WHdragon770/mulbot-corexy/corexy100/entrega/01 Montagem 3D/heroi2.png

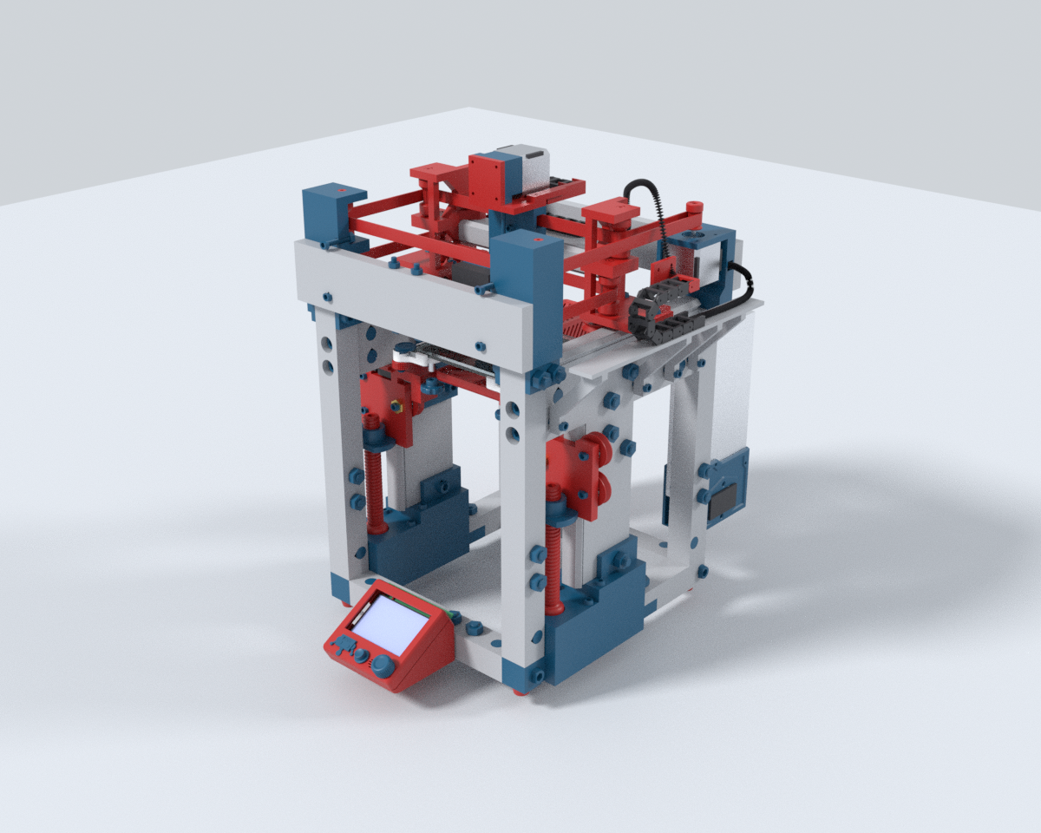
corexy100/entrega/01 Montagem 3D/heroi2.png
