WHdragon770/mulbot-corexy/corexy100/entrega/01 Montagem 3D/carro_rodas.png

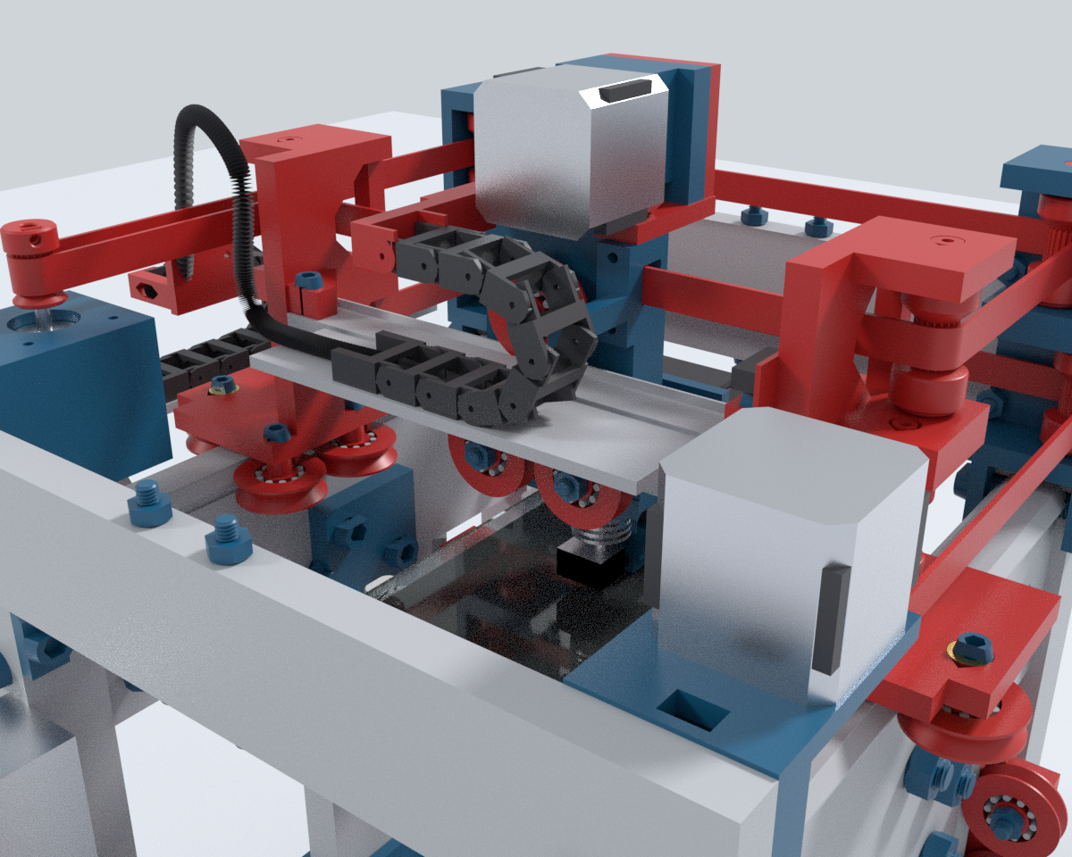
corexy100/entrega/01 Montagem 3D/carro_rodas.png
