WHdragon770/mulbot-corexy/corexy100/entrega/04 Detalhes (imagens)/100 x 200 lado a lado/1 perspectiva.png

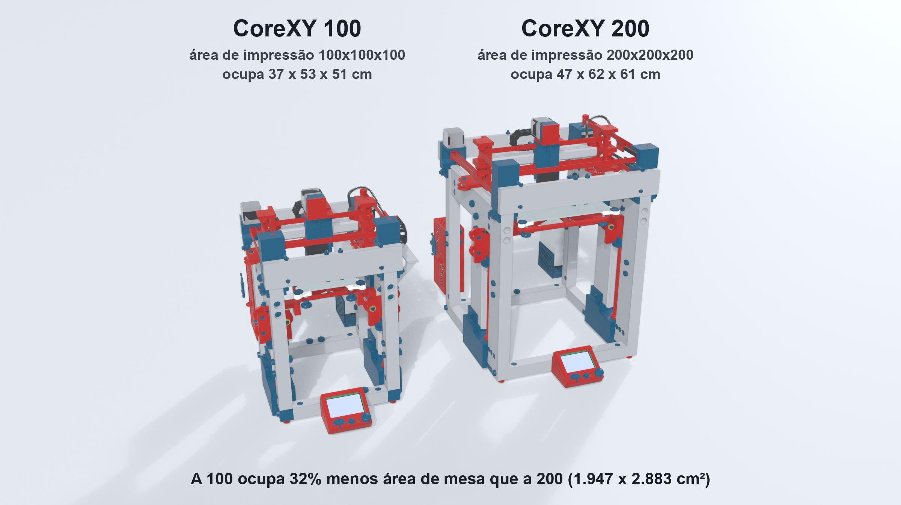
corexy100/entrega/04 Detalhes (imagens)/100 x 200 lado a lado/1 perspectiva.png
