WHdragon770/mulbot-corexy/corexy100/entrega/04 Detalhes (imagens)/Esteira porta-cabos/elo_por_cima.png

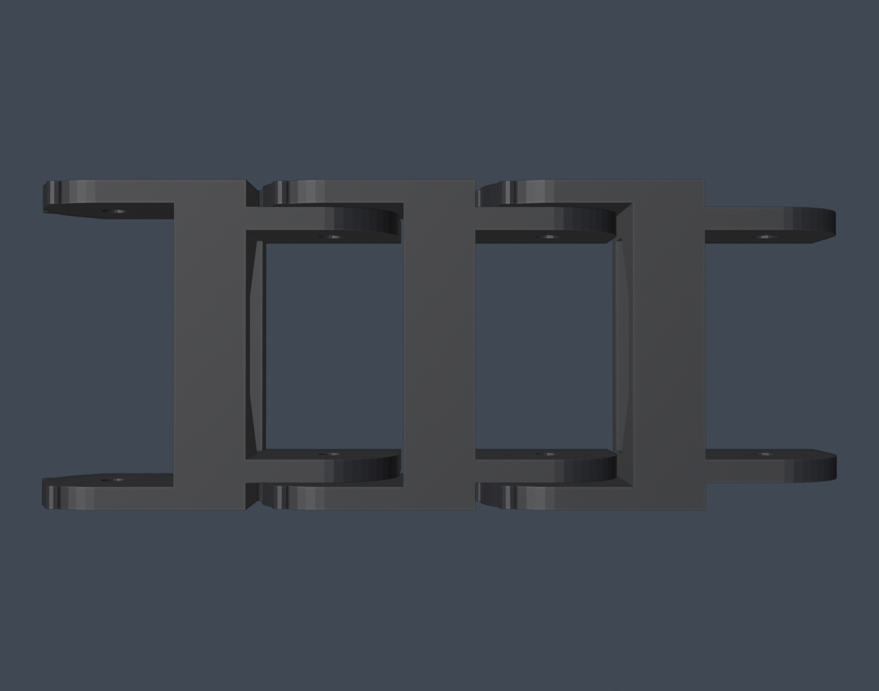
corexy100/entrega/04 Detalhes (imagens)/Esteira porta-cabos/elo_por_cima.png
