WHdragon770/mulbot-corexy/corexy100/entrega/04 Detalhes (imagens)/Esteira porta-cabos/esteira_X_de_cima.png

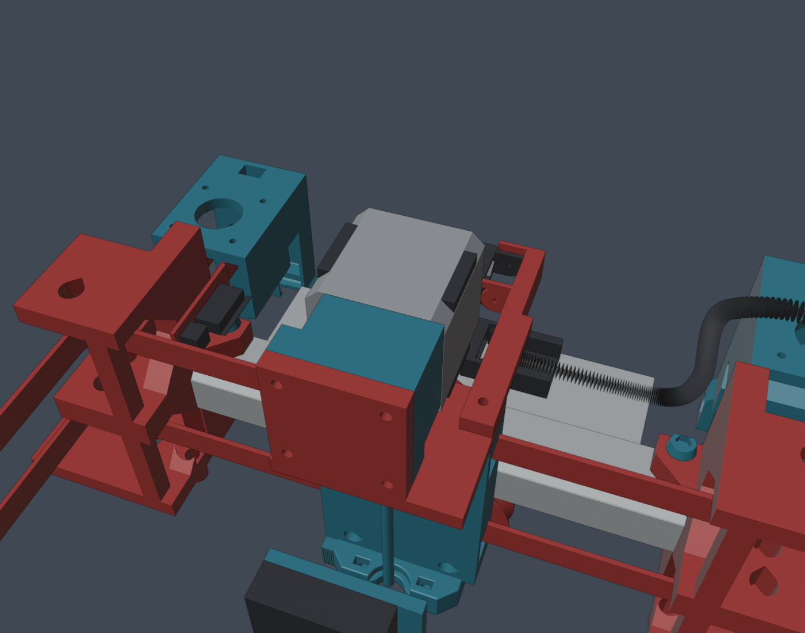
corexy100/entrega/04 Detalhes (imagens)/Esteira porta-cabos/esteira_X_de_cima.png
