WHdragon770/mulbot-corexy/corexy100/entrega/04 Detalhes (imagens)/Esteira porta-cabos/esteira_X_por_tras.png

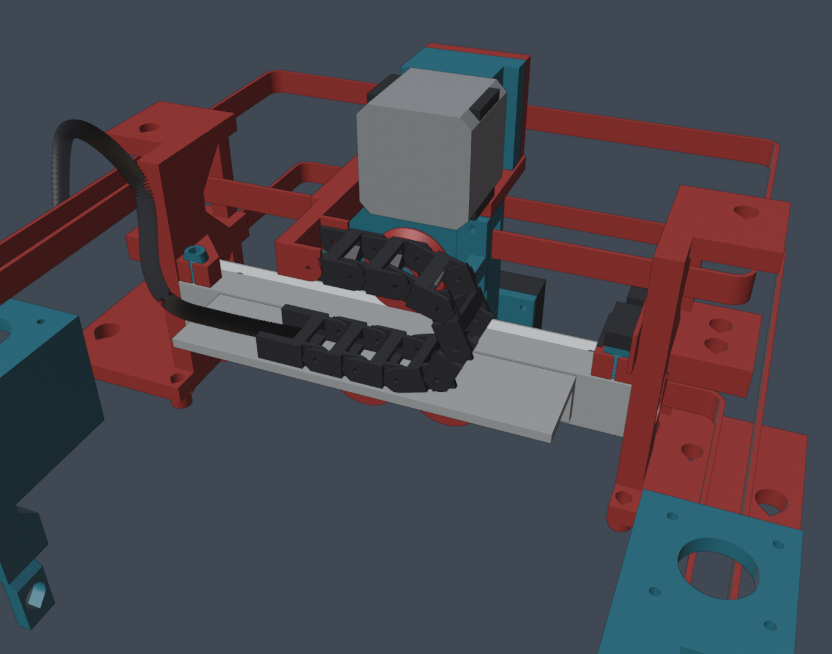
corexy100/entrega/04 Detalhes (imagens)/Esteira porta-cabos/esteira_X_por_tras.png
