WHdragon770/mulbot-corexy/corexy100/entrega/04 Detalhes (imagens)/Esteira porta-cabos/esteira_Y_por_fora.png

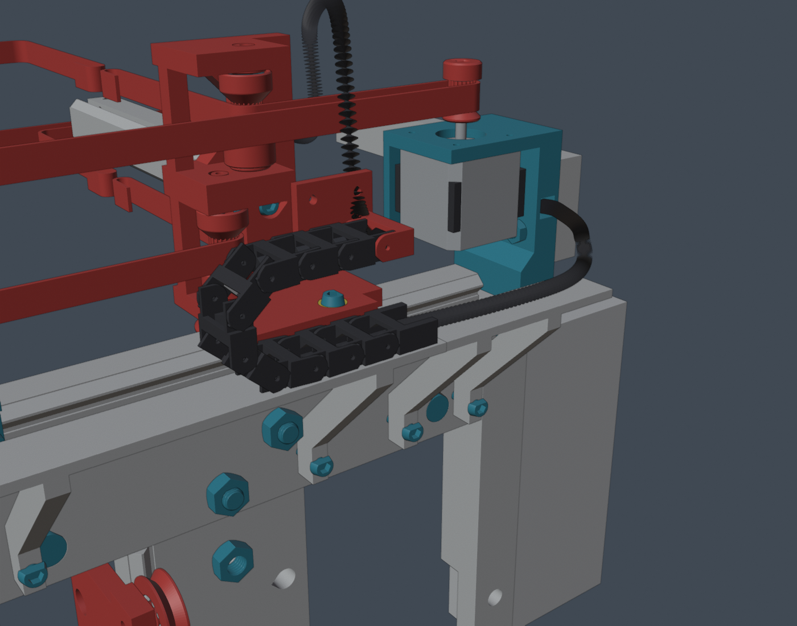
corexy100/entrega/04 Detalhes (imagens)/Esteira porta-cabos/esteira_Y_por_fora.png
