WHdragon770/mulbot-corexy/corexy100/entrega/04 Detalhes (imagens)/Esteira porta-cabos/visao_geral.png

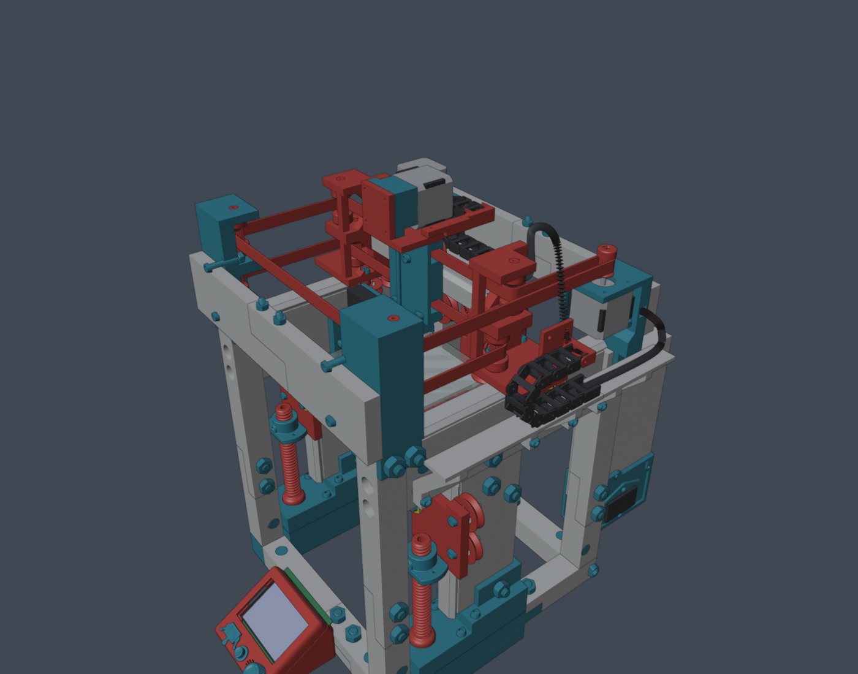
corexy100/entrega/04 Detalhes (imagens)/Esteira porta-cabos/visao_geral.png
