WHdragon770/mulbot-corexy/corexy100/entrega/04 Detalhes (imagens)/Extrusora direta/extrusora_direta_frente.png

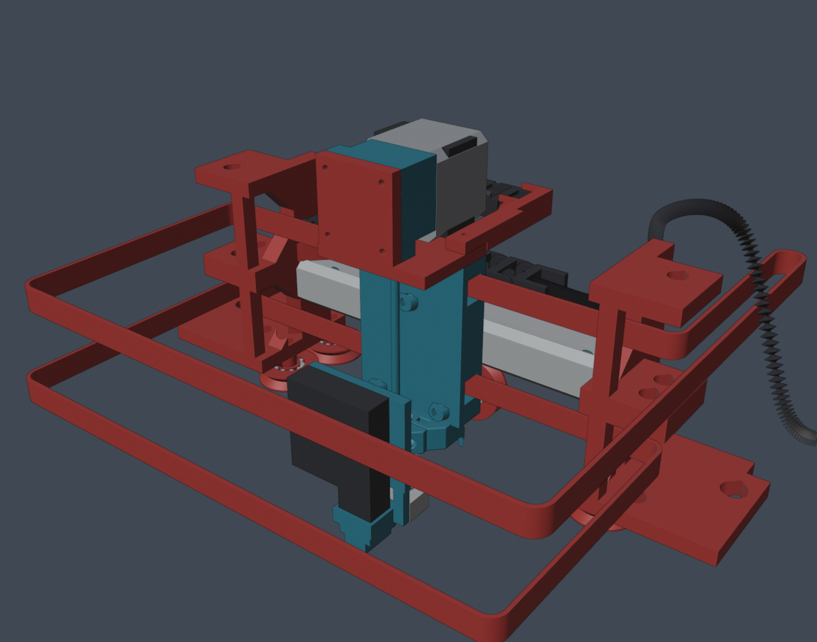
corexy100/entrega/04 Detalhes (imagens)/Extrusora direta/extrusora_direta_frente.png
