WHdragon770/mulbot-corexy/corexy100/entrega/04 Detalhes (imagens)/Extrusora direta/extrusora_direta_tras.png

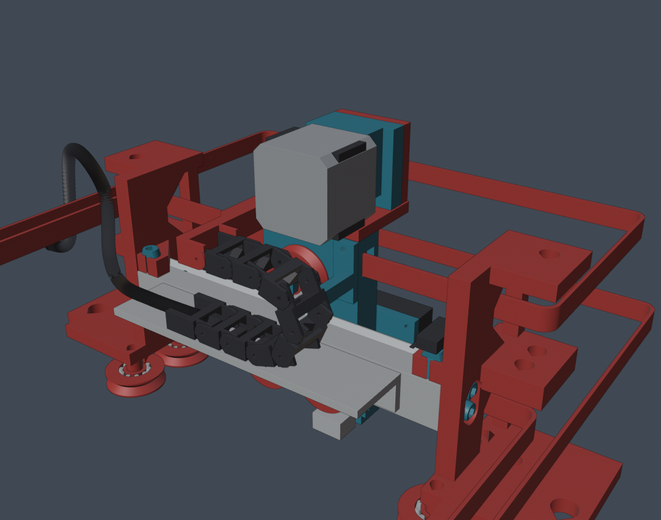
corexy100/entrega/04 Detalhes (imagens)/Extrusora direta/extrusora_direta_tras.png
