WHdragon770/mulbot-corexy/corexy100/entrega/04 Detalhes (imagens)/Passagem de cabos/canto.png

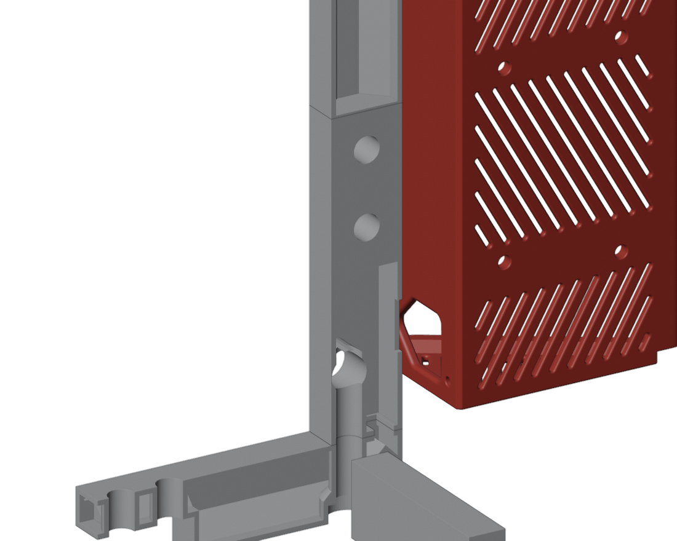
corexy100/entrega/04 Detalhes (imagens)/Passagem de cabos/canto.png
