WHdragon770/mulbot-corexy/corexy100/entrega/04 Detalhes (imagens)/Passagem de cabos/isoE.png

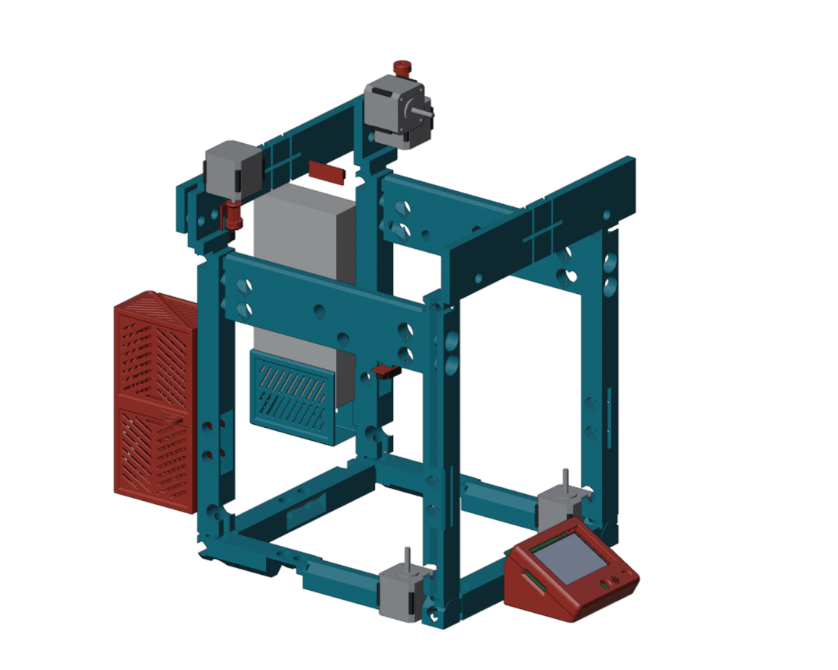
corexy100/entrega/04 Detalhes (imagens)/Passagem de cabos/isoE.png
