WHdragon770/mulbot-corexy/corexy100/entrega/04 Detalhes (imagens)/Presilha do vidro (botao excentrico)/iso.png

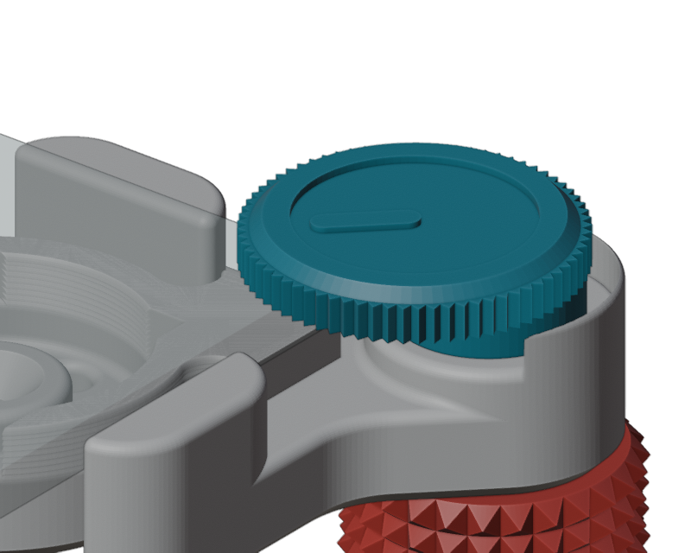
corexy100/entrega/04 Detalhes (imagens)/Presilha do vidro (botao excentrico)/iso.png
