WHdragon770/mulbot-corexy/corexy100/entrega/04 Detalhes (imagens)/Presilha do vidro (botao excentrico)/lado.png

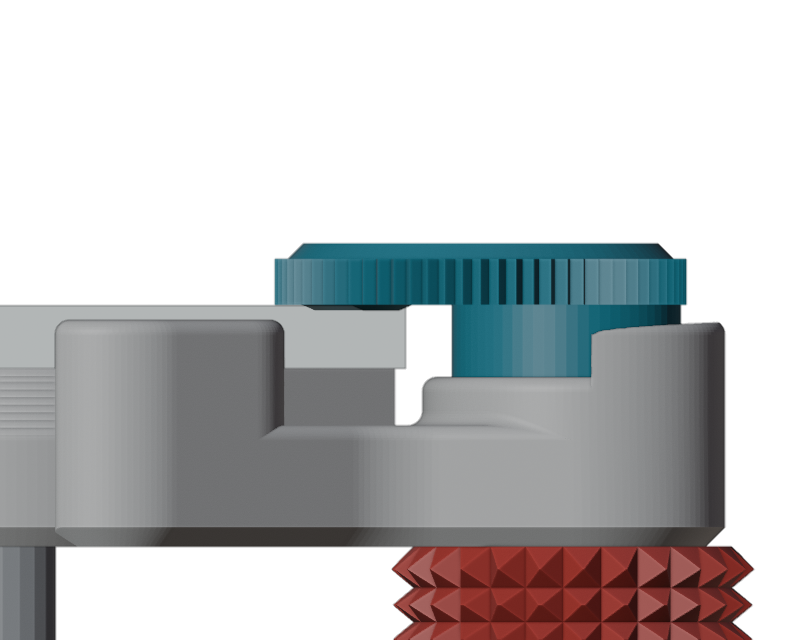
corexy100/entrega/04 Detalhes (imagens)/Presilha do vidro (botao excentrico)/lado.png
