WHdragon770/mulbot-corexy/corexy100/entrega/06 Placas de impressao/Previa das placas/01 Quadro - DL1-01-08 - TPU.png

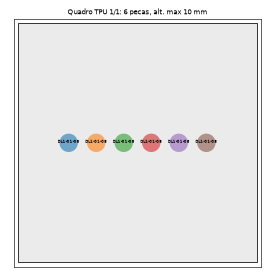
corexy100/entrega/06 Placas de impressao/Previa das placas/01 Quadro - DL1-01-08 - TPU.png
