WHdragon770/mulbot-corexy/corexy100/entrega/06 Placas de impressao/Previa das placas/01 Quadro - PLA.png

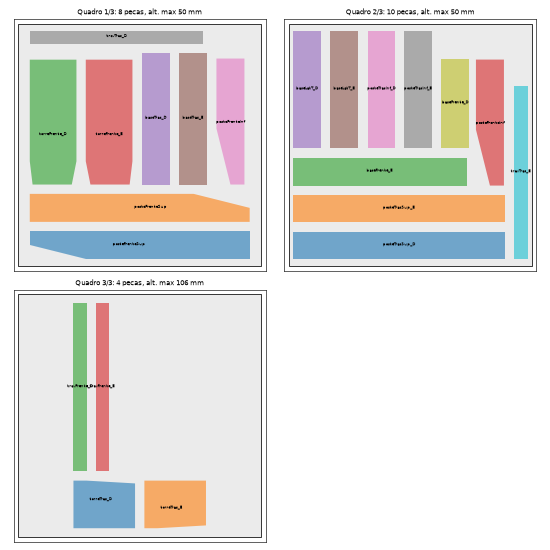
corexy100/entrega/06 Placas de impressao/Previa das placas/01 Quadro - PLA.png
