WHdragon770/mulbot-corexy/corexy100/entrega/06 Placas de impressao/Previa das placas/02 Eixo Y e portico - PLA.png

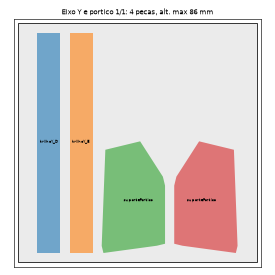
corexy100/entrega/06 Placas de impressao/Previa das placas/02 Eixo Y e portico - PLA.png
