WHdragon770/mulbot-corexy/corexy100/entrega/06 Placas de impressao/Previa das placas/03 Eixo X e cabeca - PLA.png

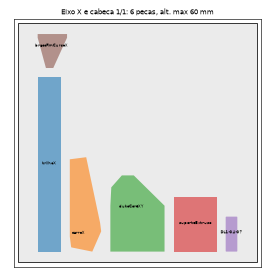
corexy100/entrega/06 Placas de impressao/Previa das placas/03 Eixo X e cabeca - PLA.png
