WHdragon770/mulbot-corexy/corexy100/entrega/06 Placas de impressao/Previa das placas/04 Eixo Z e mesa - PLA.png

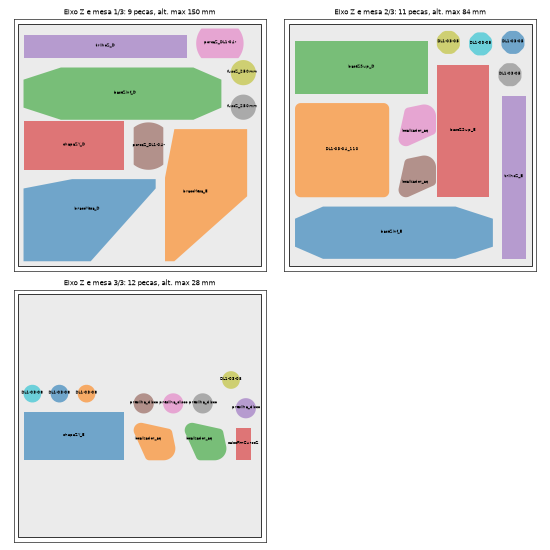
corexy100/entrega/06 Placas de impressao/Previa das placas/04 Eixo Z e mesa - PLA.png
