WHdragon770/mulbot-corexy/corexy100/entrega/06 Placas de impressao/Previa das placas/05 Motores e polias - DL1-04-08 - PETG.png

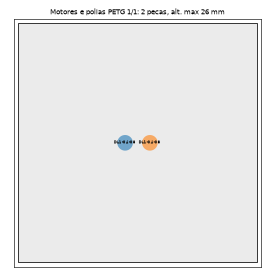
corexy100/entrega/06 Placas de impressao/Previa das placas/05 Motores e polias - DL1-04-08 - PETG.png
