WHdragon770/mulbot-corexy/corexy100/entrega/06 Placas de impressao/Previa das placas/06 Eletronica e display - PLA.png

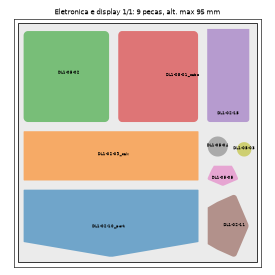
corexy100/entrega/06 Placas de impressao/Previa das placas/06 Eletronica e display - PLA.png
