WHdragon770/mulbot-corexy/corexy100/entrega/06 Placas de impressao/Previa das placas/08 Parafusos e porcas impressos - PLA.png

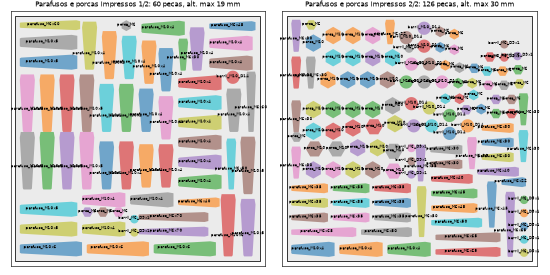
corexy100/entrega/06 Placas de impressao/Previa das placas/08 Parafusos e porcas impressos - PLA.png
