WHdragon770/mulbot-corexy/corexy100/entrega/06 Placas de impressao/Previa das placas/09 Esteira porta-cabos - elo_esteira - PETG.png

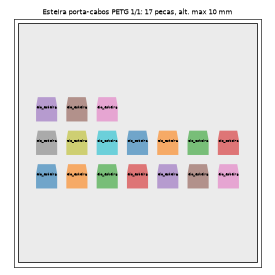
corexy100/entrega/06 Placas de impressao/Previa das placas/09 Esteira porta-cabos - elo_esteira - PETG.png
