WHdragon770/mulbot-corexy/corexy100/guia_v/render/1_montado.png

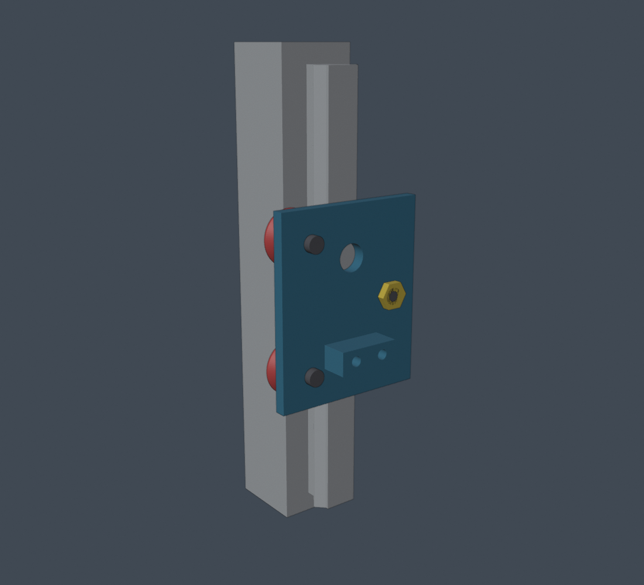
corexy100/guia_v/render/1_montado.png
