WHdragon770/mulbot-corexy/corexy100/guia_v/render/2_atras.png

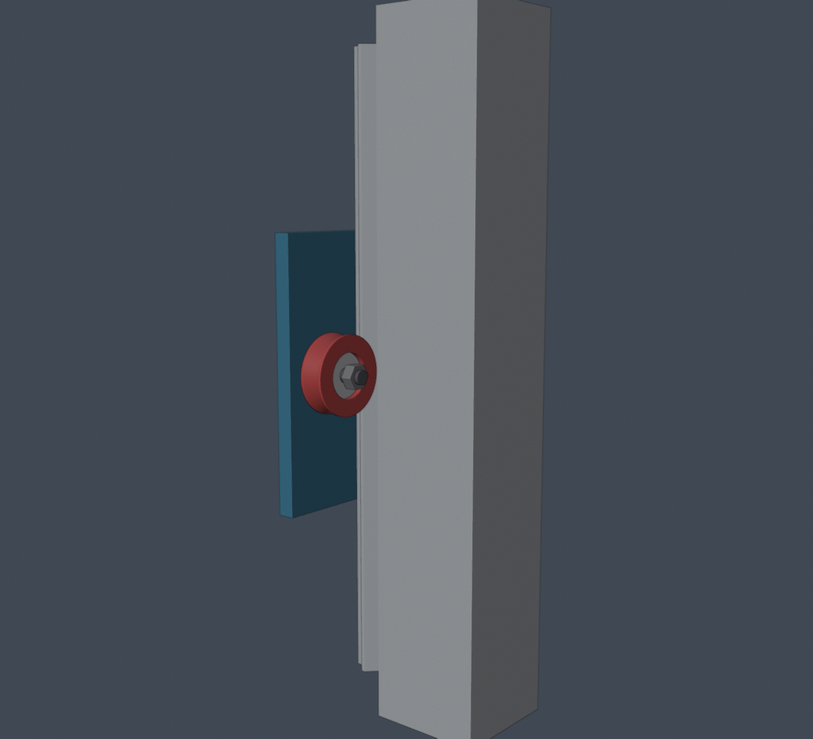
corexy100/guia_v/render/2_atras.png
