WHdragon770/mulbot-corexy/corexy100/guia_v/render/3_explodido.png

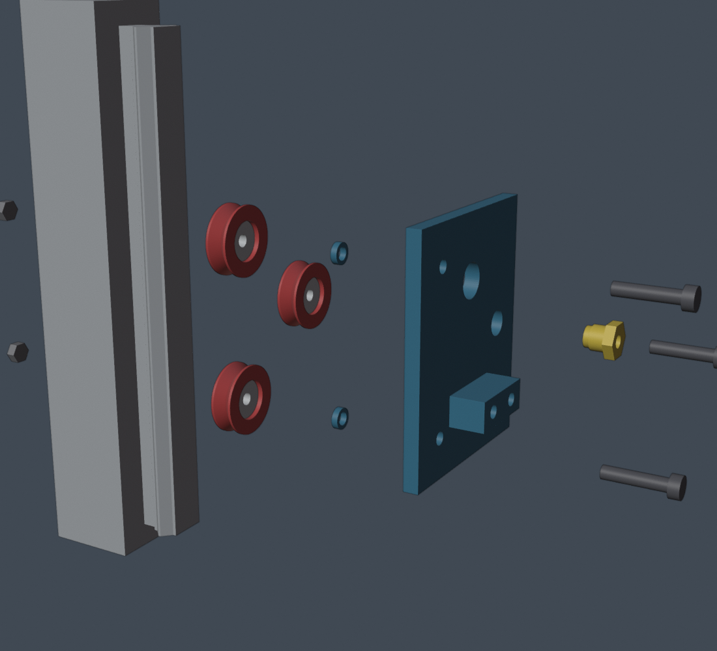
corexy100/guia_v/render/3_explodido.png
