WHdragon770/mulbot-corexy/corexy100/guia_v/render/4_corte_topo.png

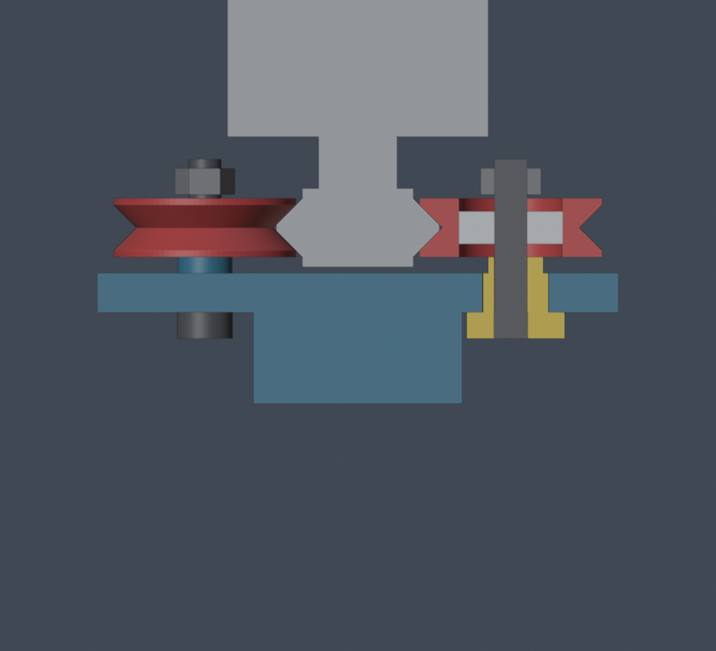
corexy100/guia_v/render/4_corte_topo.png
