WHdragon770/mulbot-corexy/corexy100/guia_v/render/5_sem_placa.png

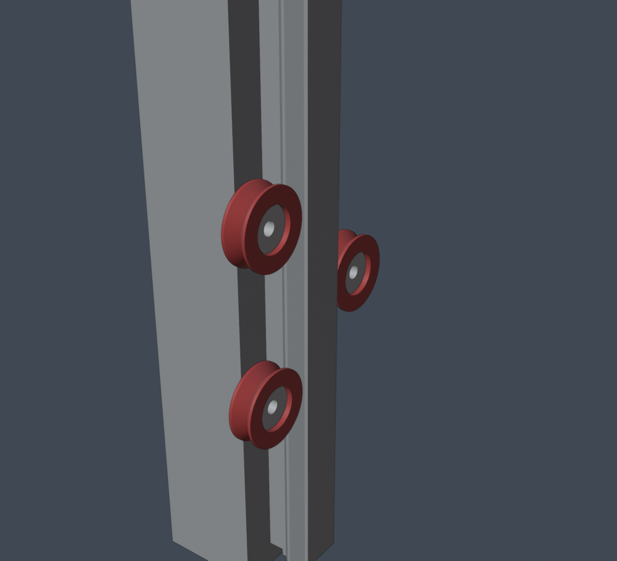
corexy100/guia_v/render/5_sem_placa.png
