WHdragon770/mulbot-corexy/corexy100/guia_v/render/guia_v_painel_pequeno.png

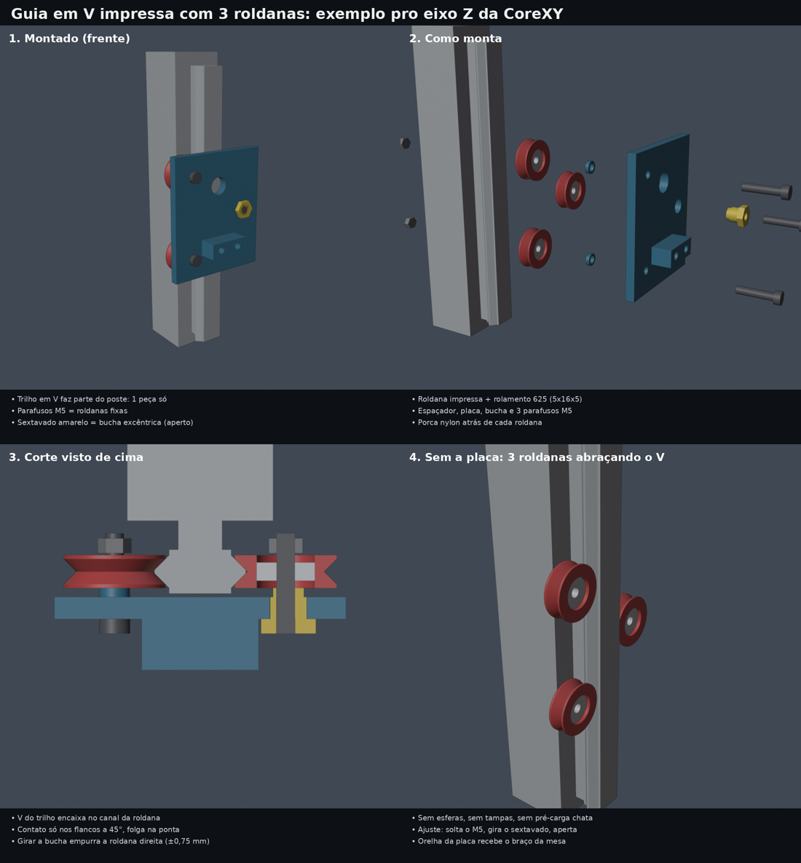
corexy100/guia_v/render/guia_v_painel_pequeno.png
