WHdragon770/mulbot-corexy/corexy100/ref/carro_frente.png

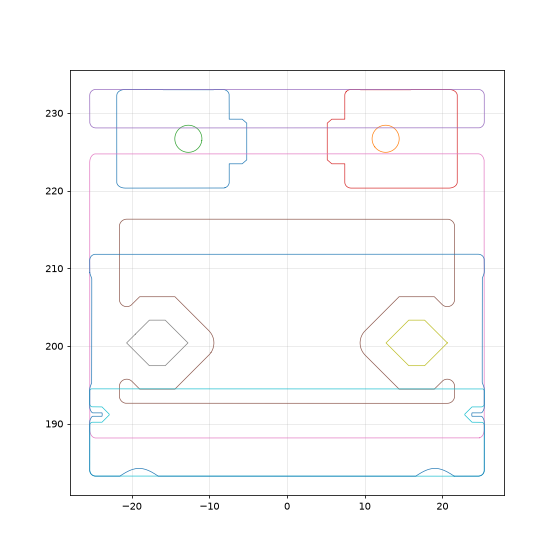
corexy100/ref/carro_frente.png
