WHdragon770/mulbot-corexy/corexy100/ref/carro_topo.png

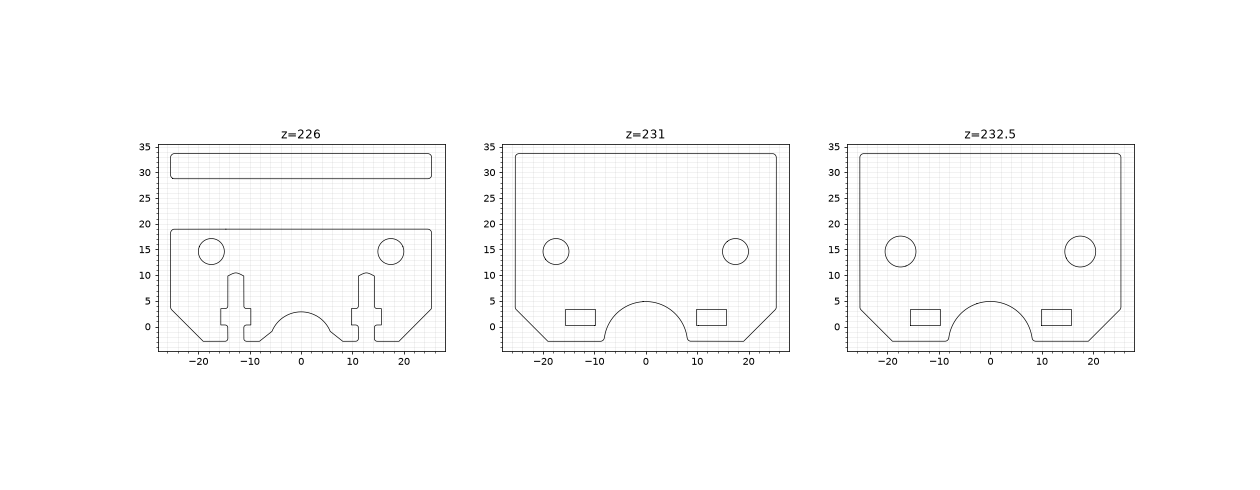
corexy100/ref/carro_topo.png
