WHdragon770/mulbot-corexy/corexy100/ref/chave.png

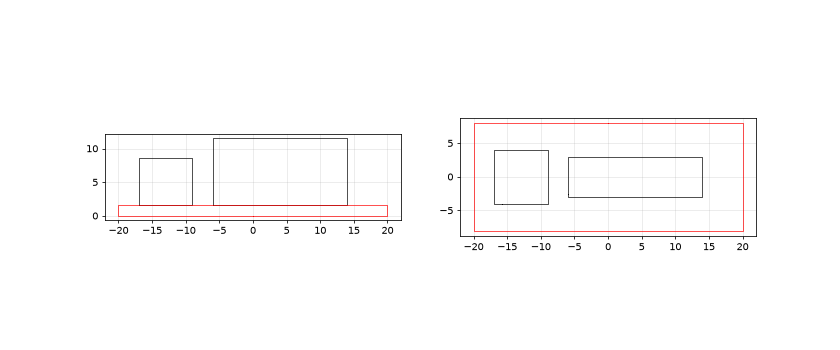
corexy100/ref/chave.png
