WHdragon770/mulbot-corexy/corexy100/ref/fan.png

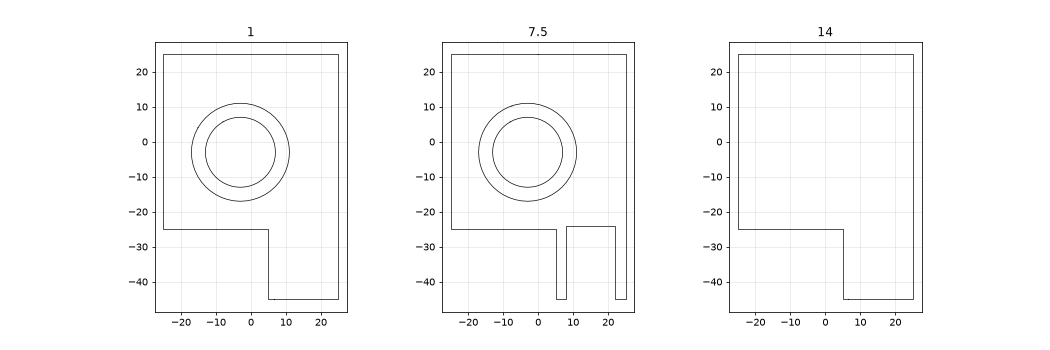
corexy100/ref/fan.png
