WHdragon770/mulbot-corexy/corexy100/ref/perfis.png

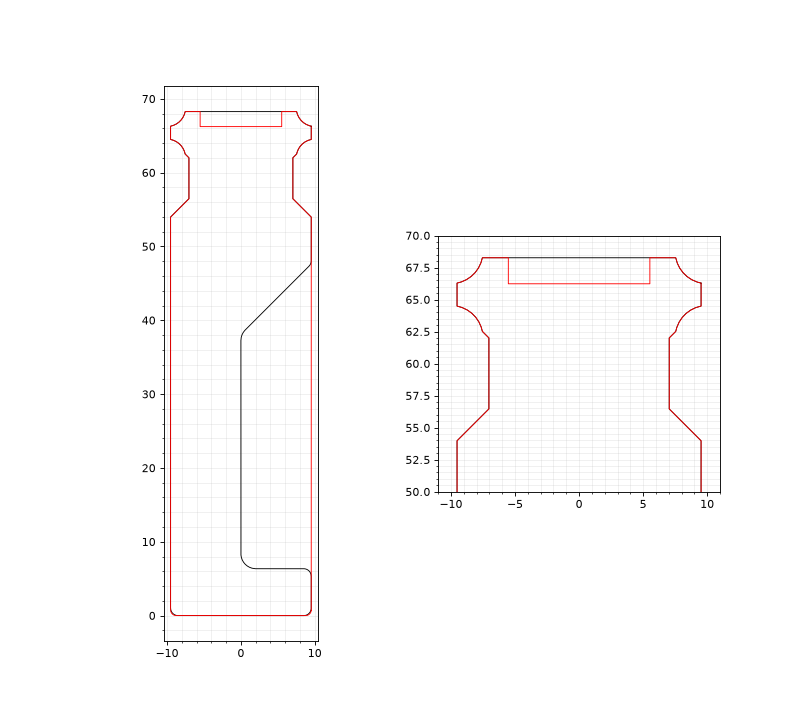
corexy100/ref/perfis.png
