WHdragon770/mulbot-corexy/corexy100/ref/polias.png

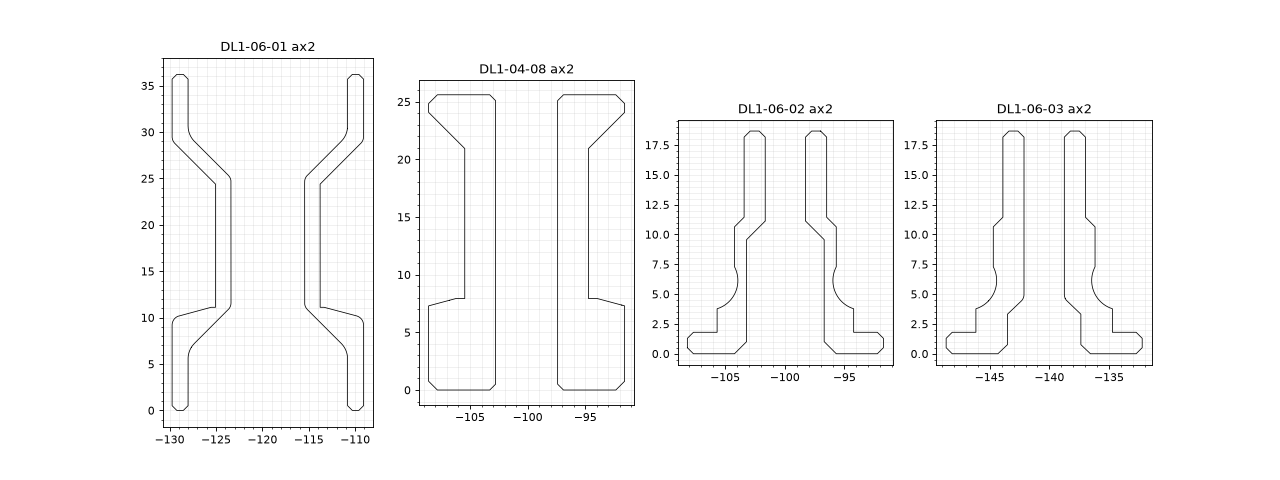
corexy100/ref/polias.png
