WHdragon770/mulbot-corexy/corexy100/ref/rail_sec.png

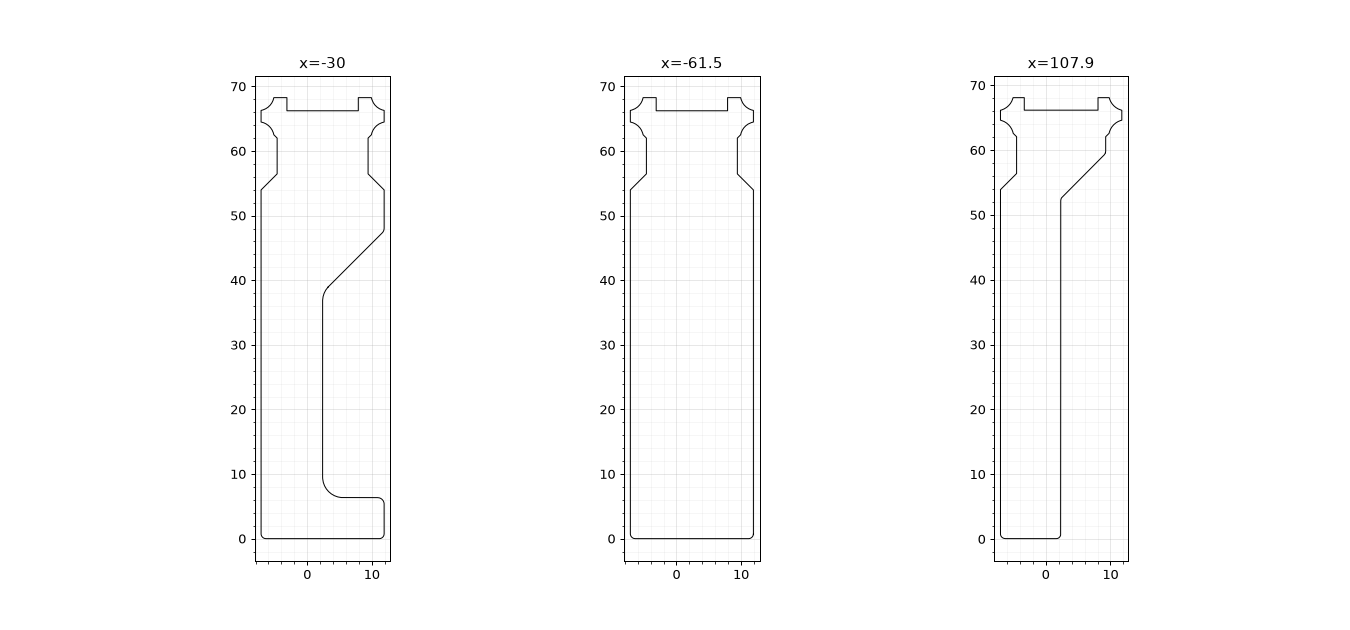
corexy100/ref/rail_sec.png
