WHdragon770/mulbot-corexy/corexy100/ref/yrail_car.png

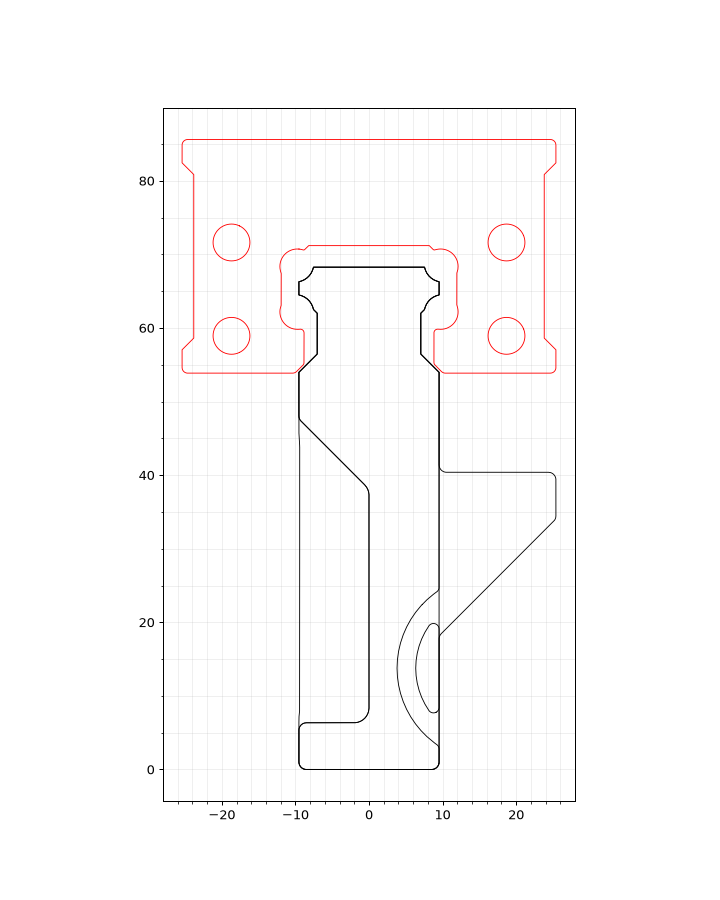
corexy100/ref/yrail_car.png
