WHdragon770/mulbot-corexy/corexy100/trab/detalhes/guia_v/carroX_frente.png

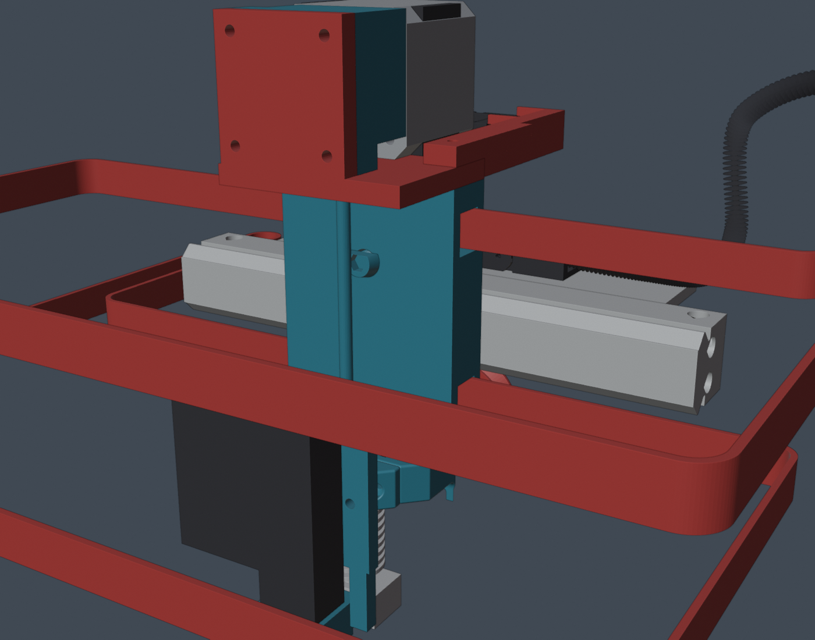
corexy100/trab/detalhes/guia_v/carroX_frente.png
