WHdragon770/mulbot-corexy/corexy100/trab/detalhes/guia_v/carroX_tras.png

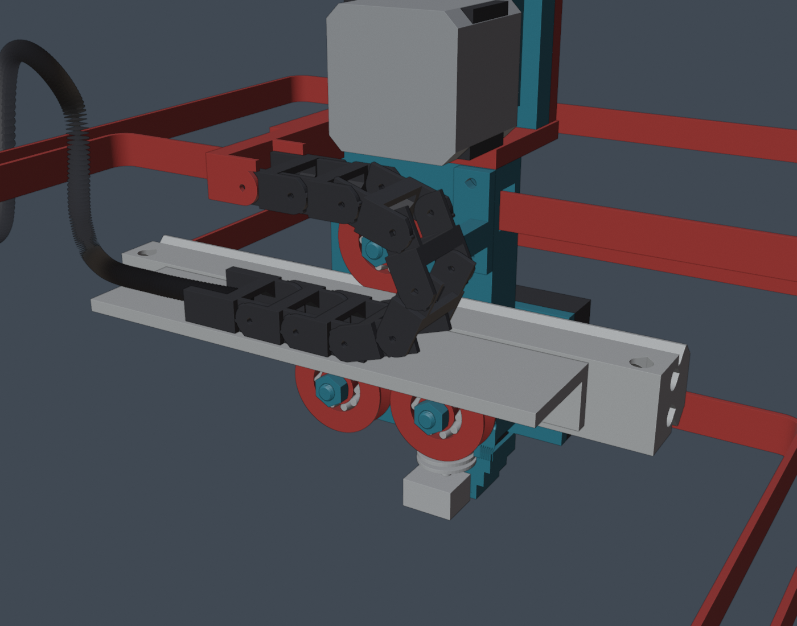
corexy100/trab/detalhes/guia_v/carroX_tras.png
