WHdragon770/mulbot-corexy/corexy100/trab/detalhes/guia_v/carroY_dentro.png

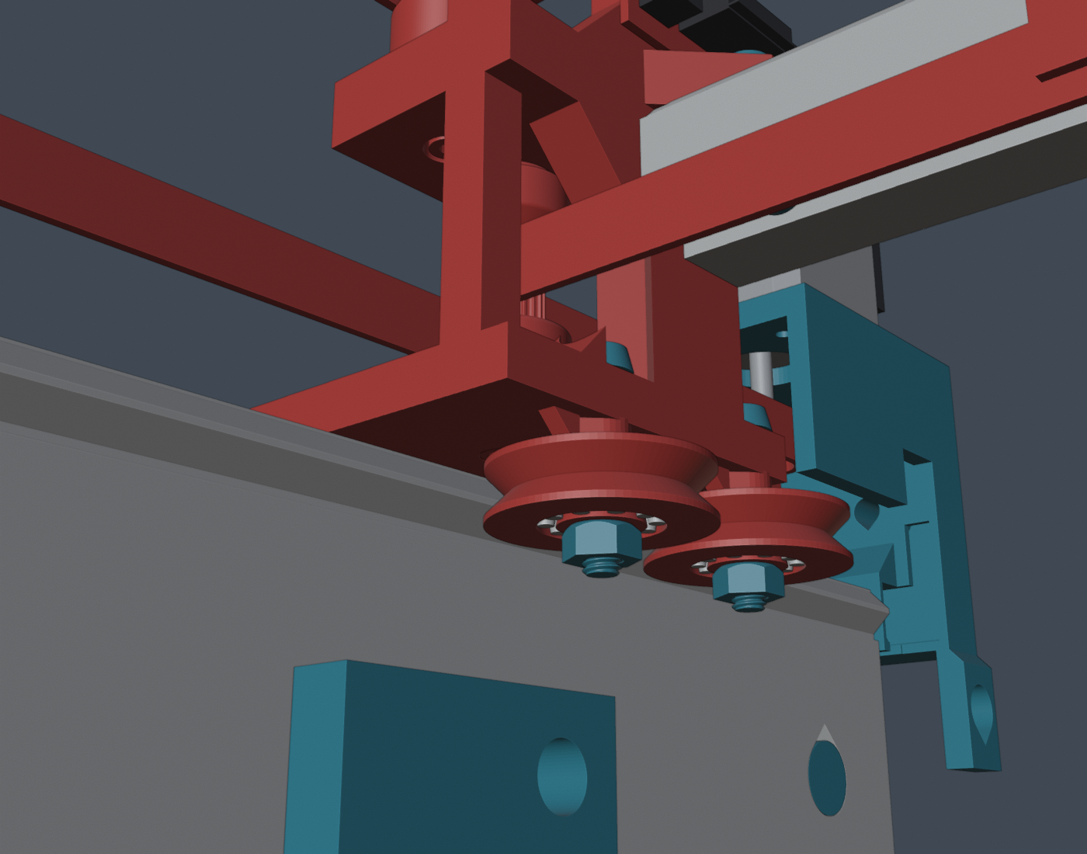
corexy100/trab/detalhes/guia_v/carroY_dentro.png
