WHdragon770/mulbot-corexy/corexy100/trab/detalhes/guia_v/carroY_fora.png

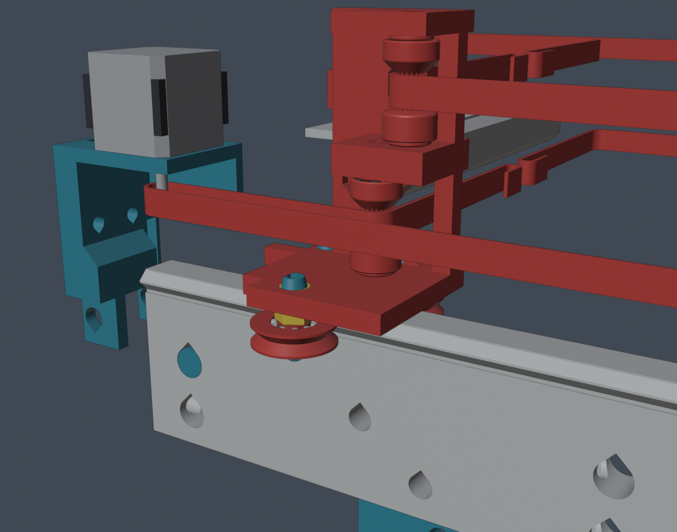
corexy100/trab/detalhes/guia_v/carroY_fora.png
