WHdragon770/mulbot-corexy/corexy100/trab/detalhes/guia_v/eixoZ_dentro.png

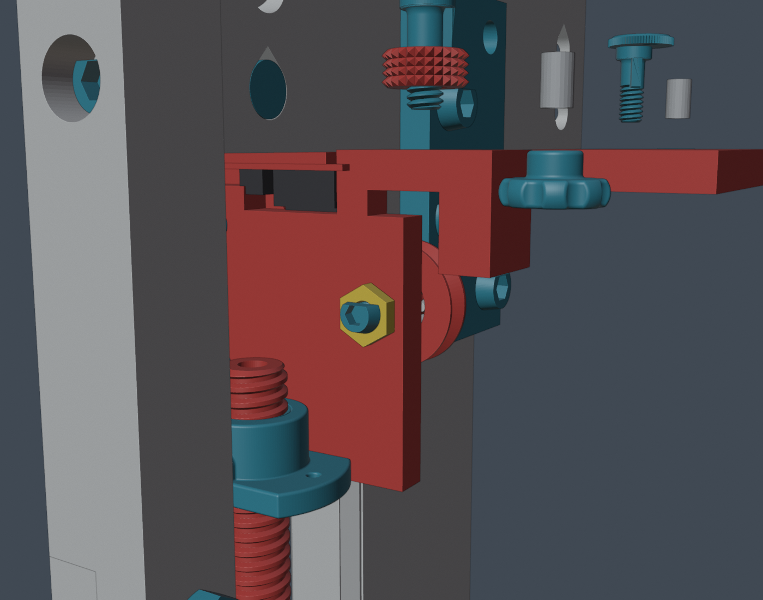
corexy100/trab/detalhes/guia_v/eixoZ_dentro.png
