WHdragon770/mulbot-corexy/corexy100/trab/detalhes/guia_v/eixoZ_frente.png

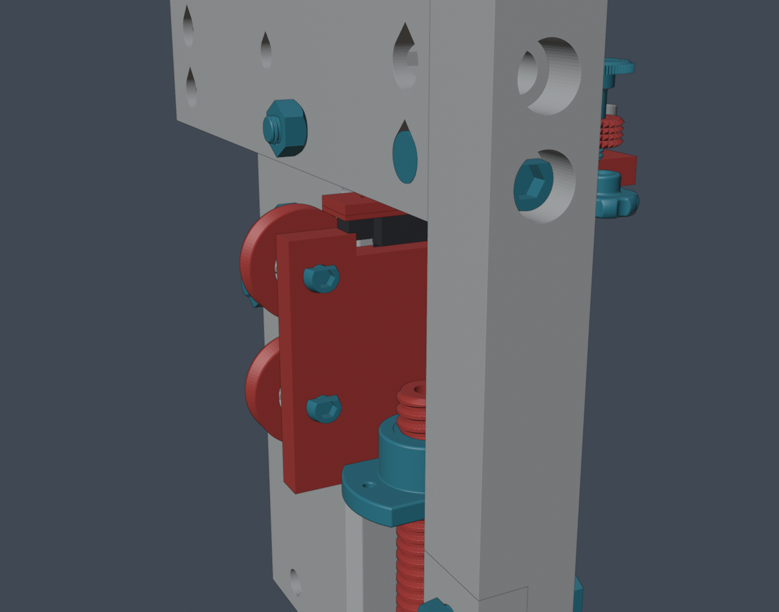
corexy100/trab/detalhes/guia_v/eixoZ_frente.png
