WHdragon770/mulbot-corexy/entrega/03b Desenhos de emenda (impressa na 100)/EM-00 - Capa e indice.png

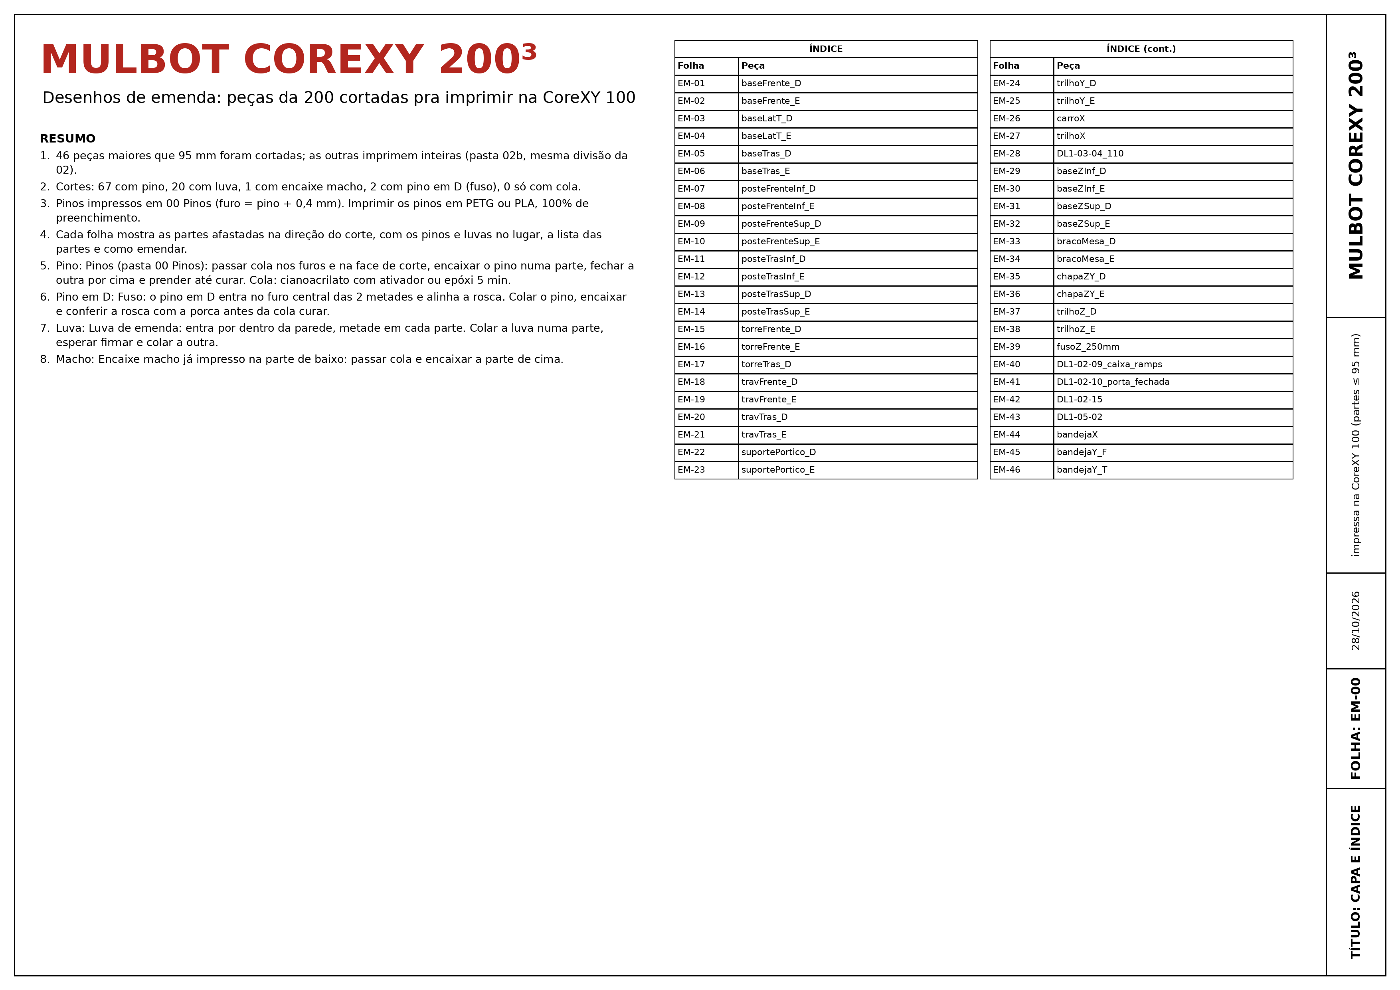
entrega/03b Desenhos de emenda (impressa na 100)/EM-00 - Capa e indice.png
