WHdragon770/mulbot-corexy/entrega/03b Desenhos de emenda (impressa na 100)/EM-18 - travFrente_D.png

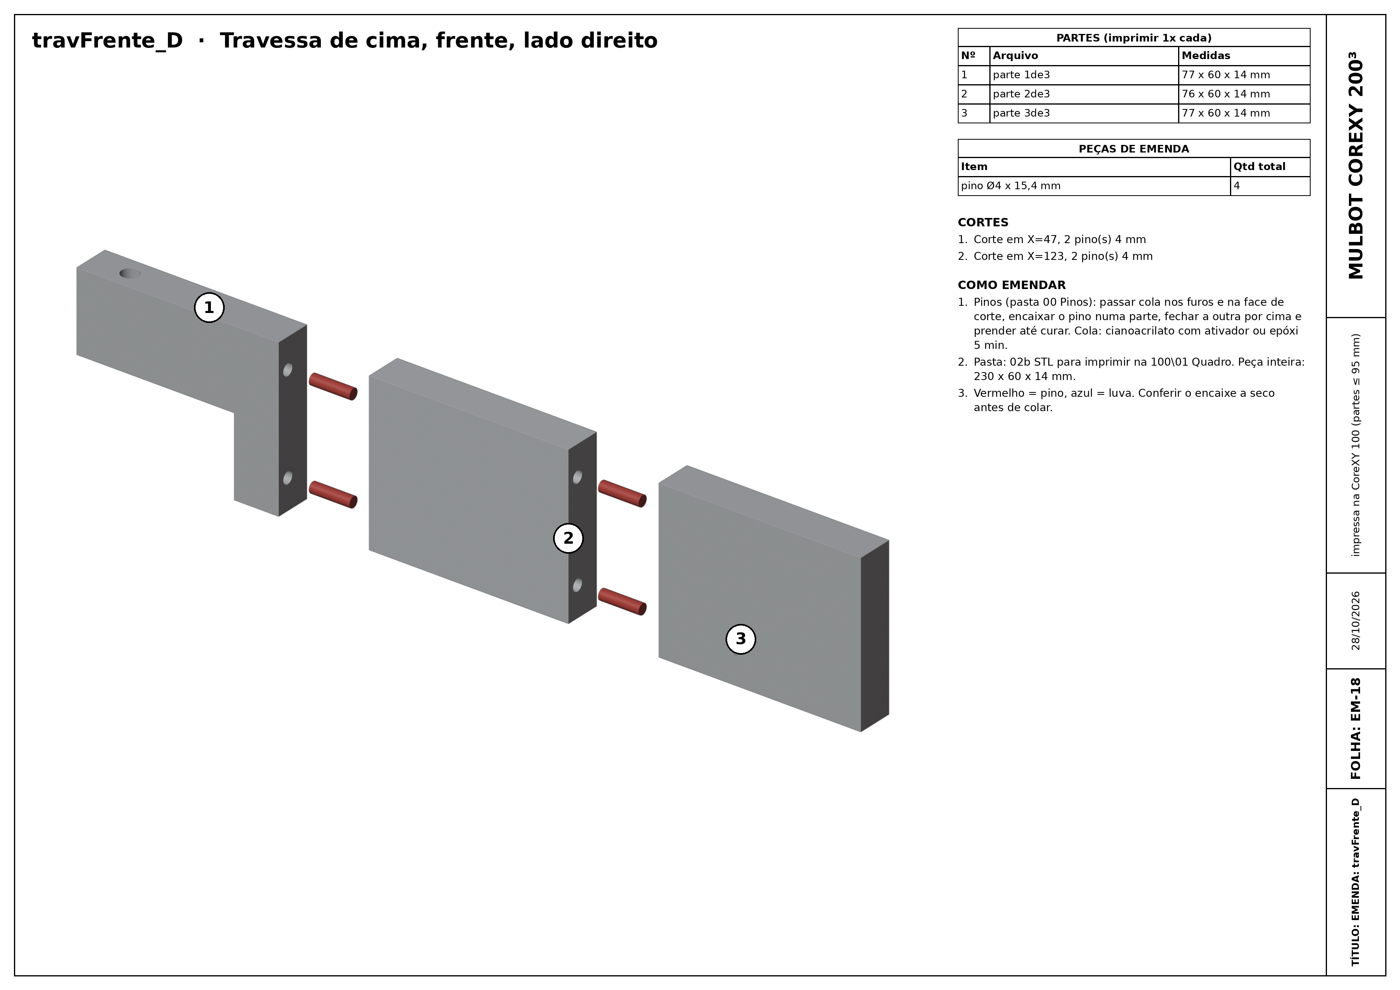
entrega/03b Desenhos de emenda (impressa na 100)/EM-18 - travFrente_D.png
