WHdragon770/mulbot-corexy/entrega/03b Desenhos de emenda (impressa na 100)/EM-22 - suportePortico_D.png

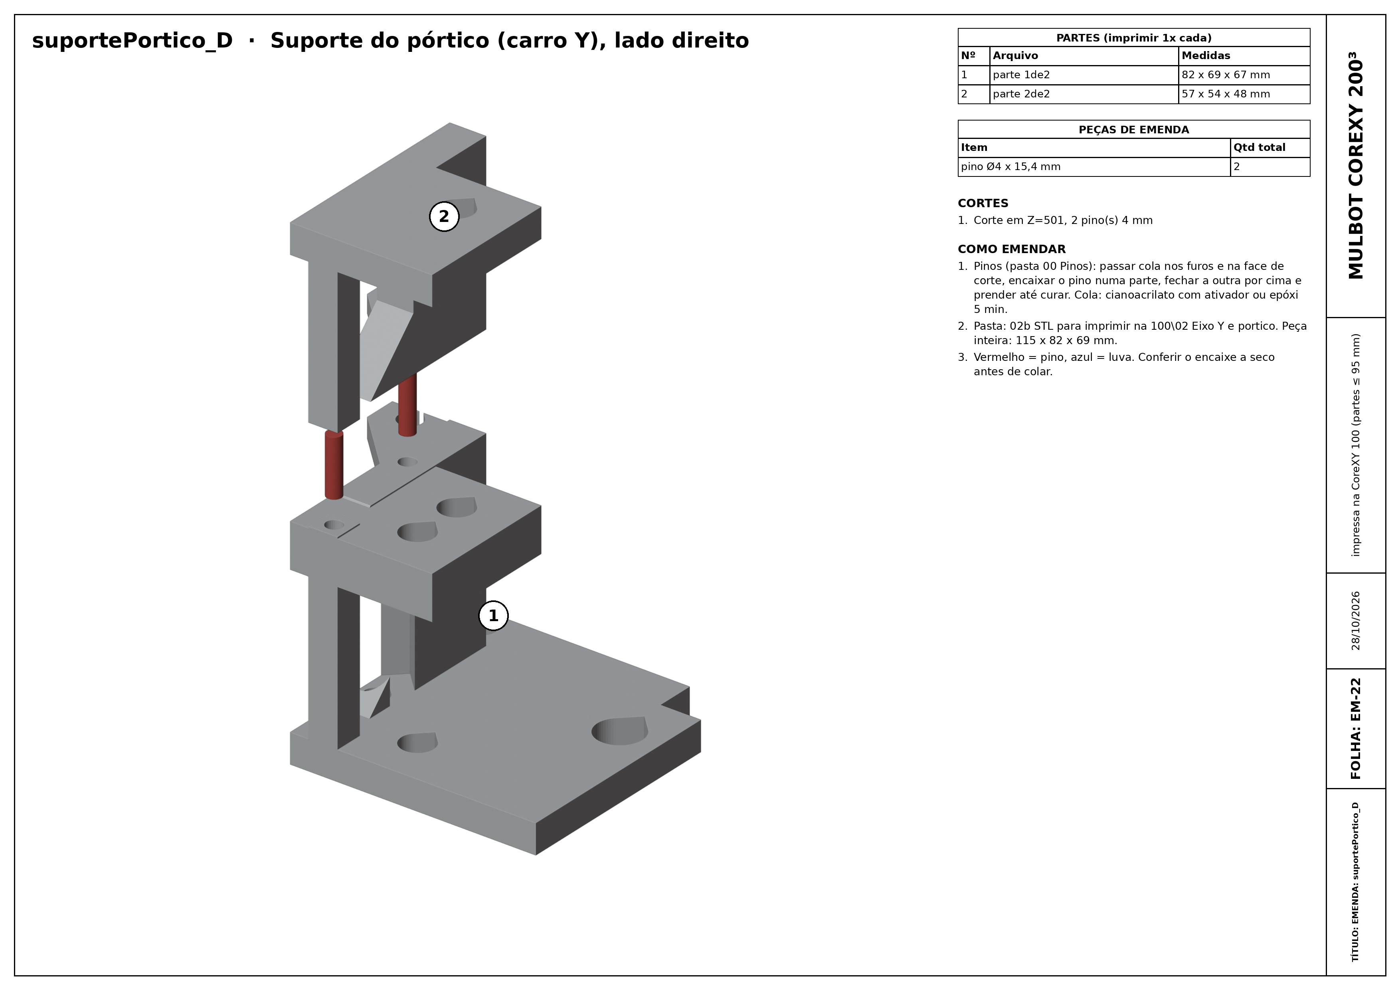
entrega/03b Desenhos de emenda (impressa na 100)/EM-22 - suportePortico_D.png
