WHdragon770/mulbot-corexy/entrega/03b Desenhos de emenda (impressa na 100)/EM-23 - suportePortico_E.png

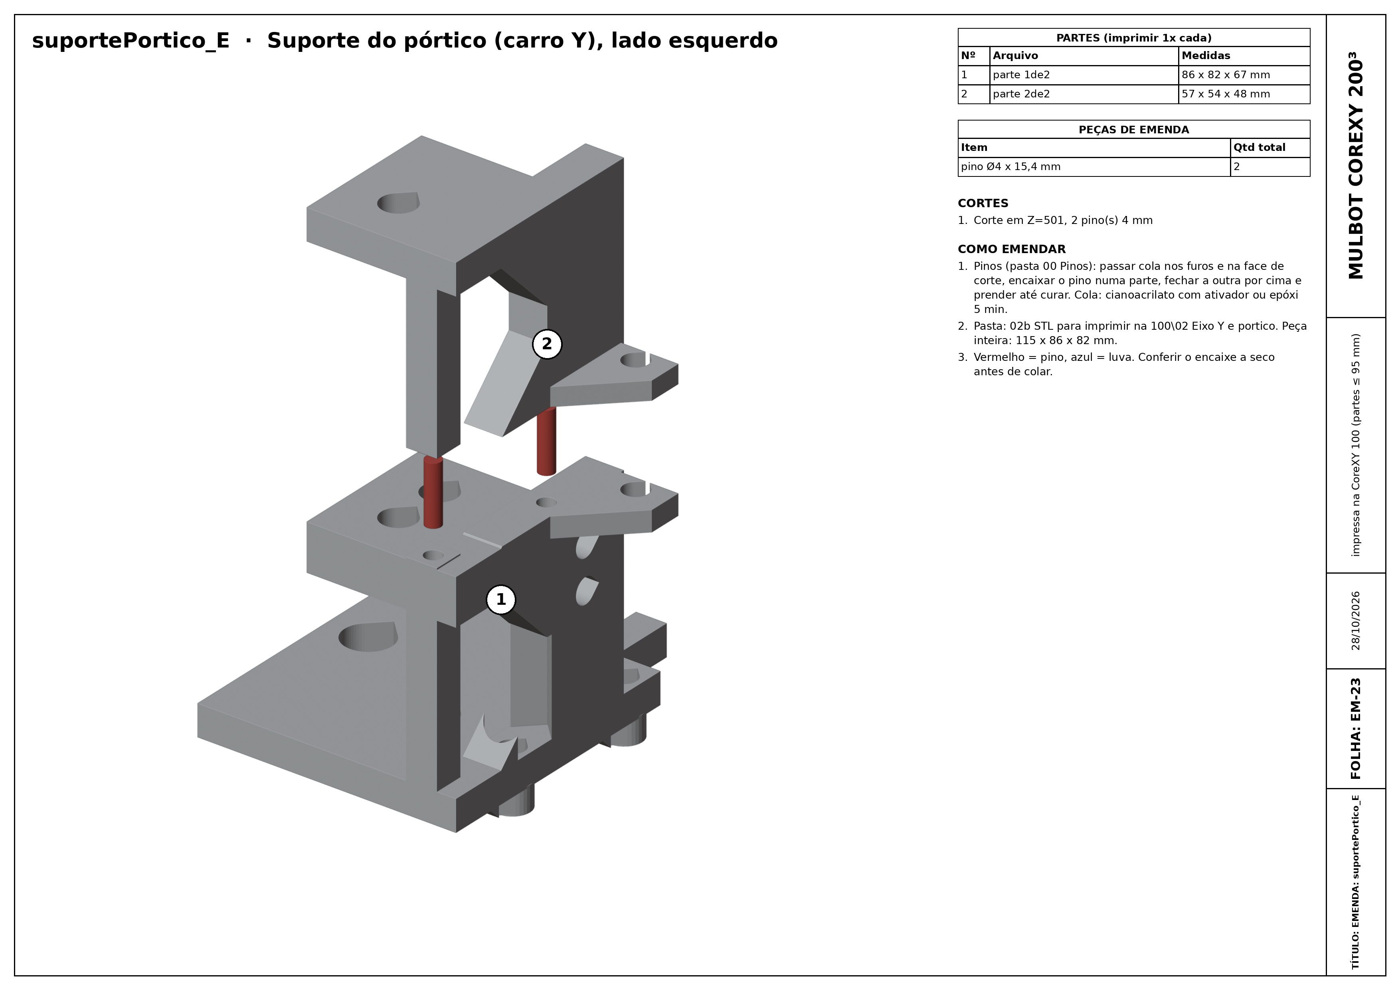
entrega/03b Desenhos de emenda (impressa na 100)/EM-23 - suportePortico_E.png
