WHdragon770/mulbot-corexy/entrega/03b Desenhos de emenda (impressa na 100)/EM-26 - carroX.png

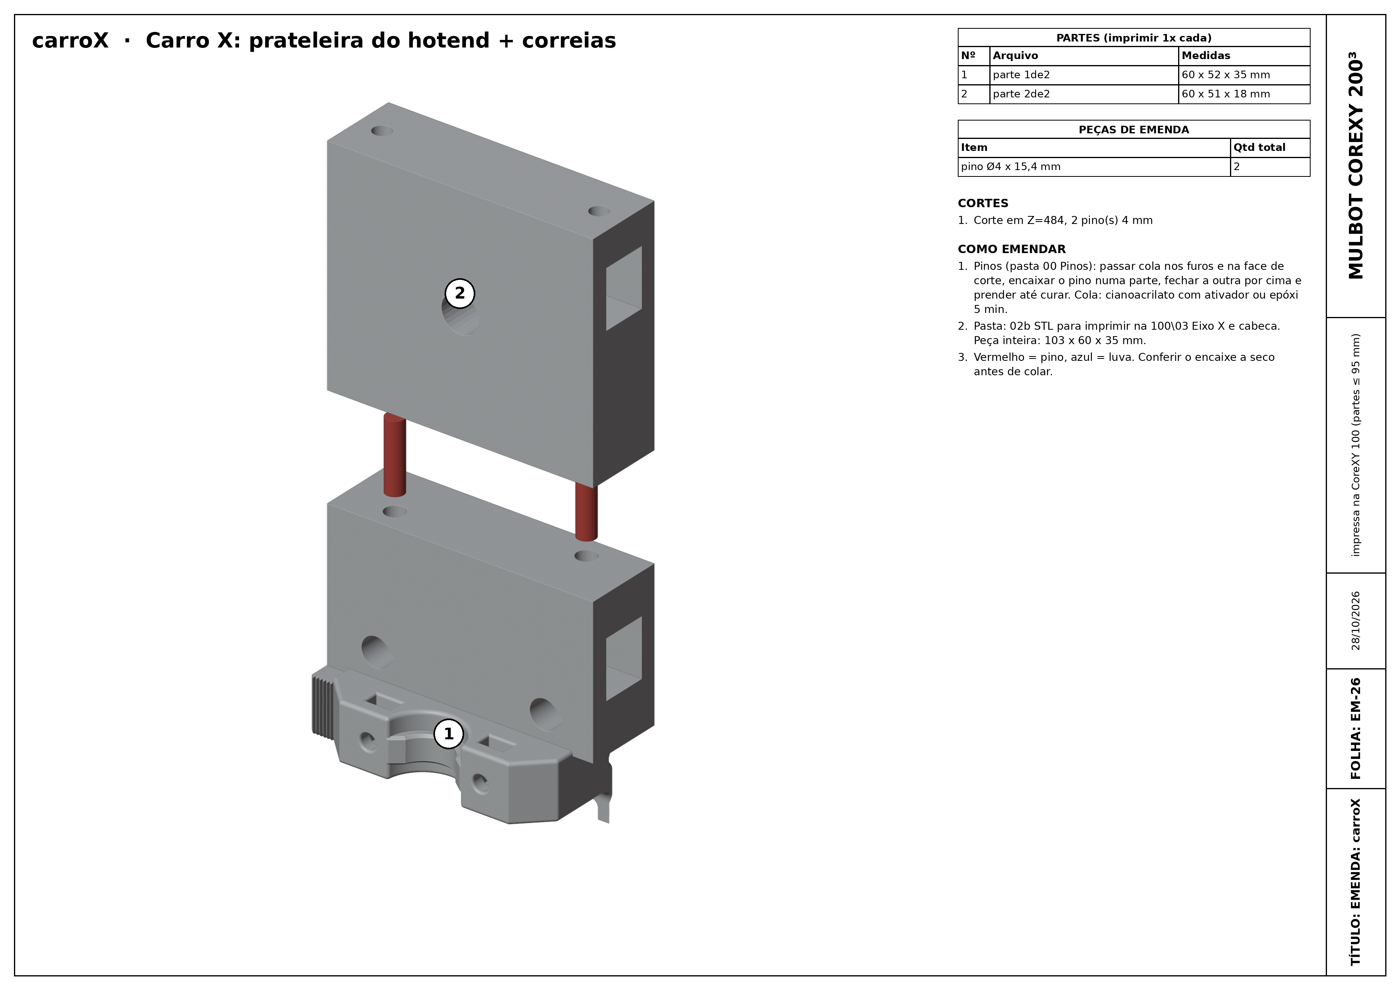
entrega/03b Desenhos de emenda (impressa na 100)/EM-26 - carroX.png
