WHdragon770/mulbot-corexy/entrega/03b Desenhos de emenda (impressa na 100)/EM-28 - DL1-03-04_110.png

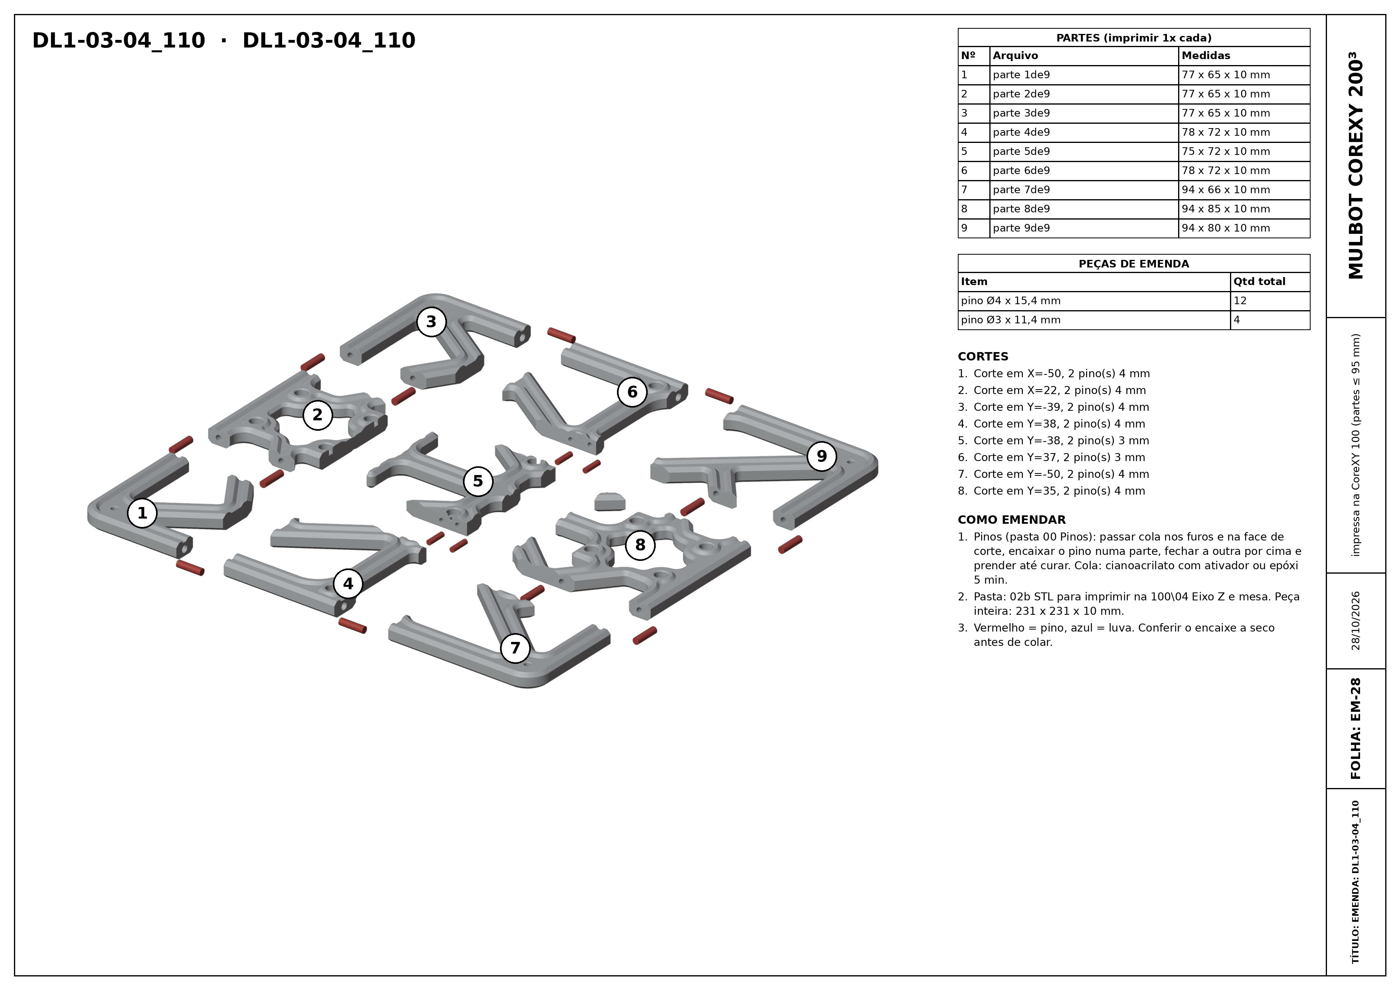
entrega/03b Desenhos de emenda (impressa na 100)/EM-28 - DL1-03-04_110.png
