WHdragon770/mulbot-corexy/entrega/03b Desenhos de emenda (impressa na 100)/EM-33 - bracoMesa_D.png

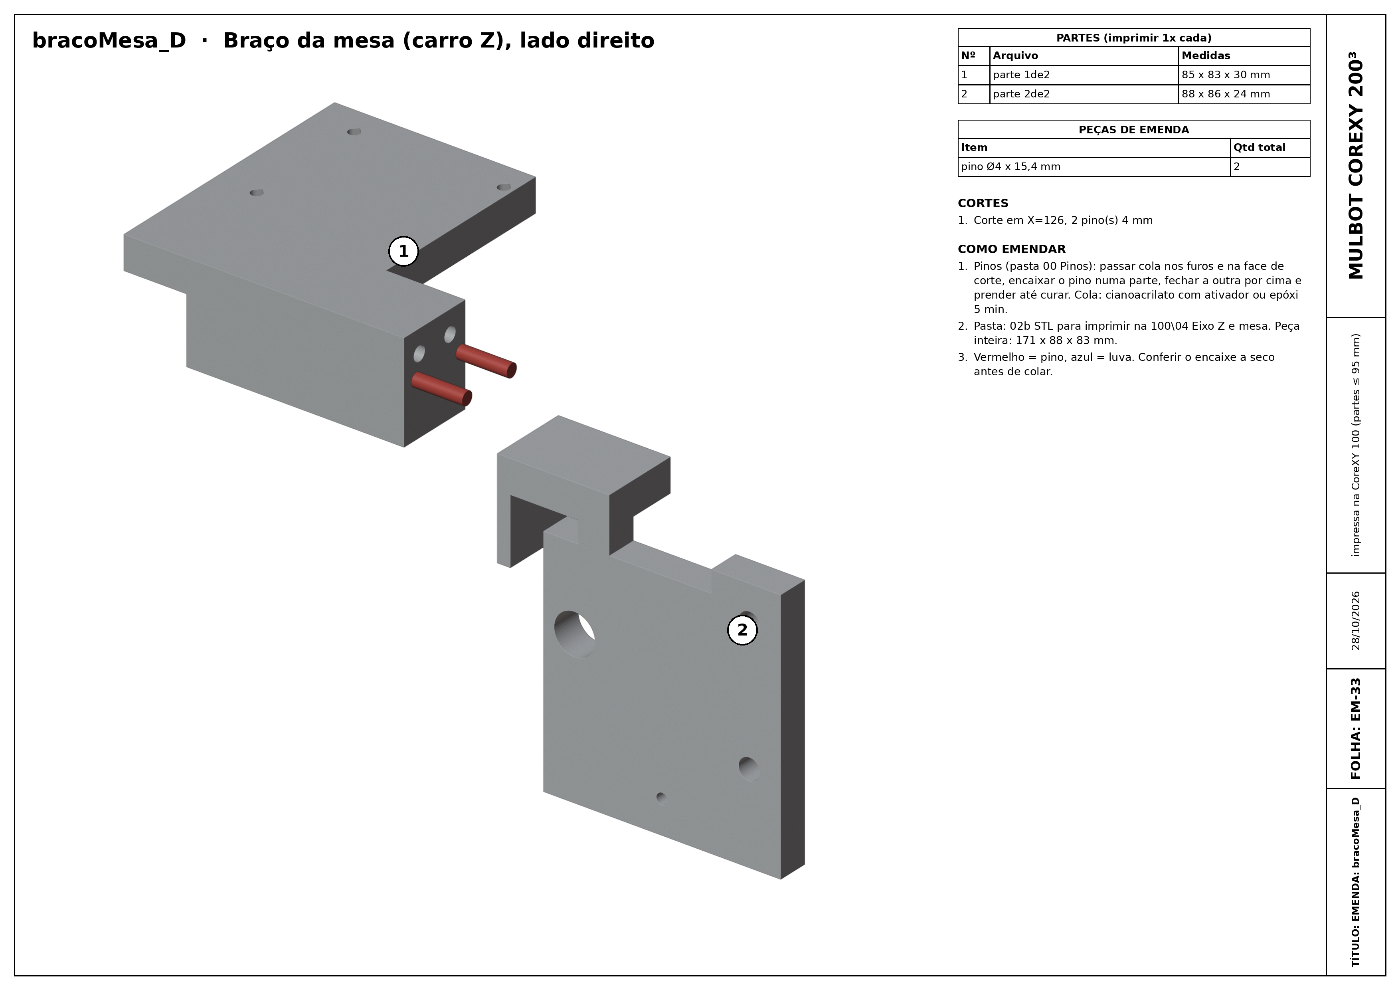
entrega/03b Desenhos de emenda (impressa na 100)/EM-33 - bracoMesa_D.png
