WHdragon770/mulbot-corexy/entrega/03b Desenhos de emenda (impressa na 100)/EM-34 - bracoMesa_E.png

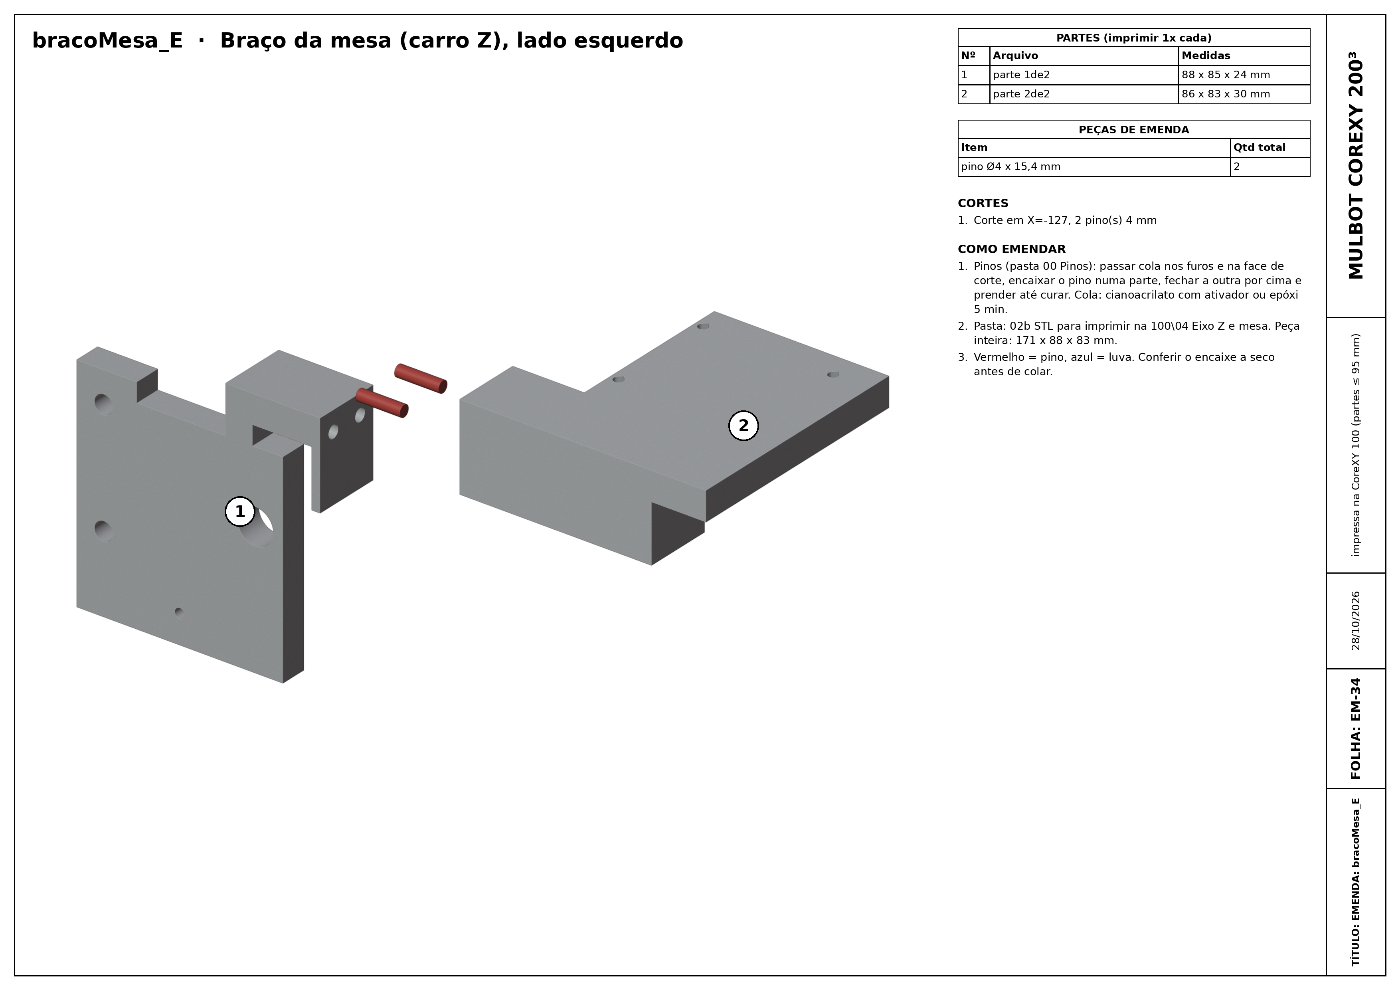
entrega/03b Desenhos de emenda (impressa na 100)/EM-34 - bracoMesa_E.png
