WHdragon770/mulbot-corexy/entrega/03b Desenhos de emenda (impressa na 100)/EM-39 - fusoZ_250mm.png

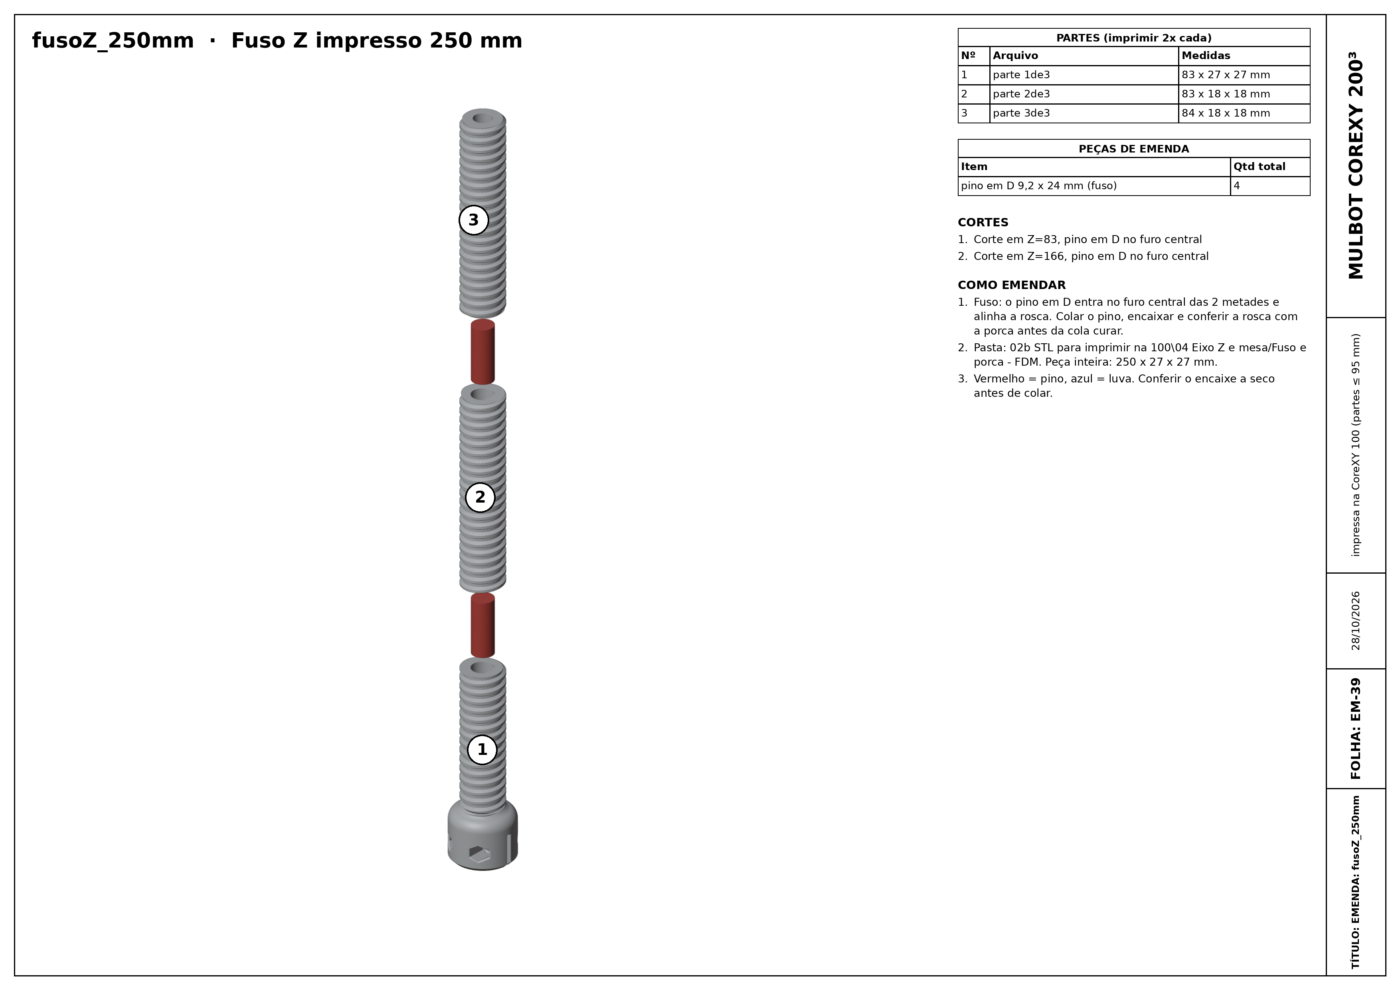
entrega/03b Desenhos de emenda (impressa na 100)/EM-39 - fusoZ_250mm.png
