WHdragon770/mulbot-corexy/entrega/03b Desenhos de emenda (impressa na 100)/EM-40 - DL1-02-09_caixa_ramps.png

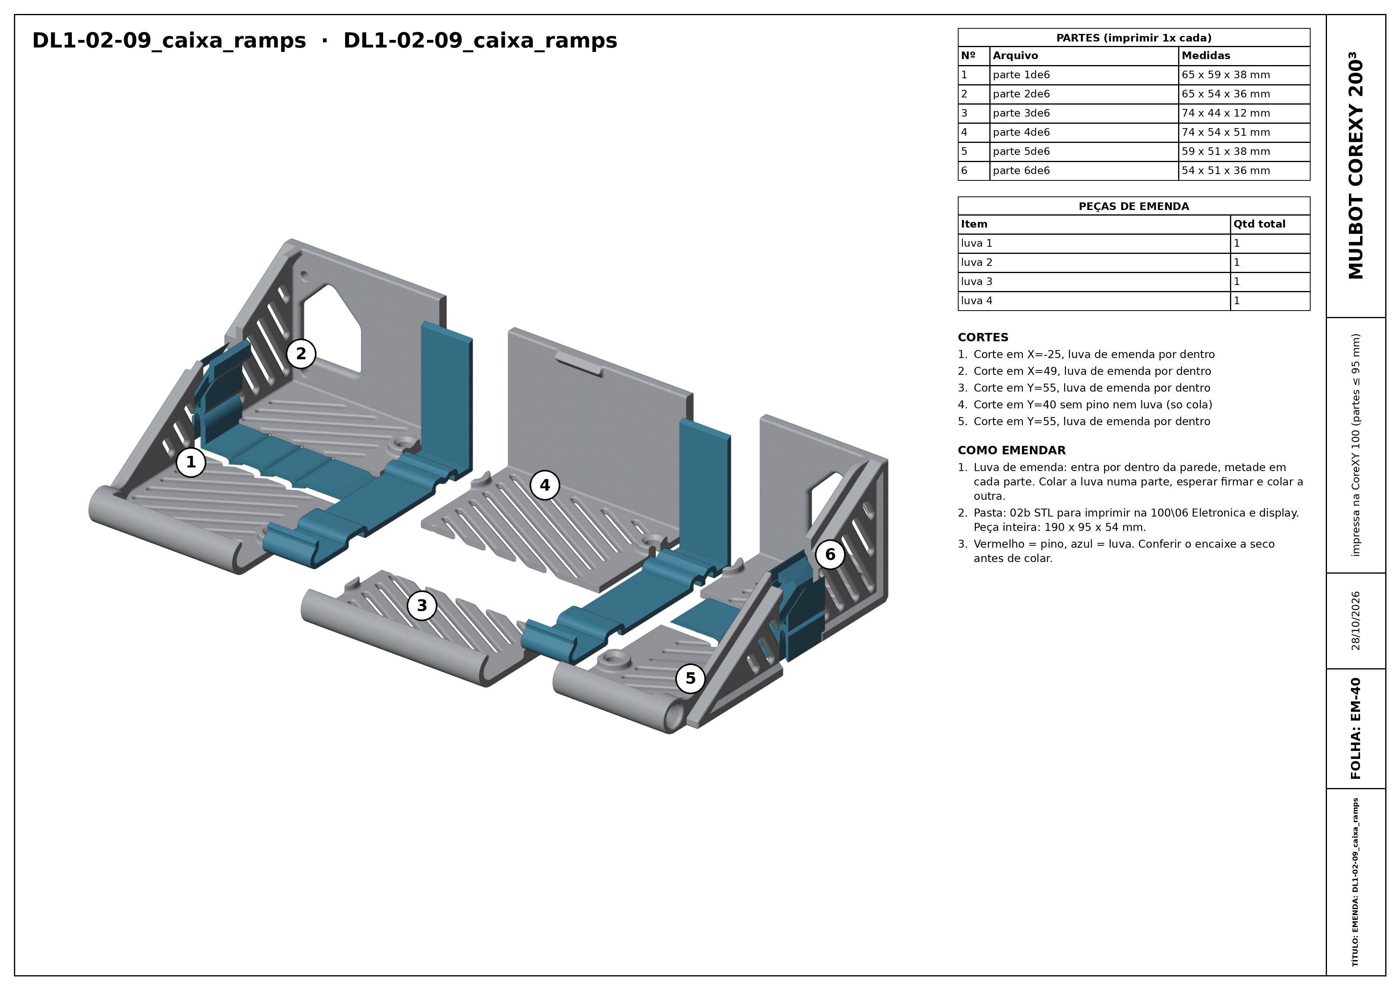
entrega/03b Desenhos de emenda (impressa na 100)/EM-40 - DL1-02-09_caixa_ramps.png
