WHdragon770/mulbot-corexy/entrega/03b Desenhos de emenda (impressa na 100)/EM-41 - DL1-02-10_porta_fechada.png

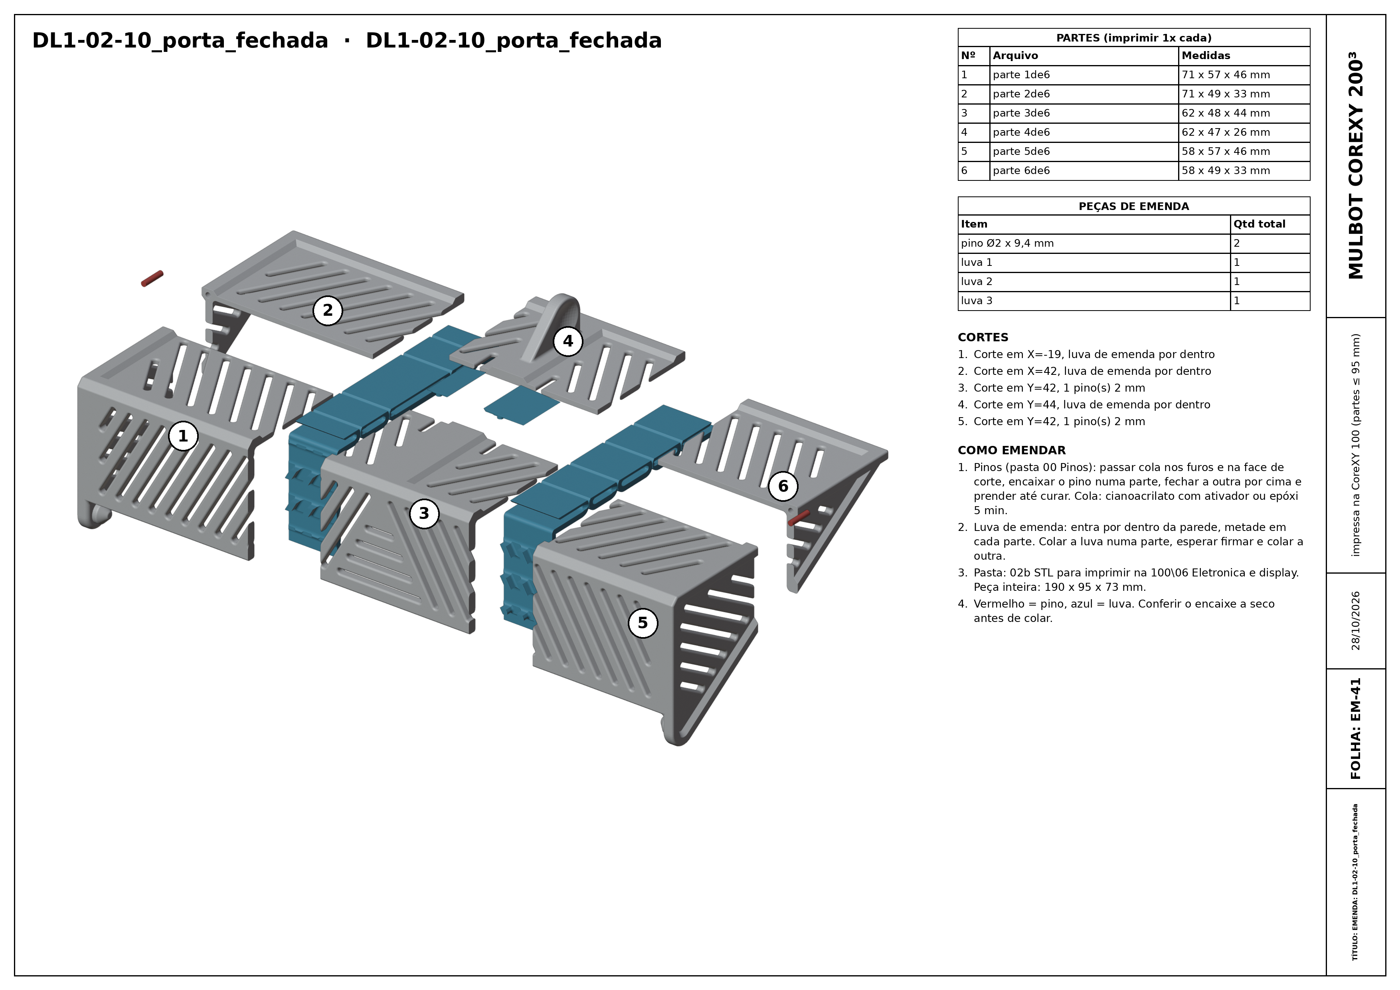
entrega/03b Desenhos de emenda (impressa na 100)/EM-41 - DL1-02-10_porta_fechada.png
