WHdragon770/mulbot-corexy/entrega/03b Desenhos de emenda (impressa na 100)/EM-42 - DL1-02-15.png

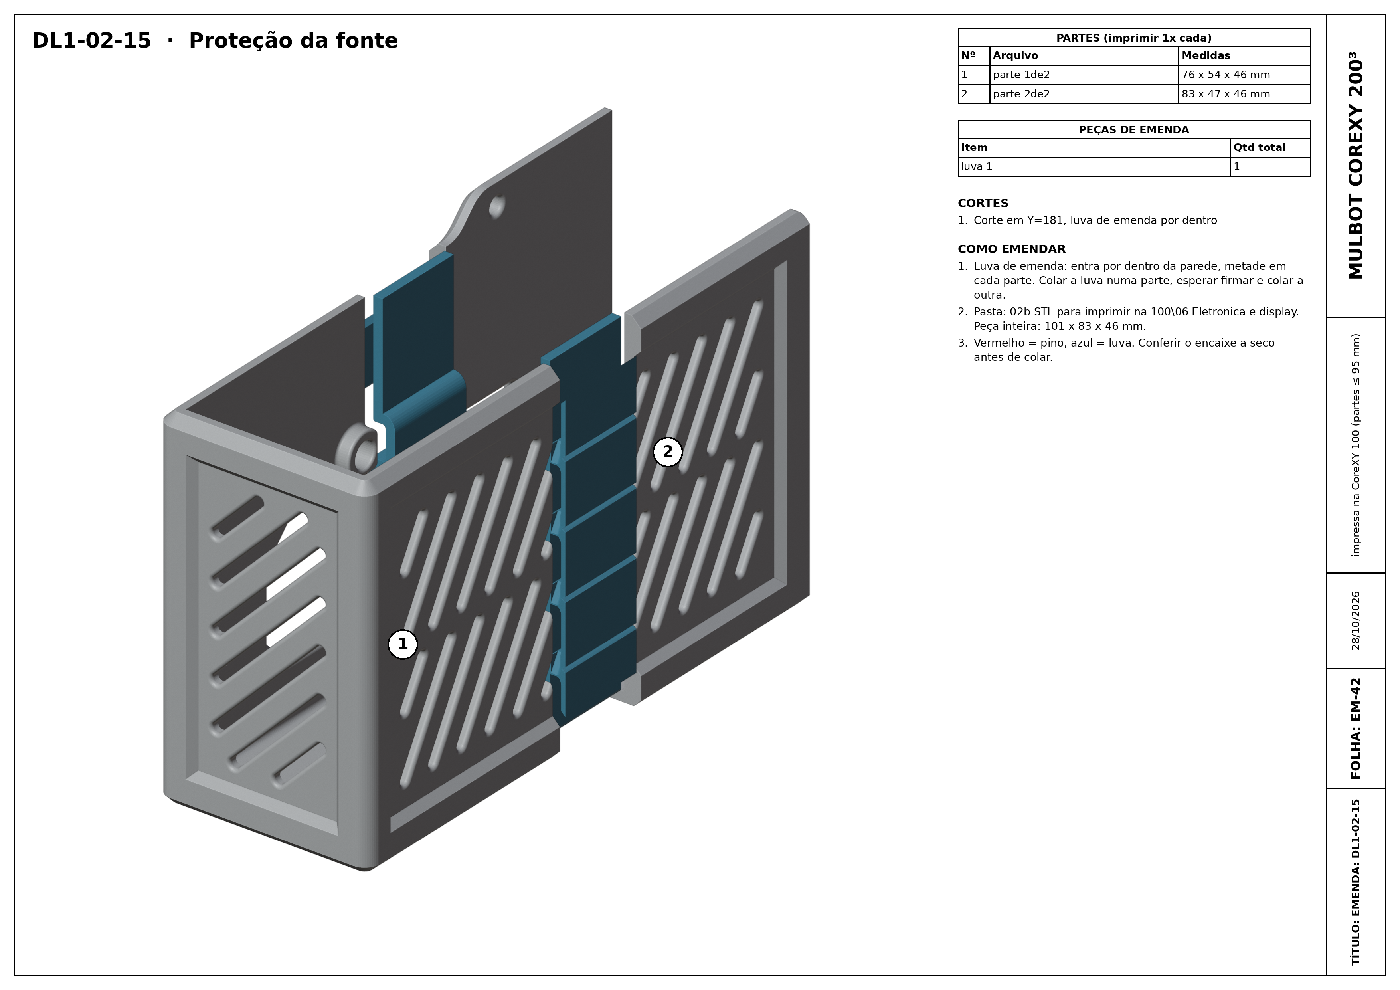
entrega/03b Desenhos de emenda (impressa na 100)/EM-42 - DL1-02-15.png
