WHdragon770/mulbot-corexy/entrega/03b Desenhos de emenda (impressa na 100)/EM-43 - DL1-05-02.png

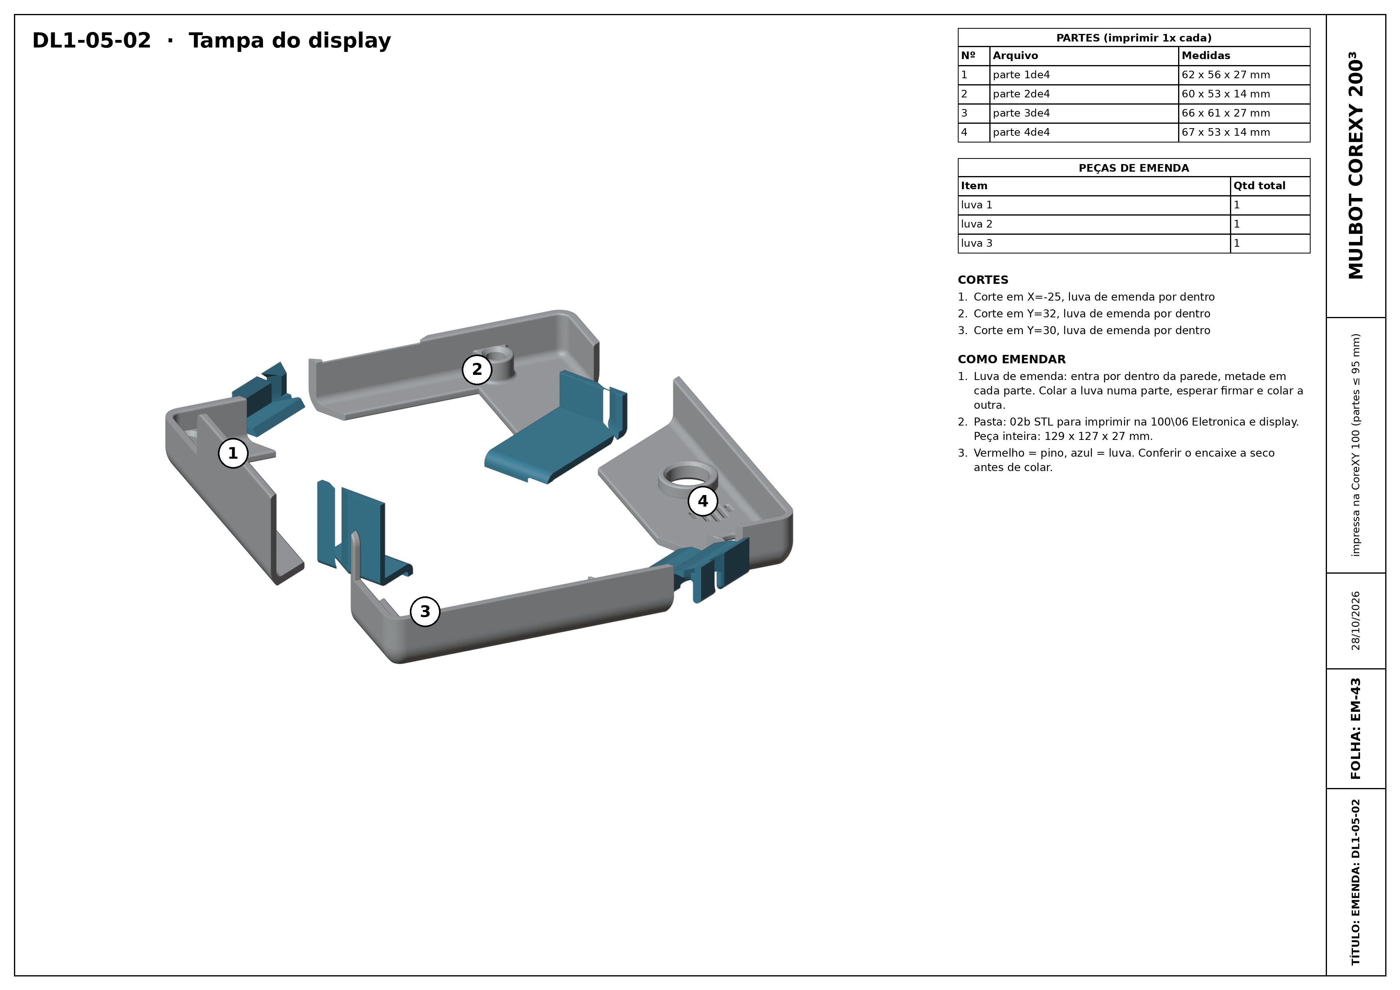
entrega/03b Desenhos de emenda (impressa na 100)/EM-43 - DL1-05-02.png
