WHdragon770/mulbot-corexy/entrega/03b Desenhos de emenda (impressa na 100)/EM-44 - bandejaX.png

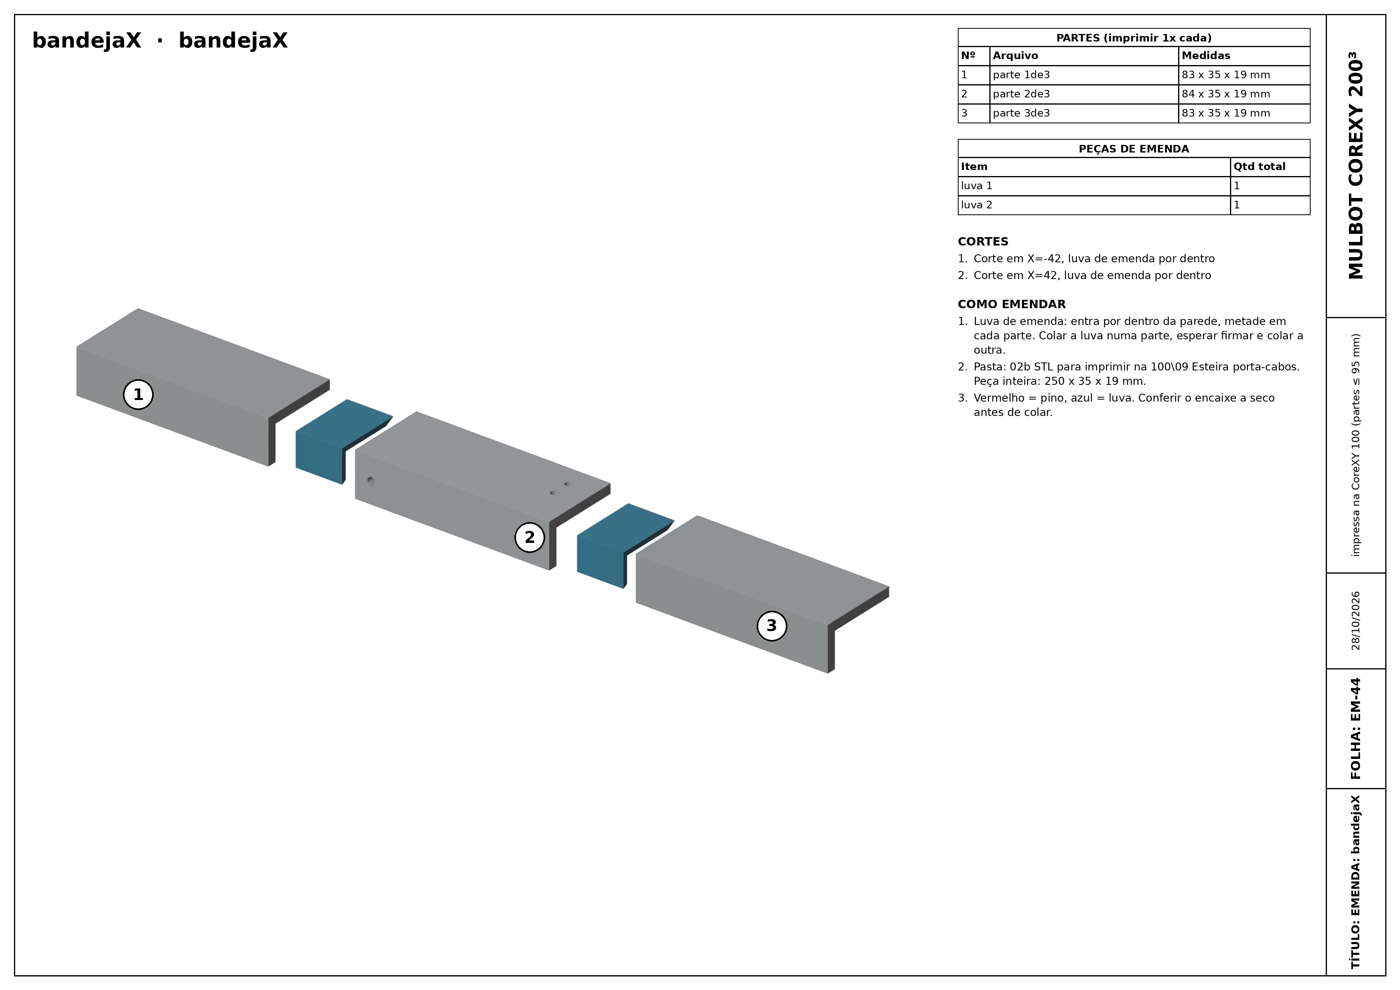
entrega/03b Desenhos de emenda (impressa na 100)/EM-44 - bandejaX.png
