WHdragon770/mulbot-corexy/entrega/03b Desenhos de emenda (impressa na 100)/EM-45 - bandejaY_F.png

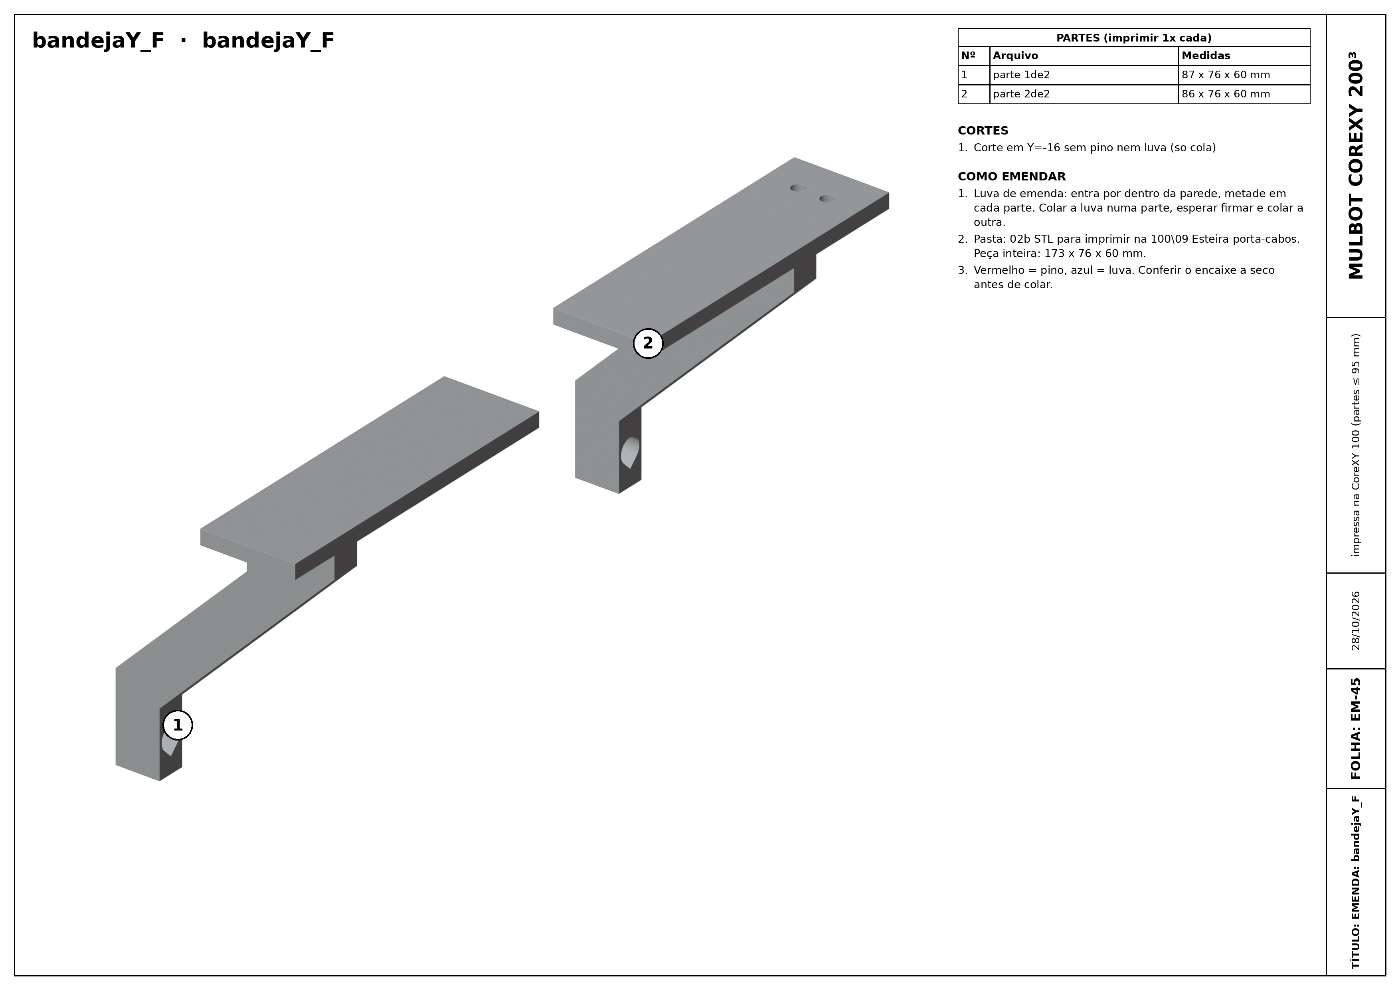
entrega/03b Desenhos de emenda (impressa na 100)/EM-45 - bandejaY_F.png
