WHdragon770/mulbot-corexy/entrega/03b Desenhos de emenda (impressa na 100)/EM-46 - bandejaY_T.png

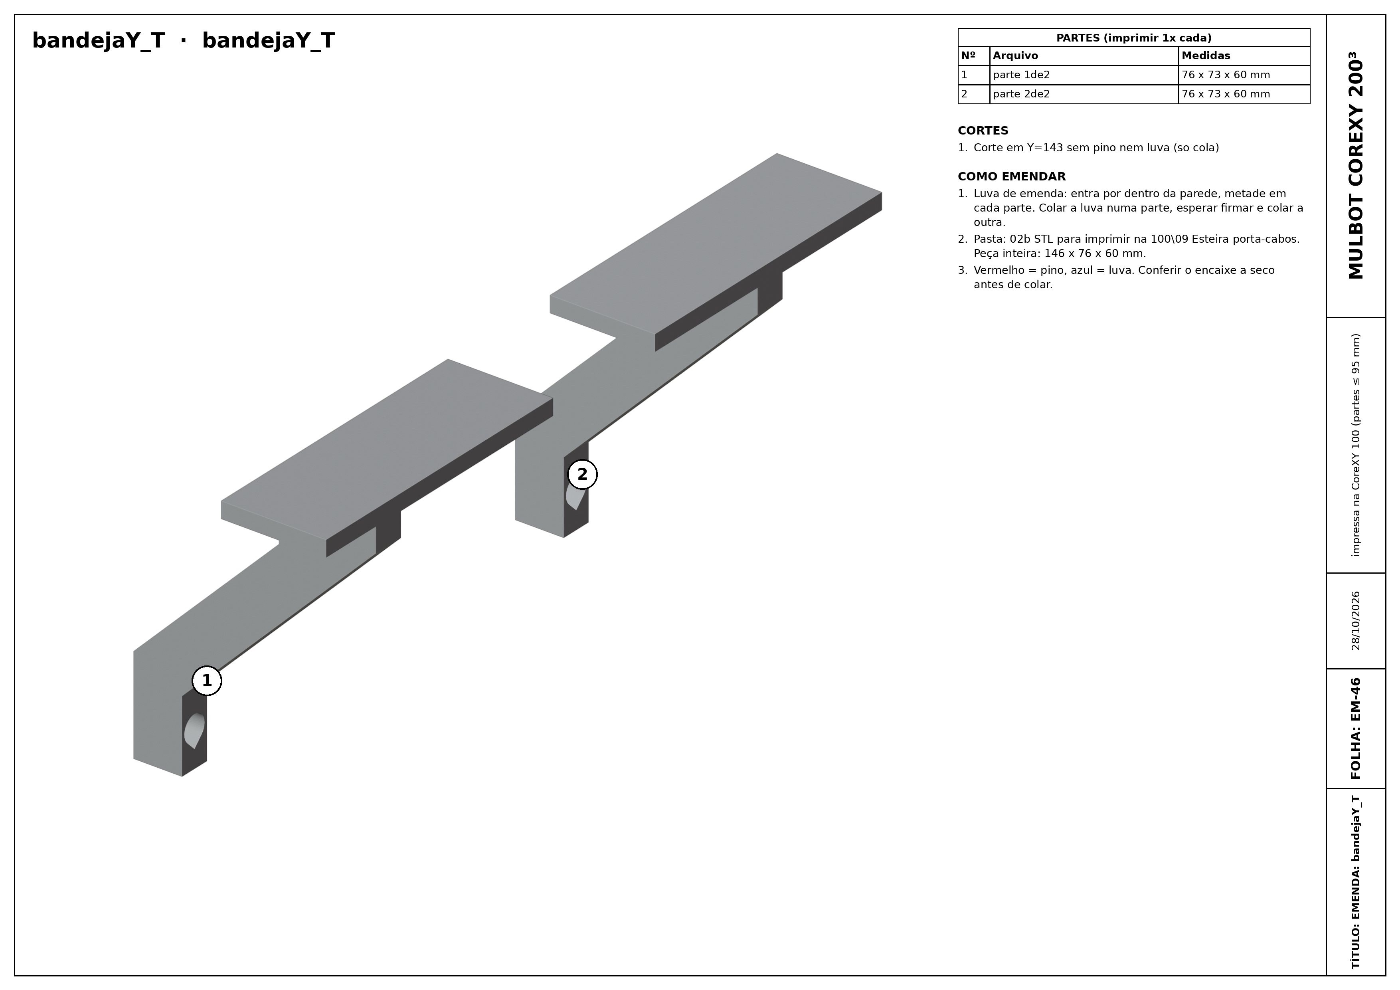
entrega/03b Desenhos de emenda (impressa na 100)/EM-46 - bandejaY_T.png
