WHdragon770/mulbot-corexy/entrega/04 Video/Imagens de conferencia/01 - Quadro.png

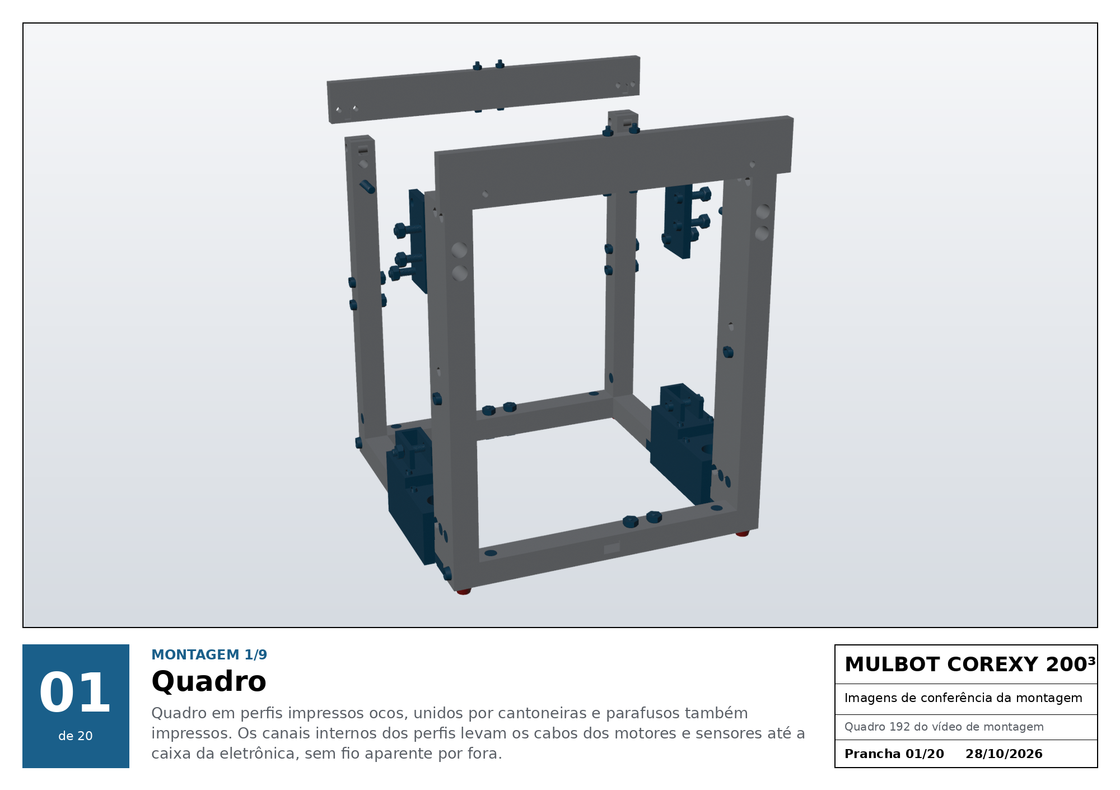
entrega/04 Video/Imagens de conferencia/01 - Quadro.png
