WHdragon770/mulbot-corexy/entrega/04 Video/Imagens de conferencia/02 - Eixo Z e mesa.png

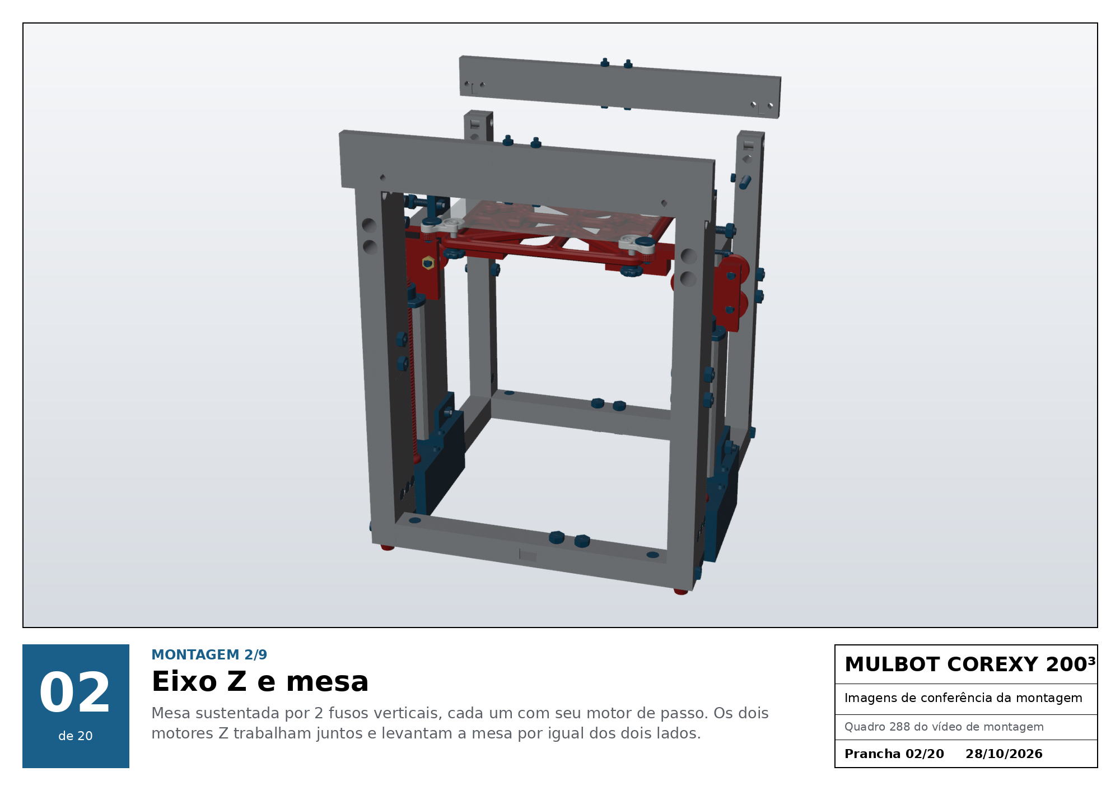
entrega/04 Video/Imagens de conferencia/02 - Eixo Z e mesa.png
