WHdragon770/mulbot-corexy/entrega/04 Video/Imagens de conferencia/03 - Torres e motores A-B.png

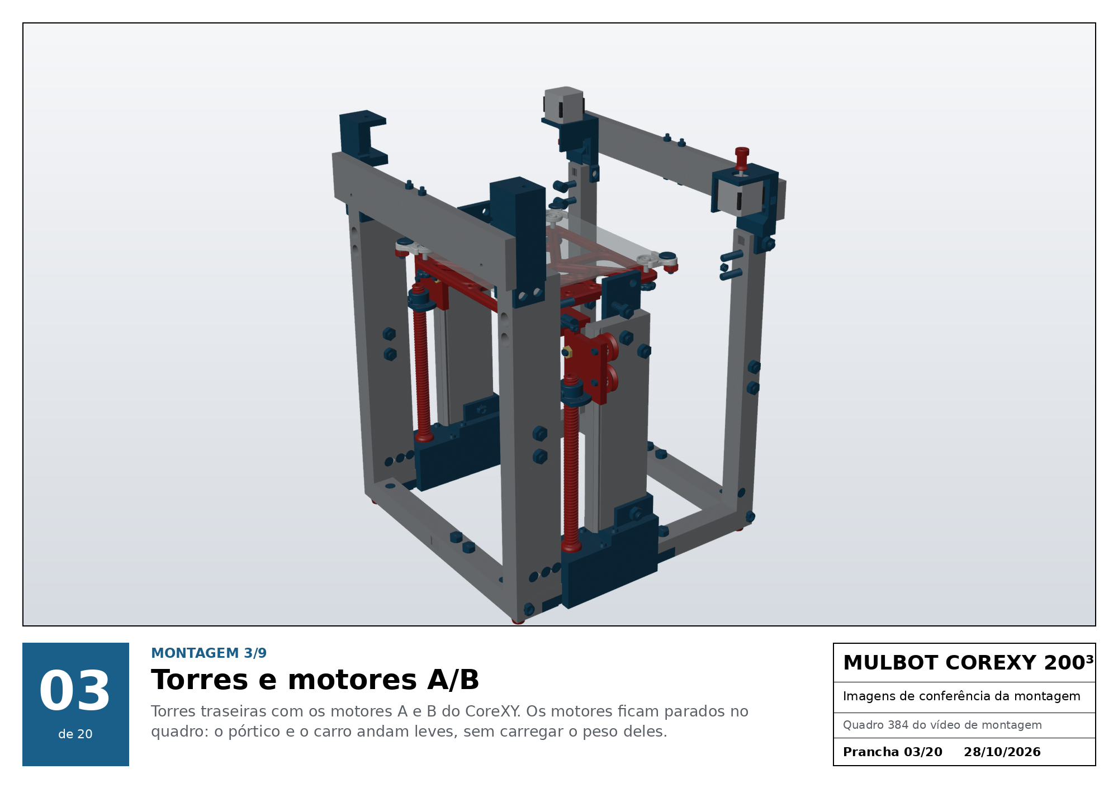
entrega/04 Video/Imagens de conferencia/03 - Torres e motores A-B.png
