WHdragon770/mulbot-corexy/entrega/04 Video/Imagens de conferencia/04 - Vigas Y com guia em V.png

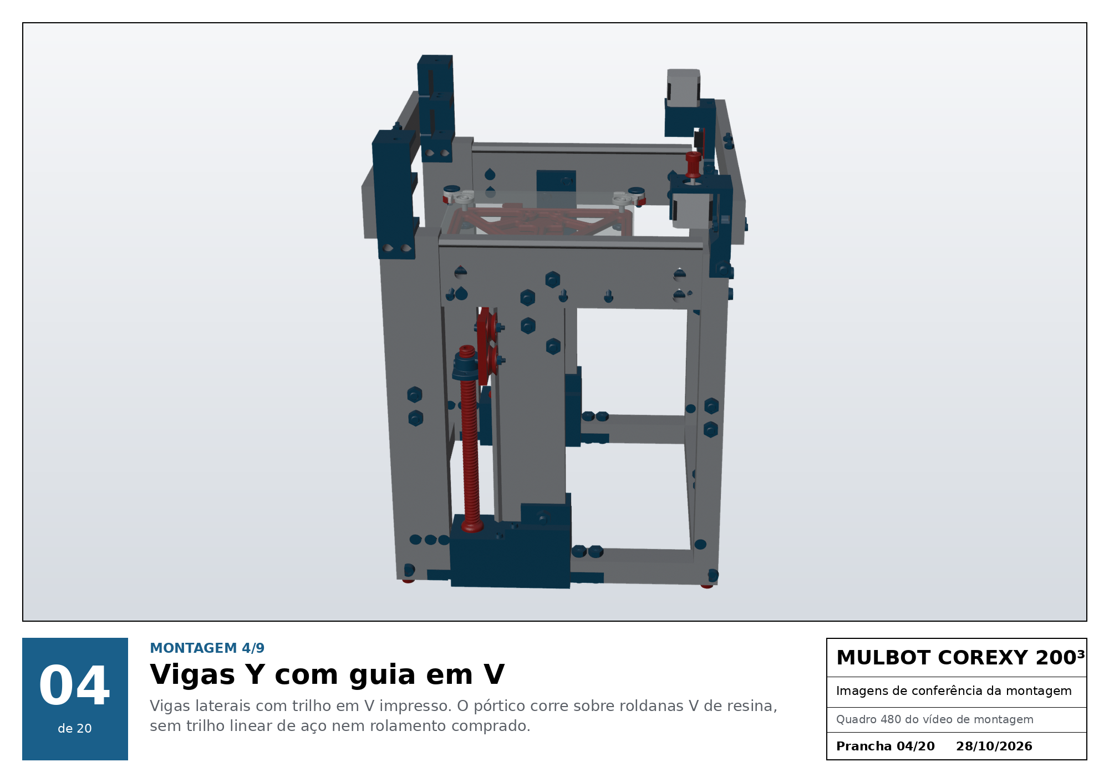
entrega/04 Video/Imagens de conferencia/04 - Vigas Y com guia em V.png
