WHdragon770/mulbot-corexy/entrega/04 Video/Imagens de conferencia/05 - Pórtico.png

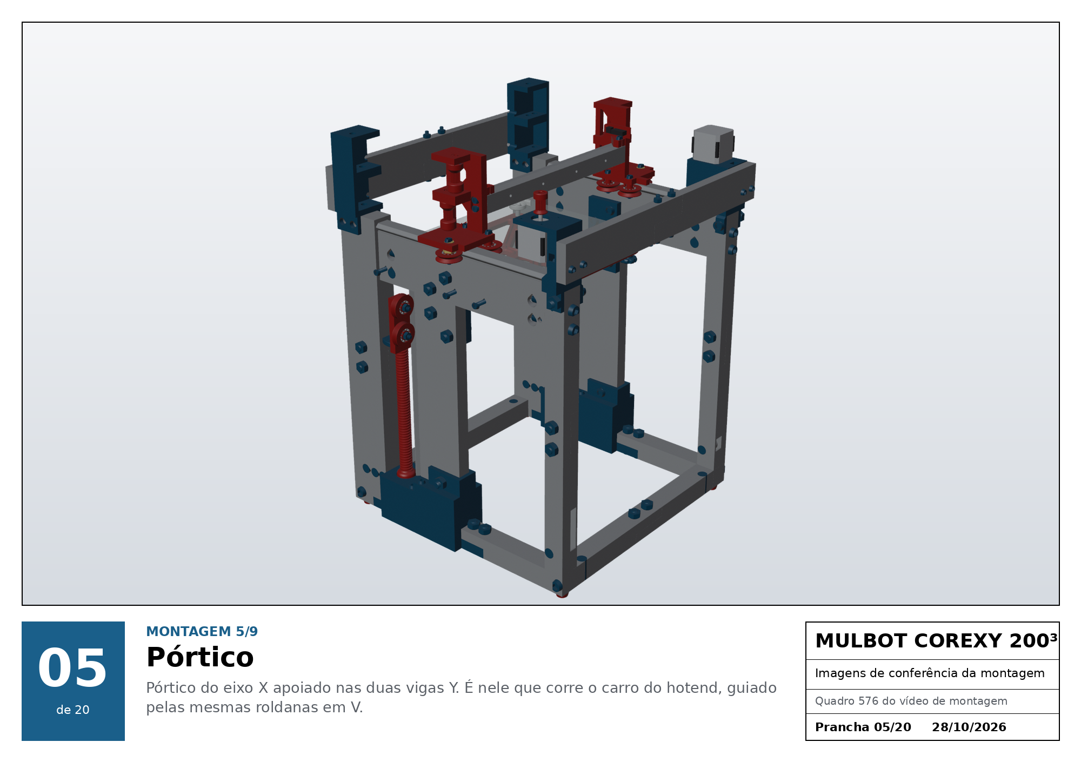
entrega/04 Video/Imagens de conferencia/05 - Pórtico.png
