WHdragon770/mulbot-corexy/entrega/04 Video/Imagens de conferencia/06 - Carro X e hotend.png

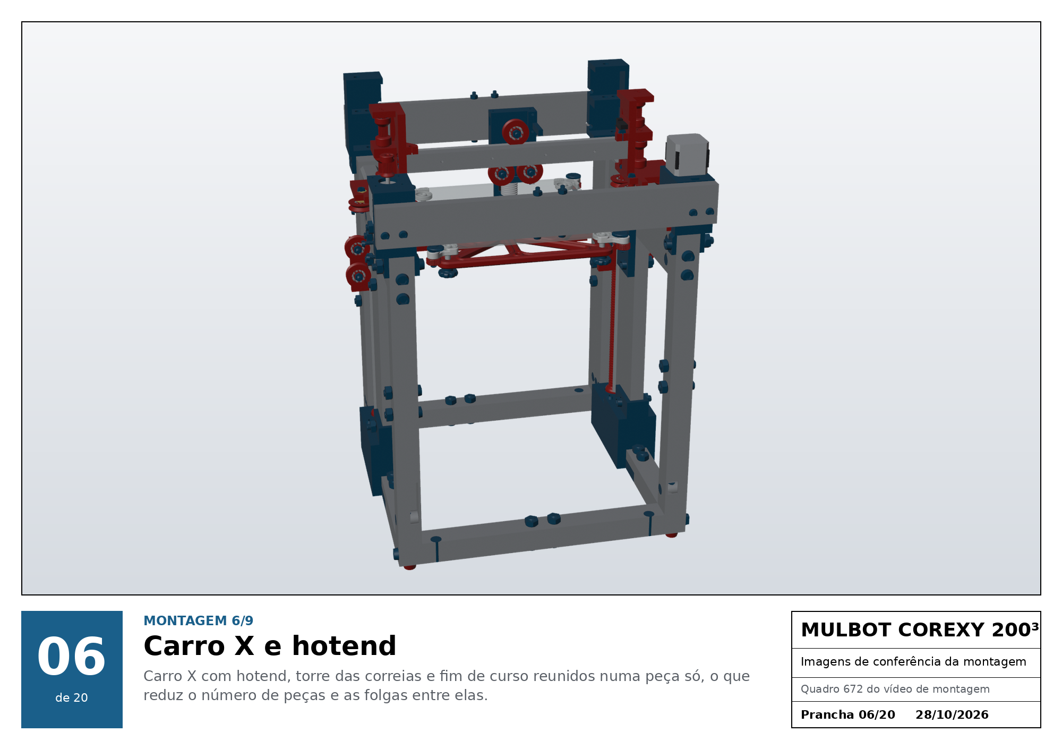
entrega/04 Video/Imagens de conferencia/06 - Carro X e hotend.png
