WHdragon770/mulbot-corexy/entrega/04 Video/Imagens de conferencia/07 - Polias e correias CoreXY.png

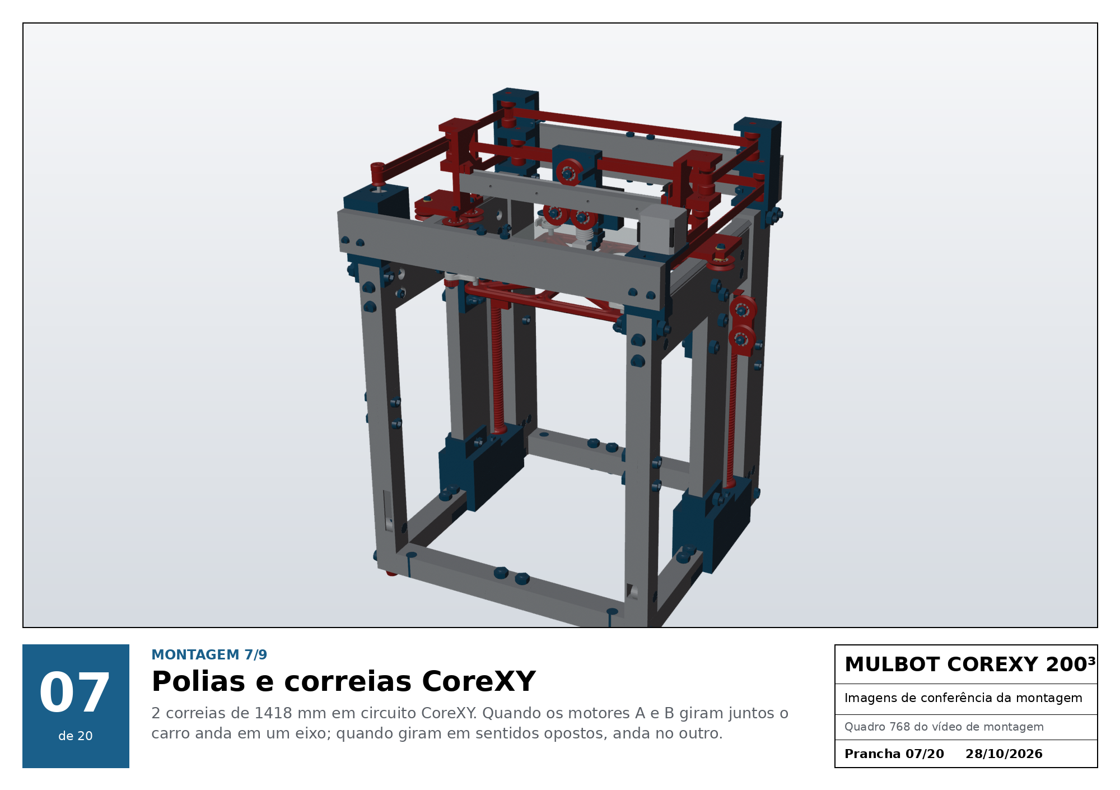
entrega/04 Video/Imagens de conferencia/07 - Polias e correias CoreXY.png
