WHdragon770/mulbot-corexy/entrega/04 Video/Imagens de conferencia/08 - Extrusora direta.png

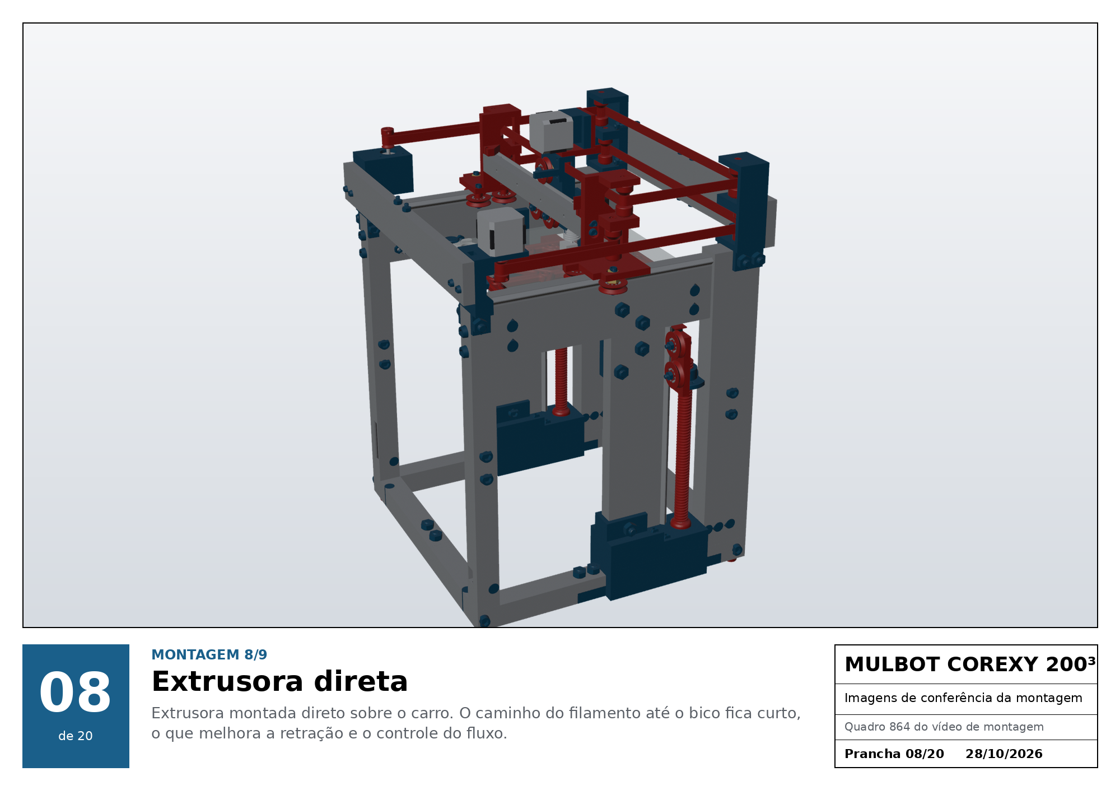
entrega/04 Video/Imagens de conferencia/08 - Extrusora direta.png
