WHdragon770/mulbot-corexy/entrega/04 Video/Imagens de conferencia/09 - Eletrônica, esteira e display.png

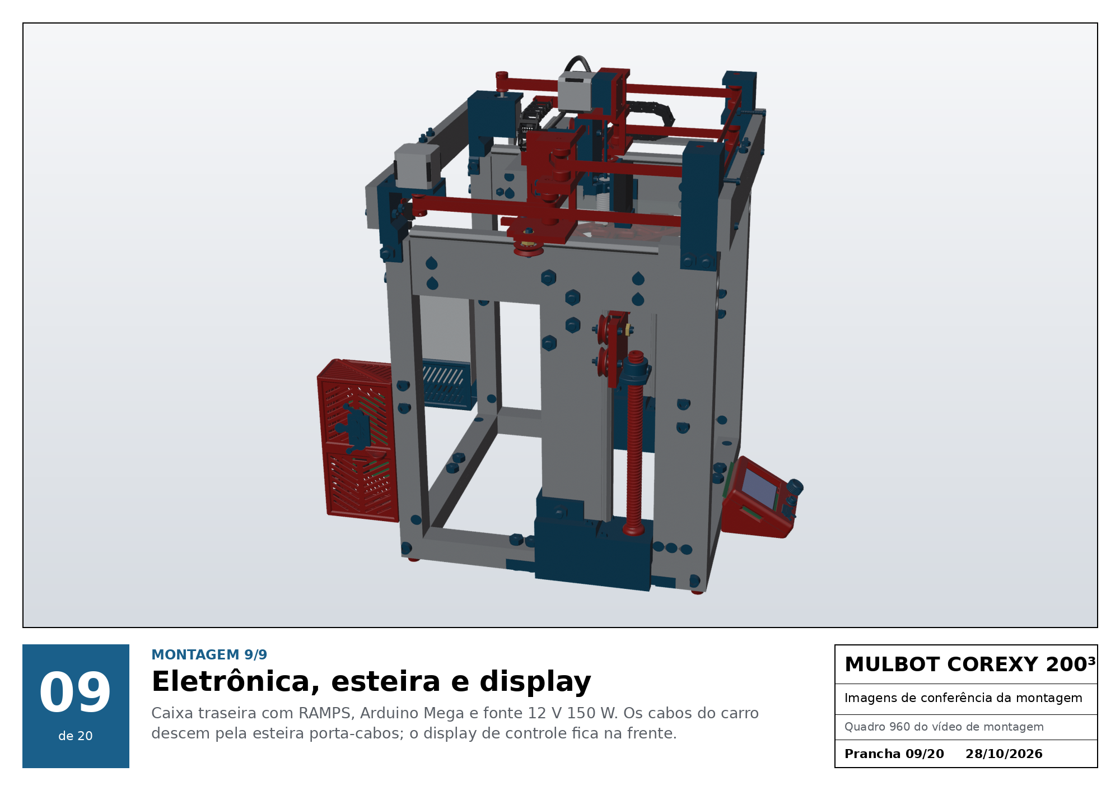
entrega/04 Video/Imagens de conferencia/09 - Eletrônica, esteira e display.png
