WHdragon770/mulbot-corexy/entrega/04 Video/Imagens de conferencia/10 - Impressora montada.png

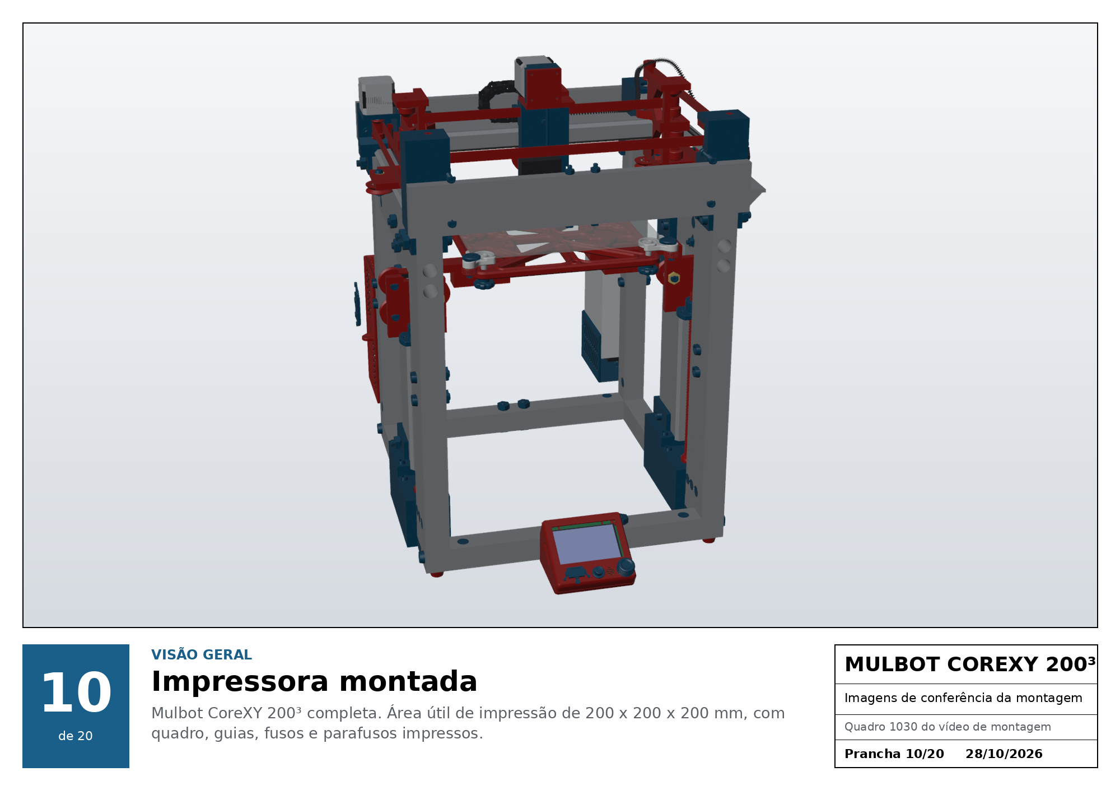
entrega/04 Video/Imagens de conferencia/10 - Impressora montada.png
