WHdragon770/mulbot-corexy/entrega/04 Video/Imagens de conferencia/11 - Guia em V impressa.png

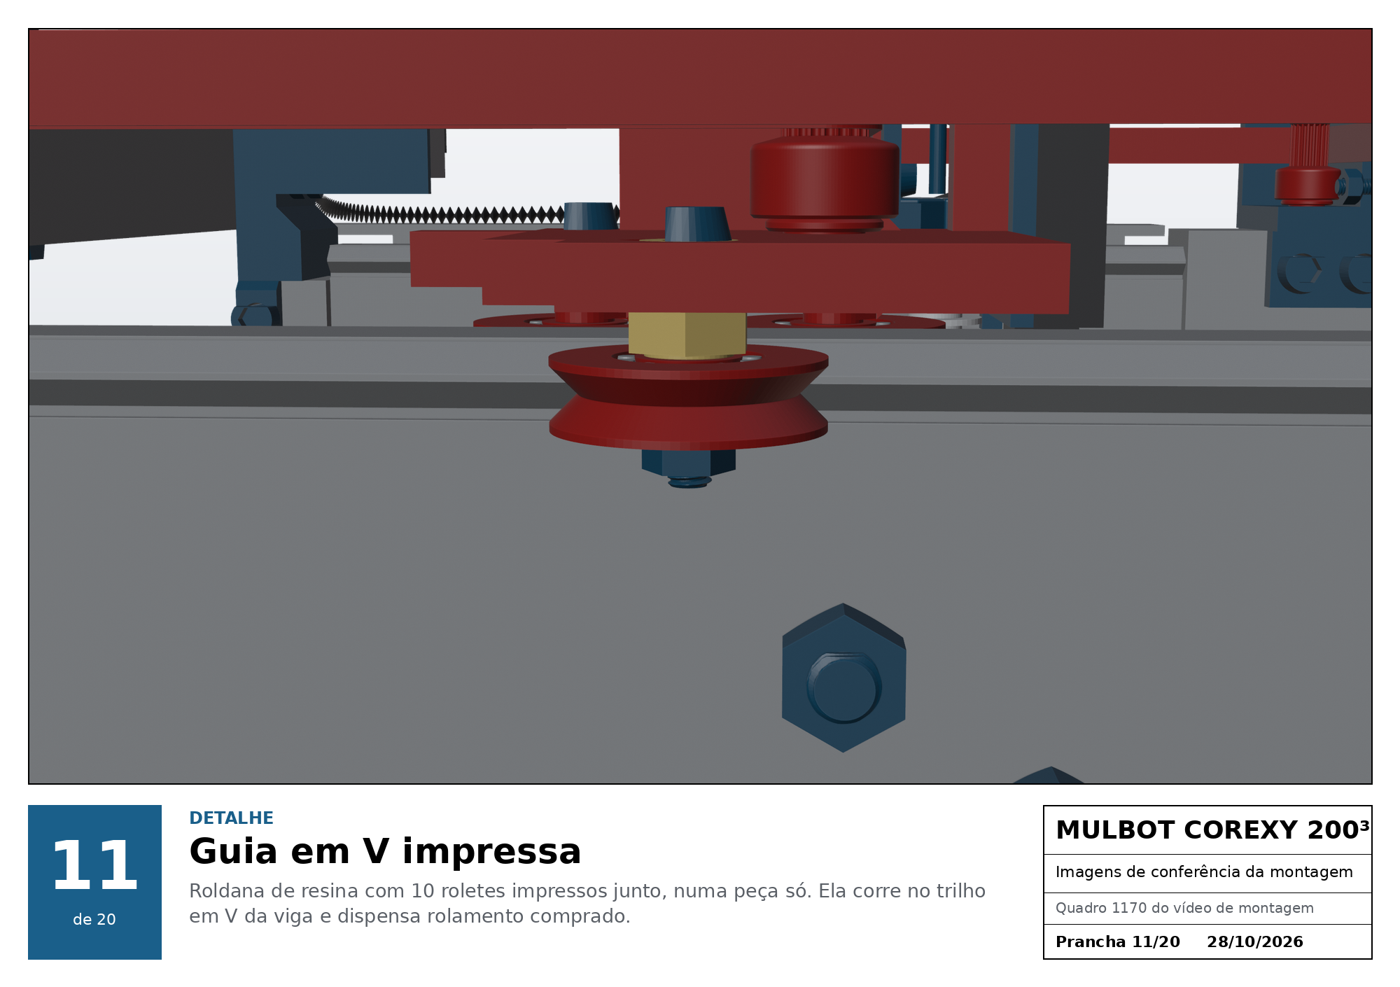
entrega/04 Video/Imagens de conferencia/11 - Guia em V impressa.png
