WHdragon770/mulbot-corexy/entrega/04 Video/Imagens de conferencia/12 - Carro X.png

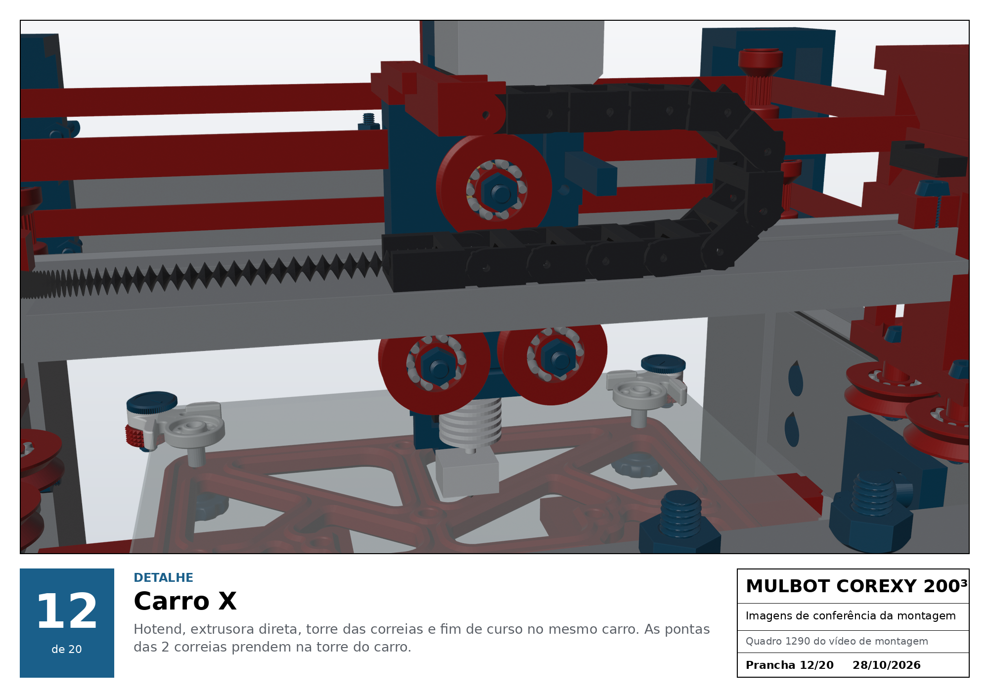
entrega/04 Video/Imagens de conferencia/12 - Carro X.png
