WHdragon770/mulbot-corexy/entrega/04 Video/Imagens de conferencia/13 - Presilha do vidro.png

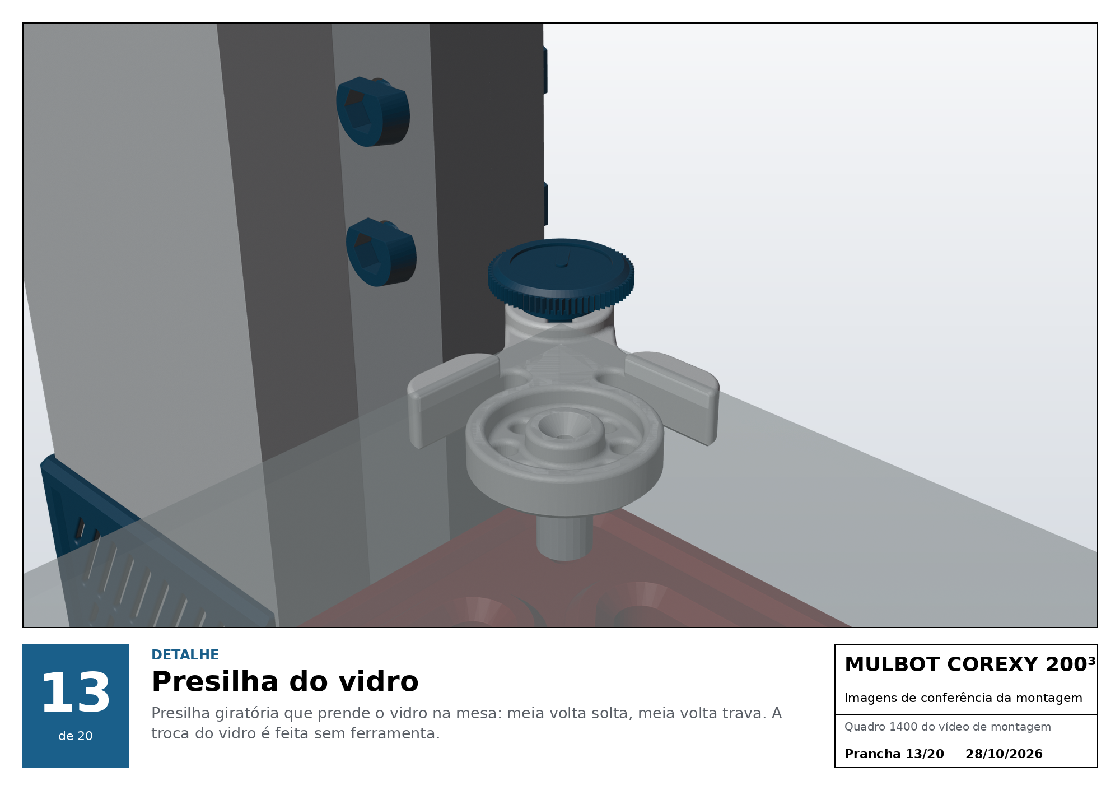
entrega/04 Video/Imagens de conferencia/13 - Presilha do vidro.png
