WHdragon770/mulbot-corexy/entrega/04 Video/Imagens de conferencia/14 - Sistema CoreXY.png

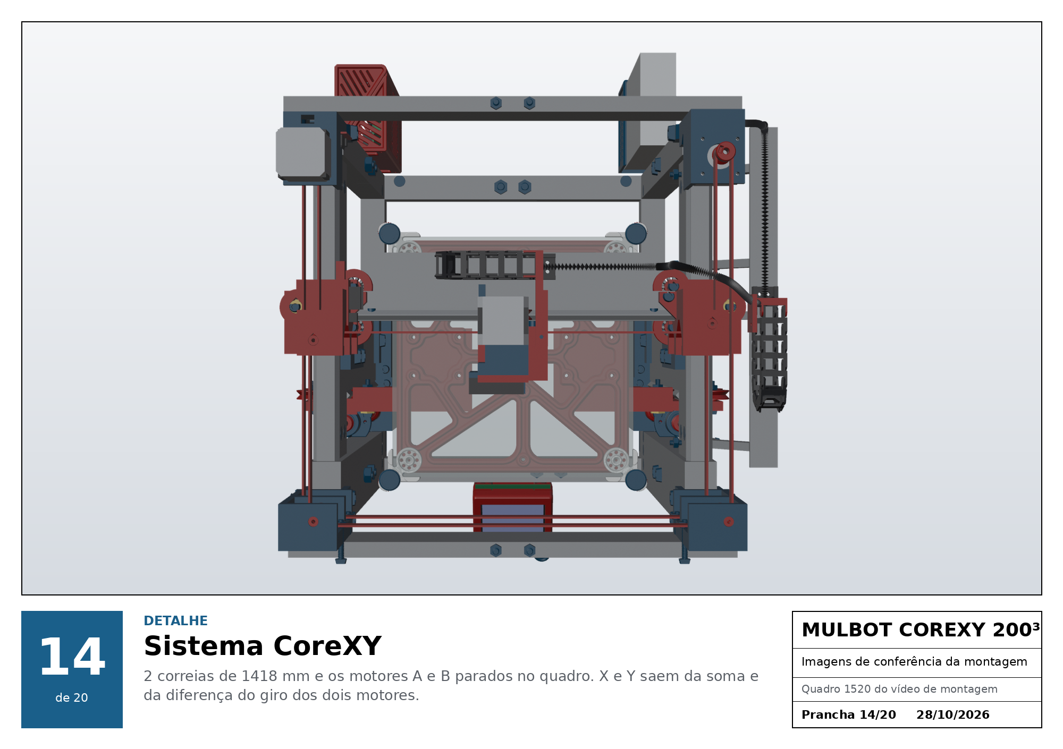
entrega/04 Video/Imagens de conferencia/14 - Sistema CoreXY.png
