WHdragon770/mulbot-corexy/entrega/04 Video/Imagens de conferencia/15 - Eletrônica.png

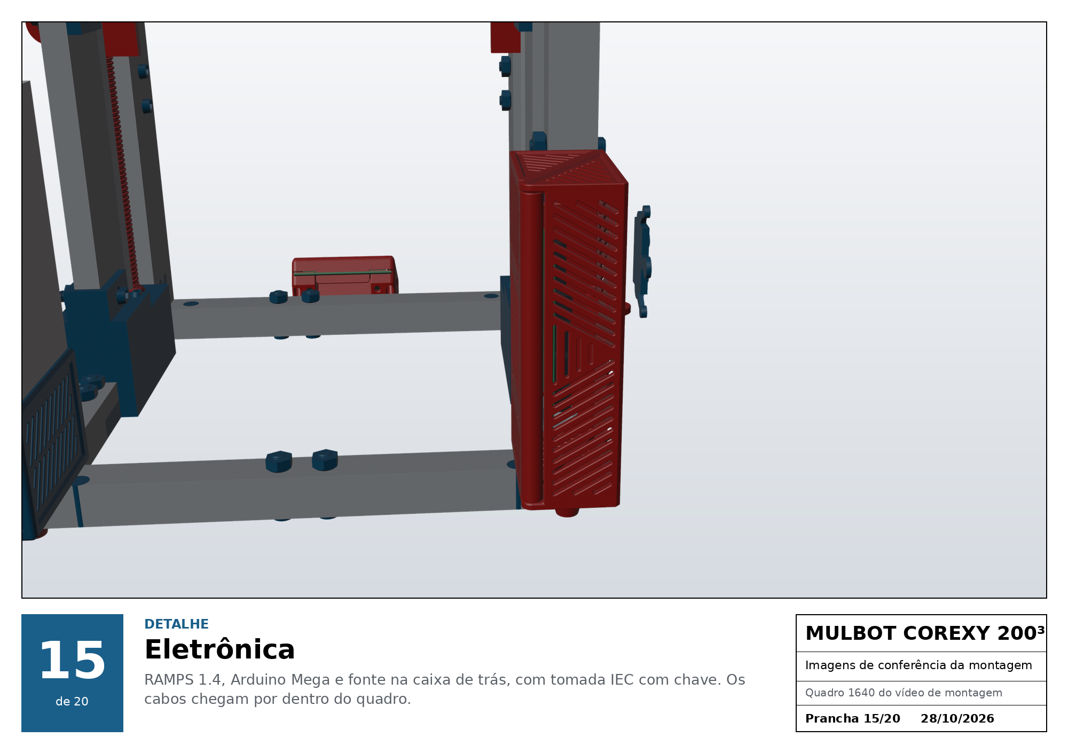
entrega/04 Video/Imagens de conferencia/15 - Eletrônica.png
