WHdragon770/mulbot-corexy/entrega/04 Video/Imagens de conferencia/16 - Passagem de cabos.png

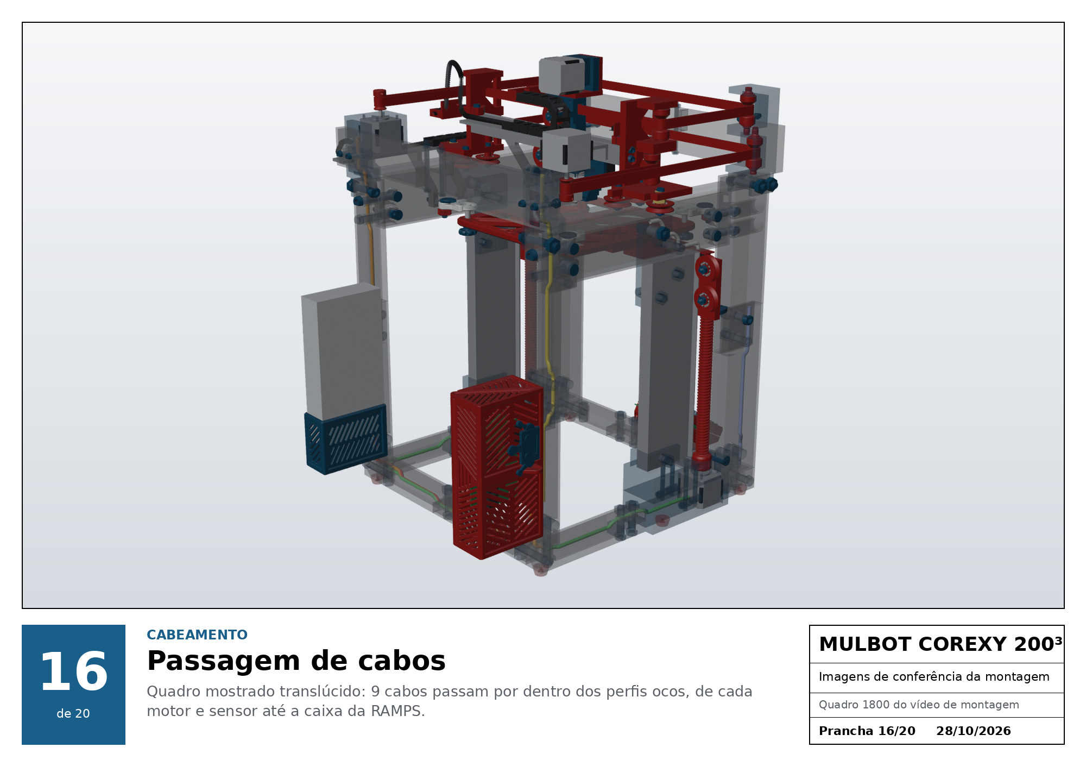
entrega/04 Video/Imagens de conferencia/16 - Passagem de cabos.png
