WHdragon770/mulbot-corexy/entrega/04 Video/Imagens de conferencia/17 - Impressora funcionando.png

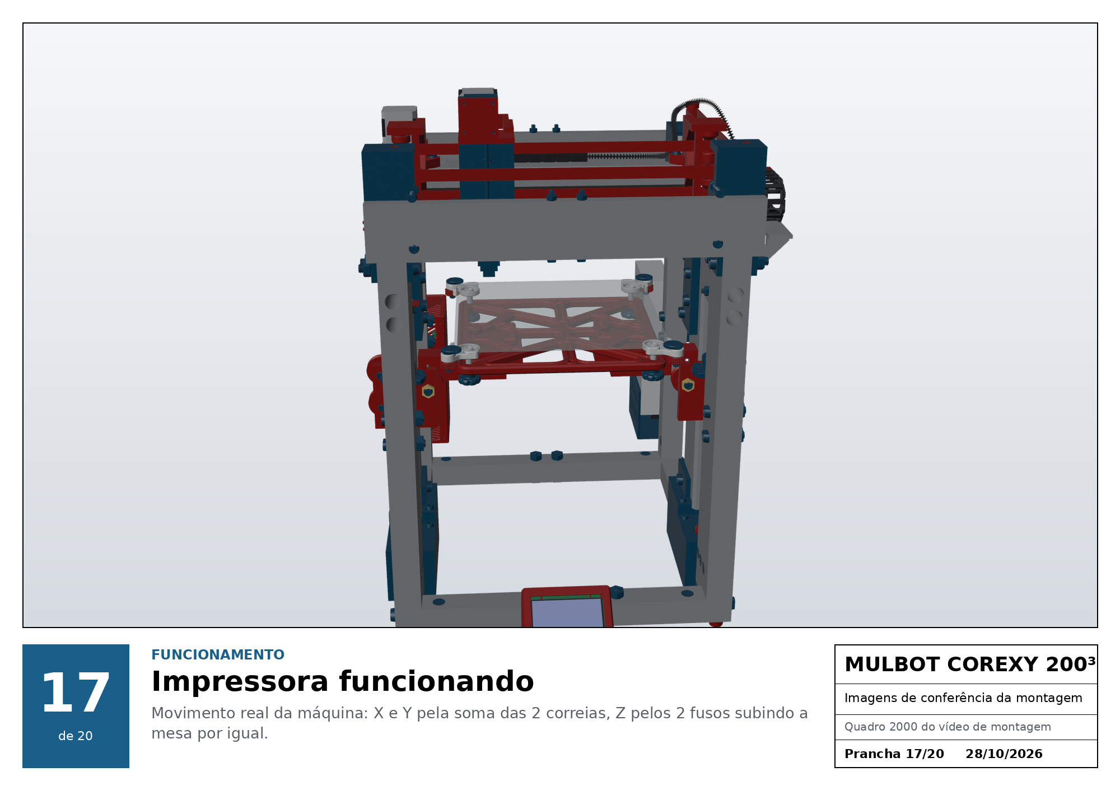
entrega/04 Video/Imagens de conferencia/17 - Impressora funcionando.png
