WHdragon770/mulbot-corexy/entrega/04 Video/Imagens de conferencia/18 - Vista explodida.png

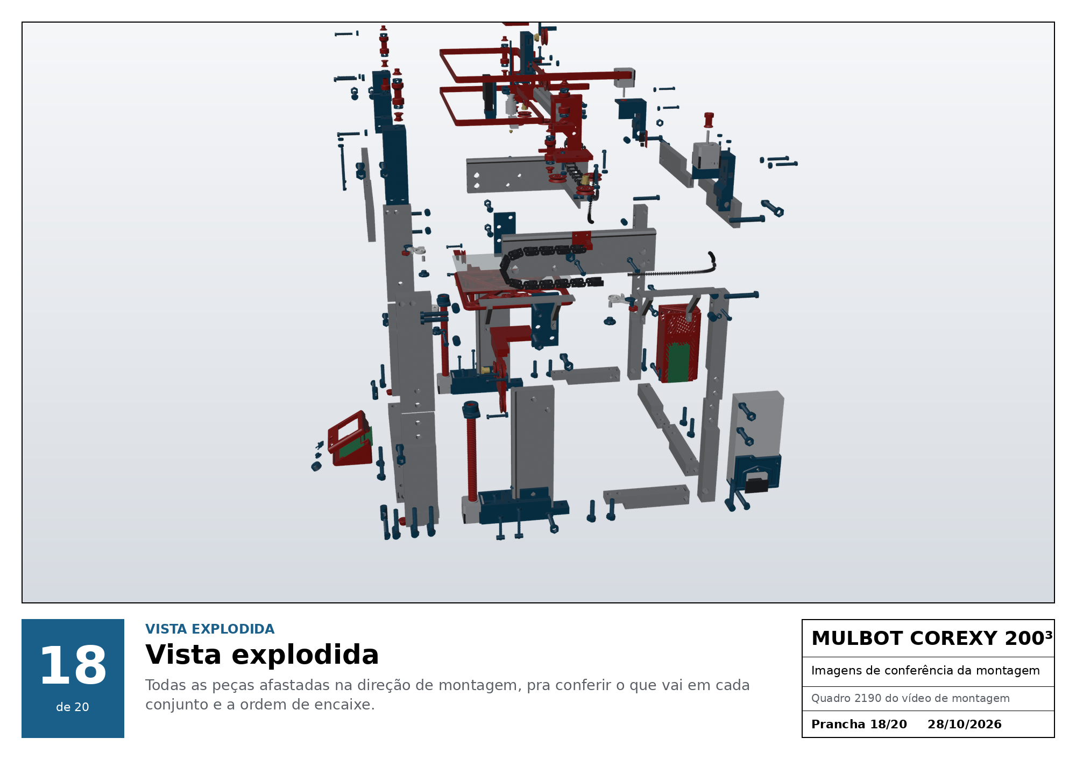
entrega/04 Video/Imagens de conferencia/18 - Vista explodida.png
