WHdragon770/mulbot-corexy/entrega/04 Video/Imagens de conferencia/19 - Pórtico explodido.png

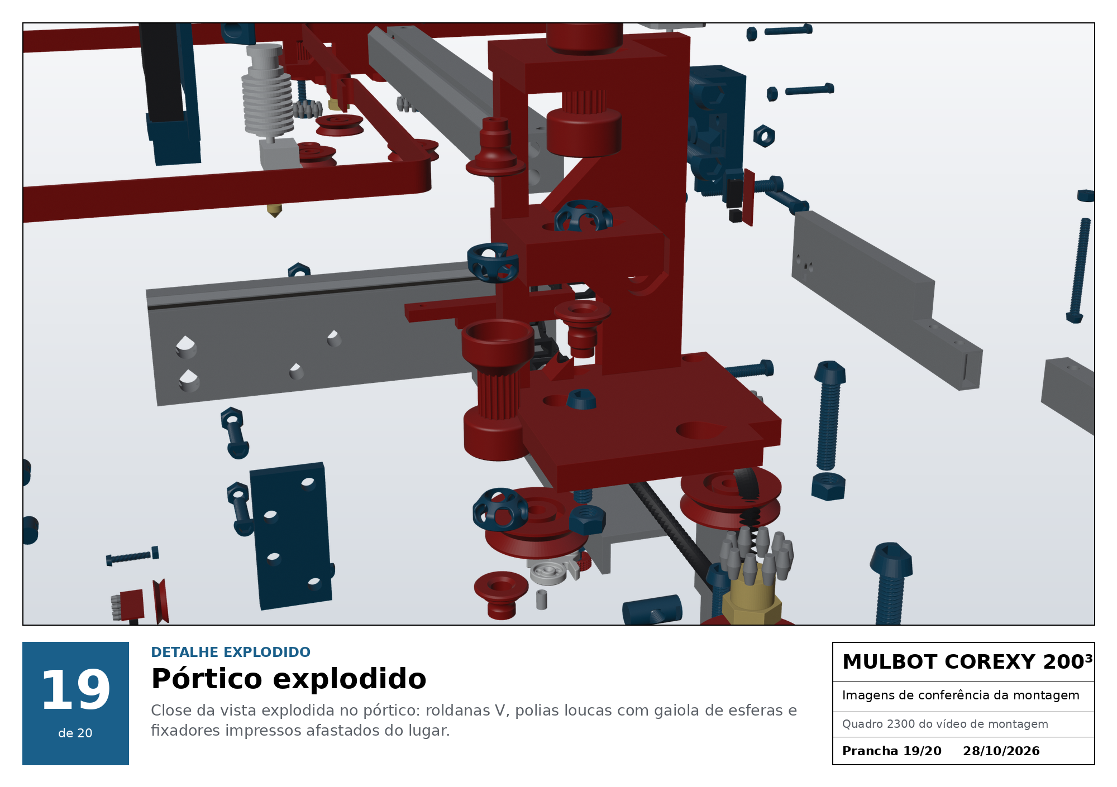
entrega/04 Video/Imagens de conferencia/19 - Pórtico explodido.png
