WHdragon770/mulbot-corexy/entrega/04 Video/Imagens de conferencia/20 - Mulbot CoreXY 200.png

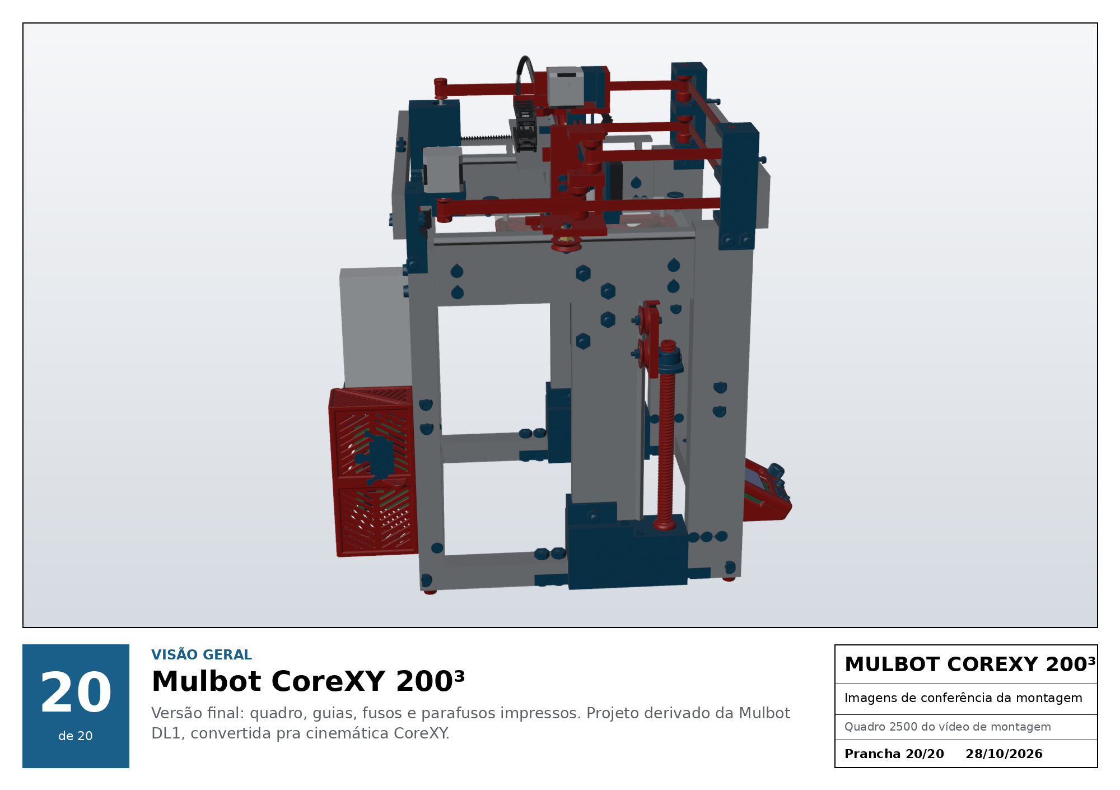
entrega/04 Video/Imagens de conferencia/20 - Mulbot CoreXY 200.png
