WHdragon770/mulbot-corexy/entrega/07 Mesa aquecida (opcional)/220 - 12V/Imagens/canto_mesa_topo.png

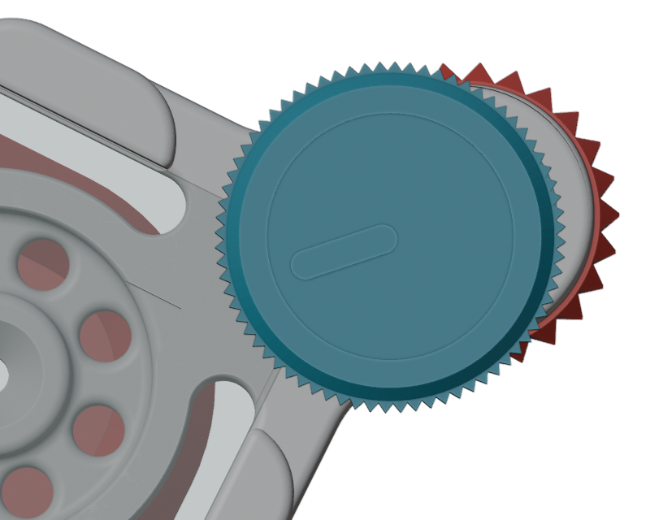
entrega/07 Mesa aquecida (opcional)/220 - 12V/Imagens/canto_mesa_topo.png
