WHdragon770/mulbot-corexy/entrega/07 Mesa aquecida (opcional)/220 - 12V/Imagens/fim_curso_Z_calco.png

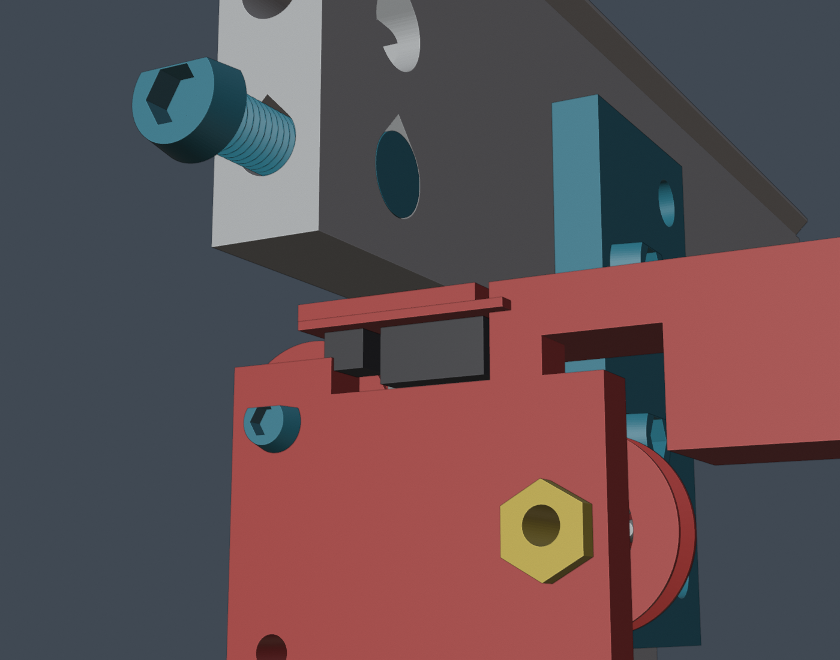
entrega/07 Mesa aquecida (opcional)/220 - 12V/Imagens/fim_curso_Z_calco.png
