WHdragon770/mulbot-corexy/entrega/07 Mesa aquecida (opcional)/220 - 12V/Imagens/fonte_lado_mosfet.png

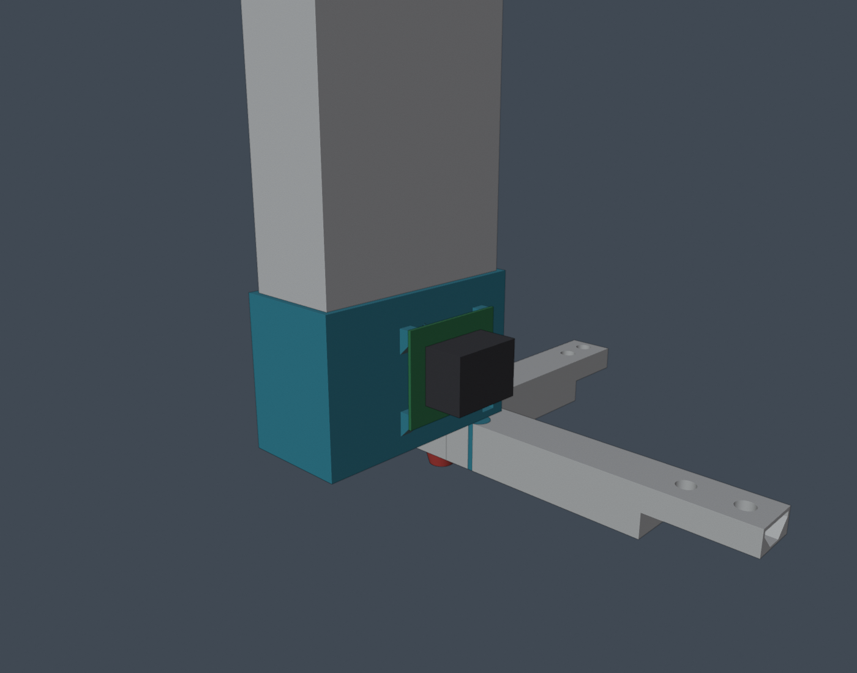
entrega/07 Mesa aquecida (opcional)/220 - 12V/Imagens/fonte_lado_mosfet.png
