WHdragon770/mulbot-corexy/entrega/07 Mesa aquecida (opcional)/220 - 12V/Imagens/maquina_iso.png

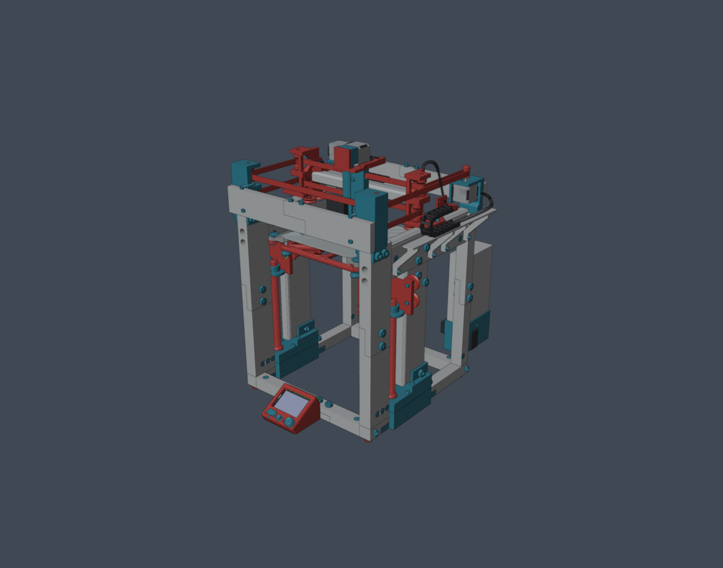
entrega/07 Mesa aquecida (opcional)/220 - 12V/Imagens/maquina_iso.png
