WHdragon770/mulbot-corexy/trab/imagens/guia_v/carroX_frente.png

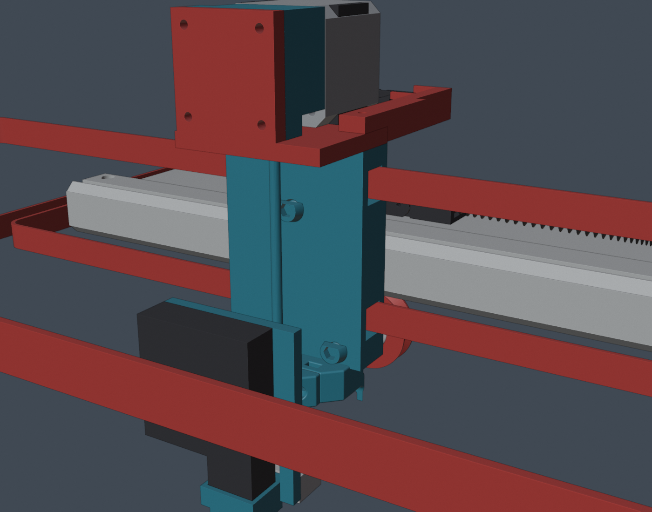
trab/imagens/guia_v/carroX_frente.png
