WHdragon770/mulbot-corexy/trab/imagens/guia_v/carroX_tras.png

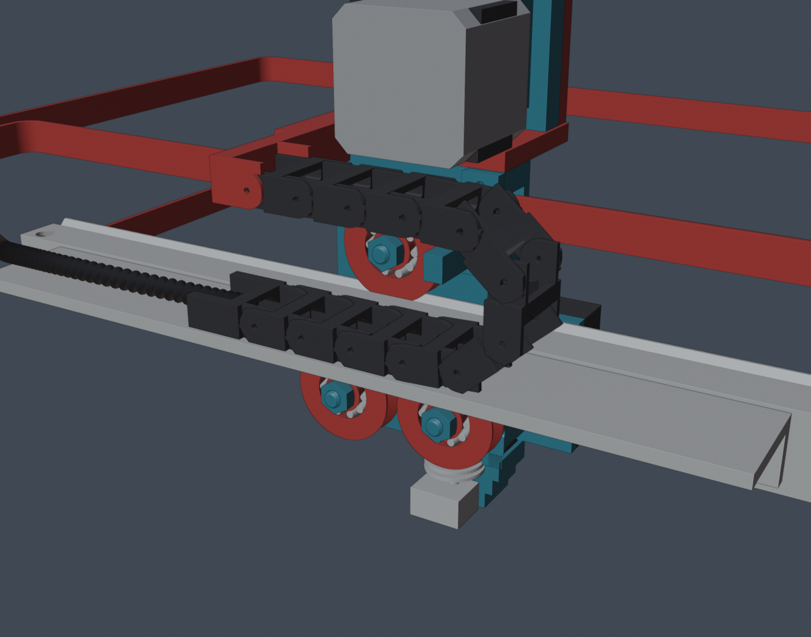
trab/imagens/guia_v/carroX_tras.png
