WHdragon770/mulbot-corexy/trab/imagens/guia_v/carroY_dentro.png

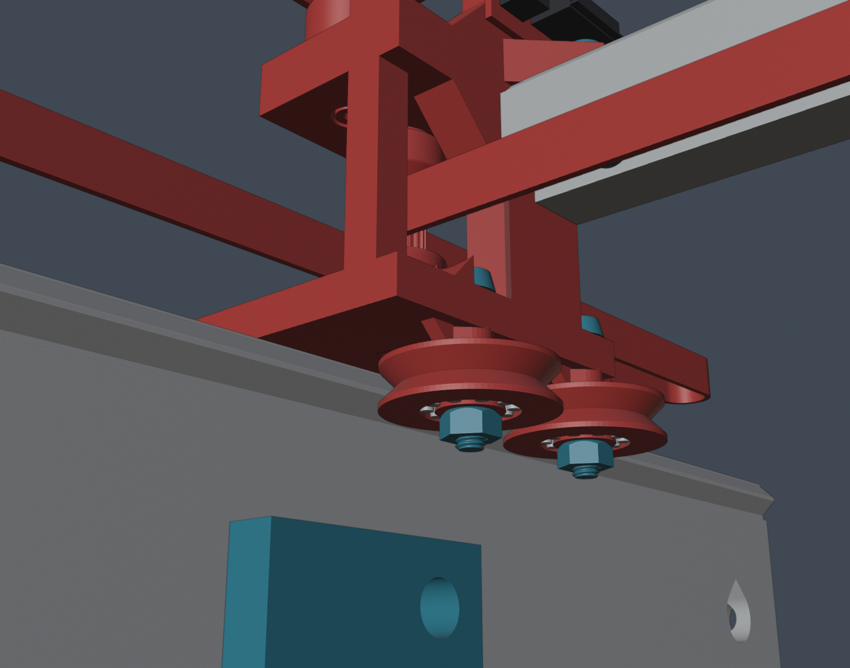
trab/imagens/guia_v/carroY_dentro.png
