WHdragon770/mulbot-corexy/trab/imagens/guia_v/carroY_fora.png

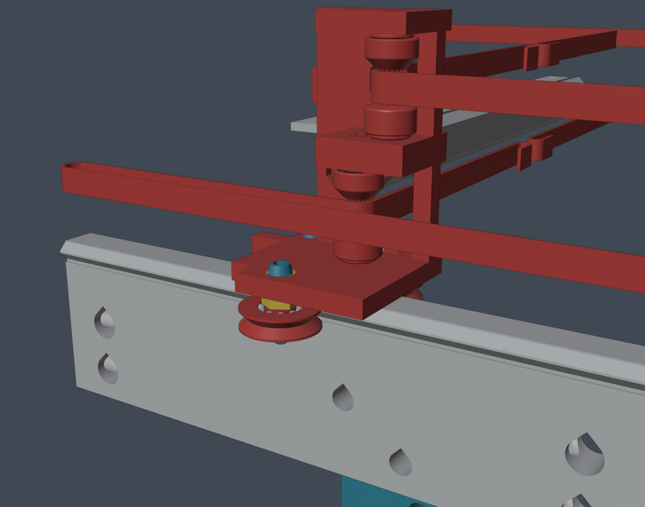
trab/imagens/guia_v/carroY_fora.png
