WHdragon770/mulbot-corexy/trab/imagens/guia_v/eixoZ_dentro.png

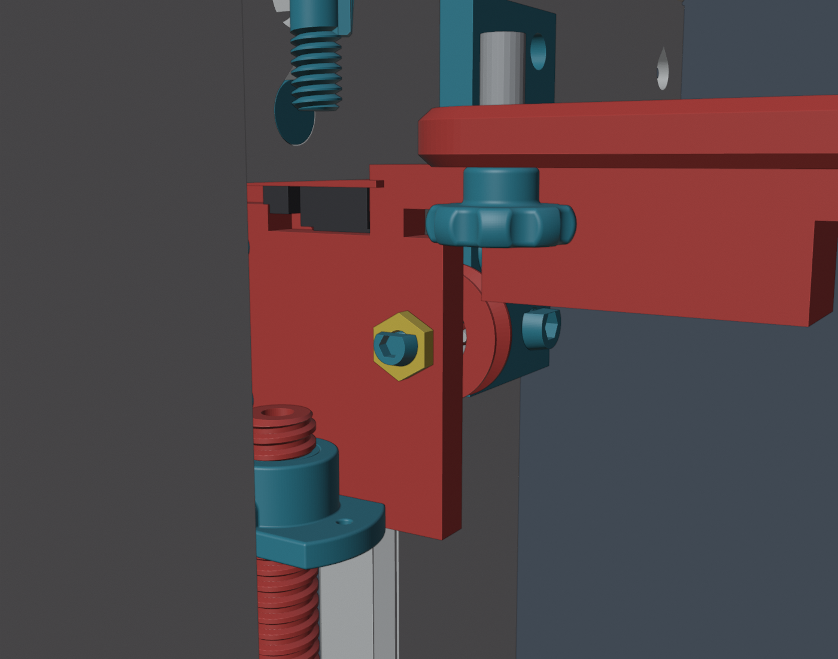
trab/imagens/guia_v/eixoZ_dentro.png
