WHdragon770/mulbot-corexy/trab/imagens/guia_v/eixoZ_frente.png

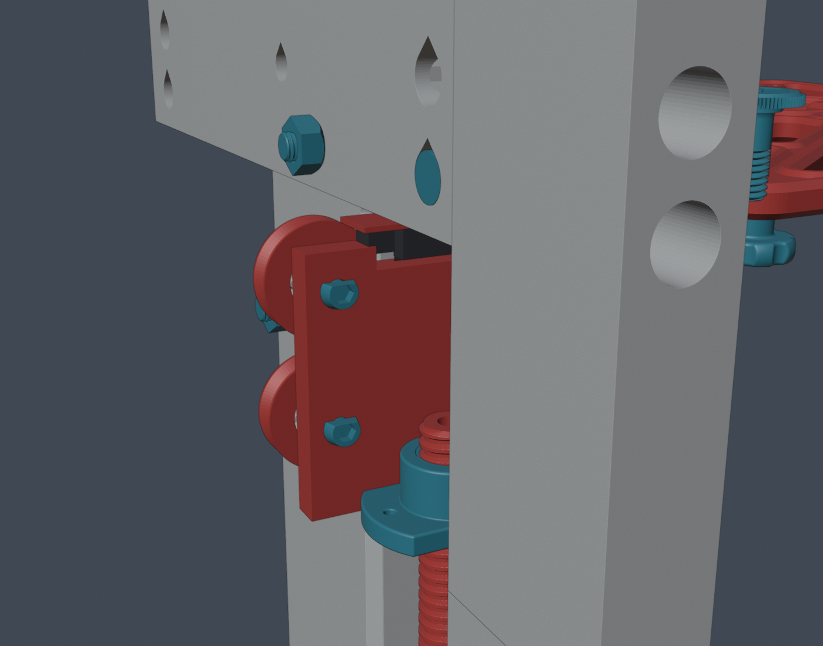
trab/imagens/guia_v/eixoZ_frente.png
