WHdragon770/mulbot-corexy/corexy100/entrega/02 STL para imprimir/lista_de_impressao.csv

pasta | peca | qtd | material | origem | impresso
01 Quadro | DL1-01-08 | 6 | FDM | Mulbot original
01 Quadro | baseFrente_D | 1 | FDM | nova
01 Quadro | baseFrente_E | 1 | FDM | nova
01 Quadro | baseLatT_D | 1 | FDM | nova
01 Quadro | baseLatT_E | 1 | FDM | nova
01 Quadro | baseTras_D | 1 | FDM | nova
01 Quadro | baseTras_E | 1 | FDM | nova
01 Quadro | posteFrenteInf_D | 1 | FDM | nova
01 Quadro | posteFrenteInf_E | 1 | FDM | nova
01 Quadro | posteFrenteSup_D | 1 | FDM | nova
01 Quadro | posteFrenteSup_E | 1 | FDM | nova
01 Quadro | posteTrasInf_D | 1 | FDM | nova
01 Quadro | posteTrasInf_E | 1 | FDM | nova
01 Quadro | posteTrasSup_D | 1 | FDM | nova
01 Quadro | posteTrasSup_E | 1 | FDM | nova
01 Quadro | torreFrente_D | 1 | FDM | nova
01 Quadro | torreFrente_E | 1 | FDM | nova
01 Quadro | torreTras_D | 1 | FDM | nova
01 Quadro | torreTras_E | 1 | FDM | nova
01 Quadro | travFrente_D | 1 | FDM | nova
01 Quadro | travFrente_E | 1 | FDM | nova
01 Quadro | travTras_D | 1 | FDM | nova
01 Quadro | travTras_E | 1 | FDM | nova
02 Eixo Y e portico | suportePortico_D | 1 | FDM | nova
02 Eixo Y e portico | suportePortico_E | 1 | FDM | nova
02 Eixo Y e portico | trilhoY_D | 1 | FDM | nova
02 Eixo Y e portico | trilhoY_E | 1 | FDM | nova
03 Eixo X e cabeca | DL1-04-07 | 1 | FDM | Mulbot original
03 Eixo X e cabeca | bracoFimCursoX | 1 | FDM | nova
03 Eixo X e cabeca | carroX | 1 | FDM | nova
03 Eixo X e cabeca | dutoCoreXY | 1 | FDM | nova
03 Eixo X e cabeca | suporteExtrusoraDireta | 1 | FDM | nova
03 Eixo X e cabeca | trilhoX | 1 | FDM | nova
04 Eixo Z e mesa | DL1-03-04_110 | 1 | FDM | Mulbot modificada
04 Eixo Z e mesa | DL1-03-05 | 4 | FDM | Mulbot original
04 Eixo Z e mesa | DL1-03-08 | 4 | FDM | Mulbot original
04 Eixo Z e mesa | baseZInf_D | 1 | FDM | nova
04 Eixo Z e mesa | baseZInf_E | 1 | FDM | nova
04 Eixo Z e mesa | baseZSup_D | 1 | FDM | nova
04 Eixo Z e mesa | baseZSup_E | 1 | FDM | nova
04 Eixo Z e mesa | bracoMesa_D | 1 | FDM | nova
04 Eixo Z e mesa | bracoMesa_E | 1 | FDM | nova
04 Eixo Z e mesa | calcoFimCursoZ | 1 | FDM | nova
04 Eixo Z e mesa | chapaZY_D | 1 | FDM | nova
04 Eixo Z e mesa | chapaZY_E | 1 | FDM | nova
04 Eixo Z e mesa | localizador_aq120 | 4 | FDM | nova
04 Eixo Z e mesa | presilha_disco_aq | 4 | FDM | nova
04 Eixo Z e mesa | trilhoZ_D | 1 | FDM | nova
04 Eixo Z e mesa | trilhoZ_E | 1 | FDM | nova
04 Eixo Z e mesa/Fuso e porca - FDM | fusoZ_250mm | 2 | FDM | nova
04 Eixo Z e mesa/Fuso e porca - FDM | porcaZ_DL1-04-06_rosca_nova | 2 | FDM | nova
04 Eixo Z e mesa/Fuso e porca - Resina (alternativa) | fusoZ_metade_baixo_125mm | 2 | Resina | nova
04 Eixo Z e mesa/Fuso e porca - Resina (alternativa) | fusoZ_metade_cima_125mm | 2 | Resina | nova
04 Eixo Z e mesa/Fuso e porca - Resina (alternativa) | fusoZ_pino_D | 2 | Resina | nova
04 Eixo Z e mesa/Fuso e porca - Resina (alternativa) | porcaZ_DL1-04-06_rosca_nova | 2 | Resina | nova
05 Motores e polias | DL1-04-08 | 2 | FDM | Mulbot original
05 Motores e polias | DL1-06-01 | 8 | FDM | Mulbot original
05 Motores e polias | DL1-06-02_L10.0 | 4 | FDM | Mulbot modificada
05 Motores e polias | DL1-06-02_L14.0 | 4 | FDM | Mulbot modificada
05 Motores e polias | DL1-06-03_L10.0 | 4 | FDM | Mulbot modificada
05 Motores e polias | DL1-06-03_L14.0 | 4 | FDM | Mulbot modificada
05 Motores e polias | DL1-06-04 | 16 | FDM | Mulbot original
06 Eletronica e display | DL1-02-09_caixa_ramps | 1 | FDM | Mulbot original
06 Eletronica e display | DL1-02-10_porta_fechada | 1 | FDM | Mulbot original
06 Eletronica e display | DL1-02-11 | 1 | FDM | Mulbot original
06 Eletronica e display | DL1-02-15 | 1 | FDM | Mulbot original
06 Eletronica e display | DL1-05-01_cabo | 1 | FDM | Mulbot modificada
06 Eletronica e display | DL1-05-02 | 1 | FDM | Mulbot original
06 Eletronica e display | DL1-05-03 | 1 | FDM | Mulbot original
06 Eletronica e display | DL1-05-04 | 1 | FDM | Mulbot original
06 Eletronica e display | DL1-05-05 | 1 | FDM | Mulbot original
07 Roldanas V (X, Y e Z) - Resina | buchaX_excentrica_espacador | 1 | Resina | nova
07 Roldanas V (X, Y e Z) - Resina | buchaY_excentrica_espacador | 2 | Resina | nova
07 Roldanas V (X, Y e Z) - Resina | buchaZ_excentrica | 2 | Resina | nova
07 Roldanas V (X, Y e Z) - Resina | roldanaV_rolamento_1peca_resina | 15 | Resina | nova
08 Parafusos e porcas impressos | barril_M10_D14x19 | 8 | FDM | nova
08 Parafusos e porcas impressos | barril_M10_D14x30 | 8 | FDM | nova
08 Parafusos e porcas impressos | barril_M6_D9x10 | 2 | FDM | nova
08 Parafusos e porcas impressos | barril_M6_D9x16 | 8 | FDM | nova
08 Parafusos e porcas impressos | barril_M6_D9x19 | 4 | FDM | nova
08 Parafusos e porcas impressos | parafuso_M10x40 | 24 | FDM | nova
08 Parafusos e porcas impressos | parafuso_M10x45 | 6 | FDM | nova
08 Parafusos e porcas impressos | parafuso_M10x55 | 14 | FDM | nova
08 Parafusos e porcas impressos | parafuso_M10x60 | 4 | FDM | nova
08 Parafusos e porcas impressos | parafuso_M6x22 | 2 | FDM | nova
08 Parafusos e porcas impressos | parafuso_M6x30 | 14 | FDM | nova
08 Parafusos e porcas impressos | parafuso_M6x35 | 10 | FDM | nova
08 Parafusos e porcas impressos | parafuso_M6x40 | 3 | FDM | nova
08 Parafusos e porcas impressos | parafuso_M6x45 | 4 | FDM | nova
08 Parafusos e porcas impressos | parafuso_M6x50 | 4 | FDM | nova
08 Parafusos e porcas impressos | parafuso_M6x60 | 2 | FDM | nova
08 Parafusos e porcas impressos | parafuso_M6x65 | 4 | FDM | nova
08 Parafusos e porcas impressos | parafuso_M6x70 | 2 | FDM | nova
08 Parafusos e porcas impressos | porca_M10 | 32 | FDM | nova
08 Parafusos e porcas impressos | porca_M6 | 31 | FDM | nova
09 Esteira porta-cabos | bandejaX | 1 | FDM | nova
09 Esteira porta-cabos | bandejaY_F | 1 | FDM | nova
09 Esteira porta-cabos | bandejaY_T | 1 | FDM | nova
09 Esteira porta-cabos | bracoEsteiraX | 1 | FDM | nova
09 Esteira porta-cabos | elo_esteira | 17 | FDM | nova
09 Esteira porta-cabos | pontaFixa_esteira | 2 | FDM | nova
09 Esteira porta-cabos | suporteEsteiraY | 1 | FDM | nova
