WHdragon770/mulbot-corexy/corexy100/benchy/3DBenchy.stl

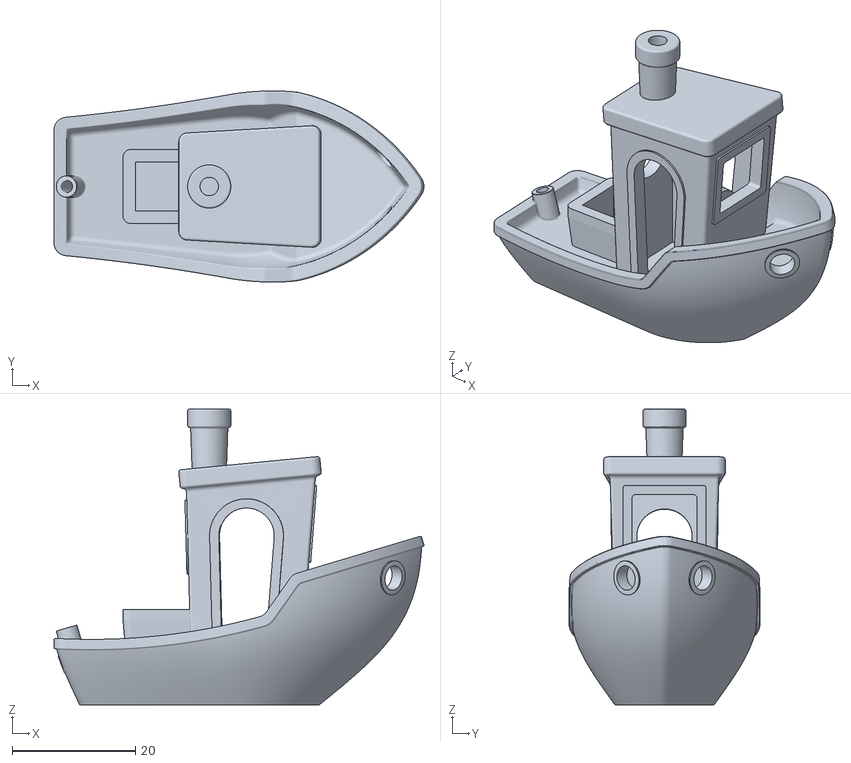
[picture p112: CAD file, 2026-10-27]
corexy100/benchy/3DBenchy.stl
60.0 x 31.0 x 48.0
