WHdragon770/mulbot-corexy/corexy100/entrega/02 STL para imprimir/01 Quadro/posteTrasInf_D [1x].stl

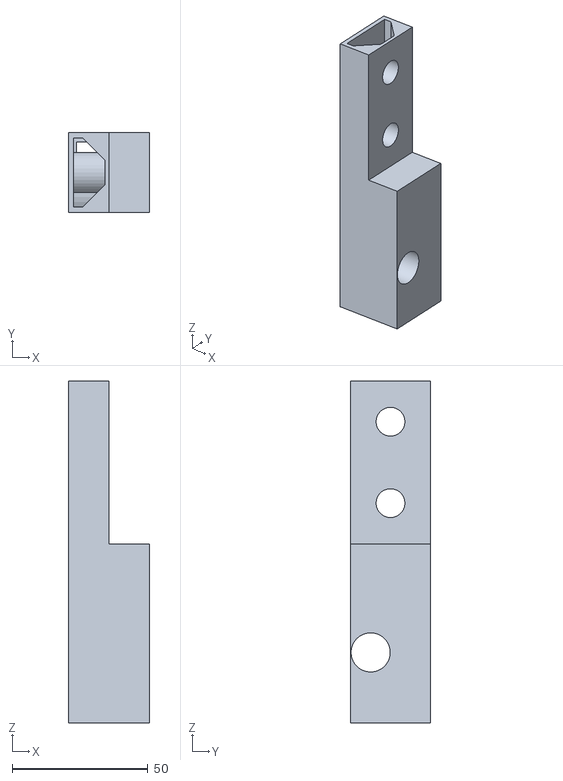
[picture p113: CAD file, 2026-10-28]
corexy100/entrega/02 STL para imprimir/01 Quadro/posteTrasInf_D [1x].stl
30.0 x 29.4 x 126.0
