WHdragon770/mulbot-corexy/corexy100/entrega/02 STL para imprimir/02 Eixo Y e portico/trilhoY_E [1x].stl

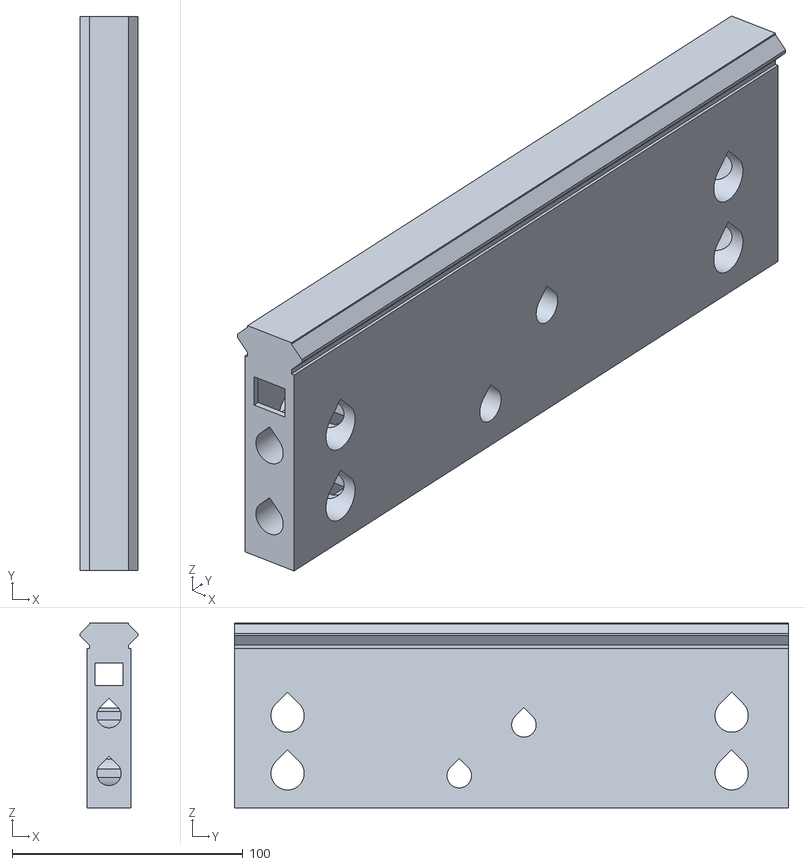
[picture p114: CAD file, 2026-10-27]
corexy100/entrega/02 STL para imprimir/02 Eixo Y e portico/trilhoY_E [1x].stl
25.0 x 240.0 x 80.1
