WHdragon770/mulbot-corexy/corexy100/entrega/02 STL para imprimir/03 Eixo X e cabeca/dutoCoreXY [1x].stl

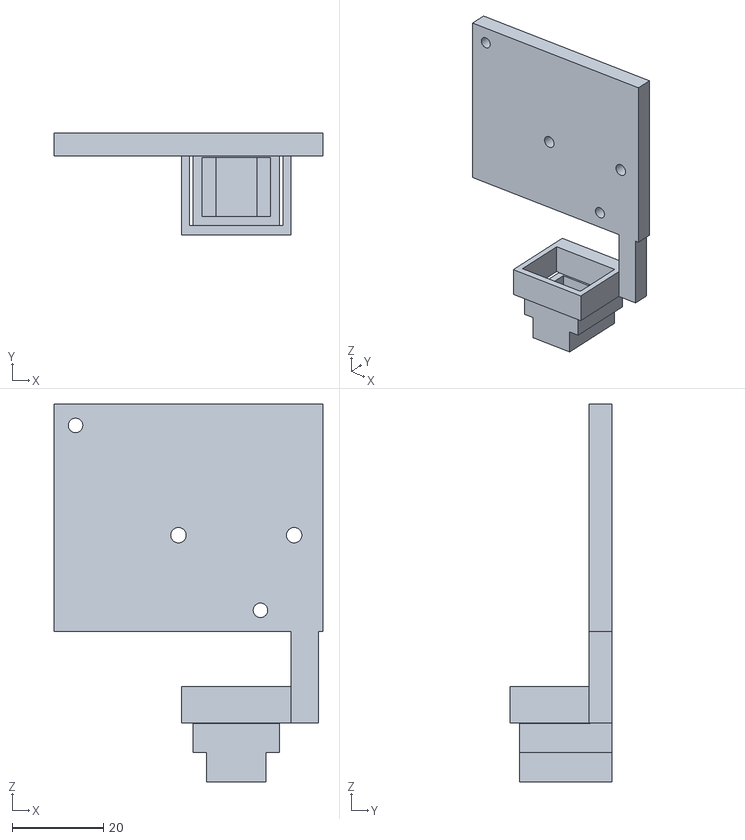
[picture p115: CAD file, 2026-10-27]
corexy100/entrega/02 STL para imprimir/03 Eixo X e cabeca/dutoCoreXY [1x].stl
59.0 x 22.3 x 83.0
