WHdragon770/mulbot-corexy/corexy100/entrega/02 STL para imprimir/04 Eixo Z e mesa/bracoMesa_D [1x].stl

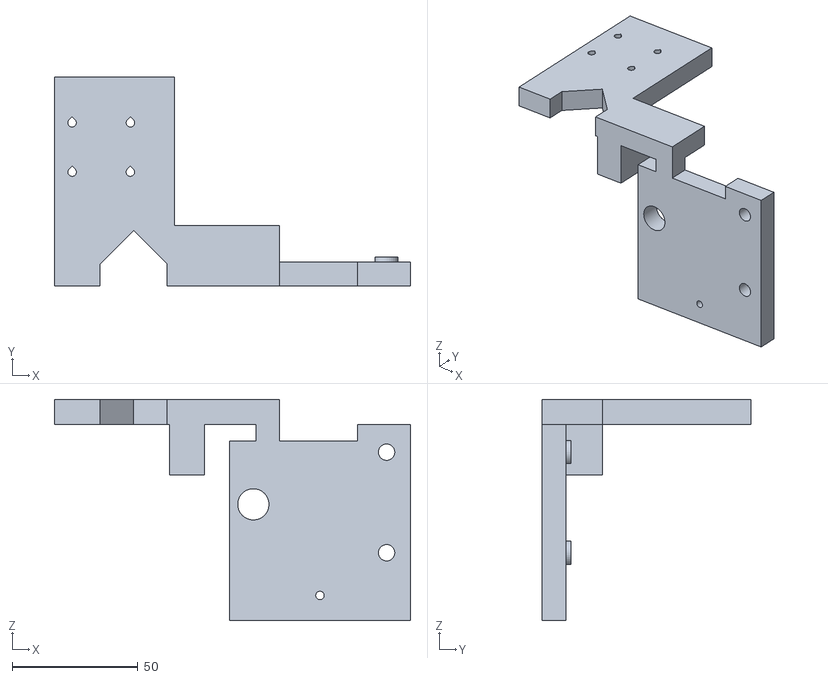
[picture p116: CAD file, 2026-10-28]
corexy100/entrega/02 STL para imprimir/04 Eixo Z e mesa/bracoMesa_D [1x].stl
141.6 x 83.1 x 88.0
