WHdragon770/mulbot-corexy/corexy100/entrega/02 STL para imprimir/04 Eixo Z e mesa/Fuso e porca - FDM/fusoZ_250mm [2x].stl

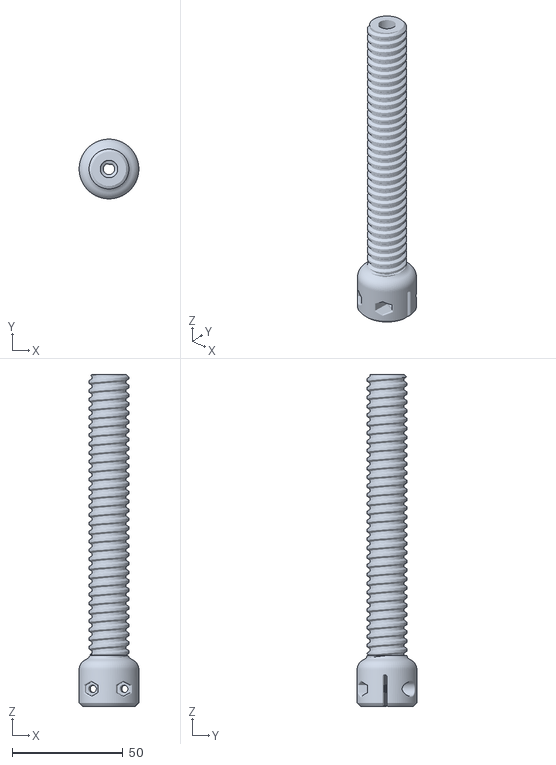
[picture p117: CAD file, 2026-10-27]
corexy100/entrega/02 STL para imprimir/04 Eixo Z e mesa/Fuso e porca - FDM/fusoZ_250mm [2x].stl
27.0 x 27.0 x 150.0
