WHdragon770/mulbot-corexy/corexy100/entrega/02 STL para imprimir/05 Motores e polias/DL1-06-02_L14.0 [4x].stl

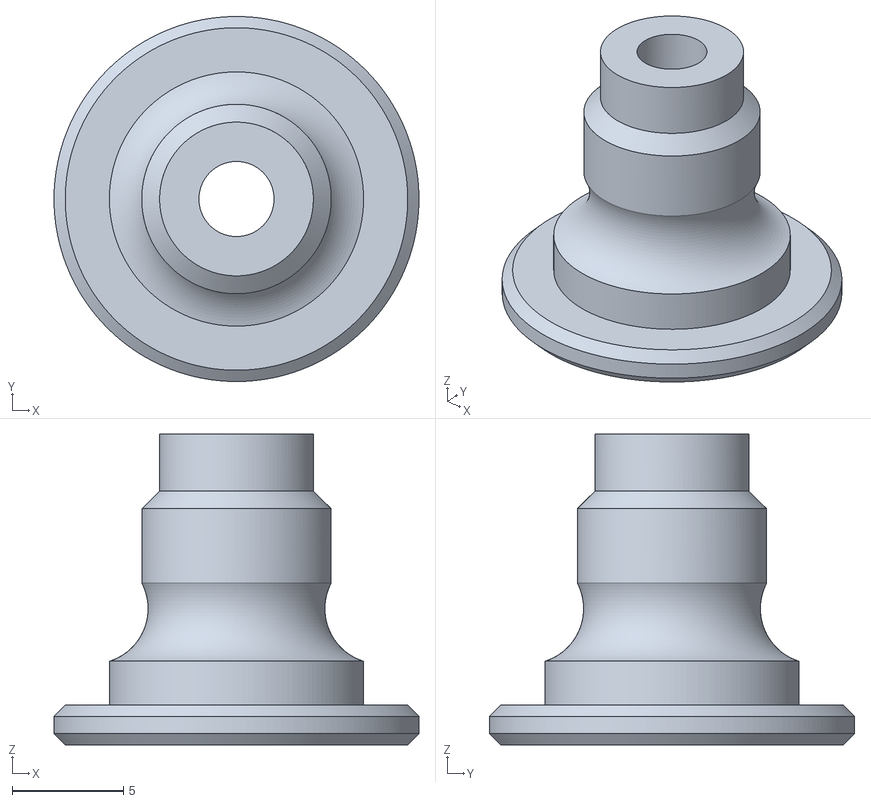
[picture p118: CAD file, 2026-10-20]
corexy100/entrega/02 STL para imprimir/05 Motores e polias/DL1-06-02_L14.0 [4x].stl
16.4 x 16.4 x 14.0
