WHdragon770/mulbot-corexy/corexy100/entrega/02 STL para imprimir/06 Eletronica e display/DL1-05-01_cabo [1x].stl

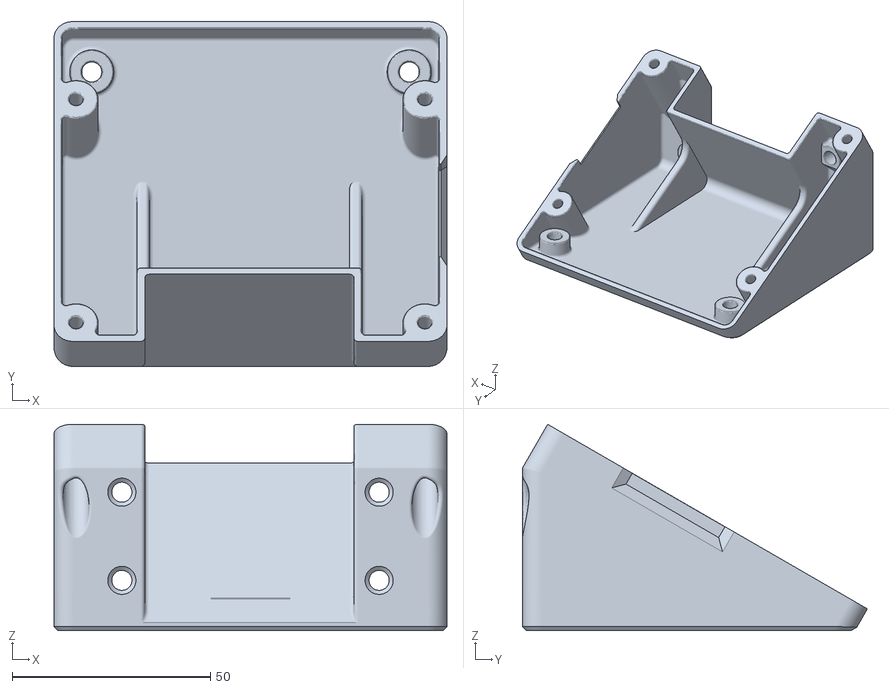
[picture p119: CAD file, 2026-10-27]
corexy100/entrega/02 STL para imprimir/06 Eletronica e display/DL1-05-01_cabo [1x].stl
99.1 x 86.9 x 52.0
