WHdragon770/mulbot-corexy/corexy100/entrega/02 STL para imprimir/09 Esteira porta-cabos/bracoEsteiraX [1x].stl

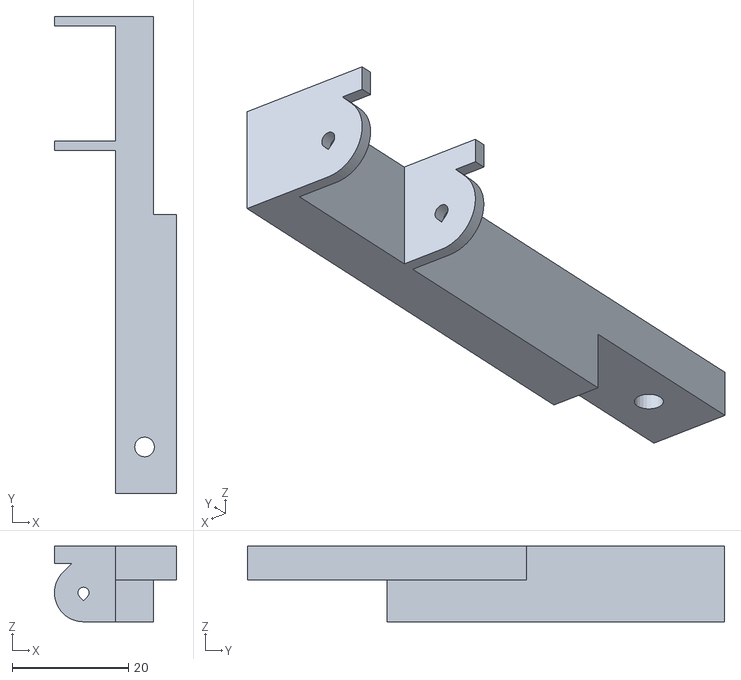
[picture p121: CAD file, 2026-10-27]
corexy100/entrega/02 STL para imprimir/09 Esteira porta-cabos/bracoEsteiraX [1x].stl
21.0 x 82.0 x 13.0
