WHdragon770/mulbot-corexy/corexy100/entrega/06 Placas de impressao/Kobra X (3MF)/03 Eixo X e cabeca - PLA.3mf

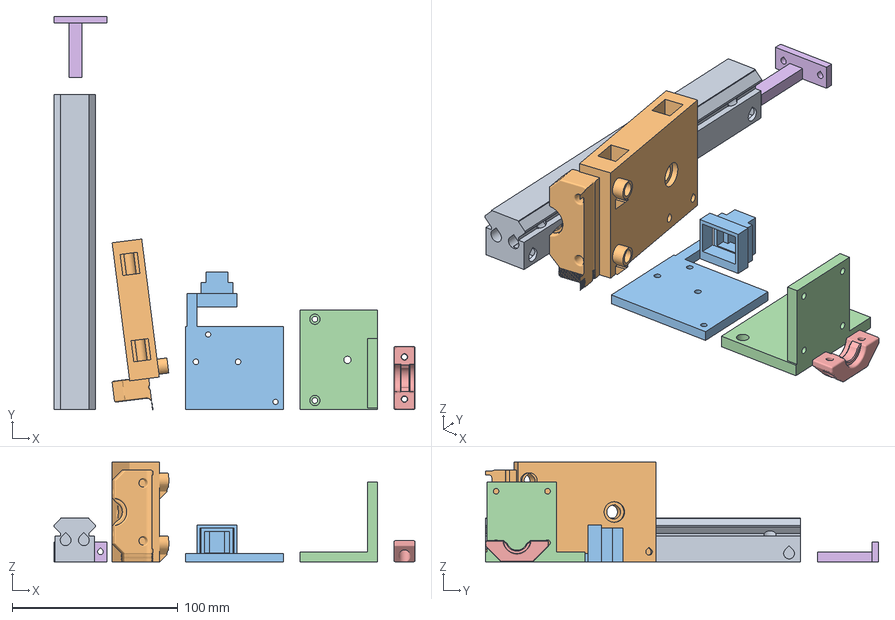
[picture p122: CAD file, 2026-10-28]
corexy100/entrega/06 Placas de impressao/Kobra X (3MF)/03 Eixo X e cabeca - PLA.3mf
217.5 x 237.0 x 60.0 mm
trilhoX
carroX
dutoCoreXY
suporteExtrusoraDireta
DL1-04-07
bracoFimCursoX
