WHdragon770/mulbot-corexy/corexy100/entrega/06 Placas de impressao/Resina (Photon)/Alternativa - fuso Z em resina/fusoZ_metade_baixo_125mm [2x].stl

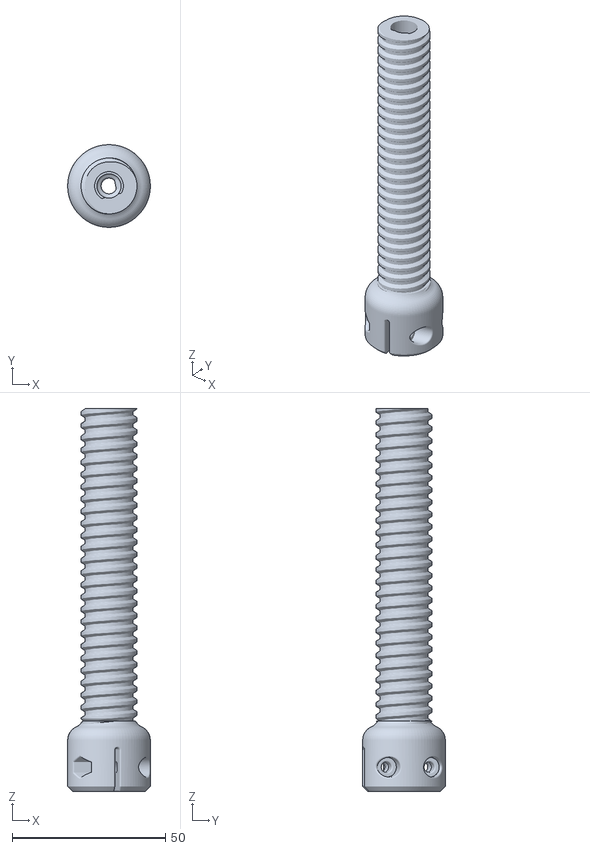
[picture p123: CAD file, 2026-10-28]
corexy100/entrega/06 Placas de impressao/Resina (Photon)/Alternativa - fuso Z em resina/fusoZ_metade_baixo_125mm [2x].stl
27.0 x 27.0 x 125.0
