WHdragon770/mulbot-corexy/corexy100/entrega/06 Placas de impressao/Resina (Photon)/PLACA PRONTA - 15 roldanas + 5 buchas (M7 Pro).stl

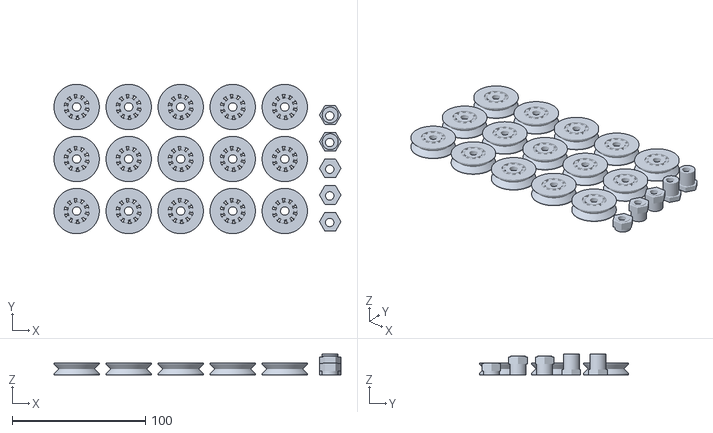
[picture p124: CAD file, 2026-10-28]
corexy100/entrega/06 Placas de impressao/Resina (Photon)/PLACA PRONTA - 15 roldanas + 5 buchas (M7 Pro).stl
215.2 x 112.0 x 15.5
