WHdragon770/mulbot-corexy/corexy100/guia_v/stl/exp_roldana.stl

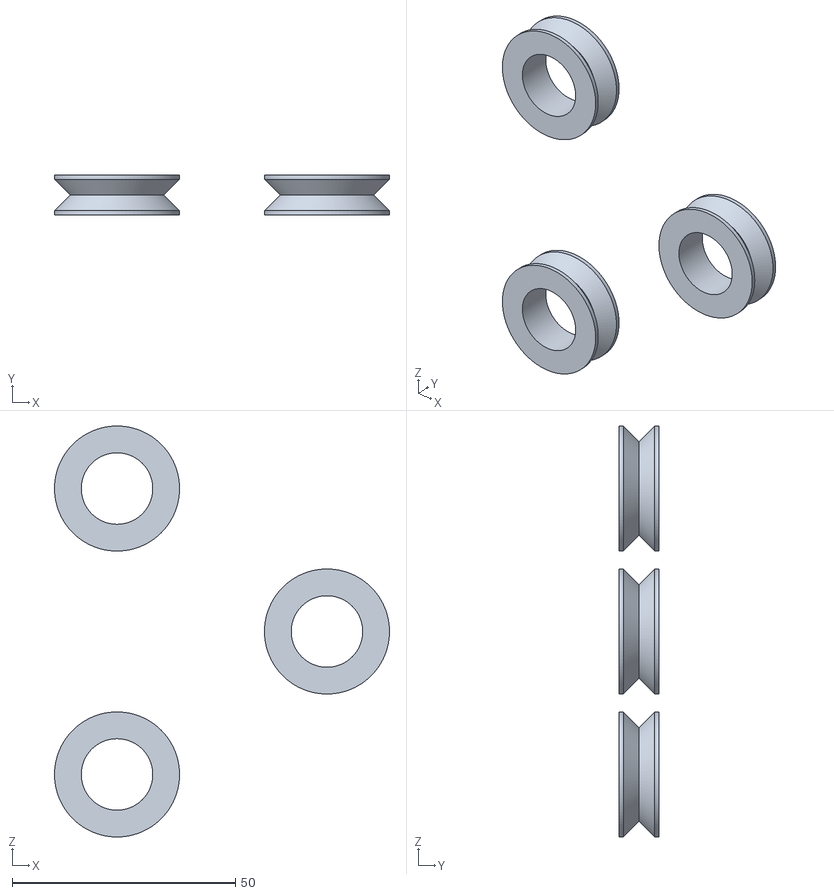
[picture p126: CAD file, 2026-10-30]
corexy100/guia_v/stl/exp_roldana.stl
75.0 x 9.00 x 92.0
