WHdragon770/mulbot-corexy/corexy100/out/anim/cabos/fimCursoY.stl

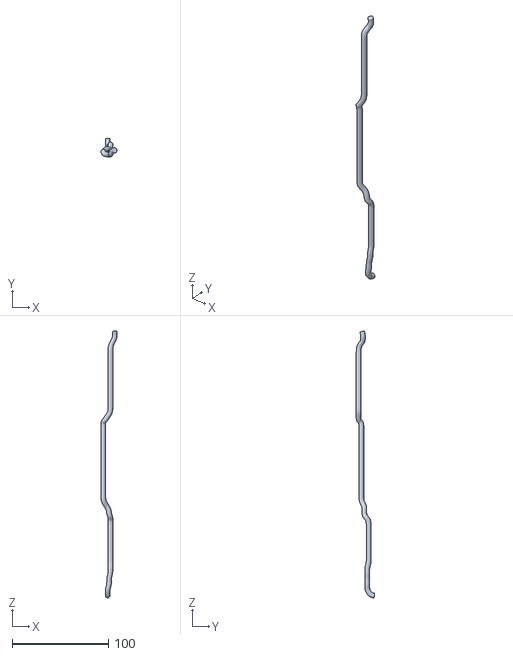
[picture p127: CAD file, 2026-10-27]
corexy100/out/anim/cabos/fimCursoY.stl
16.8 x 19.3 x 277.9
