WHdragon770/mulbot-corexy/corexy100/out/anim/poses/caboEsteira_Y_002.stl

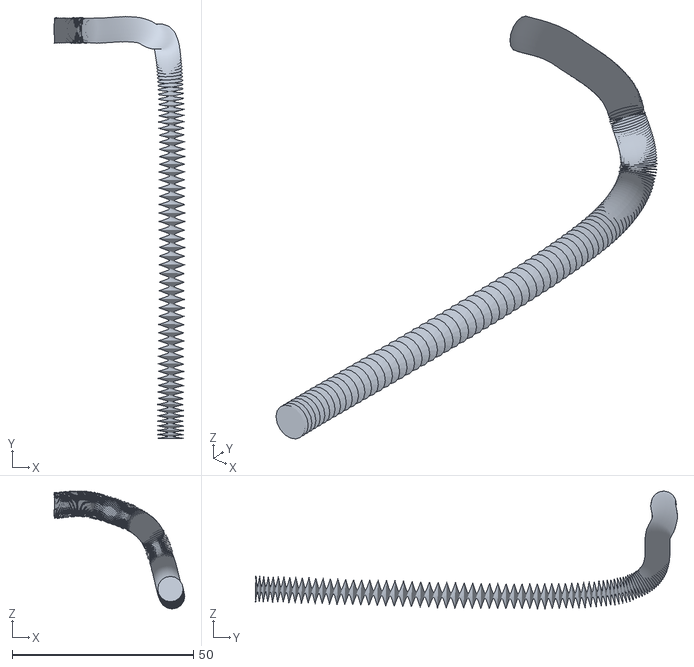
[picture p128: CAD file, 2026-10-27]
corexy100/out/anim/poses/caboEsteira_Y_002.stl
36.0 x 116.3 x 32.5
