WHdragon770/mulbot-corexy/entrega/02 STL para imprimir/04 Eixo Z e mesa/Fuso e porca - FDM/fusoZ_250mm [2x].stl

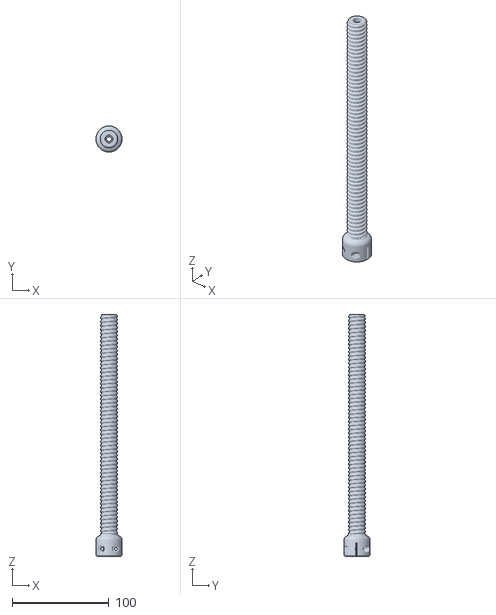
[picture p129: CAD file, 2026-10-20]
entrega/02 STL para imprimir/04 Eixo Z e mesa/Fuso e porca - FDM/fusoZ_250mm [2x].stl
27.0 x 27.0 x 250.0
