WHdragon770/mulbot-corexy/entrega/02b STL para imprimir na 100/00 Pinos/pino 2x9.4 mm [4x].stl

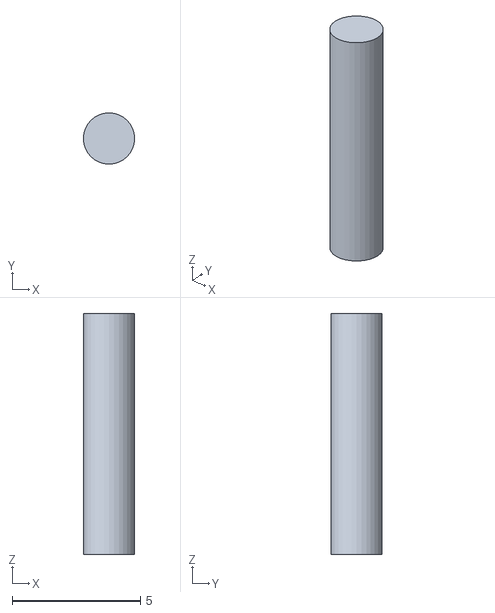
[picture p130: CAD file, 2026-10-27]
entrega/02b STL para imprimir na 100/00 Pinos/pino 2x9.4 mm [4x].stl
2.00 x 2.00 x 9.40
