WHdragon770/mulbot-corexy/entrega/02b STL para imprimir na 100/01 Quadro/baseFrente_E parte 3de3 [1x].stl

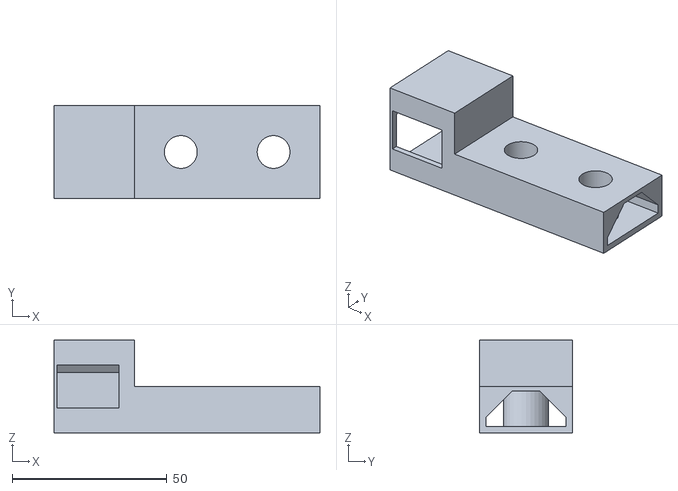
[picture p131: CAD file, 2026-10-27]
entrega/02b STL para imprimir na 100/01 Quadro/baseFrente_E parte 3de3 [1x].stl
86.0 x 30.0 x 30.0
