WHdragon770/mulbot-corexy/entrega/02b STL para imprimir na 100/04 Eixo Z e mesa/DL1-03-04_110 parte 3de9 [1x].stl

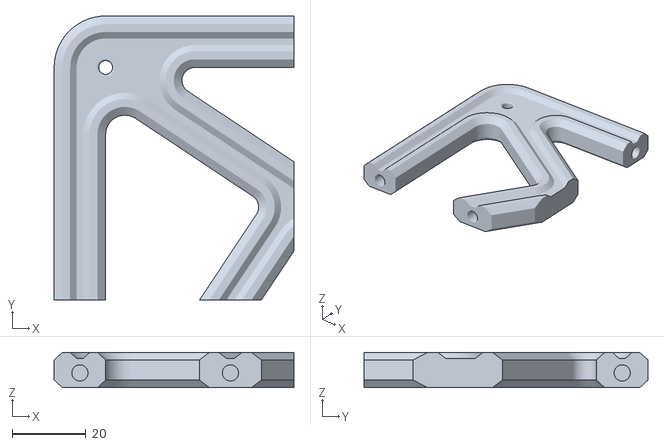
[picture p134: CAD file, 2026-10-27]
entrega/02b STL para imprimir na 100/04 Eixo Z e mesa/DL1-03-04_110 parte 3de9 [1x].stl
65.0 x 77.0 x 9.53
