WHdragon770/mulbot-corexy/entrega/02b STL para imprimir na 100/06 Eletronica e display/DL1-02-09_caixa_ramps parte 5de6 [1x].stl

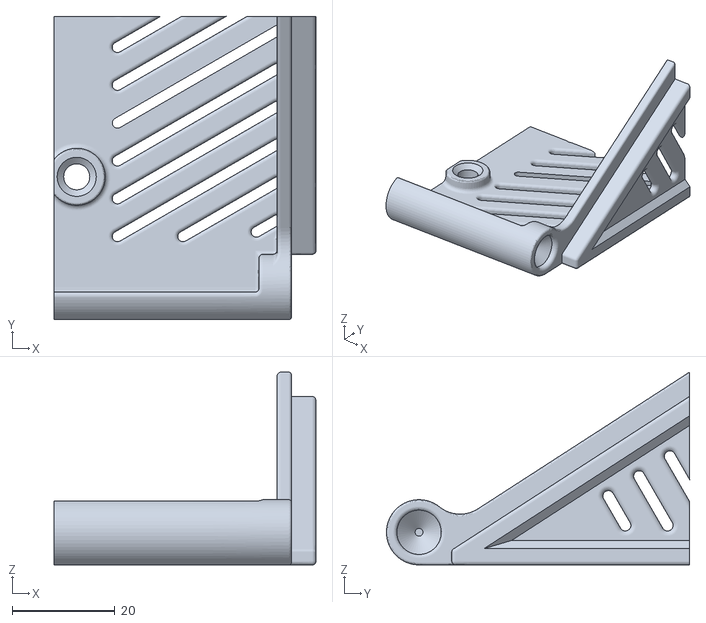
[picture p136: CAD file, 2026-10-27]
entrega/02b STL para imprimir na 100/06 Eletronica e display/DL1-02-09_caixa_ramps parte 5de6 [1x].stl
51.0 x 59.0 x 37.5
