WHdragon770/mulbot-corexy/entrega/02b STL para imprimir na 100/09 Esteira porta-cabos/bandejaX parte 3de3 [1x].stl

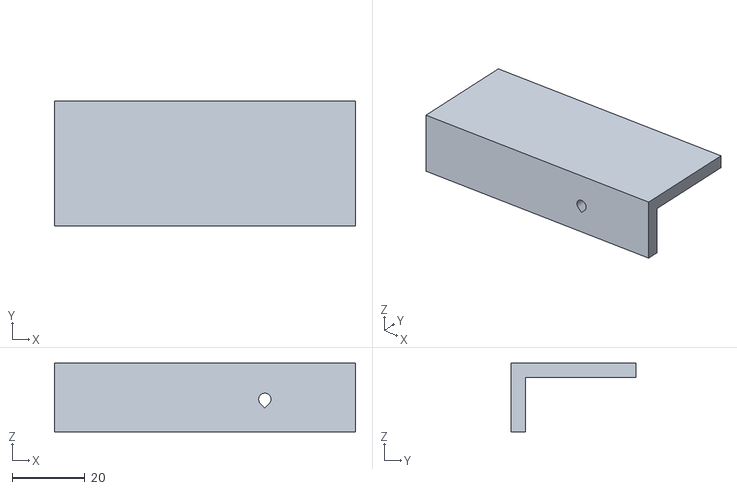
[picture p137: CAD file, 2026-10-27]
entrega/02b STL para imprimir na 100/09 Esteira porta-cabos/bandejaX parte 3de3 [1x].stl
83.0 x 34.5 x 19.0
