WHdragon770/mulbot-corexy/entrega/07 Mesa aquecida (opcional)/220 - 12V/STL para imprimir/presilha_disco_aq [4x].stl

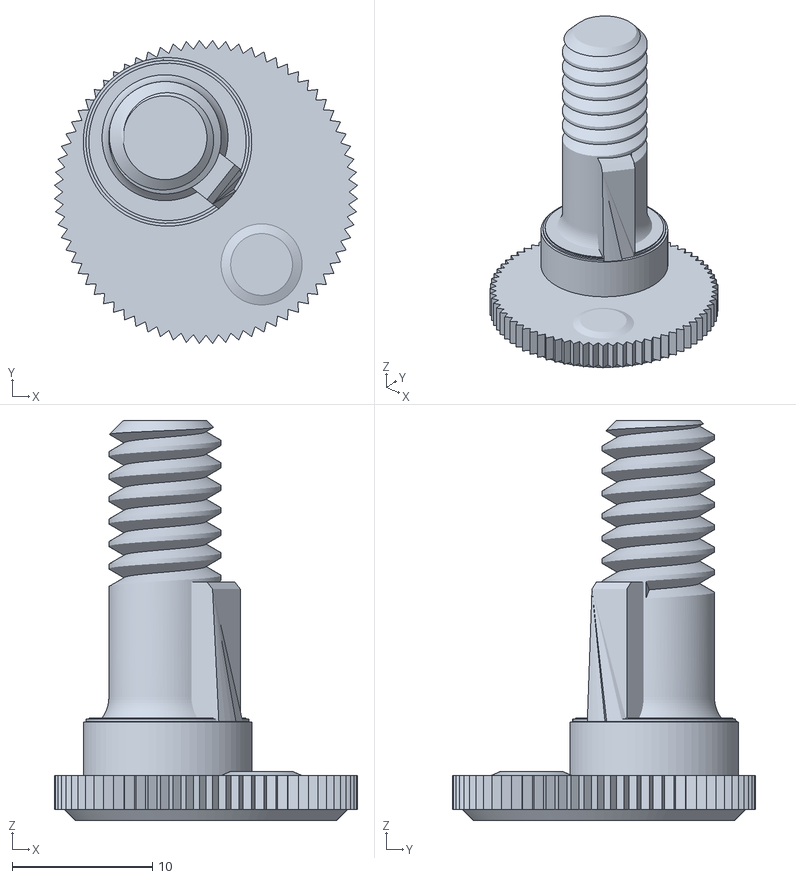
[picture p138: CAD file, 2026-10-21]
entrega/07 Mesa aquecida (opcional)/220 - 12V/STL para imprimir/presilha_disco_aq [4x].stl
21.6 x 21.6 x 28.5
