WHdragon770/mulbot-corexy/guia_v/stl/mont_bucha.stl

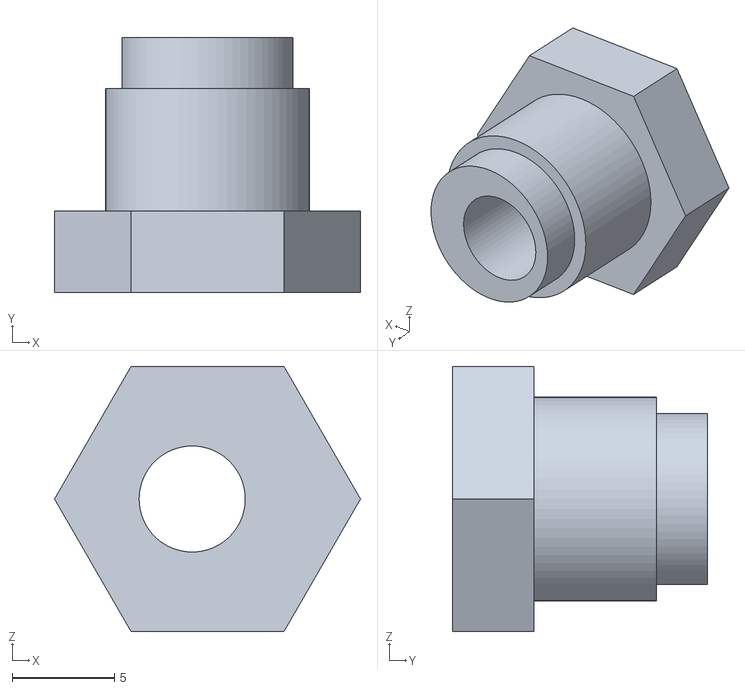
[picture p139: CAD file, 2026-10-30]
guia_v/stl/mont_bucha.stl
15.0 x 12.5 x 13.0
