WHdragon770/mulbot-corexy/out/anim/cabos/motorZ_E.stl

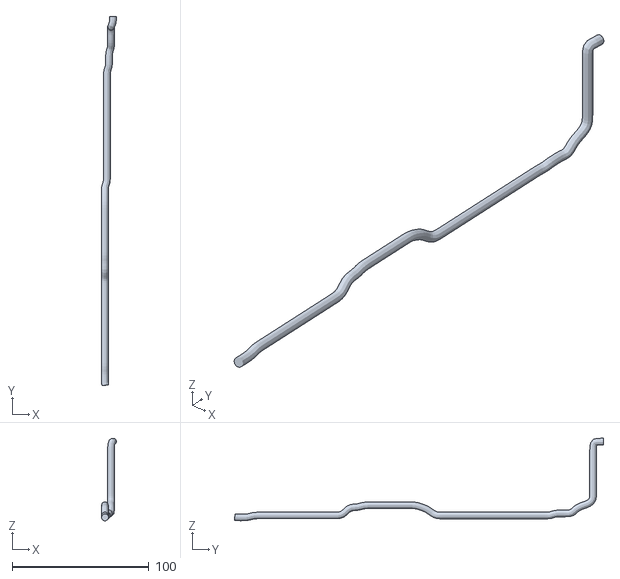
[picture p140: CAD file, 2026-10-28]
out/anim/cabos/motorZ_E.stl
11.0 x 269.7 x 60.3
