WHdragon770/mulbot-corexy/out/anim/poses/caboEsteira_XY_028.stl

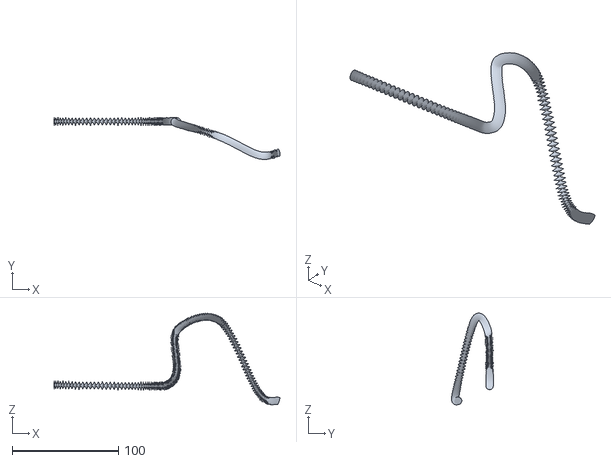
[picture p141: CAD file, 2026-10-28]
out/anim/poses/caboEsteira_XY_028.stl
212.2 x 39.4 x 86.2
