WHdragon770/mulbot-corexy/corexy100/benchy/peca200_baseFrente_D_parte1.stl

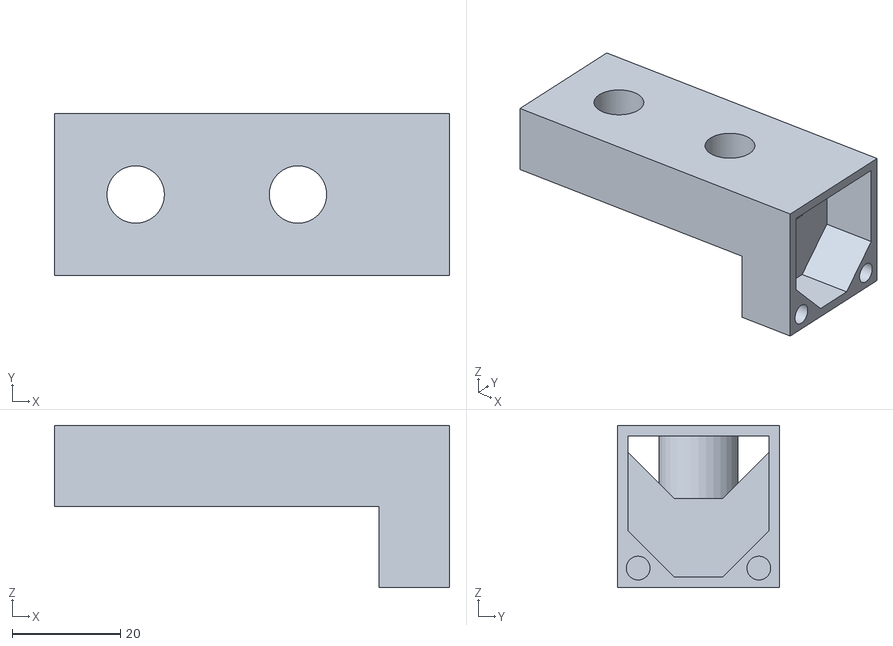
[picture p142: CAD file, 2026-10-27]
corexy100/benchy/peca200_baseFrente_D_parte1.stl
73.0 x 30.0 x 30.0
