WHdragon770/mulbot-corexy/corexy100/entrega/02 STL para imprimir/01 Quadro/baseFrente_D [1x].stl

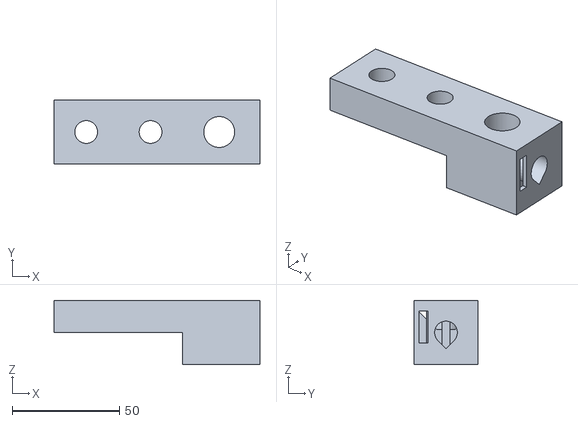
[picture p143: CAD file, 2026-10-28]
corexy100/entrega/02 STL para imprimir/01 Quadro/baseFrente_D [1x].stl
96.0 x 30.0 x 30.0
