WHdragon770/mulbot-corexy/corexy100/entrega/02 STL para imprimir/03 Eixo X e cabeca/suporteExtrusoraDireta [1x].stl

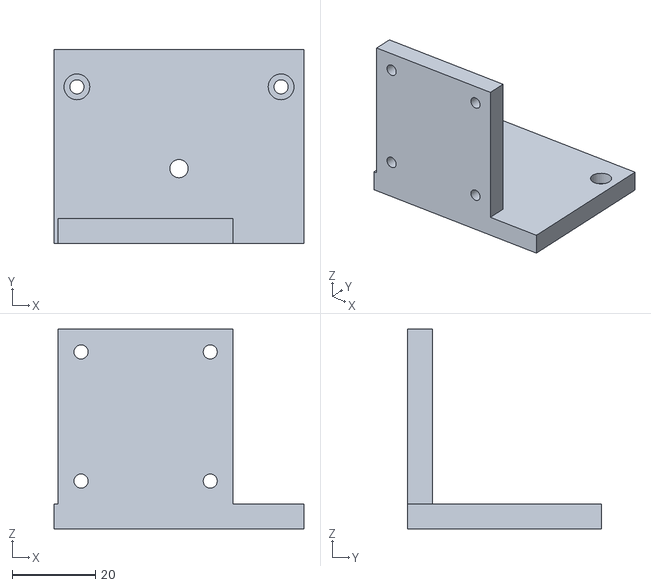
[picture p145: CAD file, 2026-10-27]
corexy100/entrega/02 STL para imprimir/03 Eixo X e cabeca/suporteExtrusoraDireta [1x].stl
60.0 x 46.6 x 48.0
