WHdragon770/mulbot-corexy/corexy100/entrega/02 STL para imprimir/04 Eixo Z e mesa/baseZInf_D [1x].stl

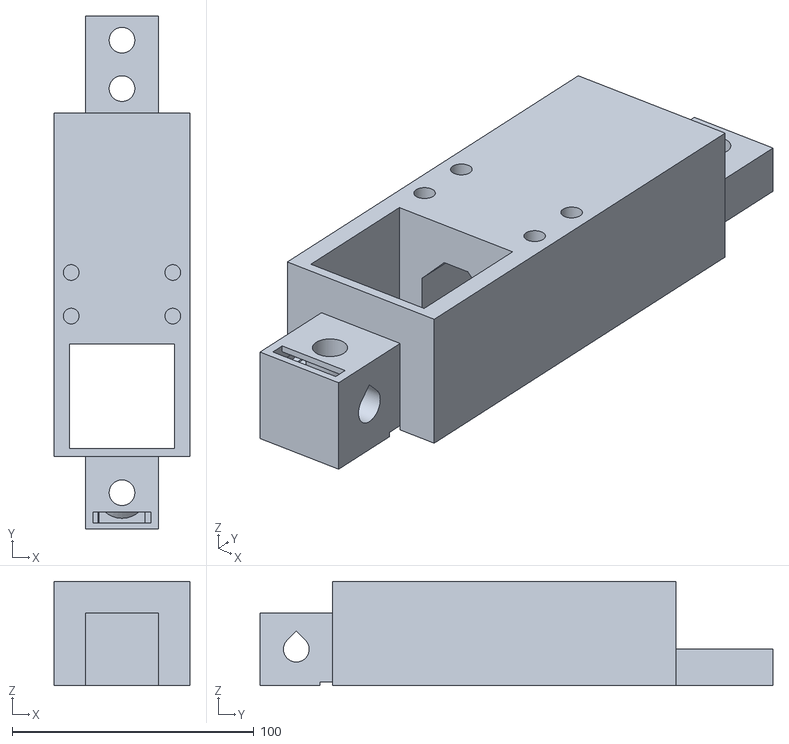
[picture p146: CAD file, 2026-10-28]
corexy100/entrega/02 STL para imprimir/04 Eixo Z e mesa/baseZInf_D [1x].stl
56.0 x 212.0 x 43.0
