WHdragon770/mulbot-corexy/corexy100/entrega/02 STL para imprimir/04 Eixo Z e mesa/Fuso e porca - FDM/porcaZ_DL1-04-06_rosca_nova [2x].stl

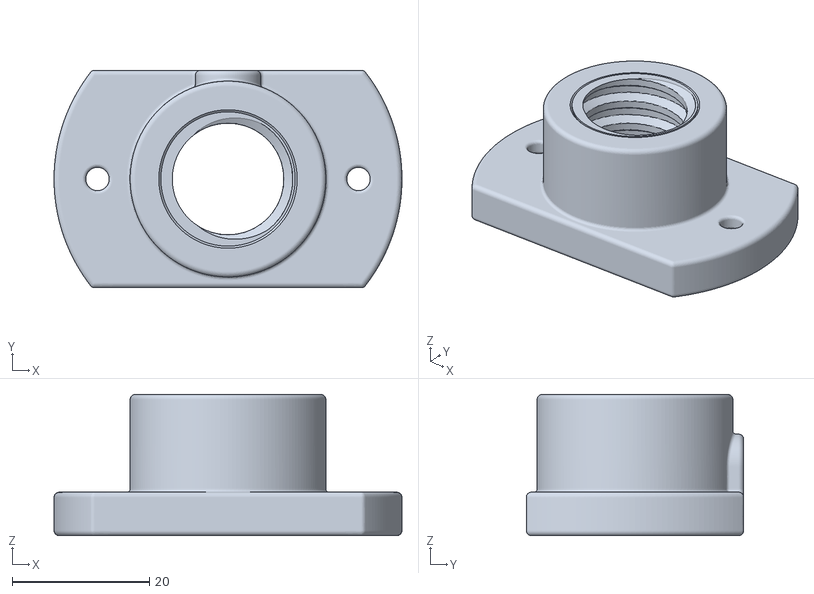
[picture p147: CAD file, 2026-10-20]
corexy100/entrega/02 STL para imprimir/04 Eixo Z e mesa/Fuso e porca - FDM/porcaZ_DL1-04-06_rosca_nova [2x].stl
50.8 x 31.8 x 20.6
