WHdragon770/mulbot-corexy/corexy100/entrega/02 STL para imprimir/05 Motores e polias/DL1-06-01 [8x].stl

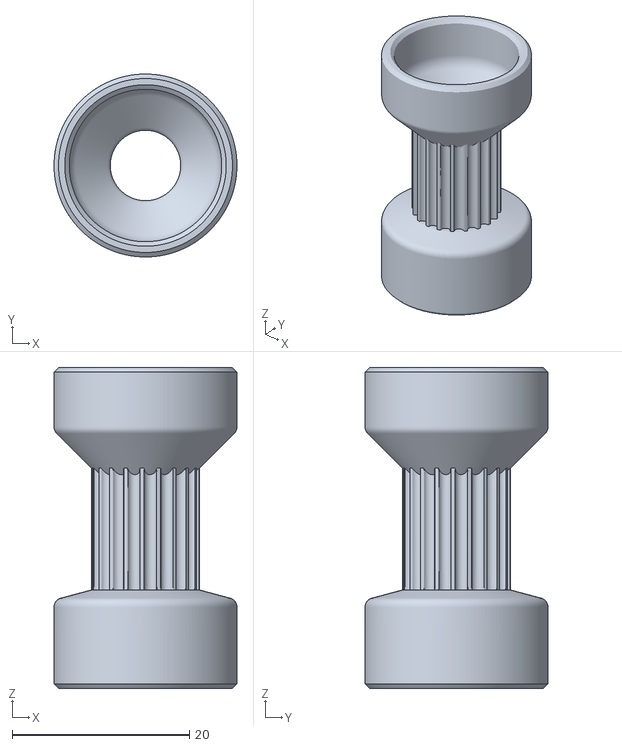
[picture p148: CAD file, 2026-10-20]
corexy100/entrega/02 STL para imprimir/05 Motores e polias/DL1-06-01 [8x].stl
20.6 x 20.6 x 36.2
