WHdragon770/mulbot-corexy/corexy100/entrega/02 STL para imprimir/06 Eletronica e display/DL1-05-02 [1x].stl

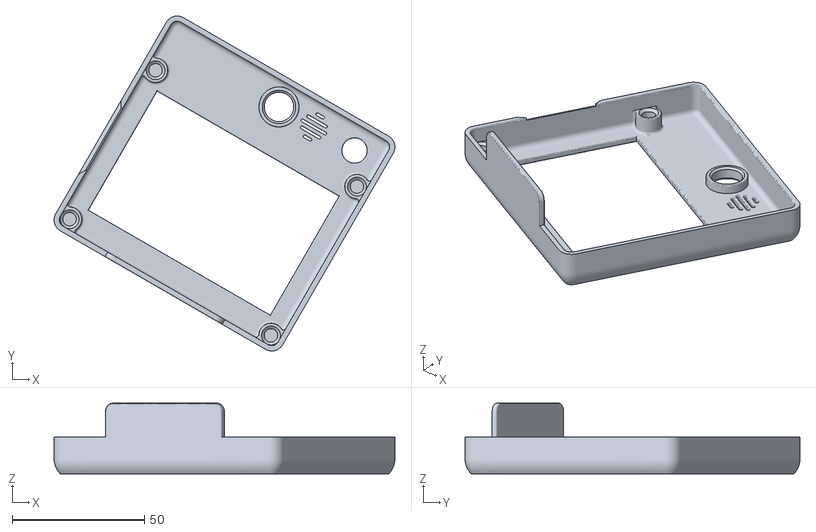
[picture p149: CAD file, 2026-10-20]
corexy100/entrega/02 STL para imprimir/06 Eletronica e display/DL1-05-02 [1x].stl
128.9 x 126.7 x 26.7
