WHdragon770/mulbot-corexy/corexy100/entrega/02 STL para imprimir/08 Parafusos e porcas impressos/parafuso_M6x65 [4x].stl

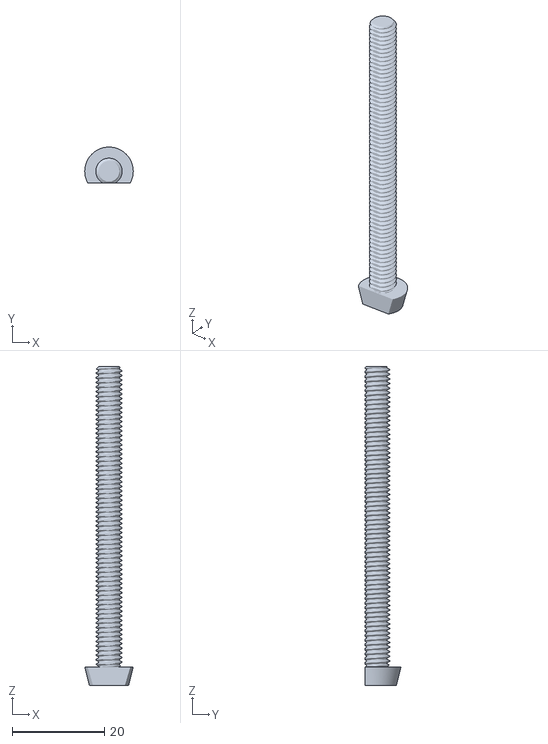
[picture p150: CAD file, 2026-10-21]
corexy100/entrega/02 STL para imprimir/08 Parafusos e porcas impressos/parafuso_M6x65 [4x].stl
10.5 x 7.77 x 69.0
