WHdragon770/mulbot-corexy/corexy100/entrega/02 STL para imprimir/09 Esteira porta-cabos/bandejaY_T [1x].stl

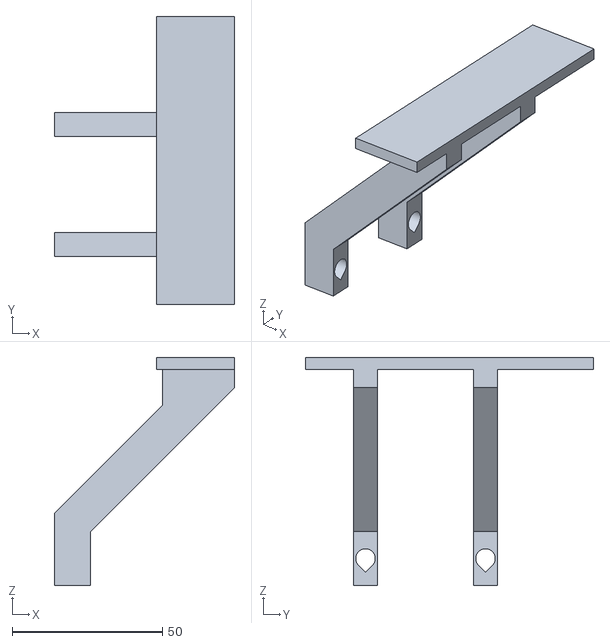
[picture p151: CAD file, 2026-10-27]
corexy100/entrega/02 STL para imprimir/09 Esteira porta-cabos/bandejaY_T [1x].stl
60.0 x 96.0 x 76.0
