WHdragon770/mulbot-corexy/corexy100/entrega/06 Placas de impressao/Kobra X (3MF)/09 Esteira porta-cabos - PLA.3mf

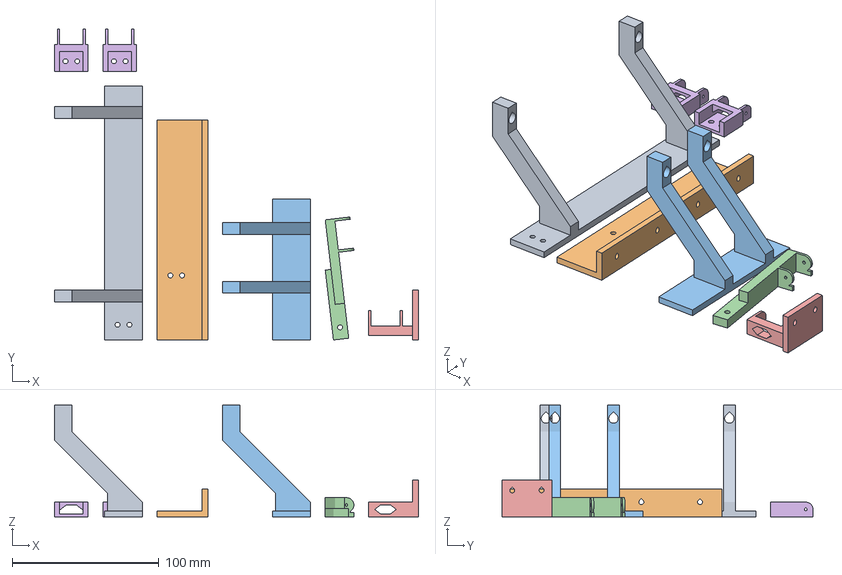
[picture p152: CAD file, 2026-10-28]
corexy100/entrega/06 Placas de impressao/Kobra X (3MF)/09 Esteira porta-cabos - PLA.3mf
248.1 x 212.0 x 76.0 mm
bandejaY_F
bandejaX
bandejaY_T
bracoEsteiraX
suporteEsteiraY
pontaFixa_esteira x 2
