WHdragon770/mulbot-corexy/corexy100/entrega/06 Placas de impressao/Resina (Photon)/Alternativa - fuso Z em resina/fusoZ_pino_D [2x].stl

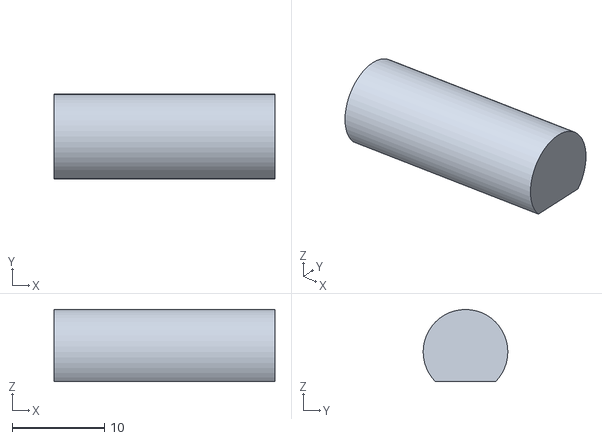
[picture p153: CAD file, 2026-10-28]
corexy100/entrega/06 Placas de impressao/Resina (Photon)/Alternativa - fuso Z em resina/fusoZ_pino_D [2x].stl
24.0 x 9.20 x 7.82
