WHdragon770/mulbot-corexy/corexy100/entrega/06 Placas de impressao/Resina (Photon)/STL individuais/buchaX_excentrica_espacador [1x].stl

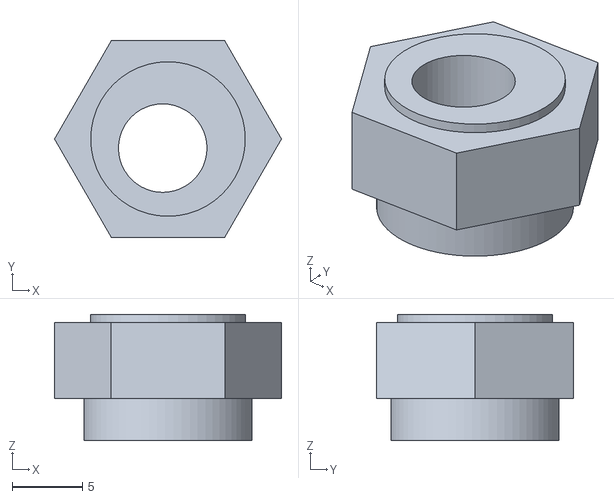
[picture p154: CAD file, 2026-10-28]
corexy100/entrega/06 Placas de impressao/Resina (Photon)/STL individuais/buchaX_excentrica_espacador [1x].stl
16.2 x 14.0 x 9.00
