WHdragon770/mulbot-corexy/corexy100/guia_v/stl/exp_espacador.stl

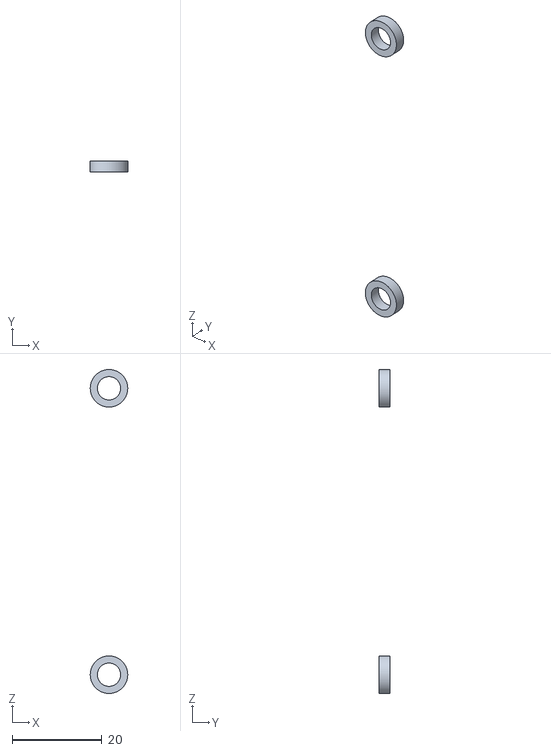
[picture p155: CAD file, 2026-10-30]
corexy100/guia_v/stl/exp_espacador.stl
8.40 x 2.50 x 72.4
