WHdragon770/mulbot-corexy/corexy100/out/anim/cabos/motorB.stl

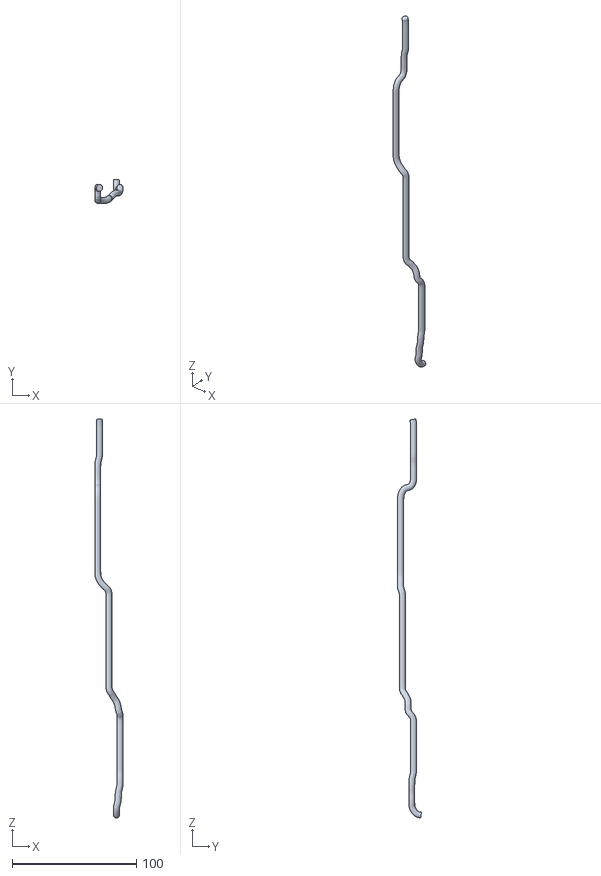
[picture p156: CAD file, 2026-10-27]
corexy100/out/anim/cabos/motorB.stl
22.9 x 19.3 x 321.5
