WHdragon770/mulbot-corexy/entrega/02b STL para imprimir na 100/00 Pinos/pino 4x15.4 mm [123x].stl

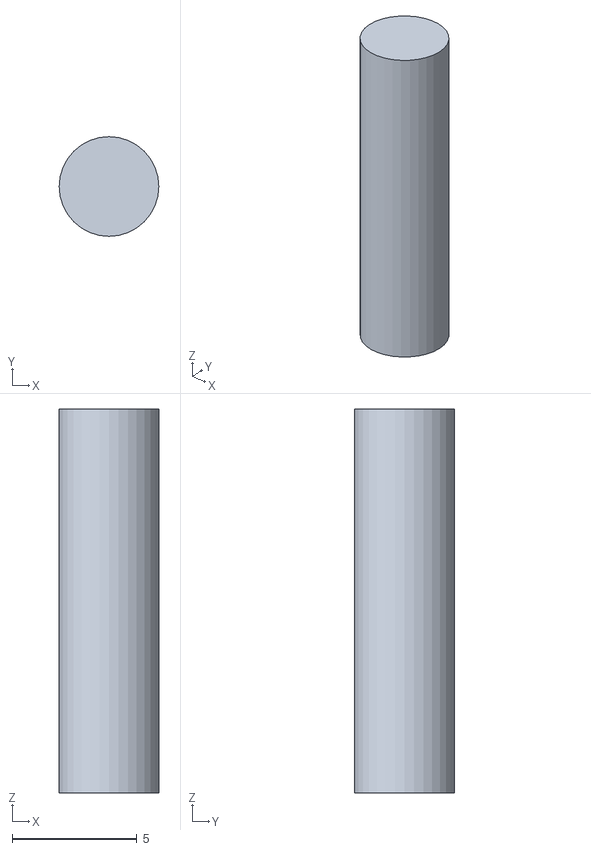
[picture p157: CAD file, 2026-10-27]
entrega/02b STL para imprimir na 100/00 Pinos/pino 4x15.4 mm [123x].stl
4.00 x 4.00 x 15.4
