WHdragon770/mulbot-corexy/entrega/02b STL para imprimir na 100/01 Quadro/travTras_D luva 2 [1x].stl

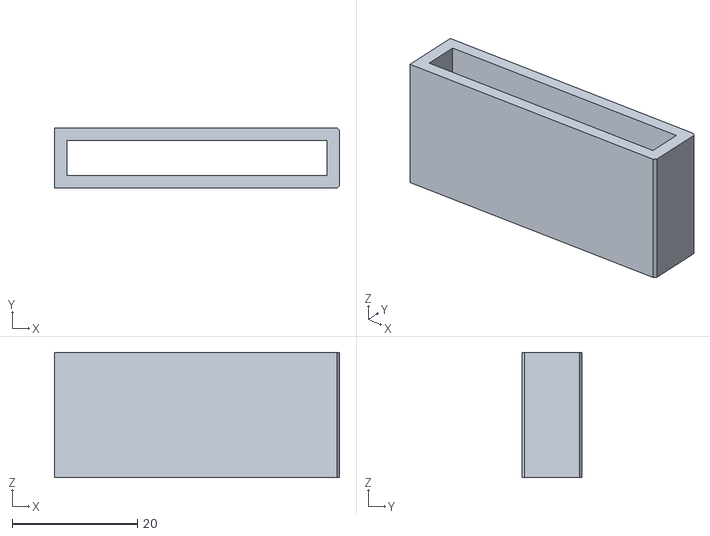
[picture p158: CAD file, 2026-10-27]
entrega/02b STL para imprimir na 100/01 Quadro/travTras_D luva 2 [1x].stl
45.6 x 9.60 x 20.0
