WHdragon770/mulbot-corexy/entrega/02b STL para imprimir na 100/02 Eixo Y e portico/suportePortico_D parte 1de2 [1x].stl

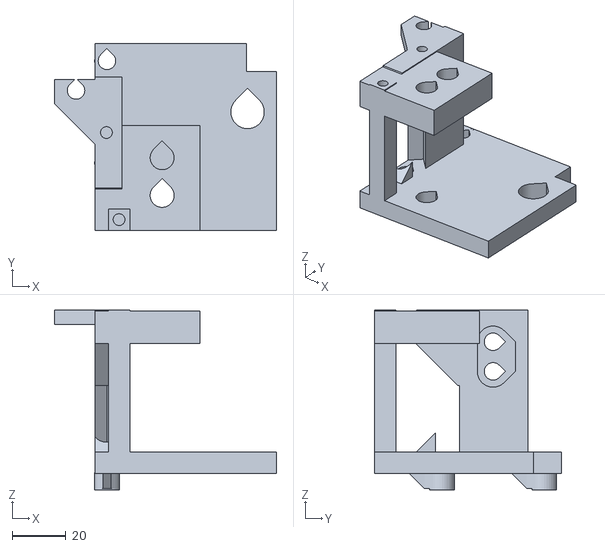
[picture p159: CAD file, 2026-10-27]
entrega/02b STL para imprimir na 100/02 Eixo Y e portico/suportePortico_D parte 1de2 [1x].stl
82.5 x 69.4 x 66.8
