WHdragon770/mulbot-corexy/entrega/02b STL para imprimir na 100/04 Eixo Z e mesa/bracoMesa_E parte 2de2 [1x].stl

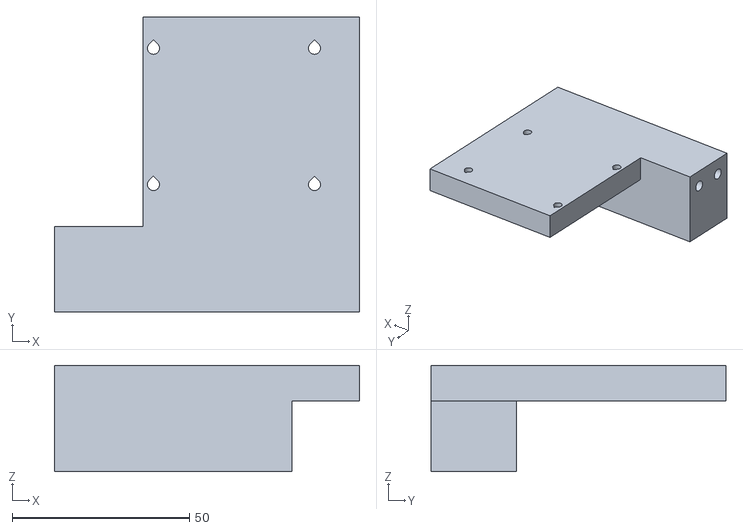
[picture p161: CAD file, 2026-10-27]
entrega/02b STL para imprimir na 100/04 Eixo Z e mesa/bracoMesa_E parte 2de2 [1x].stl
86.0 x 83.1 x 30.0
