WHdragon770/mulbot-corexy/entrega/02b STL para imprimir na 100/04 Eixo Z e mesa/Fuso e porca - FDM/fusoZ_250mm parte 2de3 [2x].stl

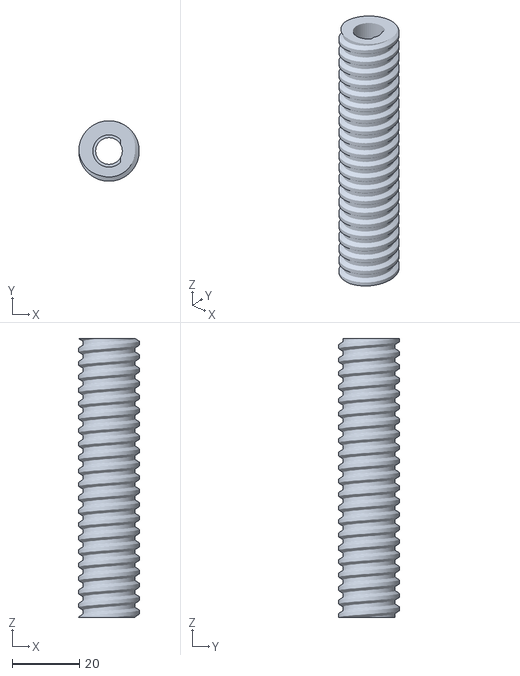
[picture p162: CAD file, 2026-10-27]
entrega/02b STL para imprimir na 100/04 Eixo Z e mesa/Fuso e porca - FDM/fusoZ_250mm parte 2de3 [2x].stl
18.0 x 18.0 x 83.0
