WHdragon770/mulbot-corexy/entrega/02b STL para imprimir na 100/06 Eletronica e display/DL1-02-09_caixa_ramps luva 2 [1x].stl

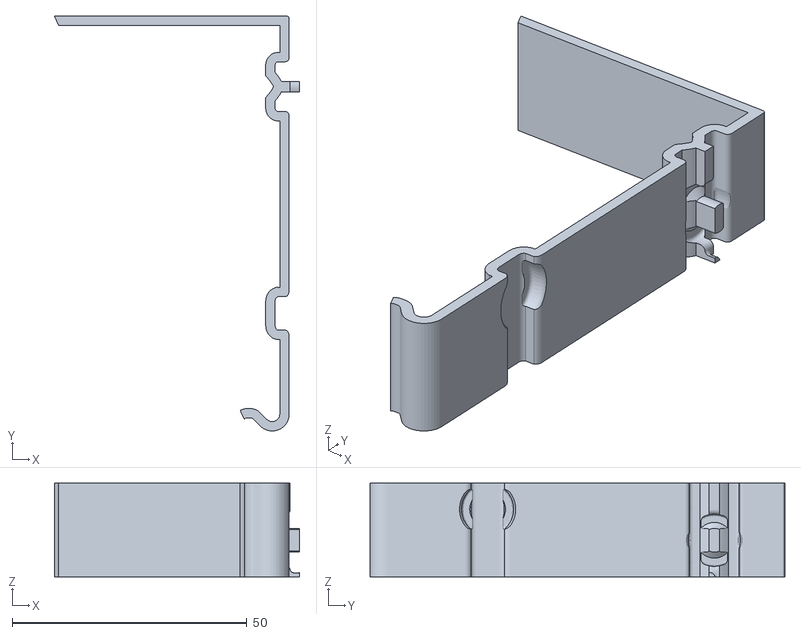
[picture p163: CAD file, 2026-10-27]
entrega/02b STL para imprimir na 100/06 Eletronica e display/DL1-02-09_caixa_ramps luva 2 [1x].stl
52.2 x 88.3 x 20.0
