WHdragon770/mulbot-corexy/entrega/02b STL para imprimir na 100/09 Esteira porta-cabos/bandejaX luva 2 [1x].stl

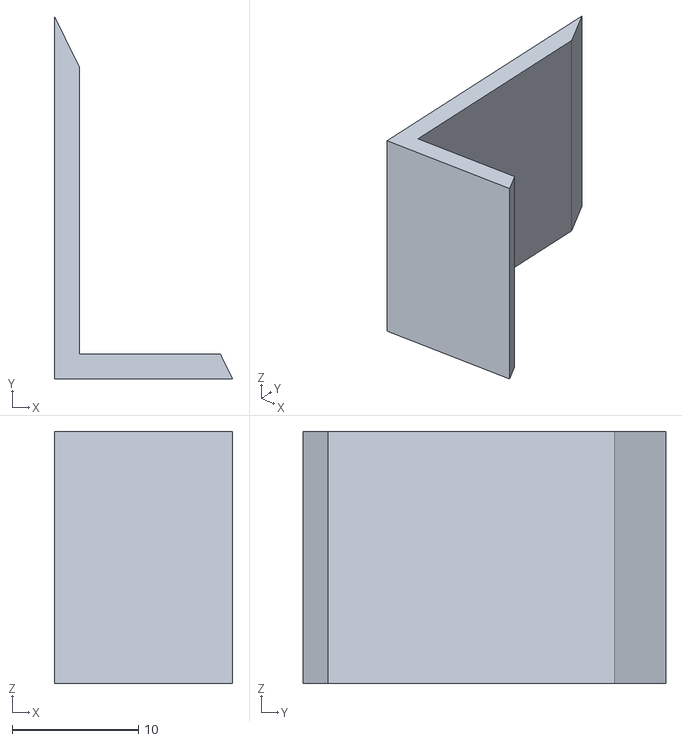
[picture p164: CAD file, 2026-10-27]
entrega/02b STL para imprimir na 100/09 Esteira porta-cabos/bandejaX luva 2 [1x].stl
14.1 x 28.8 x 20.0
