WHdragon770/mulbot-corexy/guia_v/stl/corte_bucha.stl

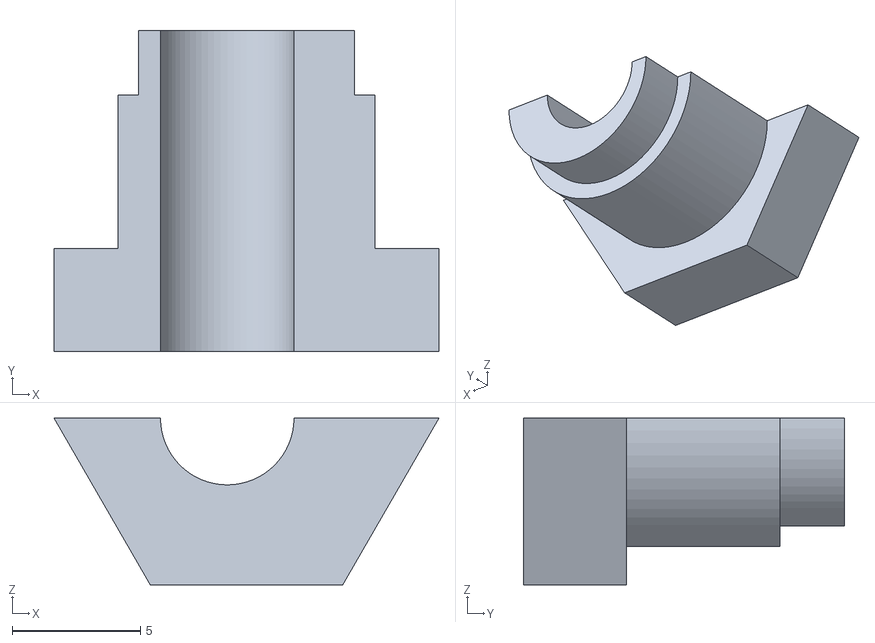
[picture p165: CAD file, 2026-10-30]
guia_v/stl/corte_bucha.stl
15.0 x 12.5 x 6.50
