WHdragon770/mulbot-corexy/out/anim/cabos/fimCursoY.stl

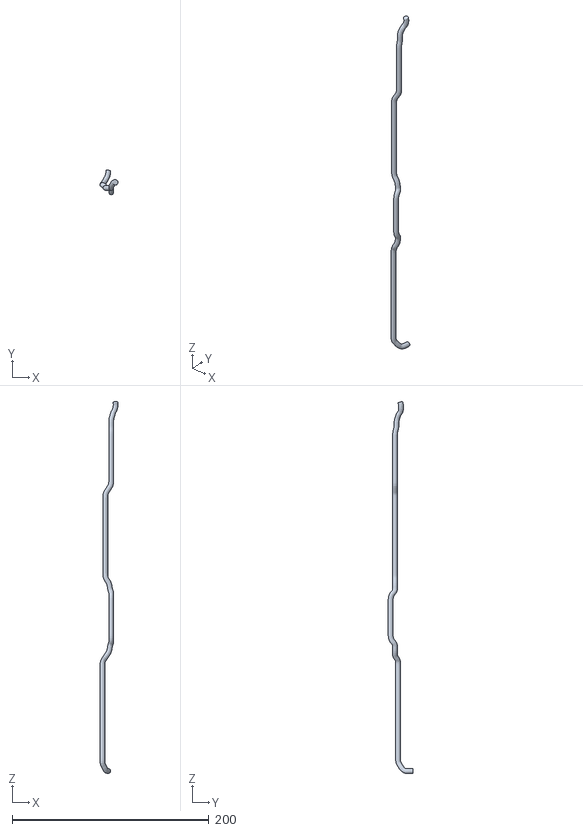
[picture p166: CAD file, 2026-10-28]
out/anim/cabos/fimCursoY.stl
18.2 x 25.1 x 378.0
