WHdragon770/mulbot-corexy/out/anim/poses/caboEsteira_Y_042.stl

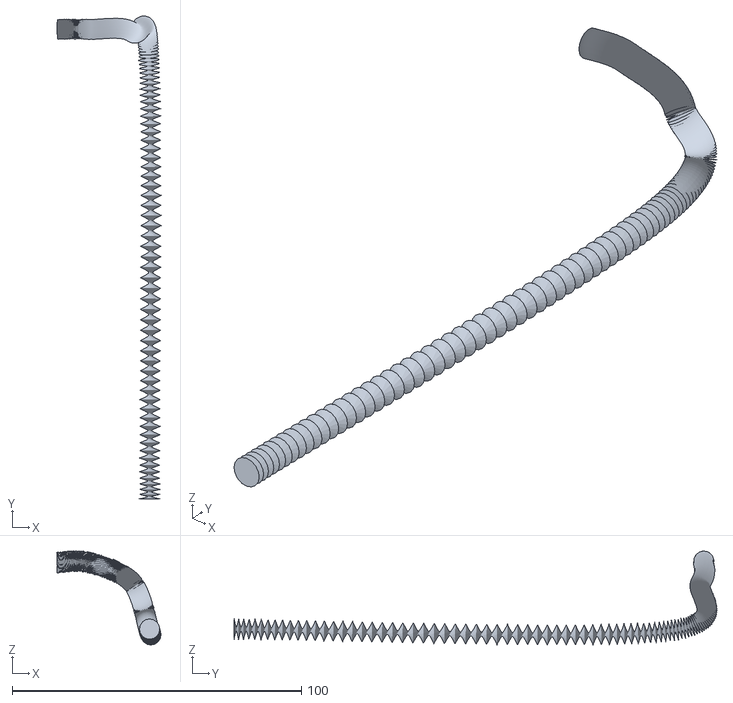
[picture p167: CAD file, 2026-10-28]
out/anim/poses/caboEsteira_Y_042.stl
36.0 x 167.1 x 32.5
