WHdragon770/mulbot-corexy/corexy100/entrega/02 STL para imprimir/01 Quadro/posteFrenteSup_E [1x].stl

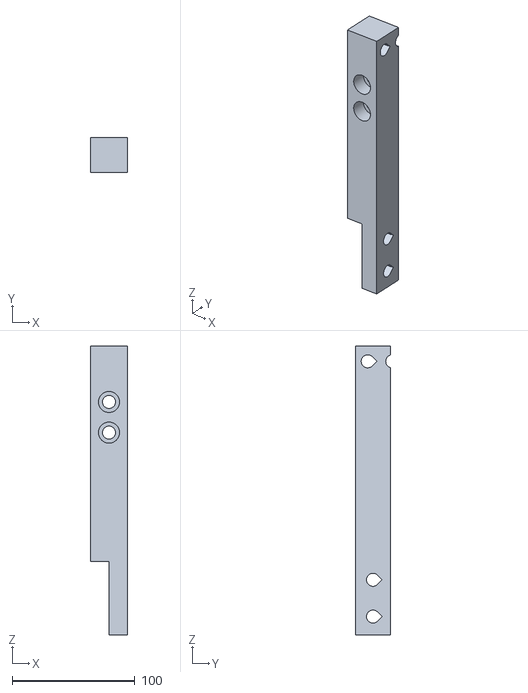
[picture p168: CAD file, 2026-10-28]
corexy100/entrega/02 STL para imprimir/01 Quadro/posteFrenteSup_E [1x].stl
30.0 x 28.6 x 235.6
