WHdragon770/mulbot-corexy/corexy100/entrega/02 STL para imprimir/02 Eixo Y e portico/suportePortico_E [1x].stl

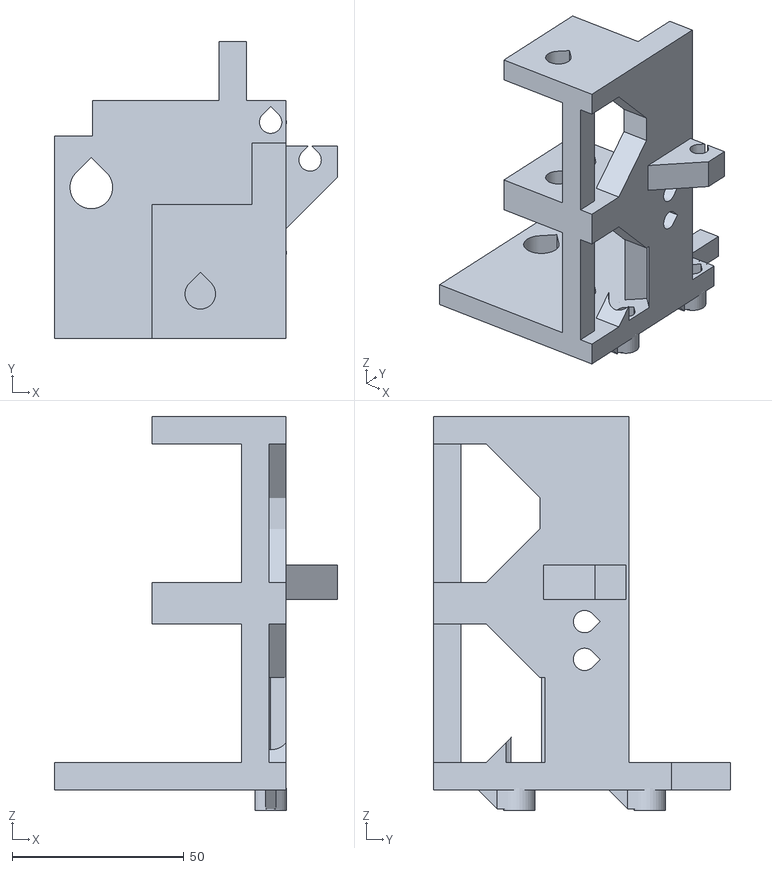
[picture p169: CAD file, 2026-10-27]
corexy100/entrega/02 STL para imprimir/02 Eixo Y e portico/suportePortico_E [1x].stl
82.5 x 86.5 x 114.8
