WHdragon770/mulbot-corexy/corexy100/entrega/02 STL para imprimir/03 Eixo X e cabeca/trilhoX [1x].stl

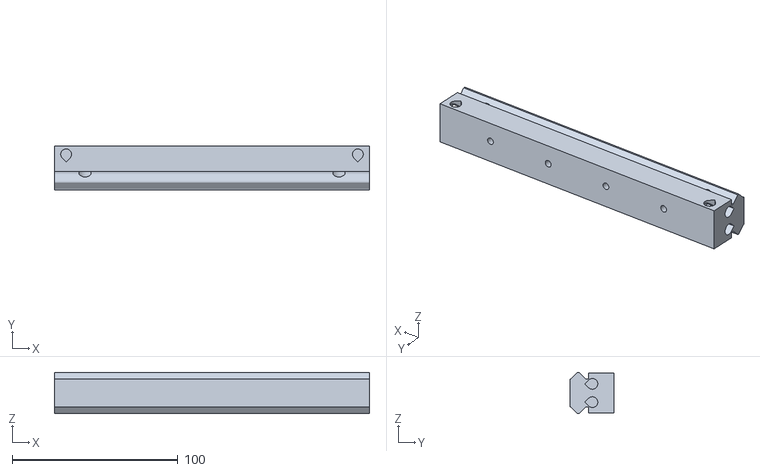
[picture p170: CAD file, 2026-10-27]
corexy100/entrega/02 STL para imprimir/03 Eixo X e cabeca/trilhoX [1x].stl
190.0 x 26.5 x 25.0
