WHdragon770/mulbot-corexy/corexy100/entrega/02 STL para imprimir/05 Motores e polias/DL1-04-08 [2x].stl

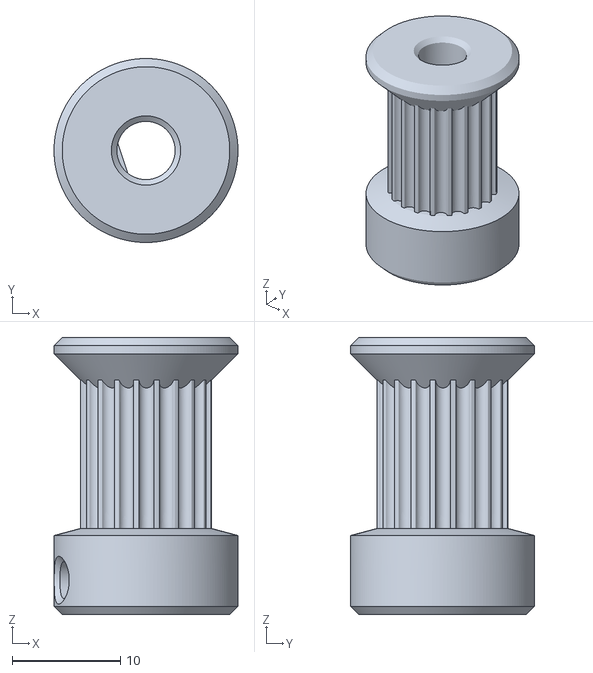
[picture p171: CAD file, 2026-10-20]
corexy100/entrega/02 STL para imprimir/05 Motores e polias/DL1-04-08 [2x].stl
17.0 x 17.0 x 25.6
