WHdragon770/mulbot-corexy/corexy100/entrega/02 STL para imprimir/06 Eletronica e display/DL1-05-03 [1x].stl

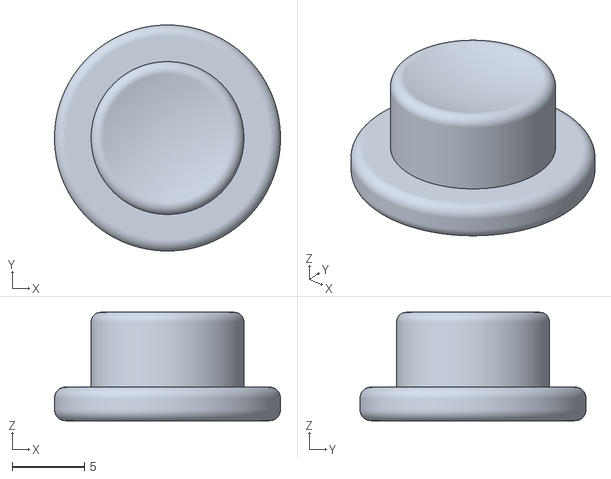
[picture p172: CAD file, 2026-10-20]
corexy100/entrega/02 STL para imprimir/06 Eletronica e display/DL1-05-03 [1x].stl
15.7 x 15.7 x 7.53
