WHdragon770/mulbot-corexy/corexy100/entrega/02 STL para imprimir/09 Esteira porta-cabos/bandejaX [1x].stl

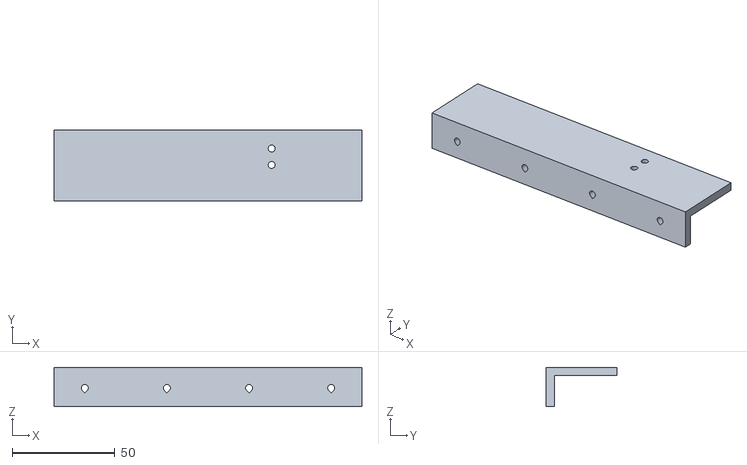
[picture p174: CAD file, 2026-10-27]
corexy100/entrega/02 STL para imprimir/09 Esteira porta-cabos/bandejaX [1x].stl
150.0 x 34.5 x 19.0
