WHdragon770/mulbot-corexy/corexy100/entrega/06 Placas de impressao/Kobra X (3MF)/02 Eixo Y e portico - PLA.3mf

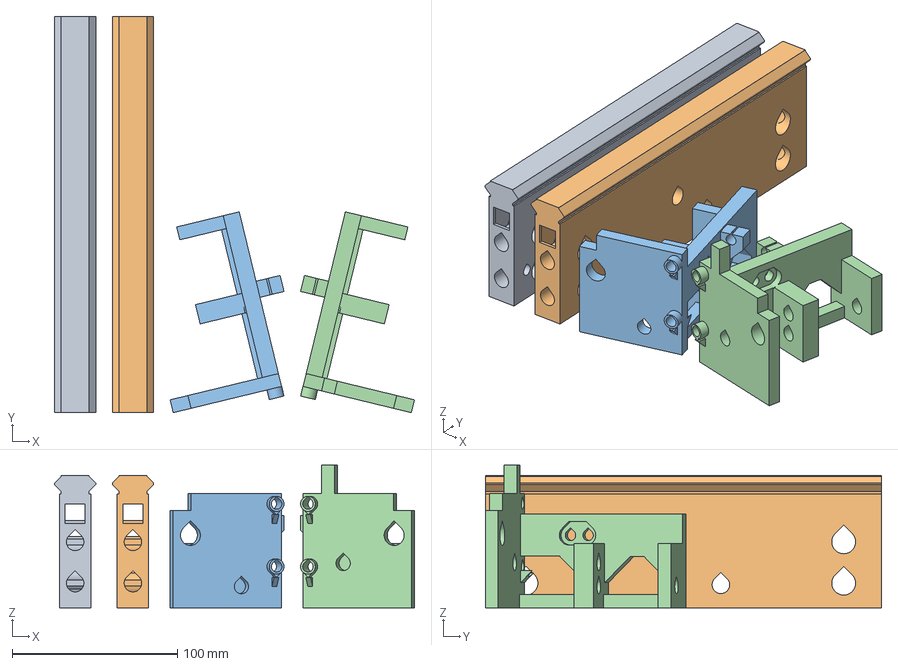
[picture p175: CAD file, 2026-10-28]
corexy100/entrega/06 Placas de impressao/Kobra X (3MF)/02 Eixo Y e portico - PLA.3mf
218.0 x 240.0 x 86.5 mm
trilhoY_D
trilhoY_E
suportePortico_D
suportePortico_E
