WHdragon770/mulbot-corexy/corexy100/entrega/06 Placas de impressao/Resina (Photon)/STL individuais/roldanaV_rolamento_1peca_resina [15x].stl

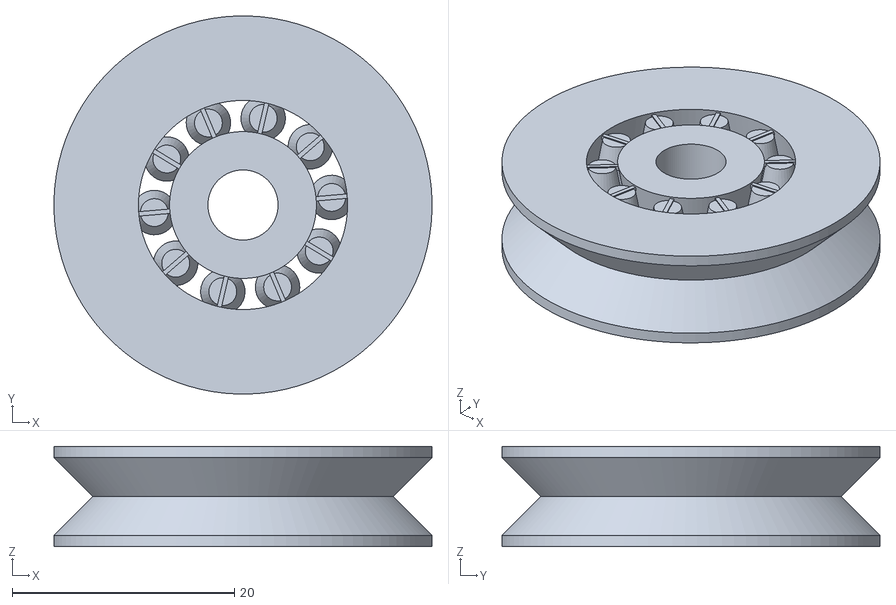
[picture p176: CAD file, 2026-10-28]
corexy100/entrega/06 Placas de impressao/Resina (Photon)/STL individuais/roldanaV_rolamento_1peca_resina [15x].stl
34.0 x 34.0 x 9.00
