WHdragon770/mulbot-corexy/corexy100/guia_v/stl/exp_poste.stl

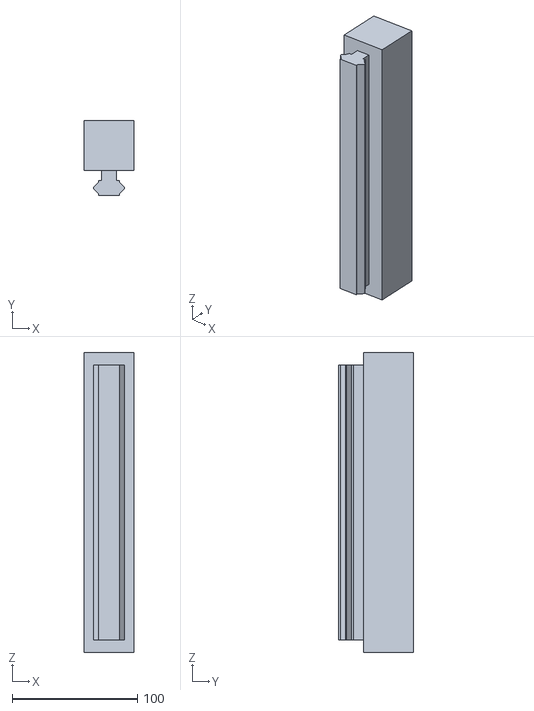
[picture p177: CAD file, 2026-10-30]
corexy100/guia_v/stl/exp_poste.stl
40.0 x 60.0 x 240.0
