WHdragon770/mulbot-corexy/corexy100/out/anim/cabos/motorZ_D.stl

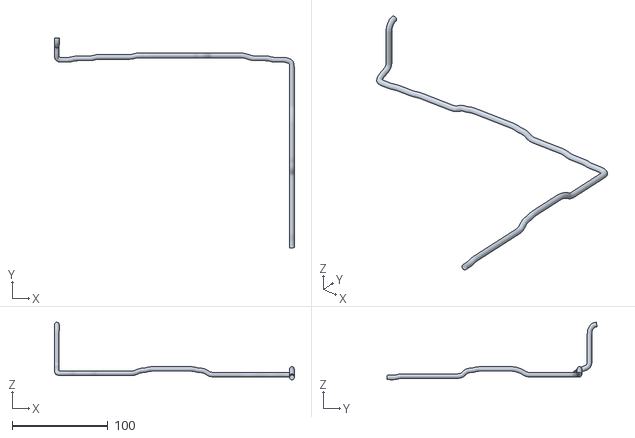
[picture p178: CAD file, 2026-10-27]
corexy100/out/anim/cabos/motorZ_D.stl
251.2 x 219.9 x 60.3
