WHdragon770/mulbot-corexy/corexy100/out/anim/poses/caboEsteira_XY_025.stl

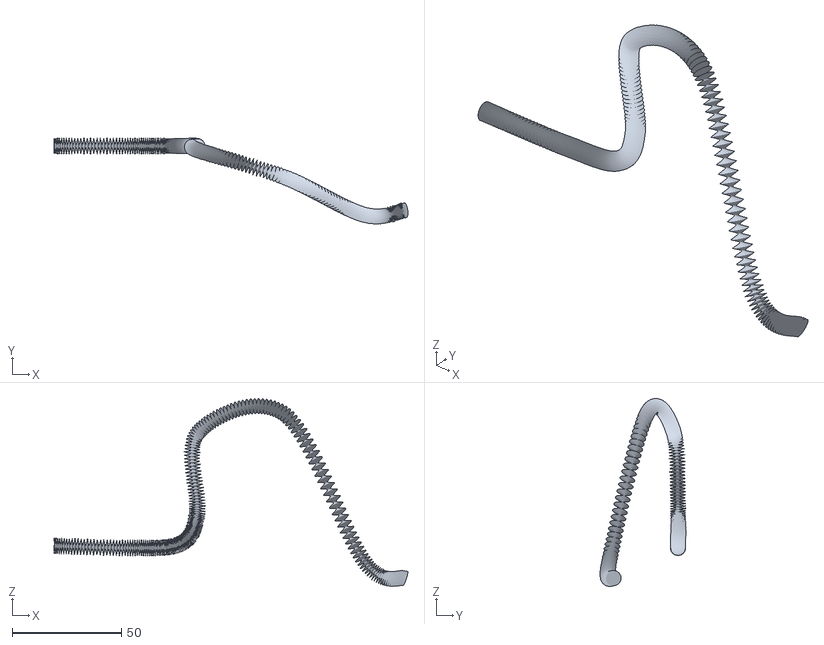
[picture p179: CAD file, 2026-10-27]
corexy100/out/anim/poses/caboEsteira_XY_025.stl
162.3 x 39.4 x 86.2
