WHdragon770/mulbot-corexy/entrega/02b STL para imprimir na 100/01 Quadro/posteTrasSup_E parte 3de3 [1x].stl

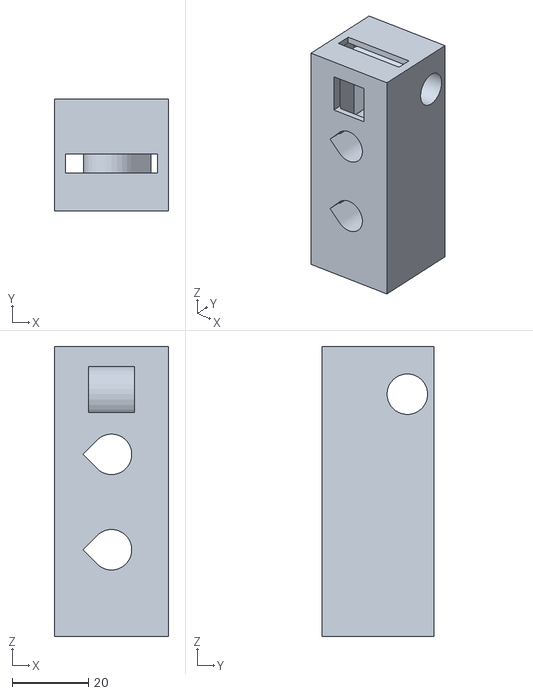
[picture p180: CAD file, 2026-10-27]
entrega/02b STL para imprimir na 100/01 Quadro/posteTrasSup_E parte 3de3 [1x].stl
30.0 x 29.4 x 76.0
