WHdragon770/mulbot-corexy/entrega/02b STL para imprimir na 100/03 Eixo X e cabeca/trilhoX parte 4de4 [1x].stl

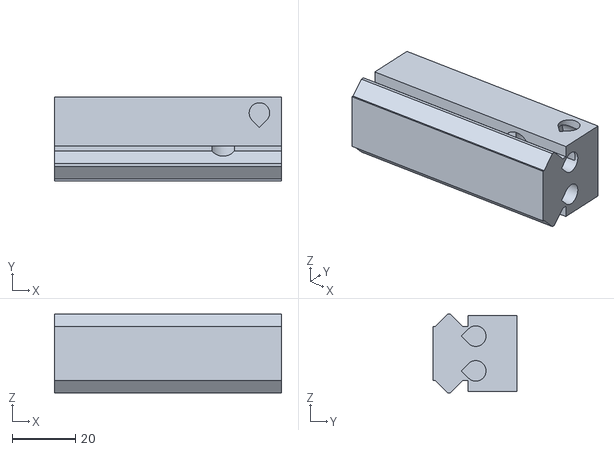
[picture p182: CAD file, 2026-10-27]
entrega/02b STL para imprimir na 100/03 Eixo X e cabeca/trilhoX parte 4de4 [1x].stl
72.0 x 26.5 x 25.0
