WHdragon770/mulbot-corexy/entrega/02b STL para imprimir na 100/04 Eixo Z e mesa/bracoMesa_D parte 2de2 [1x].stl

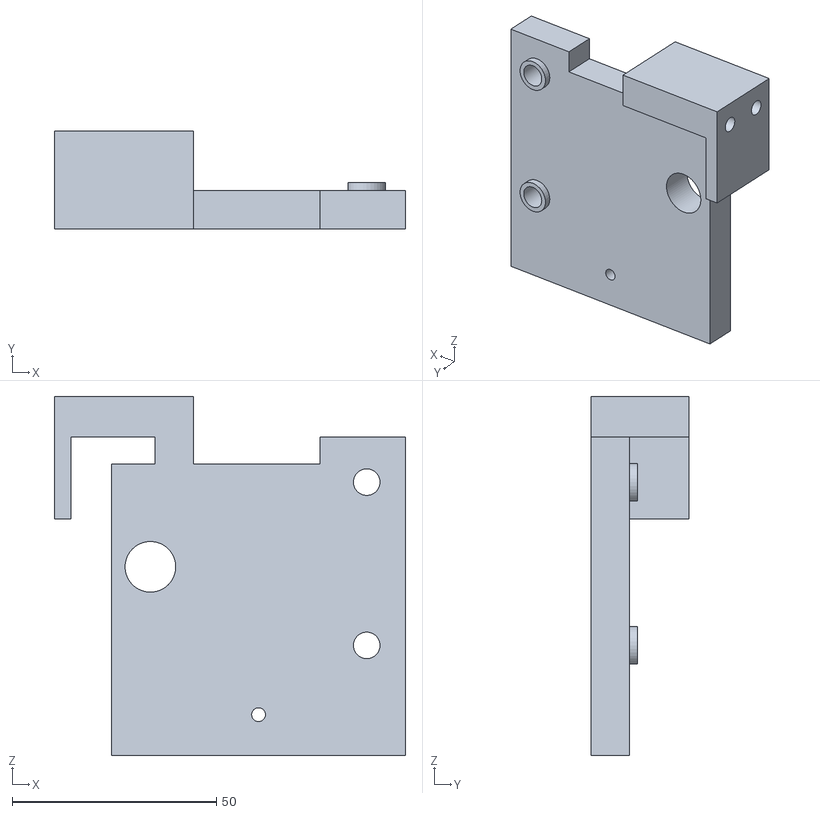
[picture p183: CAD file, 2026-10-27]
entrega/02b STL para imprimir na 100/04 Eixo Z e mesa/bracoMesa_D parte 2de2 [1x].stl
86.0 x 24.1 x 88.0
