WHdragon770/mulbot-corexy/entrega/02b STL para imprimir na 100/04 Eixo Z e mesa/Fuso e porca - FDM/fusoZ_250mm parte 1de3 [2x].stl

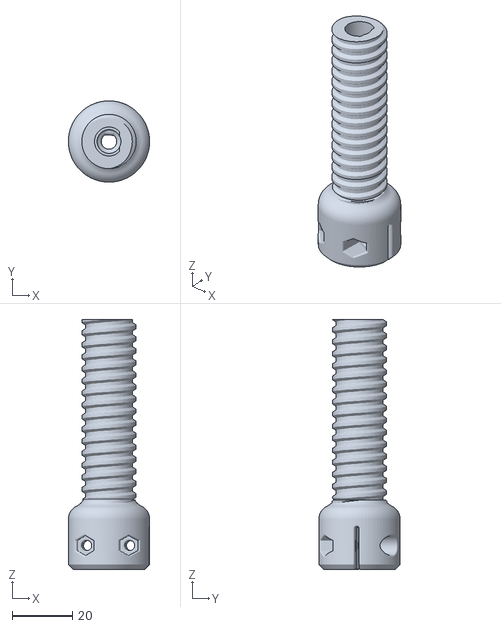
[picture p184: CAD file, 2026-10-27]
entrega/02b STL para imprimir na 100/04 Eixo Z e mesa/Fuso e porca - FDM/fusoZ_250mm parte 1de3 [2x].stl
27.0 x 27.0 x 83.0
