WHdragon770/mulbot-corexy/entrega/02b STL para imprimir na 100/06 Eletronica e display/DL1-02-09_caixa_ramps parte 4de6 [1x].stl

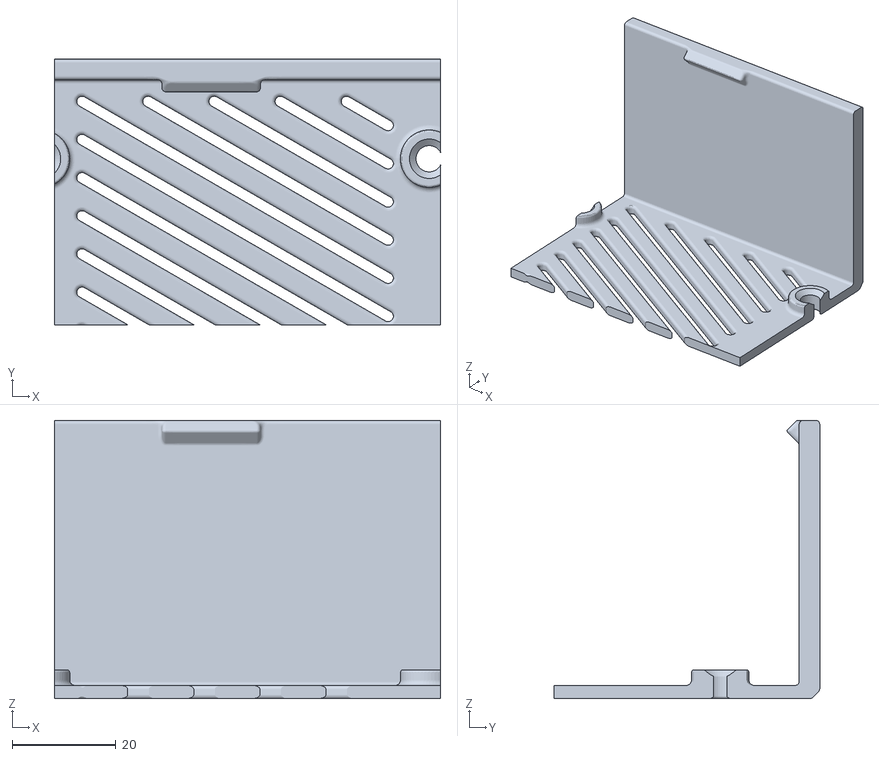
[picture p185: CAD file, 2026-10-27]
entrega/02b STL para imprimir na 100/06 Eletronica e display/DL1-02-09_caixa_ramps parte 4de6 [1x].stl
74.5 x 51.2 x 53.7
