WHdragon770/mulbot-corexy/entrega/02b STL para imprimir na 100/09 Esteira porta-cabos/bandejaX parte 2de3 [1x].stl

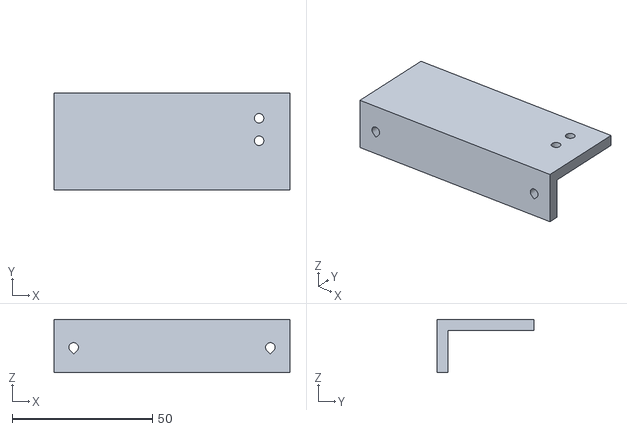
[picture p186: CAD file, 2026-10-27]
entrega/02b STL para imprimir na 100/09 Esteira porta-cabos/bandejaX parte 2de3 [1x].stl
84.0 x 34.5 x 19.0
