WHdragon770/mulbot-corexy/entrega/07 Mesa aquecida (opcional)/220 - 12V/STL para imprimir/calcoFimCursoZ [1x].stl

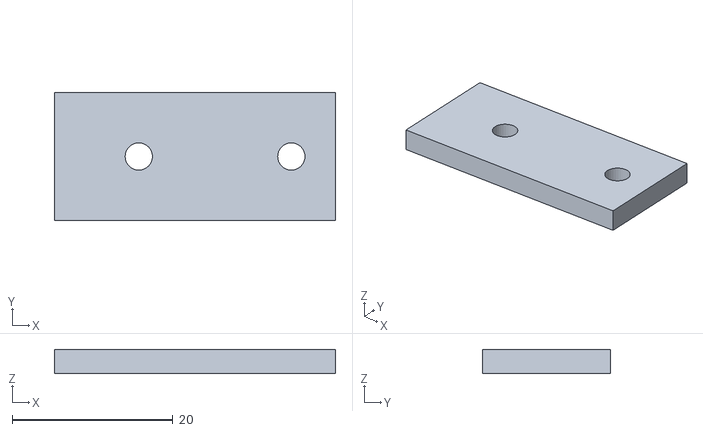
[picture p187: CAD file, 2026-10-21]
entrega/07 Mesa aquecida (opcional)/220 - 12V/STL para imprimir/calcoFimCursoZ [1x].stl
35.0 x 16.0 x 3.00
