WHdragon770/mulbot-corexy/entrega/07 Mesa aquecida (opcional)/235 - 24V/STL para imprimir/localizador_aq235 [4x].stl

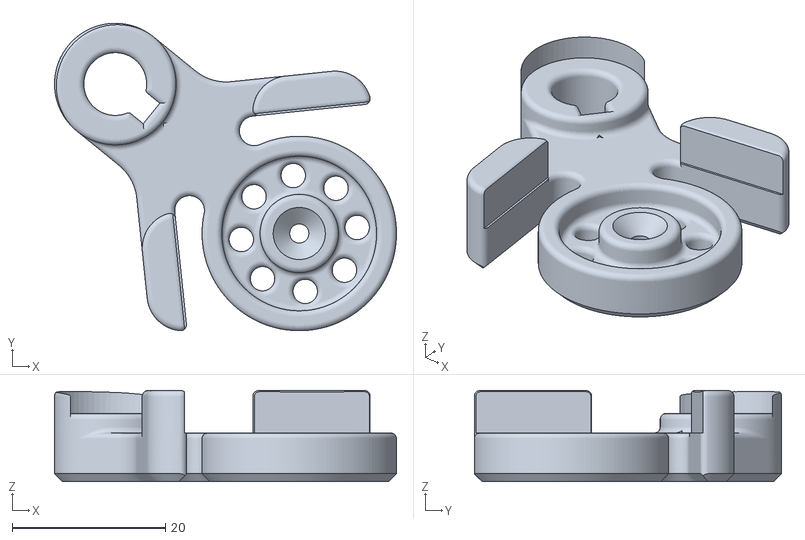
[picture p188: CAD file, 2026-10-21]
entrega/07 Mesa aquecida (opcional)/235 - 24V/STL para imprimir/localizador_aq235 [4x].stl
44.7 x 40.2 x 11.9
