WHdragon770/mulbot-corexy/guia_v/stl/corte_espacador.stl

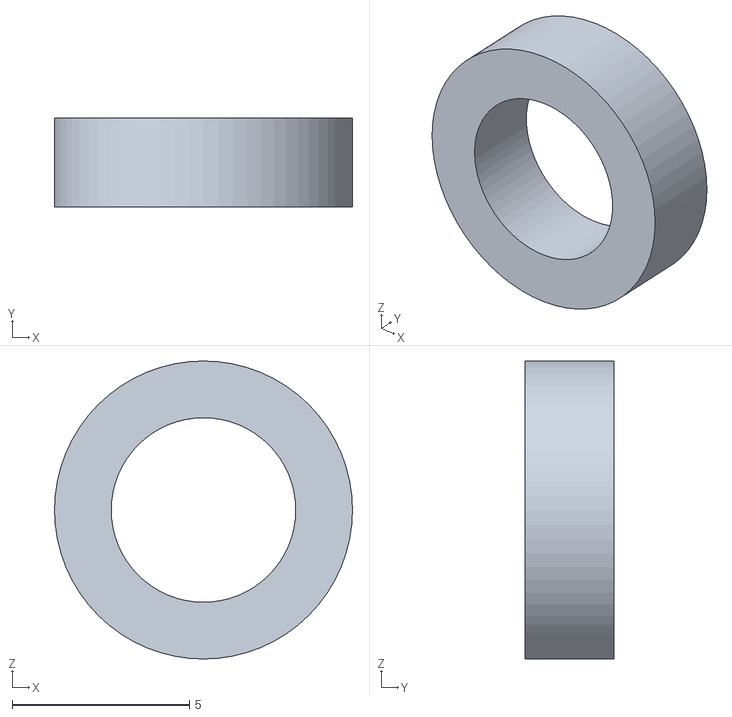
[picture p189: CAD file, 2026-10-30]
guia_v/stl/corte_espacador.stl
8.40 x 2.50 x 8.40
