WHdragon770/mulbot-corexy/out/anim/cabos/display.stl

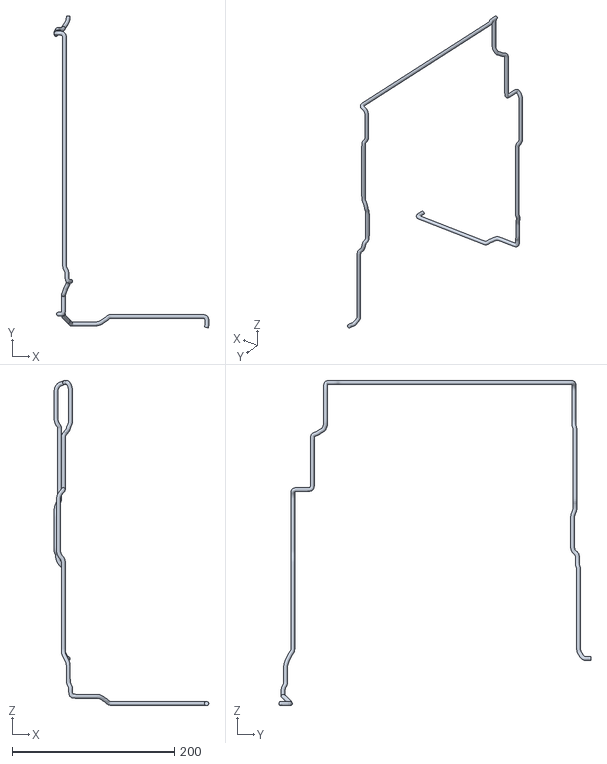
[picture p190: CAD file, 2026-10-28]
out/anim/cabos/display.stl
191.0 x 384.5 x 400.9
