WHdragon770/mulbot-corexy/corexy100/entrega/02 STL para imprimir/03 Eixo X e cabeca/bracoFimCursoX [1x].stl

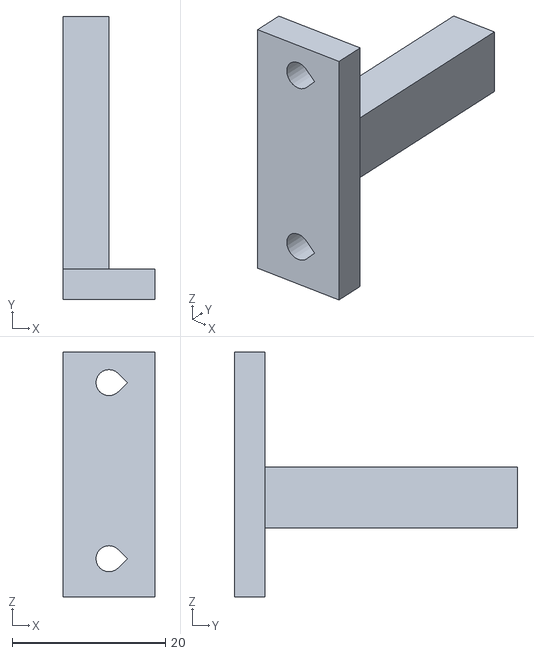
[picture p193: CAD file, 2026-10-27]
corexy100/entrega/02 STL para imprimir/03 Eixo X e cabeca/bracoFimCursoX [1x].stl
12.0 x 37.0 x 32.0
