WHdragon770/mulbot-corexy/corexy100/entrega/02 STL para imprimir/06 Eletronica e display/DL1-02-10_porta_fechada [1x].stl

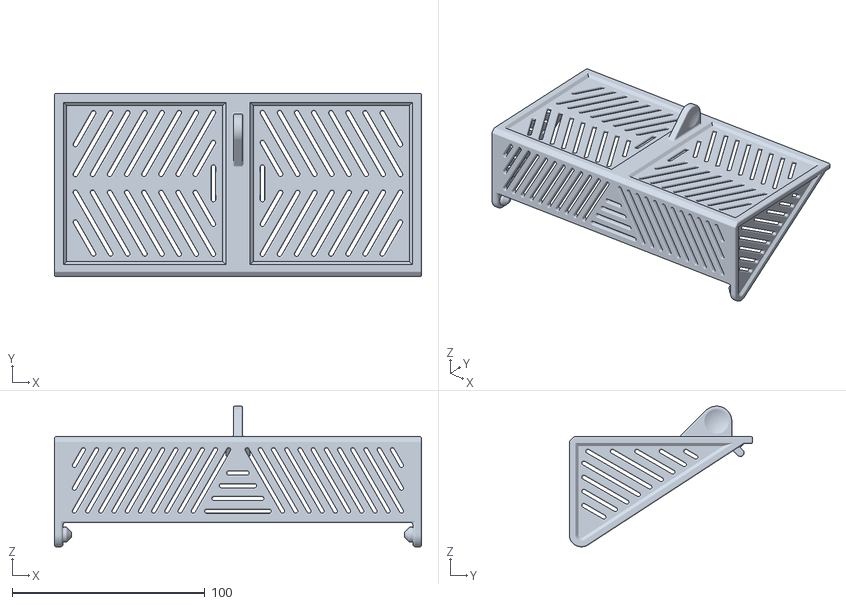
[picture p195: CAD file, 2026-10-20]
corexy100/entrega/02 STL para imprimir/06 Eletronica e display/DL1-02-10_porta_fechada [1x].stl
190.5 x 95.2 x 73.0
