WHdragon770/mulbot-corexy/corexy100/entrega/02 STL para imprimir/08 Parafusos e porcas impressos/barril_M6_D9x16 [8x].stl

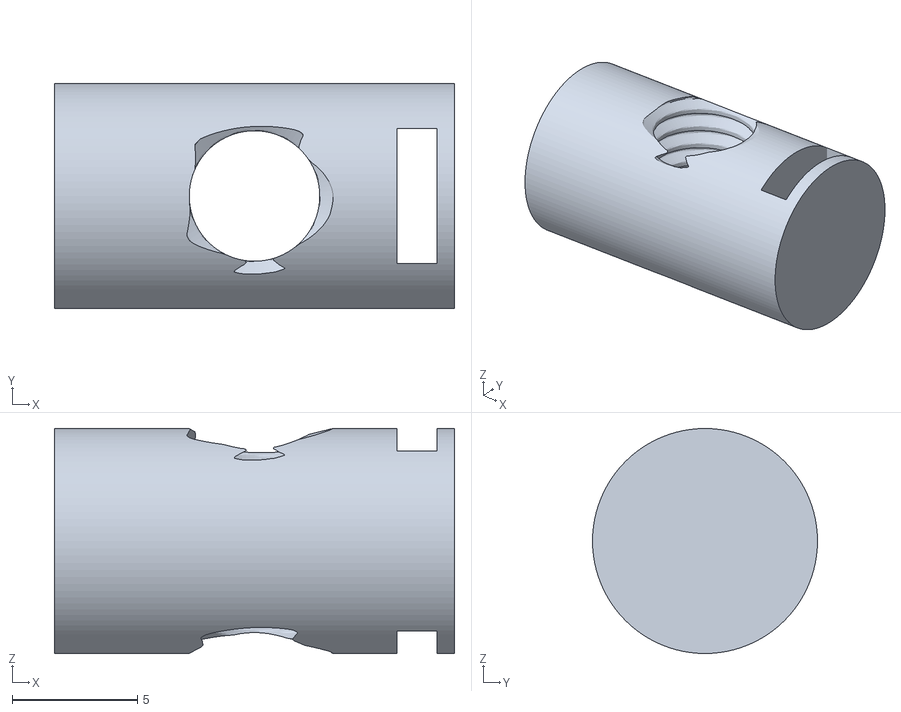
[picture p196: CAD file, 2026-10-21]
corexy100/entrega/02 STL para imprimir/08 Parafusos e porcas impressos/barril_M6_D9x16 [8x].stl
16.0 x 9.00 x 9.00
