WHdragon770/mulbot-corexy/corexy100/entrega/06 Placas de impressao/Kobra X (3MF)/09 Esteira porta-cabos - elo_esteira - PETG.3mf

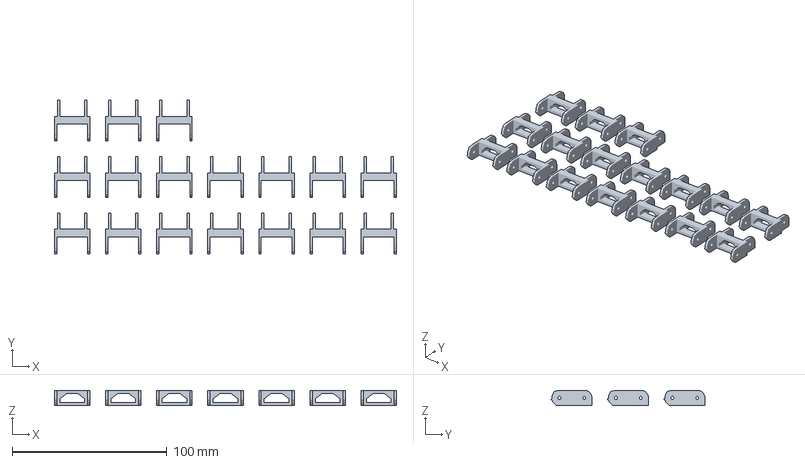
[picture p198: CAD file, 2026-10-28]
corexy100/entrega/06 Placas de impressao/Kobra X (3MF)/09 Esteira porta-cabos - elo_esteira - PETG.3mf
221.0 x 99.5 x 10.0 mm
elo_esteira x 17
