WHdragon770/mulbot-corexy/corexy100/entrega/06 Placas de impressao/Resina (Photon)/Alternativa - fuso Z em resina/fusoZ_metade_cima_125mm [2x].stl

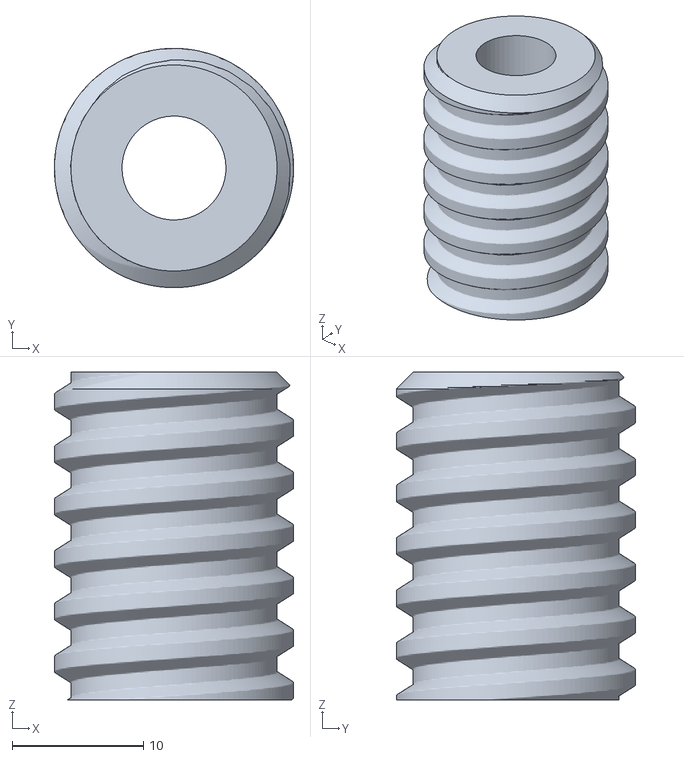
[picture p199: CAD file, 2026-10-28]
corexy100/entrega/06 Placas de impressao/Resina (Photon)/Alternativa - fuso Z em resina/fusoZ_metade_cima_125mm [2x].stl
18.2 x 18.2 x 25.0
