WHdragon770/mulbot-corexy/corexy100/entrega/06 Placas de impressao/Resina (Photon)/STL individuais/buchaZ_excentrica [2x].stl

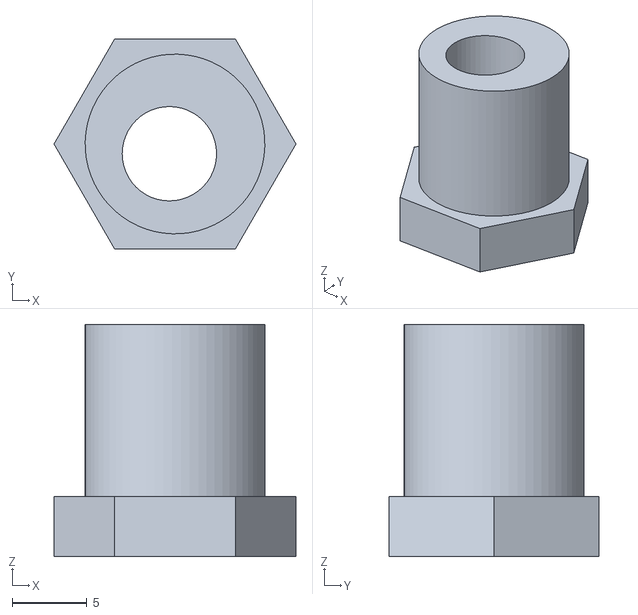
[picture p200: CAD file, 2026-10-28]
corexy100/entrega/06 Placas de impressao/Resina (Photon)/STL individuais/buchaZ_excentrica [2x].stl
16.2 x 14.0 x 15.5
