WHdragon770/mulbot-corexy/corexy100/guia_v/stl/mont_rolamento.stl

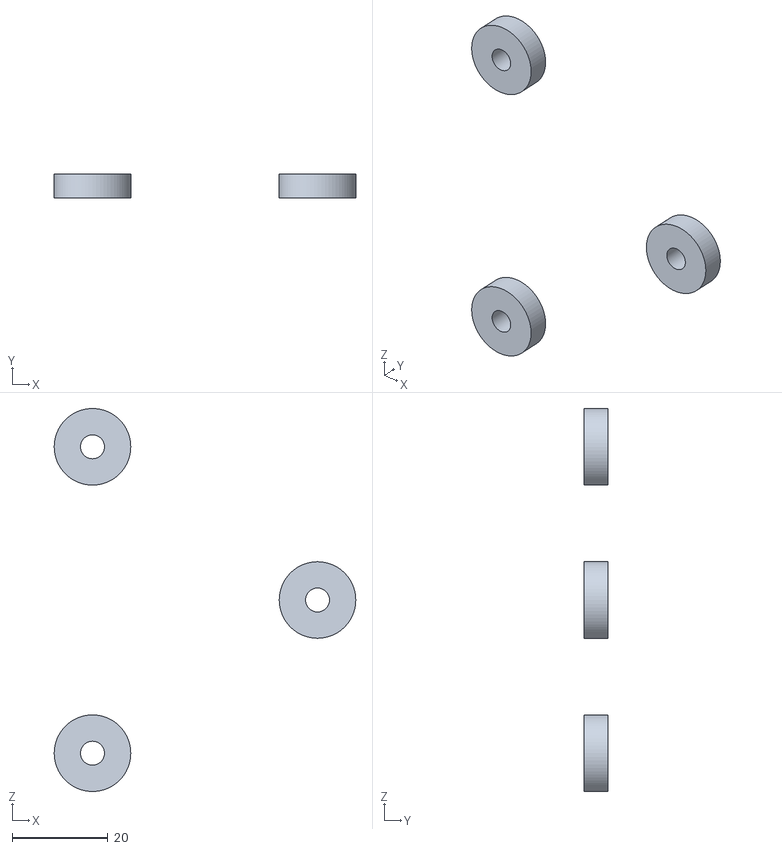
[picture p201: CAD file, 2026-10-30]
corexy100/guia_v/stl/mont_rolamento.stl
63.0 x 5.00 x 80.0
