WHdragon770/mulbot-corexy/corexy100/out/anim/cabos/display.stl

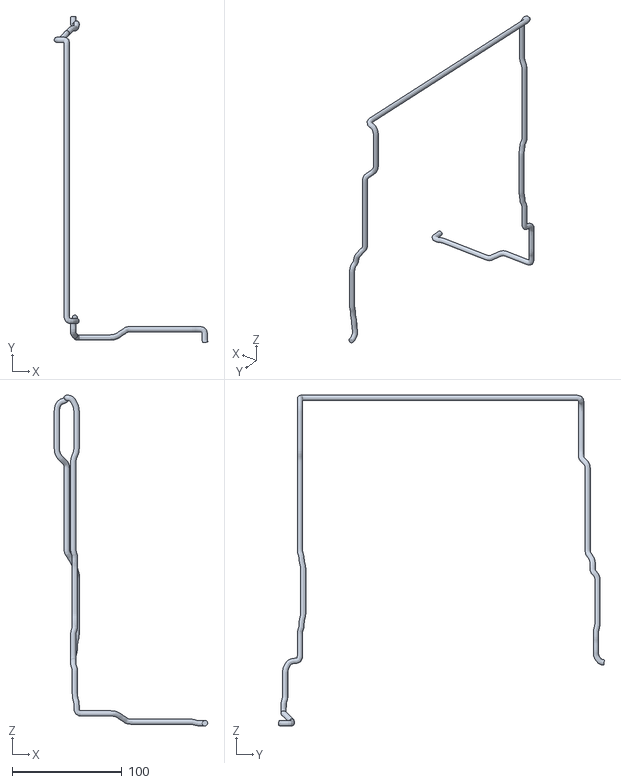
[picture p202: CAD file, 2026-10-27]
corexy100/out/anim/cabos/display.stl
140.2 x 297.4 x 301.9
