WHdragon770/mulbot-corexy/corexy100/out/anim/poses/correiaB_042.stl

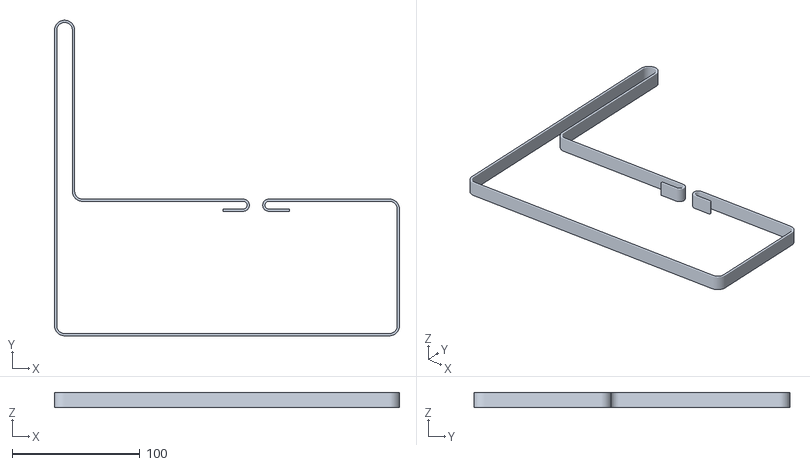
[picture p203: CAD file, 2026-10-27]
corexy100/out/anim/poses/correiaB_042.stl
269.8 x 246.8 x 12.0
