WHdragon770/mulbot-corexy/entrega/02b STL para imprimir na 100/00 Pinos/pino 3x11.4 mm [13x].stl

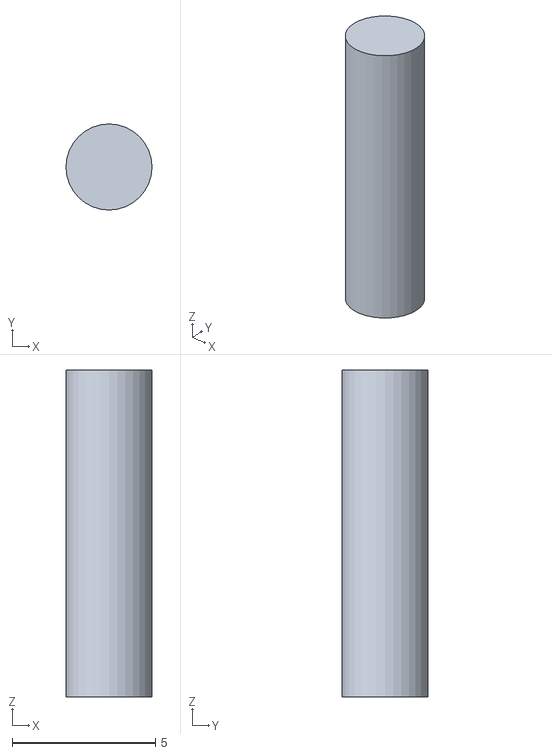
[picture p204: CAD file, 2026-10-27]
entrega/02b STL para imprimir na 100/00 Pinos/pino 3x11.4 mm [13x].stl
3.00 x 3.00 x 11.4
