WHdragon770/mulbot-corexy/entrega/02b STL para imprimir na 100/01 Quadro/posteFrenteInf_D parte 1de3 [1x].stl

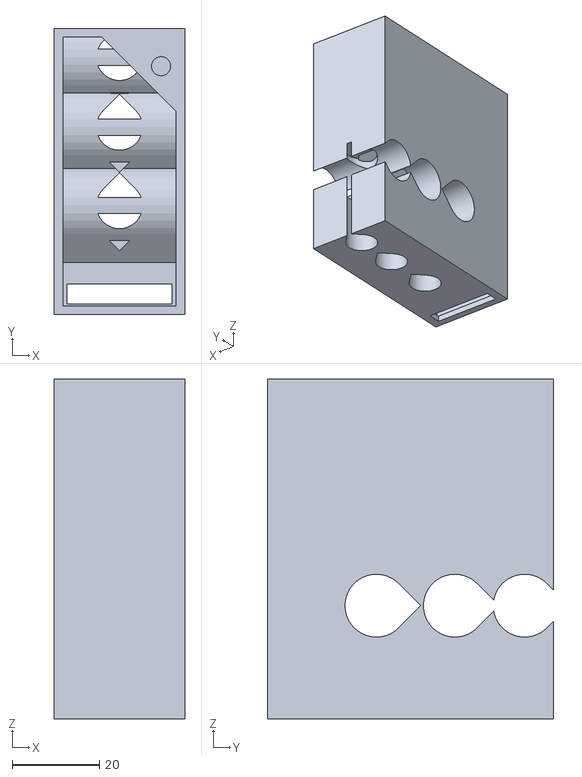
[picture p205: CAD file, 2026-10-27]
entrega/02b STL para imprimir na 100/01 Quadro/posteFrenteInf_D parte 1de3 [1x].stl
30.0 x 65.6 x 78.0
