WHdragon770/mulbot-corexy/entrega/02b STL para imprimir na 100/02 Eixo Y e portico/trilhoY_E parte 3de4 [1x].stl

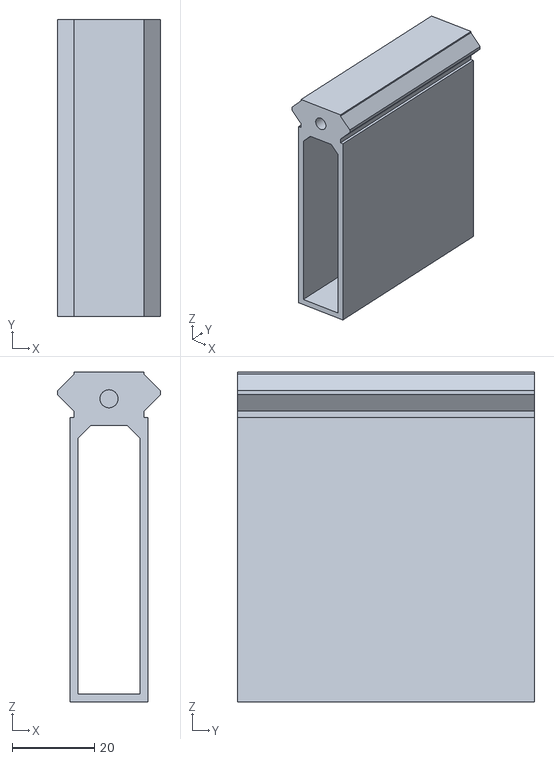
[picture p206: CAD file, 2026-10-27]
entrega/02b STL para imprimir na 100/02 Eixo Y e portico/trilhoY_E parte 3de4 [1x].stl
25.0 x 72.0 x 80.1
