WHdragon770/mulbot-corexy/entrega/02b STL para imprimir na 100/03 Eixo X e cabeca/carroX parte 1de2 [1x].stl

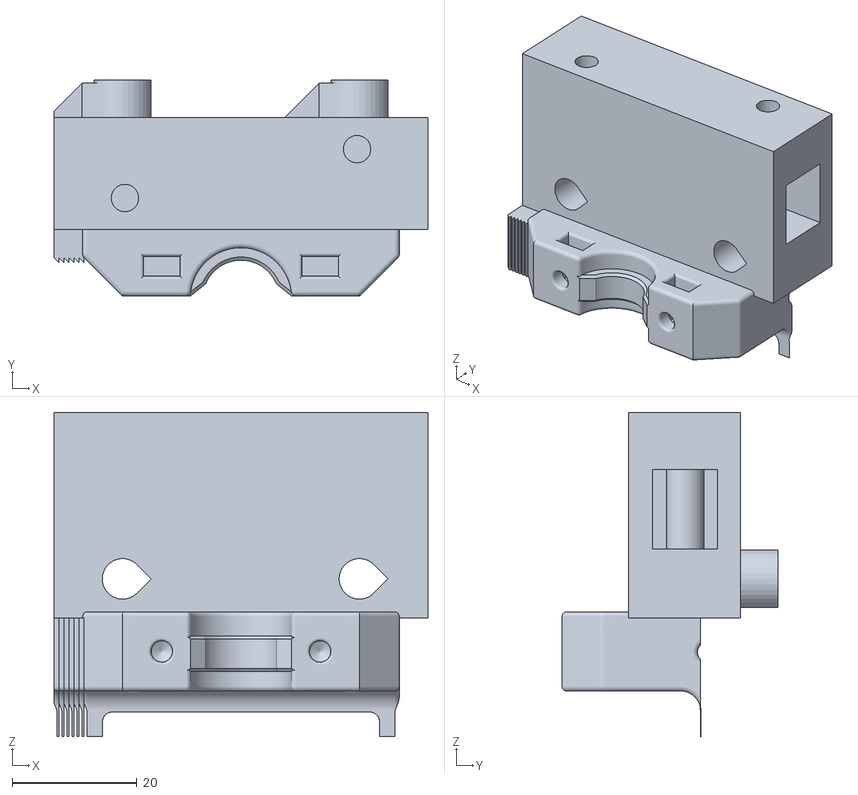
[picture p207: CAD file, 2026-10-27]
entrega/02b STL para imprimir na 100/03 Eixo X e cabeca/carroX parte 1de2 [1x].stl
60.0 x 34.6 x 52.0
