WHdragon770/mulbot-corexy/entrega/02b STL para imprimir na 100/06 Eletronica e display/DL1-05-02 luva 2 [1x].stl

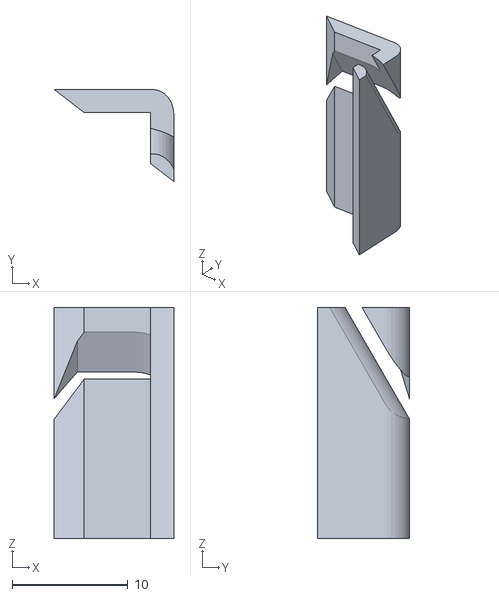
[picture p209: CAD file, 2026-10-27]
entrega/02b STL para imprimir na 100/06 Eletronica e display/DL1-05-02 luva 2 [1x].stl
10.4 x 7.96 x 20.0
