WHdragon770/mulbot-corexy/entrega/02b STL para imprimir na 100/09 Esteira porta-cabos/bandejaY_T parte 1de2 [1x].stl

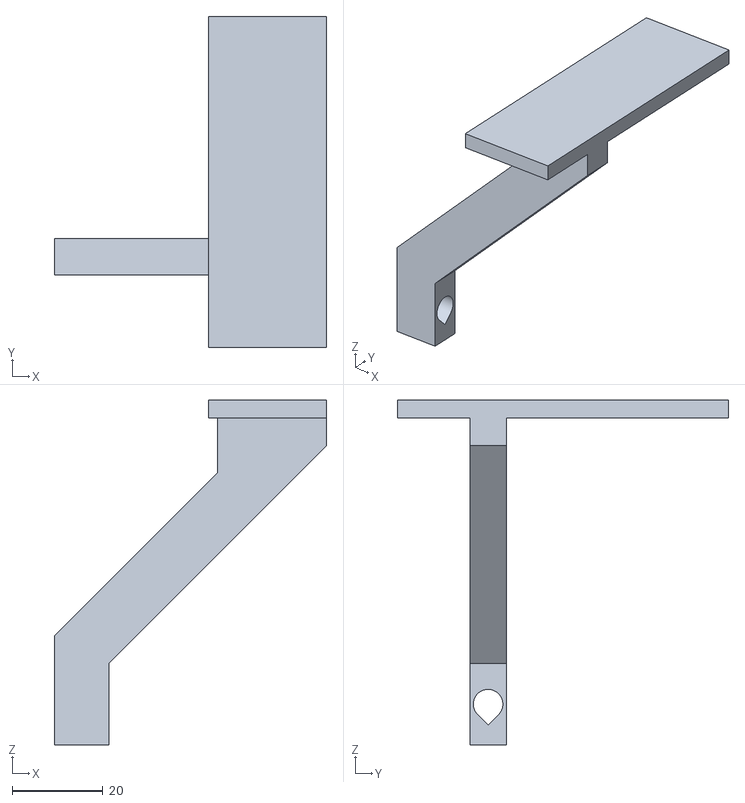
[picture p210: CAD file, 2026-10-27]
entrega/02b STL para imprimir na 100/09 Esteira porta-cabos/bandejaY_T parte 1de2 [1x].stl
60.0 x 73.0 x 76.0
