WHdragon770/mulbot-corexy/entrega/07 Mesa aquecida (opcional)/220 - 12V/STL para imprimir/localizador_aq220 [4x].stl

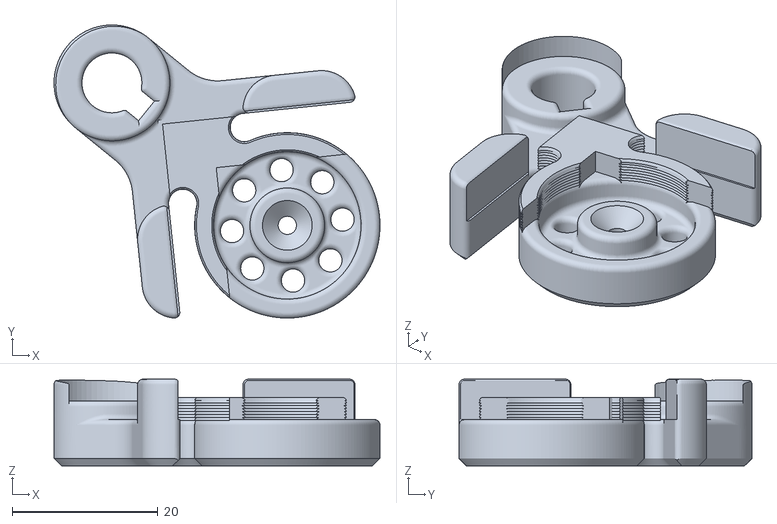
[picture p211: CAD file, 2026-10-21]
entrega/07 Mesa aquecida (opcional)/220 - 12V/STL para imprimir/localizador_aq220 [4x].stl
44.7 x 40.2 x 11.9
