WHdragon770/mulbot-corexy/out/anim/cabos/motorZ_D.stl

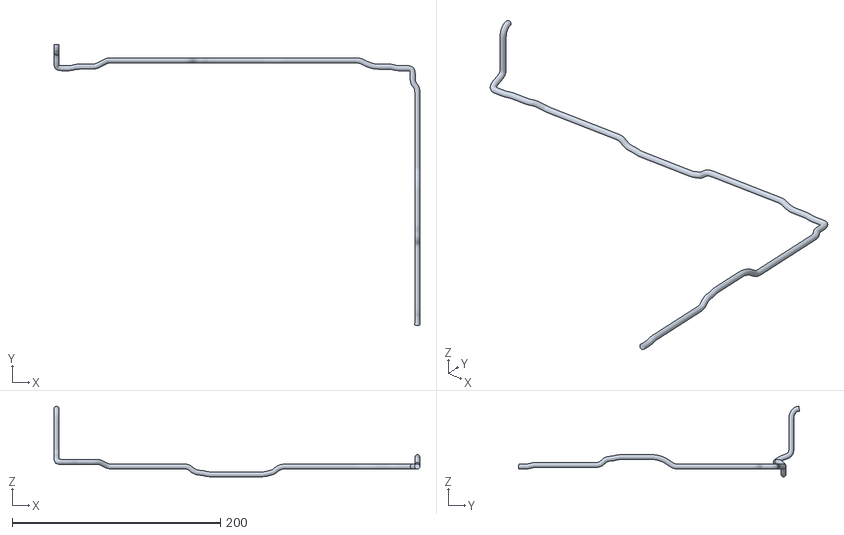
[picture p212: CAD file, 2026-10-28]
out/anim/cabos/motorZ_D.stl
351.5 x 270.0 x 67.8
