WHdragon770/mulbot-corexy/corexy100/entrega/02 STL para imprimir/04 Eixo Z e mesa/baseZSup_D [1x].stl

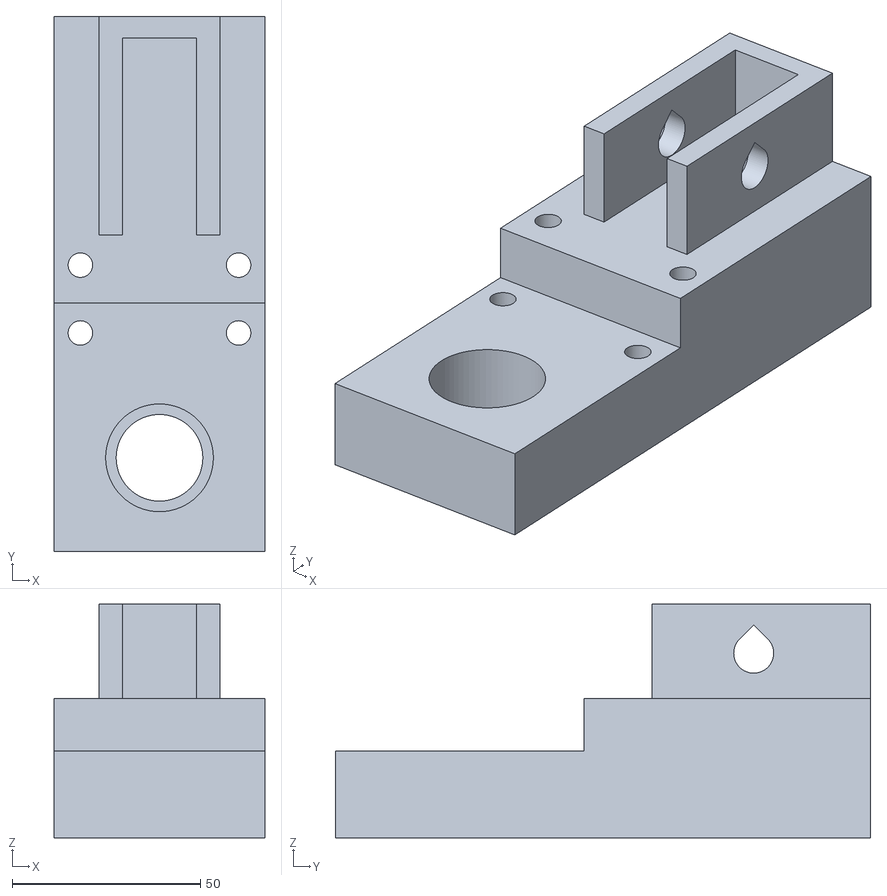
[picture p214: CAD file, 2026-10-27]
corexy100/entrega/02 STL para imprimir/04 Eixo Z e mesa/baseZSup_D [1x].stl
56.0 x 142.0 x 62.0
