WHdragon770/mulbot-corexy/corexy100/entrega/02 STL para imprimir/06 Eletronica e display/DL1-05-05 [1x].stl

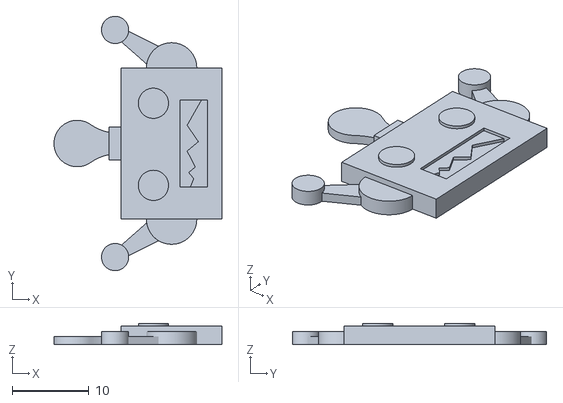
[picture p216: CAD file, 2026-10-20]
corexy100/entrega/02 STL para imprimir/06 Eletronica e display/DL1-05-05 [1x].stl
21.8 x 33.0 x 2.75
