WHdragon770/mulbot-corexy/corexy100/entrega/02 STL para imprimir/08 Parafusos e porcas impressos/parafuso_M6x30 [14x].stl

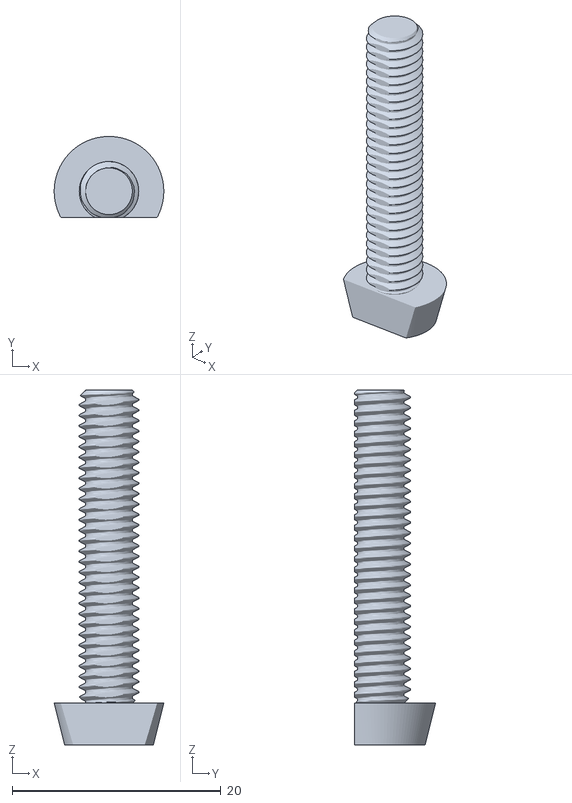
[picture p217: CAD file, 2026-10-20]
corexy100/entrega/02 STL para imprimir/08 Parafusos e porcas impressos/parafuso_M6x30 [14x].stl
10.5 x 7.77 x 34.0
