WHdragon770/mulbot-corexy/corexy100/entrega/02 STL para imprimir/09 Esteira porta-cabos/suporteEsteiraY [1x].stl

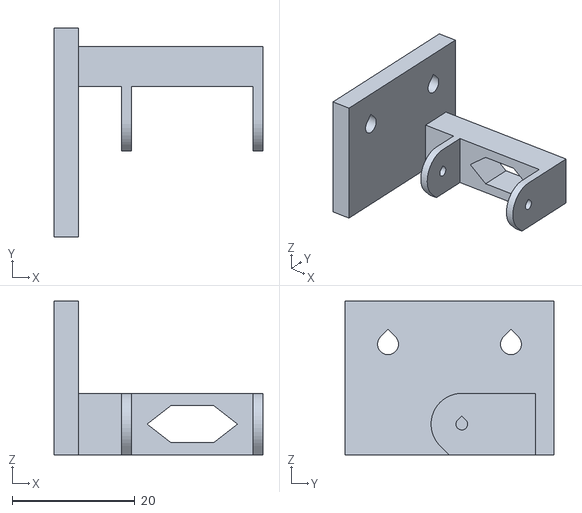
[picture p218: CAD file, 2026-10-27]
corexy100/entrega/02 STL para imprimir/09 Esteira porta-cabos/suporteEsteiraY [1x].stl
34.0 x 34.0 x 25.0
