WHdragon770/mulbot-corexy/corexy100/entrega/06 Placas de impressao/Kobra X (3MF)/01 Quadro - PLA.3mf

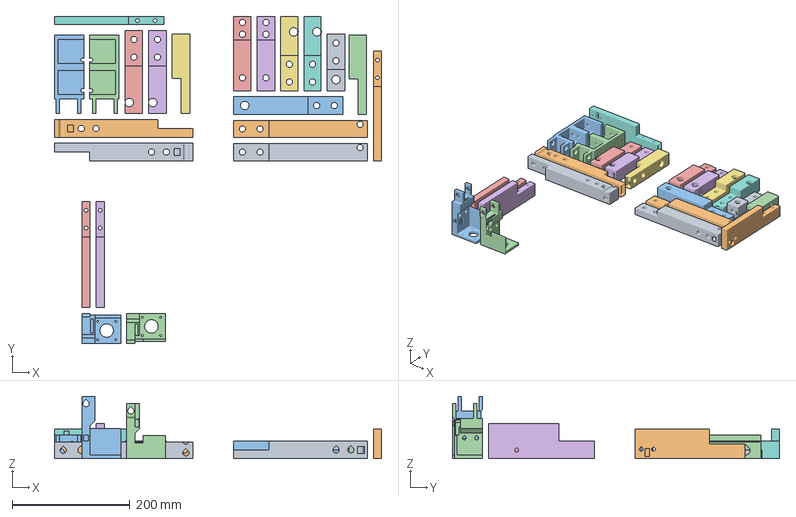
[picture p219: CAD file, 2026-10-28]
corexy100/entrega/06 Placas de impressao/Kobra X (3MF)/01 Quadro - PLA.3mf
555.5 x 555.0 x 105.9 mm
posteFrenteSup_D
posteFrenteSup_E
torreFrente_D
torreFrente_E
baseTras_D
baseTras_E
posteFrenteInf_D
travTras_D
posteTrasSup_D
posteTrasSup_E
baseFrente_E
posteFrenteInf_E
baseLatT_D
baseLatT_E
posteTrasInf_D
posteTrasInf_E
baseFrente_D
travTras_E
torreTras_D
torreTras_E
travFrente_D
travFrente_E
