WHdragon770/mulbot-corexy/corexy100/out/anim/cabos/motorA.stl

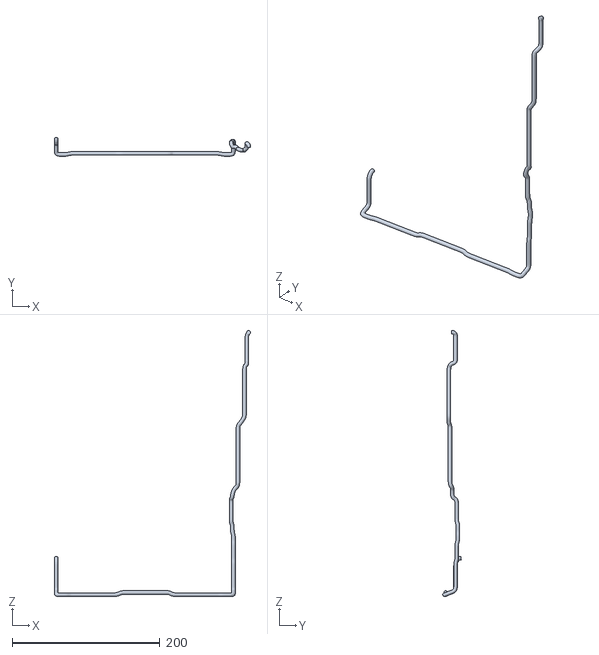
[picture p220: CAD file, 2026-10-27]
corexy100/out/anim/cabos/motorA.stl
265.7 x 25.3 x 360.1
