WHdragon770/mulbot-corexy/entrega/02b STL para imprimir na 100/04 Eixo Z e mesa/trilhoZ_E parte 2de3 [1x].stl

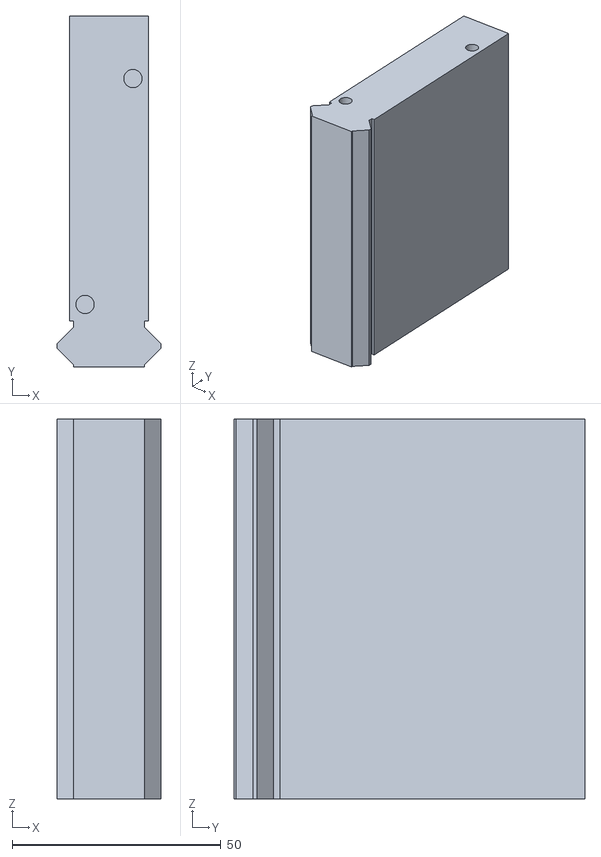
[picture p223: CAD file, 2026-10-27]
entrega/02b STL para imprimir na 100/04 Eixo Z e mesa/trilhoZ_E parte 2de3 [1x].stl
25.0 x 84.1 x 91.0
