WHdragon770/mulbot-corexy/entrega/02b STL para imprimir na 100/06 Eletronica e display/DL1-02-09_caixa_ramps luva 3 [1x].stl

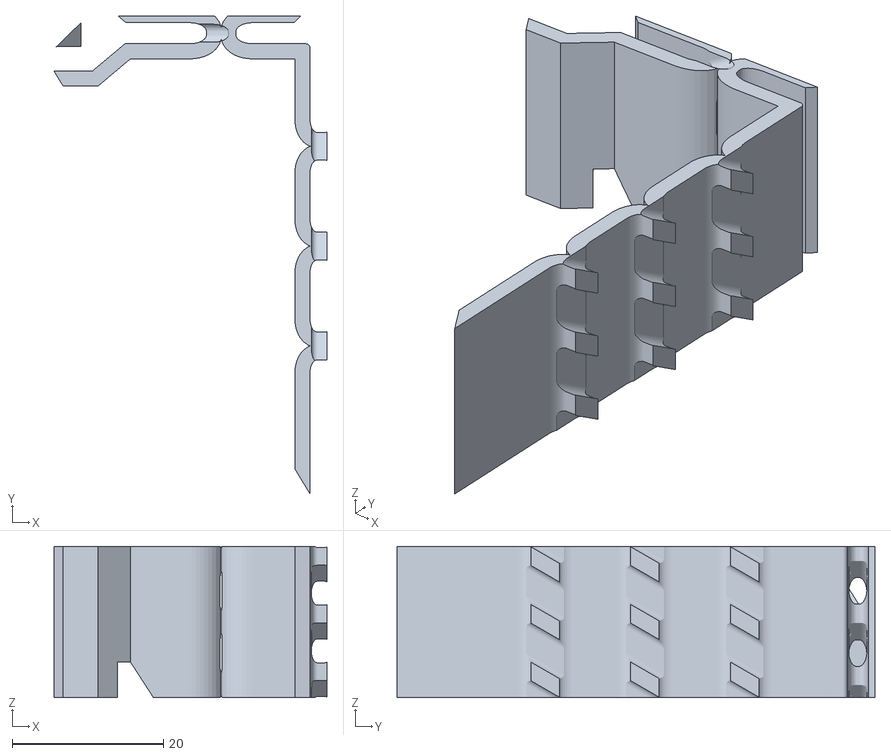
[picture p224: CAD file, 2026-10-27]
entrega/02b STL para imprimir na 100/06 Eletronica e display/DL1-02-09_caixa_ramps luva 3 [1x].stl
36.1 x 63.2 x 20.0
