WHdragon770/mulbot-corexy/guia_v/stl/mont_placa.stl

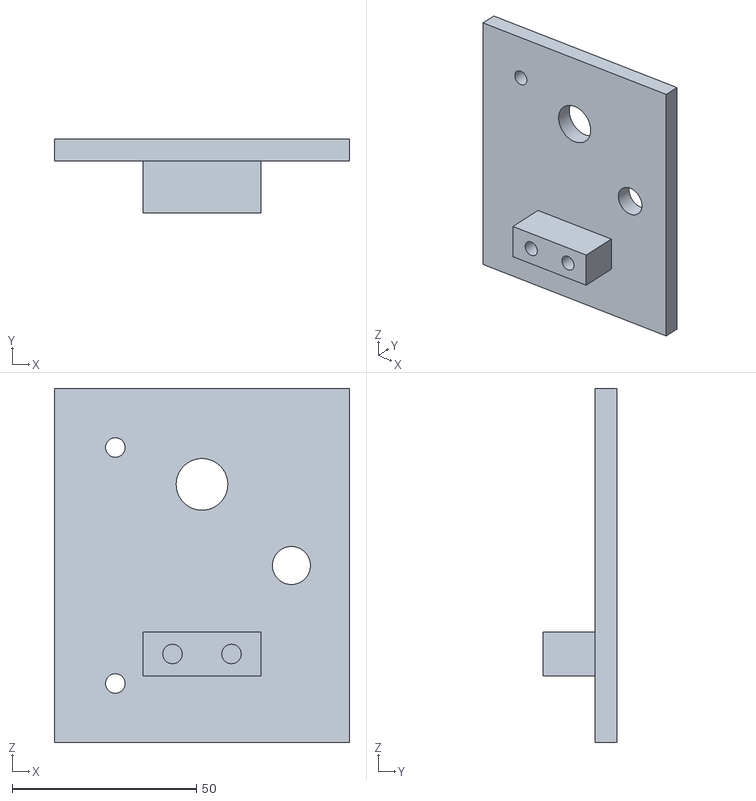
[picture p225: CAD file, 2026-10-30]
guia_v/stl/mont_placa.stl
80.0 x 20.0 x 96.0
