WHdragon770/mulbot-corexy/corexy100/entrega/02 STL para imprimir/01 Quadro/baseFrente_E [1x].stl

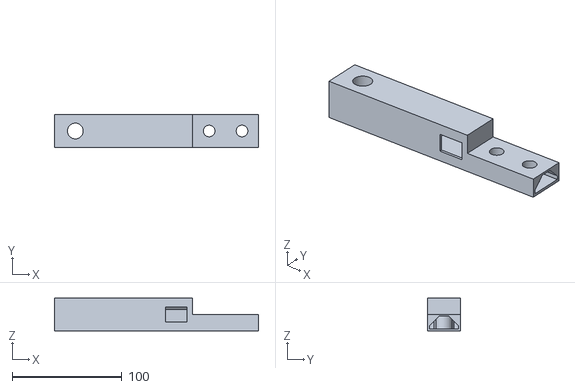
[picture p226: CAD file, 2026-10-28]
corexy100/entrega/02 STL para imprimir/01 Quadro/baseFrente_E [1x].stl
186.0 x 30.0 x 30.0
