WHdragon770/mulbot-corexy/corexy100/entrega/02 STL para imprimir/03 Eixo X e cabeca/DL1-04-07 [1x].stl

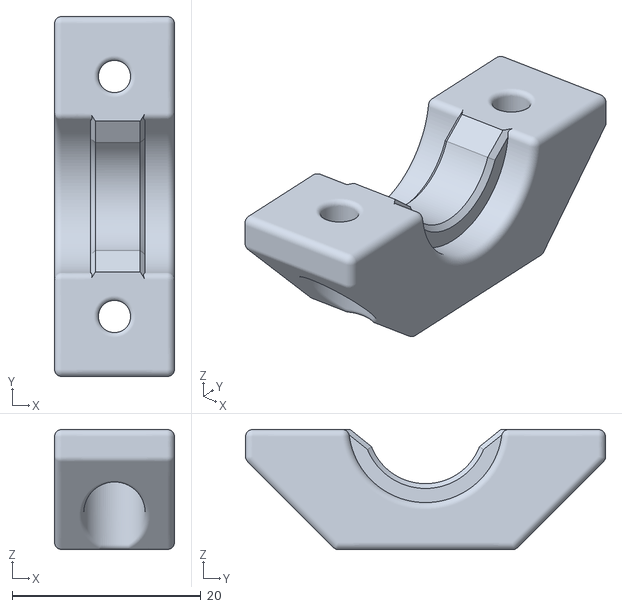
[picture p227: CAD file, 2026-10-20]
corexy100/entrega/02 STL para imprimir/03 Eixo X e cabeca/DL1-04-07 [1x].stl
12.7 x 38.1 x 12.7
