WHdragon770/mulbot-corexy/corexy100/entrega/02 STL para imprimir/05 Motores e polias/DL1-06-02_L10.0 [4x].stl

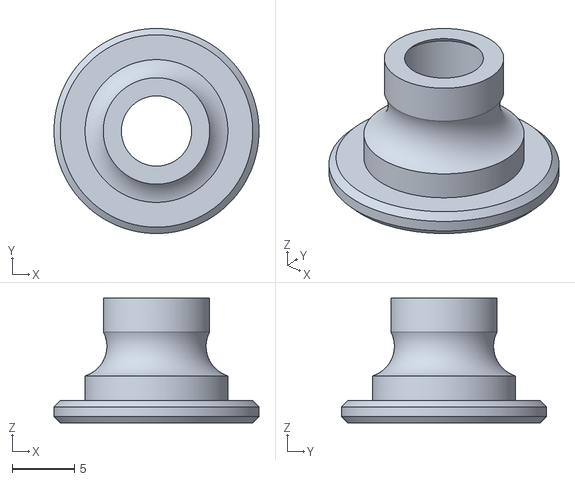
[picture p228: CAD file, 2026-10-20]
corexy100/entrega/02 STL para imprimir/05 Motores e polias/DL1-06-02_L10.0 [4x].stl
16.4 x 16.4 x 10.00
