WHdragon770/mulbot-corexy/corexy100/entrega/02 STL para imprimir/06 Eletronica e display/DL1-02-15 [1x].stl

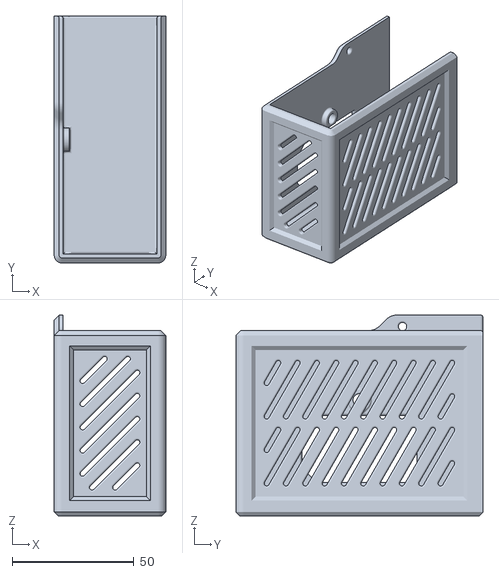
[picture p229: CAD file, 2026-10-20]
corexy100/entrega/02 STL para imprimir/06 Eletronica e display/DL1-02-15 [1x].stl
45.8 x 101.4 x 82.6
