WHdragon770/mulbot-corexy/corexy100/entrega/02 STL para imprimir/08 Parafusos e porcas impressos/porca_M6 [31x].stl

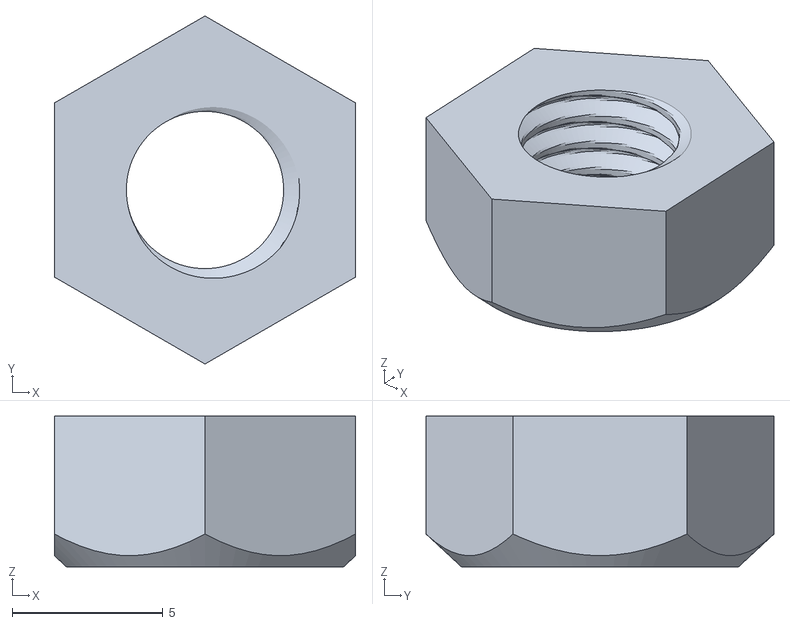
[picture p230: CAD file, 2026-10-20]
corexy100/entrega/02 STL para imprimir/08 Parafusos e porcas impressos/porca_M6 [31x].stl
10.0 x 11.5 x 5.00
