WHdragon770/mulbot-corexy/corexy100/entrega/02 STL para imprimir/09 Esteira porta-cabos/elo_esteira [17x].stl

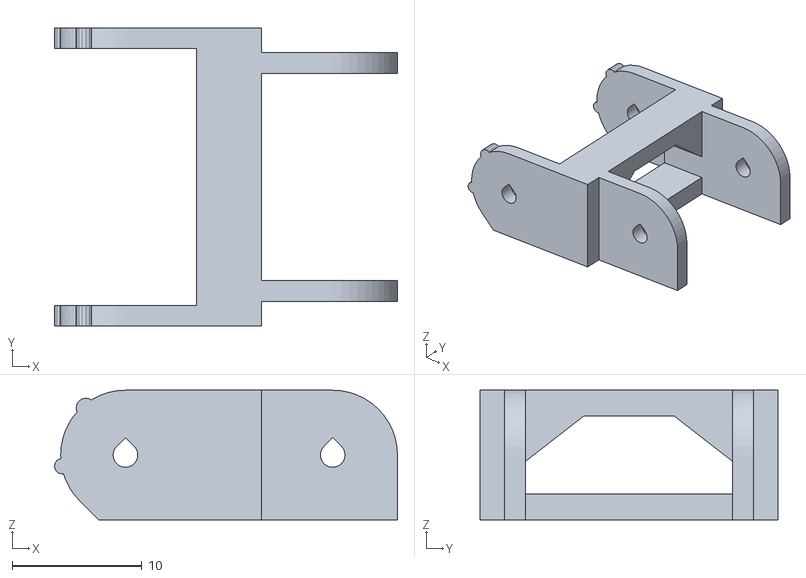
[picture p231: CAD file, 2026-10-21]
corexy100/entrega/02 STL para imprimir/09 Esteira porta-cabos/elo_esteira [17x].stl
26.5 x 23.0 x 10.0
