WHdragon770/mulbot-corexy/corexy100/entrega/06 Placas de impressao/Kobra X (3MF)/04 Eixo Z e mesa - PLA.3mf

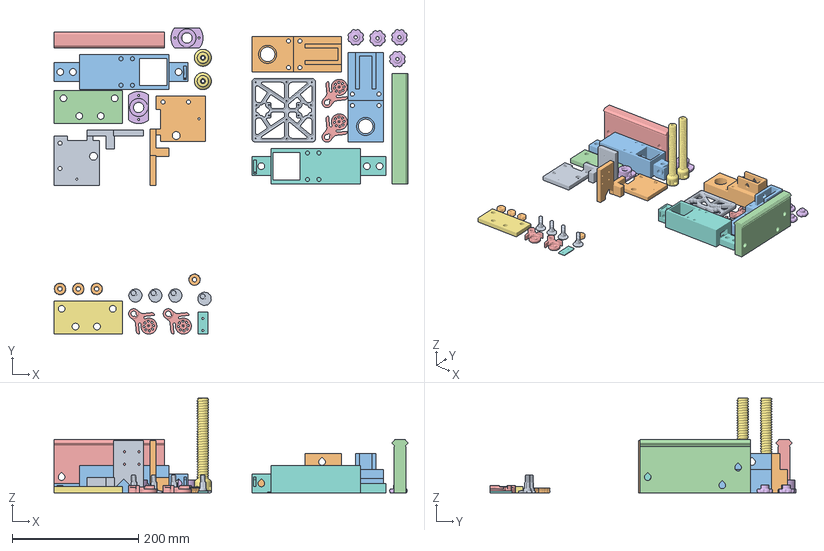
[picture p232: CAD file, 2026-10-28]
corexy100/entrega/06 Placas de impressao/Kobra X (3MF)/04 Eixo Z e mesa - PLA.3mf
560.0 x 484.4 x 150.0 mm
bracoMesa_D
bracoMesa_E
baseZInf_D
chapaZY_D
trilhoZ_D
porcaZ_DL1-04-06_rosca_nova x 2
fusoZ_250mm x 2
baseZInf_E
DL1-03-04_110
baseZSup_D
baseZSup_E
trilhoZ_E
localizador_aq120 x 4
DL1-03-05 x 4
chapaZY_E
calcoFimCursoZ
presilha_disco_aq x 4
DL1-03-08 x 4
