WHdragon770/mulbot-corexy/corexy100/out/anim/cabos/fimCursoZ.stl

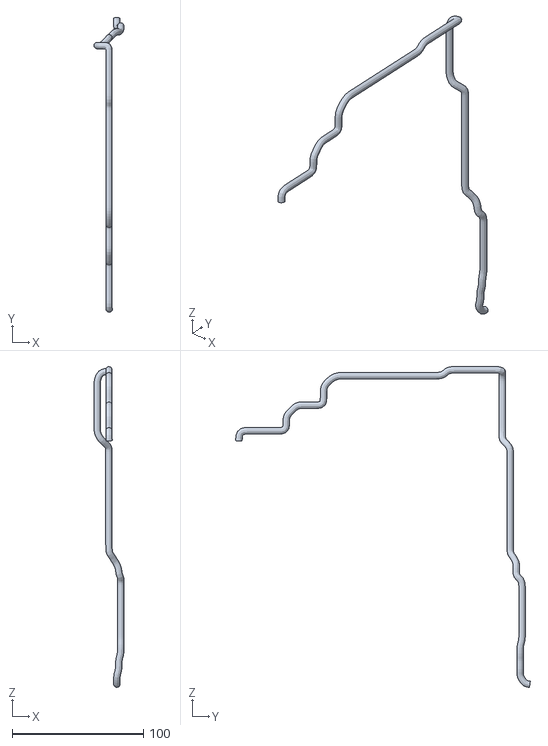
[picture p233: CAD file, 2026-10-27]
corexy100/out/anim/cabos/fimCursoZ.stl
22.9 x 224.9 x 245.0
