WHdragon770/mulbot-corexy/entrega/02b STL para imprimir na 100/04 Eixo Z e mesa/baseZSup_D parte 1de2 [1x].stl

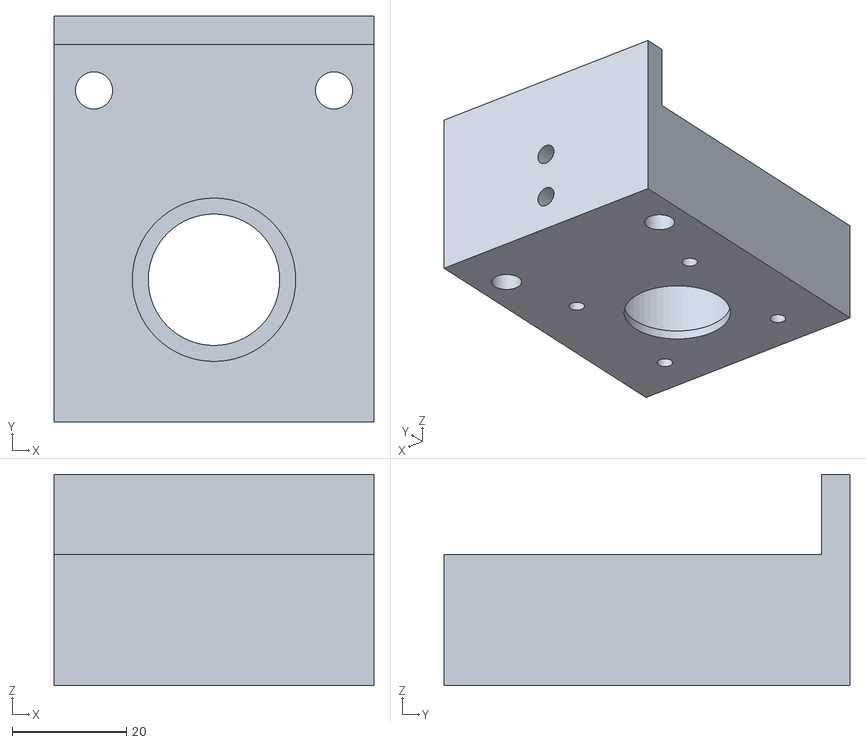
[picture p237: CAD file, 2026-10-27]
entrega/02b STL para imprimir na 100/04 Eixo Z e mesa/baseZSup_D parte 1de2 [1x].stl
56.0 x 71.0 x 37.0
