WHdragon770/mulbot-corexy/entrega/02b STL para imprimir na 100/06 Eletronica e display/DL1-02-10_porta_fechada parte 2de6 [1x].stl

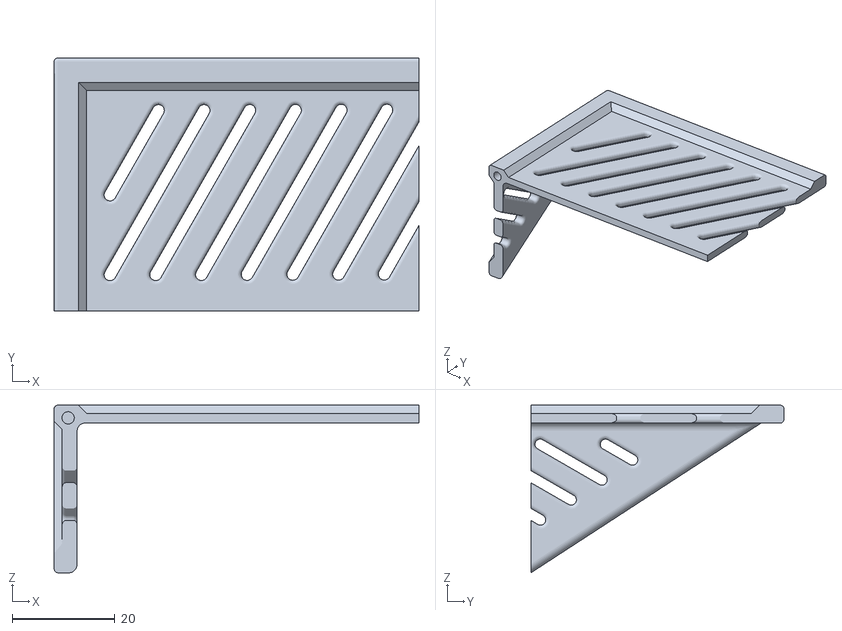
[picture p238: CAD file, 2026-10-27]
entrega/02b STL para imprimir na 100/06 Eletronica e display/DL1-02-10_porta_fechada parte 2de6 [1x].stl
71.0 x 49.2 x 32.6
