WHdragon770/mulbot-corexy/(list of files, cad)

Other CAD files:
entrega/07 Mesa aquecida (opcional)/220 - 12V/STL para imprimir/protecaoFonte360 [1x].stl
entrega/07 Mesa aquecida (opcional)/235 - 24V/STL para imprimir/protecaoFonte360 [1x].stl
corexy100/entrega/02 STL para imprimir/04 Eixo Z e mesa/bracoMesa_E [1x].stl
corexy100/entrega/06 Placas de impressao/Resina (Photon)/Alternativa - fuso Z em resina/porcaZ_DL1-04-06_rosca_nova [2x].stl
entrega/02b STL para imprimir na 100/00 Pinos/pino D fuso 9.2x24 mm [5x].stl
corexy100/entrega/02 STL para imprimir/04 Eixo Z e mesa/baseZInf_E [1x].stl
guia_v/stl/exp_bucha.stl
corexy100/entrega/02 STL para imprimir/01 Quadro/posteFrenteInf_D [1x].stl
corexy100/guia_v/stl/exp_bucha.stl
corexy100/out/anim/poses/correiaB_012.stl
entrega/02b STL para imprimir na 100/01 Quadro/travTras_D luva 1 [1x].stl
entrega/02b STL para imprimir na 100/09 Esteira porta-cabos/bandejaY_T parte 2de2 [1x].stl
out/anim/cabos/fonte.stl
corexy100/entrega/02 STL para imprimir/04 Eixo Z e mesa/calcoFimCursoZ [1x].stl
corexy100/guia_v/stl/print_bucha.stl
entrega/02b STL para imprimir na 100/09 Esteira porta-cabos/bandejaX luva 1 [1x].stl
corexy100/entrega/02 STL para imprimir/01 Quadro/DL1-01-08 [6x].stl
corexy100/entrega/02 STL para imprimir/01 Quadro/baseLatT_D [1x].stl
corexy100/entrega/02 STL para imprimir/01 Quadro/baseLatT_E [1x].stl
corexy100/entrega/02 STL para imprimir/01 Quadro/baseTras_D [1x].stl
corexy100/entrega/02 STL para imprimir/01 Quadro/baseTras_E [1x].stl
corexy100/entrega/02 STL para imprimir/01 Quadro/posteFrenteSup_D [1x].stl
corexy100/entrega/02 STL para imprimir/01 Quadro/posteTrasInf_E [1x].stl
corexy100/entrega/02 STL para imprimir/01 Quadro/posteTrasSup_D [1x].stl
corexy100/entrega/02 STL para imprimir/01 Quadro/posteTrasSup_E [1x].stl
corexy100/entrega/02 STL para imprimir/01 Quadro/torreFrente_D [1x].stl
corexy100/entrega/02 STL para imprimir/01 Quadro/torreFrente_E [1x].stl
corexy100/entrega/02 STL para imprimir/01 Quadro/torreTras_D [1x].stl
corexy100/entrega/02 STL para imprimir/01 Quadro/torreTras_E [1x].stl
corexy100/entrega/02 STL para imprimir/01 Quadro/travFrente_D [1x].stl
corexy100/entrega/02 STL para imprimir/01 Quadro/travFrente_E [1x].stl
corexy100/entrega/02 STL para imprimir/01 Quadro/travTras_D [1x].stl
corexy100/entrega/02 STL para imprimir/01 Quadro/travTras_E [1x].stl
corexy100/entrega/02 STL para imprimir/04 Eixo Z e mesa/DL1-03-04_110 [1x].stl
corexy100/entrega/02 STL para imprimir/04 Eixo Z e mesa/DL1-03-05 [4x].stl
corexy100/entrega/02 STL para imprimir/04 Eixo Z e mesa/DL1-03-08 [4x].stl
corexy100/entrega/02 STL para imprimir/04 Eixo Z e mesa/Fuso e porca - Resina (alternativa)/fusoZ_metade_baixo_125mm [2x].stl
corexy100/entrega/02 STL para imprimir/04 Eixo Z e mesa/Fuso e porca - Resina (alternativa)/fusoZ_metade_cima_125mm [2x].stl
corexy100/entrega/02 STL para imprimir/04 Eixo Z e mesa/Fuso e porca - Resina (alternativa)/fusoZ_pino_D [2x].stl
corexy100/entrega/02 STL para imprimir/04 Eixo Z e mesa/Fuso e porca - Resina (alternativa)/porcaZ_DL1-04-06_rosca_nova [2x].stl
corexy100/entrega/02 STL para imprimir/04 Eixo Z e mesa/baseZSup_E [1x].stl
corexy100/entrega/02 STL para imprimir/04 Eixo Z e mesa/chapaZY_D [1x].stl
corexy100/entrega/02 STL para imprimir/04 Eixo Z e mesa/chapaZY_E [1x].stl
corexy100/entrega/02 STL para imprimir/04 Eixo Z e mesa/localizador_aq120 [4x].stl
corexy100/entrega/02 STL para imprimir/04 Eixo Z e mesa/presilha_disco_aq [4x].stl
corexy100/entrega/02 STL para imprimir/04 Eixo Z e mesa/trilhoZ_D [1x].stl
corexy100/entrega/02 STL para imprimir/04 Eixo Z e mesa/trilhoZ_E [1x].stl
corexy100/entrega/02 STL para imprimir/05 Motores e polias/DL1-06-04 [16x].stl
corexy100/entrega/02 STL para imprimir/06 Eletronica e display/DL1-02-09_caixa_ramps [1x].stl
corexy100/entrega/02 STL para imprimir/06 Eletronica e display/DL1-02-11 [1x].stl
corexy100/entrega/02 STL para imprimir/06 Eletronica e display/DL1-05-04 [1x].stl
corexy100/entrega/02 STL para imprimir/07 Roldanas V (X, Y e Z) - Resina/buchaX_excentrica_espacador [1x].stl
corexy100/entrega/02 STL para imprimir/07 Roldanas V (X, Y e Z) - Resina/buchaY_excentrica_espacador [2x].stl
corexy100/entrega/02 STL para imprimir/07 Roldanas V (X, Y e Z) - Resina/buchaZ_excentrica [2x].stl
corexy100/entrega/02 STL para imprimir/07 Roldanas V (X, Y e Z) - Resina/roldanaV_rolamento_1peca_resina [15x].stl
corexy100/entrega/02 STL para imprimir/08 Parafusos e porcas impressos/barril_M10_D14x19 [8x].stl
corexy100/entrega/02 STL para imprimir/08 Parafusos e porcas impressos/barril_M10_D14x30 [8x].stl
corexy100/entrega/02 STL para imprimir/08 Parafusos e porcas impressos/barril_M6_D9x10 [2x].stl
corexy100/entrega/02 STL para imprimir/08 Parafusos e porcas impressos/barril_M6_D9x19 [4x].stl
corexy100/entrega/02 STL para imprimir/08 Parafusos e porcas impressos/parafuso_M10x40 [24x].stl
corexy100/entrega/02 STL para imprimir/08 Parafusos e porcas impressos/parafuso_M10x45 [6x].stl
corexy100/entrega/02 STL para imprimir/08 Parafusos e porcas impressos/parafuso_M10x55 [14x].stl
corexy100/entrega/02 STL para imprimir/08 Parafusos e porcas impressos/parafuso_M10x60 [4x].stl
corexy100/entrega/02 STL para imprimir/08 Parafusos e porcas impressos/parafuso_M6x22 [2x].stl
corexy100/entrega/02 STL para imprimir/08 Parafusos e porcas impressos/parafuso_M6x35 [10x].stl
corexy100/entrega/02 STL para imprimir/08 Parafusos e porcas impressos/parafuso_M6x40 [3x].stl
corexy100/entrega/02 STL para imprimir/08 Parafusos e porcas impressos/parafuso_M6x60 [2x].stl
corexy100/entrega/02 STL para imprimir/08 Parafusos e porcas impressos/parafuso_M6x70 [2x].stl
corexy100/entrega/02 STL para imprimir/08 Parafusos e porcas impressos/porca_M10 [32x].stl
corexy100/entrega/02 STL para imprimir/09 Esteira porta-cabos/pontaFixa_esteira [2x].stl
corexy100/entrega/06 Placas de impressao/Kobra X (3MF)/01 Quadro - DL1-01-08 - TPU.3mf
corexy100/entrega/06 Placas de impressao/Kobra X (3MF)/05 Motores e polias - DL1-04-08 - PETG.3mf
corexy100/entrega/06 Placas de impressao/Kobra X (3MF)/05 Motores e polias - PLA.3mf
corexy100/entrega/06 Placas de impressao/Kobra X (3MF)/06 Eletronica e display - PLA.3mf
corexy100/entrega/06 Placas de impressao/Kobra X (3MF)/08 Parafusos e porcas impressos - PLA.3mf
corexy100/final/corexy_montagem_leve.blend
corexy100/guia_v/stl/corte_parafuso.stl
corexy100/guia_v/stl/corte_placa.stl
corexy100/guia_v/stl/corte_porca.stl
corexy100/guia_v/stl/corte_poste.stl
corexy100/guia_v/stl/corte_rolamento.stl
corexy100/guia_v/stl/corte_roldana.stl
corexy100/guia_v/stl/exp_parafuso.stl
corexy100/guia_v/stl/exp_placa.stl
corexy100/guia_v/stl/exp_porca.stl
corexy100/guia_v/stl/exp_rolamento.stl
corexy100/guia_v/stl/mont_espacador.stl
corexy100/guia_v/stl/mont_parafuso.stl
corexy100/guia_v/stl/mont_porca.stl
corexy100/guia_v/stl/mont_roldana.stl
corexy100/guia_v/stl/print_roldana.stl
corexy100/out/anim/cabos/cabeca.stl
corexy100/out/anim/cabos/fonte.stl
corexy100/out/anim/cabos/motorZ_E.stl
corexy100/out/anim/poses/correiaA_000.stl
corexy100/out/anim/poses/correiaA_001.stl
corexy100/out/anim/poses/correiaA_002.stl
corexy100/out/anim/poses/correiaA_003.stl
corexy100/out/anim/poses/correiaA_004.stl
corexy100/out/anim/poses/correiaA_005.stl
corexy100/out/anim/poses/correiaA_006.stl
corexy100/out/anim/poses/correiaA_007.stl
corexy100/out/anim/poses/correiaA_008.stl
corexy100/out/anim/poses/correiaA_009.stl
corexy100/out/anim/poses/correiaA_010.stl
corexy100/out/anim/poses/correiaA_011.stl
corexy100/out/anim/poses/correiaA_012.stl
corexy100/out/anim/poses/correiaA_013.stl
corexy100/out/anim/poses/correiaA_014.stl
corexy100/out/anim/poses/correiaA_015.stl
corexy100/out/anim/poses/correiaA_016.stl
corexy100/out/anim/poses/correiaA_017.stl
corexy100/out/anim/poses/correiaA_018.stl
corexy100/out/anim/poses/correiaA_019.stl
corexy100/out/anim/poses/correiaA_020.stl
corexy100/out/anim/poses/correiaA_021.stl
corexy100/out/anim/poses/correiaA_022.stl
corexy100/out/anim/poses/correiaA_023.stl
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
