WHdragon770/mulbot-corexy/RENDER_INSTRUCOES.txt

MULBOT COREXY 200³ — INSTRUÇÕES PARA RENDERIZAR O VÍDEO DE MONTAGEM
=====================================================================
Escrito para outro Claude (ou pessoa) conseguir baixar este repositório e renderizar o vídeo
EXATAMENTE como foi planejado. Siga na ordem. Não mude parâmetros sem motivo: os tempos e o
resultado abaixo foram medidos com eles.

---------------------------------------------------------------------
0. ESTADO (28/10/2026): PODE RENDERIZAR DIRETO
---------------------------------------------------------------------
A máquina ganhou a esteira porta-cabos e o reprojeto sem suporte depois do roteiro de 20/10. Tudo já foi
refeito e está neste repositório: out/anim/poses (60 poses com a esteira), out/anim/cabos, out/anim/custo.json,
out/cabos_pontos.json e scripts/video/anima2.py (peças da esteira na etapa "Eletronica e display"; câmeras
gerais da 200 afastadas com K = 1.3; close das rodas Y pelo lado E). Não precisa rodar poses.py nem
cabos_caminhos.py. Conferido com 16 quadros de prévia em 28/10.

---------------------------------------------------------------------
1. O QUE É O VÍDEO
---------------------------------------------------------------------
1280 x 720, 24 fps, 2562 quadros = 106,75 s, H.264 + som AAC 48 kHz estéreo, legendas desenhadas por cima.
Render: Blender 4.2.3, Cycles, 24 amostras + denoise OpenImageDenoise, max bounces 4, transparent bounces 24,
cor AgX "Medium High Contrast". Roteiro, câmeras e animação em scripts/video/anima2.py.
VISUAL (scripts/video/visual.py, pedido do Aleixo — NÃO voltar pro visual chapado da prévia):
  - fundo CINZA LISO, SEM CHÃO (a câmera vê cinza; as peças recebem luz de estúdio do céu + 3 sóis:
    principal, contraluz e preenchimento);
  - plástico impresso com brilho leve (coat), LINHAS DE CAMADA de 0,25 mm (bump) e realce nas quinas (bevel 0,5 mm);
  - aço / alumínio escovado / latão metálicos, vidro de verdade (transmissão), PCB com verniz, LCD aceso.

Roteiro (quadros → segundos):
   1–96     (0–4 s)     título "MULBOT COREXY 200³" sobre o chão vazio, câmera descendo
   97–960   (4–40 s)    montagem em 9 etapas de 4 s (Quadro, Eixo Z e mesa, Torres e motores A/B,
                         Vigas Y com guia em V, Pórtico, Carro X e hotend, Polias e correias, Extrusora
                         direta, Eletrônica e display). Peças voam até o lugar, parafusos chegam por último,
                         câmera orbita perto de cada conjunto.
   961–1104 (40–46 s)   máquina montada, órbita
   1105–1224            close: rodas V do carro Y
   1225–1344            close: carro X (por trás)
   1345–1464            close: PRESILHA DO VIDRO — a mesa inteira (suporte, vidro, knobs, localizadores,
                         presilhas) desce 150 mm, a presilha gira meia volta e volta; câmera por baixo do
                         pórtico; entra com corte seco
   1465–1584            vista de cima: caminho das correias (corte seco)
   1585–1704            caixa da RAMPS e fonte
   1705–1896 (71–79 s)  PASSAGEM DE CABOS: o quadro (bases, postes, travessas, trilhos Y, torres) fica translúcido
                         e os 9 cabos (out/anim/cabos, coloridos e com brilho) são "puxados" um a um do aparelho
                         até a caixa da RAMPS por dentro do quadro oco; depois o quadro volta sólido
   1897–2136 (79–89 s)  FUNCIONANDO: 60 poses reais (out/anim/poses) — cabeça faz um laço em X/Y, a mesa
                         desce, sobe e desce (10 a 120 mm) com o vidro junto; correias trocadas a cada pose
   2137–2418            vista explodida: abre (aberta em 2197), câmera mergulha no pórtico direito
                         (2227–2346, 93–98 s): os 10 ROLETES saem de dentro de cada roldana V e cada POLIA LOUCA
                         se separa em eixo / gaiola de esferas / polia; fecham, câmera volta e a máquina junta
   2419–2562            final com título

Som (scripts/video/som.py, sintetizado, sem arquivo externo): trilha Am–F–C–G a 96 bpm, whoosh quando
as peças chegam, tique nos parafusos, catraca da presilha, zumbido dos motores de passo com o tom pela
velocidade real de cada motor (A, B e Z), explosão/encaixe, sino na abertura e no final.

---------------------------------------------------------------------
2. O QUE PRECISA ESTAR INSTALADO
---------------------------------------------------------------------
- Linux x86_64 (Ubuntu 22.04/24.04 ou WSL2). Testado em WSL2 Ubuntu.
- Blender 4.2.3 (LTS) — versão EXATA:
    mkdir -p ~/.local/opt && cd ~/.local/opt
    wget https://download.blender.org/release/Blender4.2/blender-4.2.3-linux-x64.tar.xz
    tar xf blender-4.2.3-linux-x64.tar.xz
  (o script procura em ~/.local/opt/blender-4.2.3-linux-x64/blender; outro lugar: export BLENDER=/caminho/blender)
  Bibliotecas que o Blender pede no Ubuntu/WSL sem interface:
    sudo apt install libxi6 libxkbcommon0 libsm6 libgl1 libxrender1 libxxf86vm1 libxfixes3
- Python 3 com: numpy scipy pillow imageio-ffmpeg
    pip install numpy scipy pillow imageio-ffmpeg
  (o imageio-ffmpeg traz o ffmpeg; não precisa instalar ffmpeg no sistema)
- Fonte DejaVu (legendas): sudo apt install fonts-dejavu-core

---------------------------------------------------------------------
3. RENDERIZAR (1 comando)
---------------------------------------------------------------------
    cd <pasta do repositório>
    ./scripts/video/render_noite.sh "" cycles
  Com placa de vídeo (MESMO resultado, bem mais rápido):
    CYCLES_DEVICE=OPTIX ./scripts/video/render_noite.sh "" cycles      (NVIDIA RTX)
    CYCLES_DEVICE=CUDA  ...   (NVIDIA antiga)   |   CYCLES_DEVICE=HIP ... (AMD)
  Agendar pra começar mais tarde:  ./scripts/video/render_noite.sh "19:00" cycles

O que ele faz:
  a) roda anima2.py em modo "info" (monta a linha do tempo e grava out/anim/linha.json);
  b) renderiza em blocos de 120 quadros, 1 Blender por bloco, PNGs em out/anim/quadros_cycles/f0001.png...;
     é RESUMÍVEL: se cair, rode o mesmo comando de novo — quadros prontos são pulados;
  c) gera o som (som.py → out/anim/som.wav) e monta o MP4 com legendas (monta.py);
  d) saída: final/video/corexy_video_cycles.mp4
Progresso: out/anim/progresso_cycles.txt (linha "quadro N de 2562 - termina ~HH:MM"), log em out/anim/render_cycles.log.
Prévia rápida (Workbench 640x360, ~35 min em CPU): ./scripts/video/render_noite.sh "" previa

IMPORTANTE:
- NÃO rode 2 Blenders ao mesmo tempo numa máquina com pouca RAM: cada um usa ~1,5 GB (no WSL de 3 GB do
  Aleixo isso trava o PC).
- NÃO regenere as poses (scripts/video/poses.py): elas precisam do ambiente completo de geometria (cxy.py +
  scripts da Mulbot + modelos originais). As poses prontas estão em out/anim/poses e são as certas.
- NÃO use EEVEE em máquina sem GPU: no WSL ele cai no llvmpipe e fica MAIS lento que o Cycles.

---------------------------------------------------------------------
4. QUANTO TEMPO LEVA
---------------------------------------------------------------------
Medido em CPU (12 threads, WSL2, 1 Blender, processador livre), quadros reais do vídeo:
Visual novo (vidro, bevel, transparência), medido em 2026-10-20:
   título 7 s | montagem 12–16 s | montada 15 s | closes 36–44 s | cabos 38–41 s | funcionando 20–23 s |
   close da explodida 40 s | final 18 s
   TOTAL em CPU: ~16,6 h de quadros + carga dos blocos + som/MP4 ≈ 17 h (com margem: 19 h)
   → em CPU NÃO cabe numa noite; use GPU. Em GPU RTX o normal é 10–30x mais rápido (1–2 h).
A estimativa da barra (scripts/video/estimativa.py) usa o PESO de cada quadro (out/anim/custo.json =
triângulos visíveis por quadro), não a média simples — o começo do vídeo é leve (máquina vazia) e o
fim é pesado. Para medir na sua máquina antes de começar (5 min):
   QUADROS=60,450,900,1160,1420,1850,2000,2297,2520 blender -b final/corexy_montagem_leve.blend \
      -P scripts/video/anima2.py -- bench out/anim/bench
   (imprime "TEMPO quadro segundos"; interpole entre eles e some os 2562 quadros)

---------------------------------------------------------------------
5. CONFERIR O RESULTADO (checklist)
---------------------------------------------------------------------
[ ] MP4 com 106,75 s, 1280x720, 24 fps, áudio AAC estéreo
     python3 -c "import imageio_ffmpeg,subprocess;print(subprocess.run([imageio_ffmpeg.get_ffmpeg_exe(),'-i','final/video/corexy_video_cycles.mp4'],capture_output=True,text=True).stderr)"
[ ] 0–4 s: título; 4–40 s: legendas "1/9 Quadro ..." até "9/9 Eletrônica e display"
[ ] ~56–61 s (presilha): suporte da mesa, vidro e presilhas descem JUNTOS; o botão gira meia volta em
     volta do pino e volta; nada de tela vermelha/azul cheia (câmera dentro de peça)
[ ] fundo cinza liso em TODO o vídeo, sem chão; plástico com brilho e linhas de camada nos closes
[ ] 71–79 s (cabos): quadro translúcido, 9 cabos coloridos aparecem um a um e chegam na caixa da RAMPS
[ ] 79–89 s (funcionando): mesa sobe e desce com o vidro junto, cabeça andando, correias acompanhando,
     som dos motores mudando de tom
[ ] 89–101 s: explodida abre; close no pórtico com os roletes fora da roldana e a polia separada; fecha
     com o baque (nenhuma peça desce abaixo de z = -22: anima2.py, CHAO = -25); final com o título
[ ] som sem estourar (pico ~0,8), música baixa por baixo dos efeitos

Se algum quadro sair errado, apague só os PNGs daquele trecho em out/anim/quadros_cycles e rode de novo.

---------------------------------------------------------------------
6. ARQUIVOS DESTE REPOSITÓRIO QUE O RENDER USA
---------------------------------------------------------------------
  final/corexy_montagem_leve.blend   montagem inteira (malhas decimadas; o .blend cheio tem 190 MB e não
                                     é necessário)
  out/cxy.json                       posição de cada peça na pose padrão (o anima2 calcula os deslocamentos)
  out/anim/poses/                    poses.json + correiaA/B_000..059.stl (máquina funcionando)
  out/anim/custo.json                triângulos visíveis por quadro (estimativa de tempo)
  out/anim/cabos/                    cabos.json + 9 tubos STL da cena de passagem de cabos (prontos; o gerador
                                     scripts/video/cabos_caminhos.py precisa da geometria completa, NÃO regenere)
  scripts/video/anima2.py            roteiro, câmeras, animação, render (modos: cycles | previa | info | bench)
  scripts/video/visual.py            fundo cinza, luz de estúdio e materiais (chamado pelo anima2.py)
  scripts/video/som.py               trilha sonora
  scripts/video/monta.py             legendas + MP4
  scripts/video/estimativa.py        horário de término
  scripts/video/render_noite.sh      faz tudo
  scripts/video/custo.py             regera custo.json (só se mudar o roteiro):
      blender -b final/corexy_montagem_leve.blend -P scripts/video/anima2.py -P scripts/video/custo.py -- info /tmp/x

---------------------------------------------------------------------
7. CORREÇÕES JÁ FEITAS (não desfazer)
---------------------------------------------------------------------
- Peças da Mulbot no .blend se chamam "DL1-03-04_110 | mesa_suporteMesa": o anima2.py tira o prefixo, senão
  mesa/knobs/polias não acham as poses e ficam paradas enquanto o vidro anda.
- Close da presilha: a mesa desce 150 mm (no alto ela fica colada no pórtico e a câmera não via nada) e o giro
  tem 1 chave por quadro (a origem da peça fica longe do pino; com poucas chaves ela "voava").
- Vista explodida: o deslocamento vertical de cada peça é limitado pra ela parar 3 mm acima do chão.
- Funcionando: a mesa desce, sobe e desce (10 a 120 mm), com o vidro junto.
- Cena dos cabos: o quadro usa CÓPIAS dos materiais ("cinza_quadro" etc., slot ligado ao objeto) com um nó Value
  "fantasma" animado; a prévia (Workbench) usa o alfa da cor de viewport. Os cabos aparecem com o modificador
  Build (as faces do tubo estão em ordem do aparelho até a RAMPS) e somem quando a máquina começa a andar.
- Explodida fina: o eixo de cada anel de roletes / gaiola é a direção de menor espalhamento dos vértices
  (anima2.py, eixo()); roletes saem 32 mm, peças da polia louca abrem 16 mm + 14 mm por camada.
