WHdragon770/mulbot-corexy/corexy100/trab/prog_manual.txt

0 1 gerando o PDF (capa, guias, lista, folhas, detalhes)
FIM Manual completo da CoreXY 100: PDF 25 páginas em 03 Desenhos de montagem
