WHdragon770/mulbot-corexy/corexy100/entrega/01 Montagem 3D/topo.png

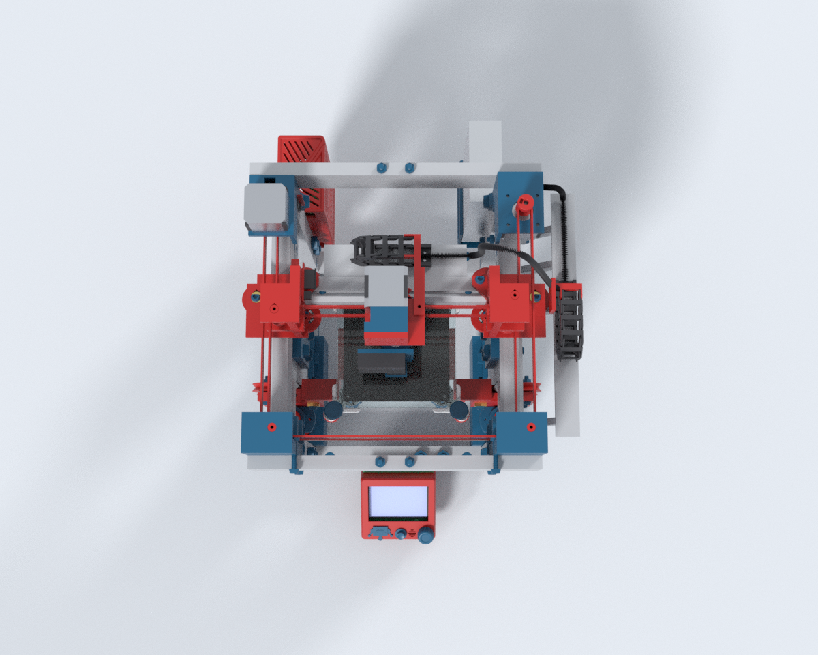
corexy100/entrega/01 Montagem 3D/topo.png
