WHdragon770/mulbot-corexy/corexy100/entrega/03 Desenhos de montagem/CXY-00 - Capa e indice.png

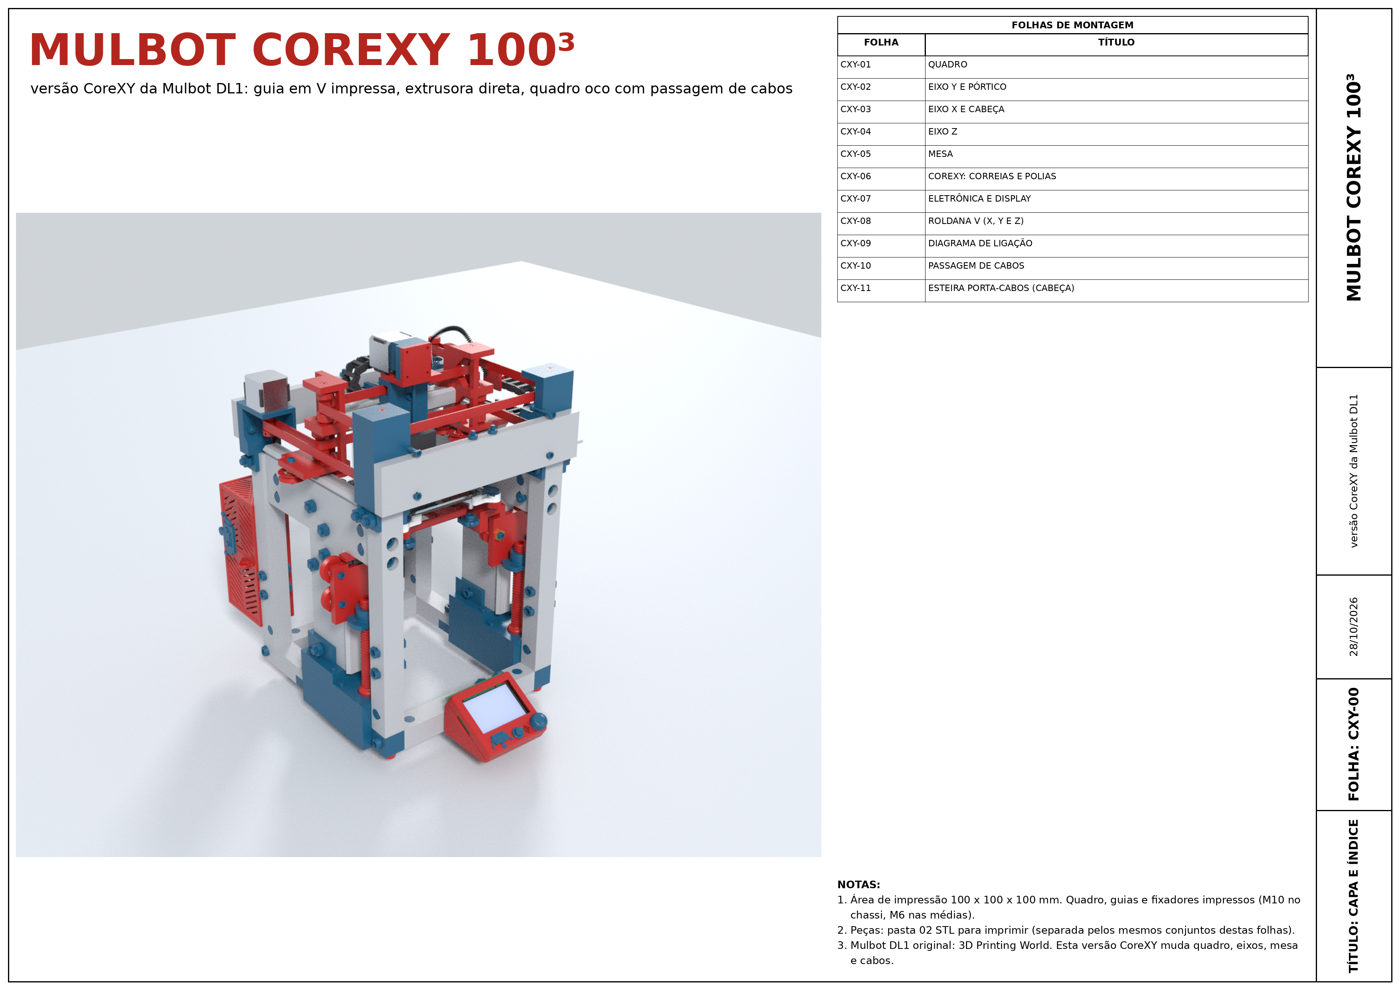
corexy100/entrega/03 Desenhos de montagem/CXY-00 - Capa e indice.png
