WHdragon770/mulbot-corexy/corexy100/entrega/03 Desenhos de montagem/CXY-01 - Quadro.png

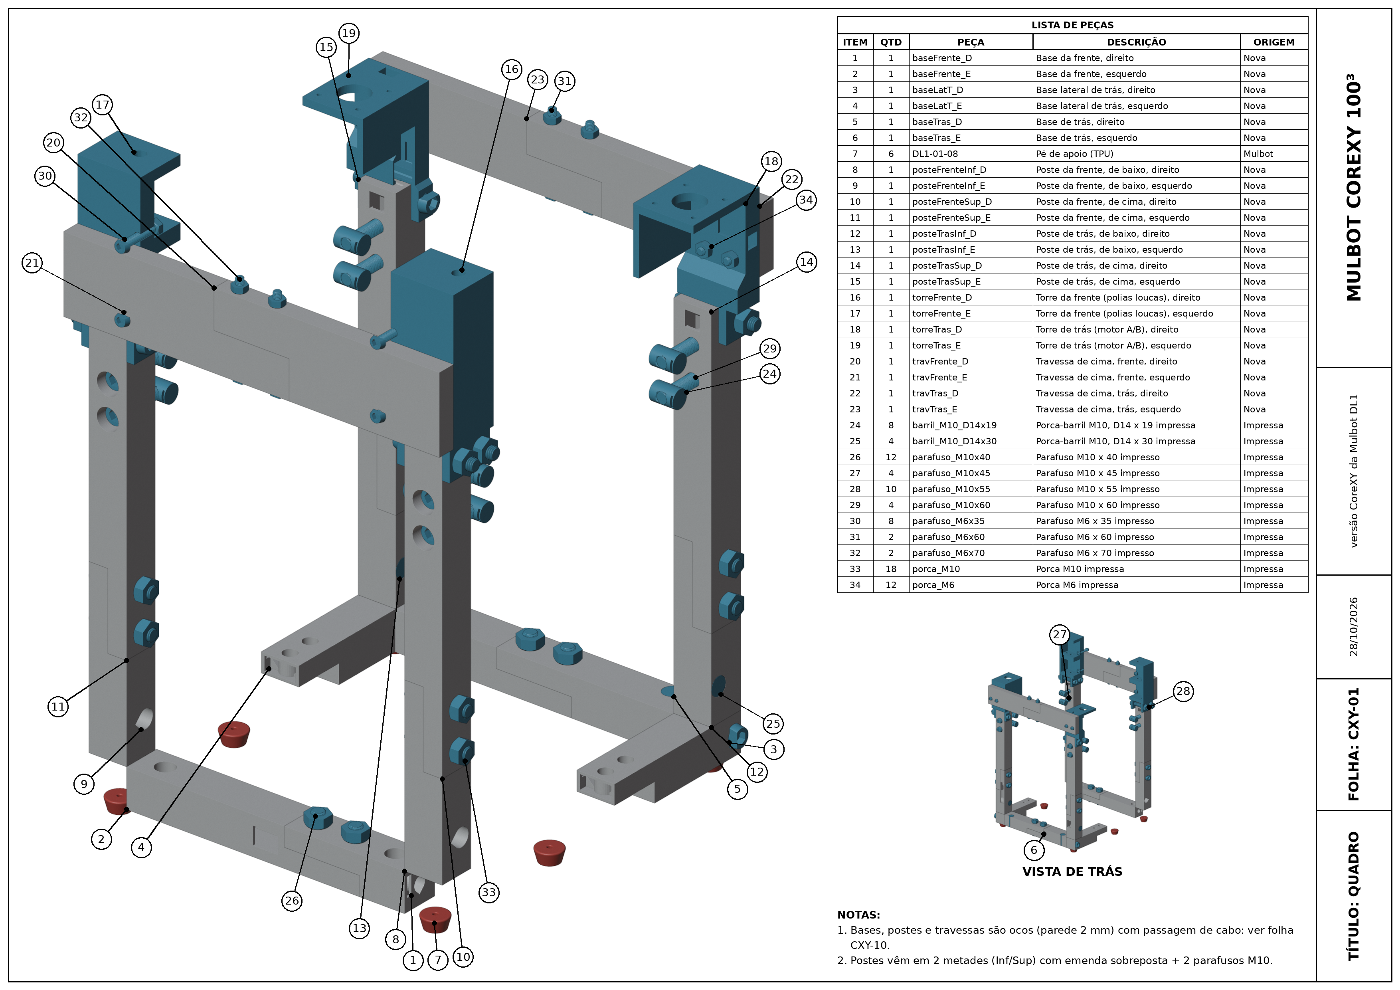
corexy100/entrega/03 Desenhos de montagem/CXY-01 - Quadro.png
