WHdragon770/mulbot-corexy/corexy100/entrega/03 Desenhos de montagem/CXY-02 - Eixo Y e portico.png

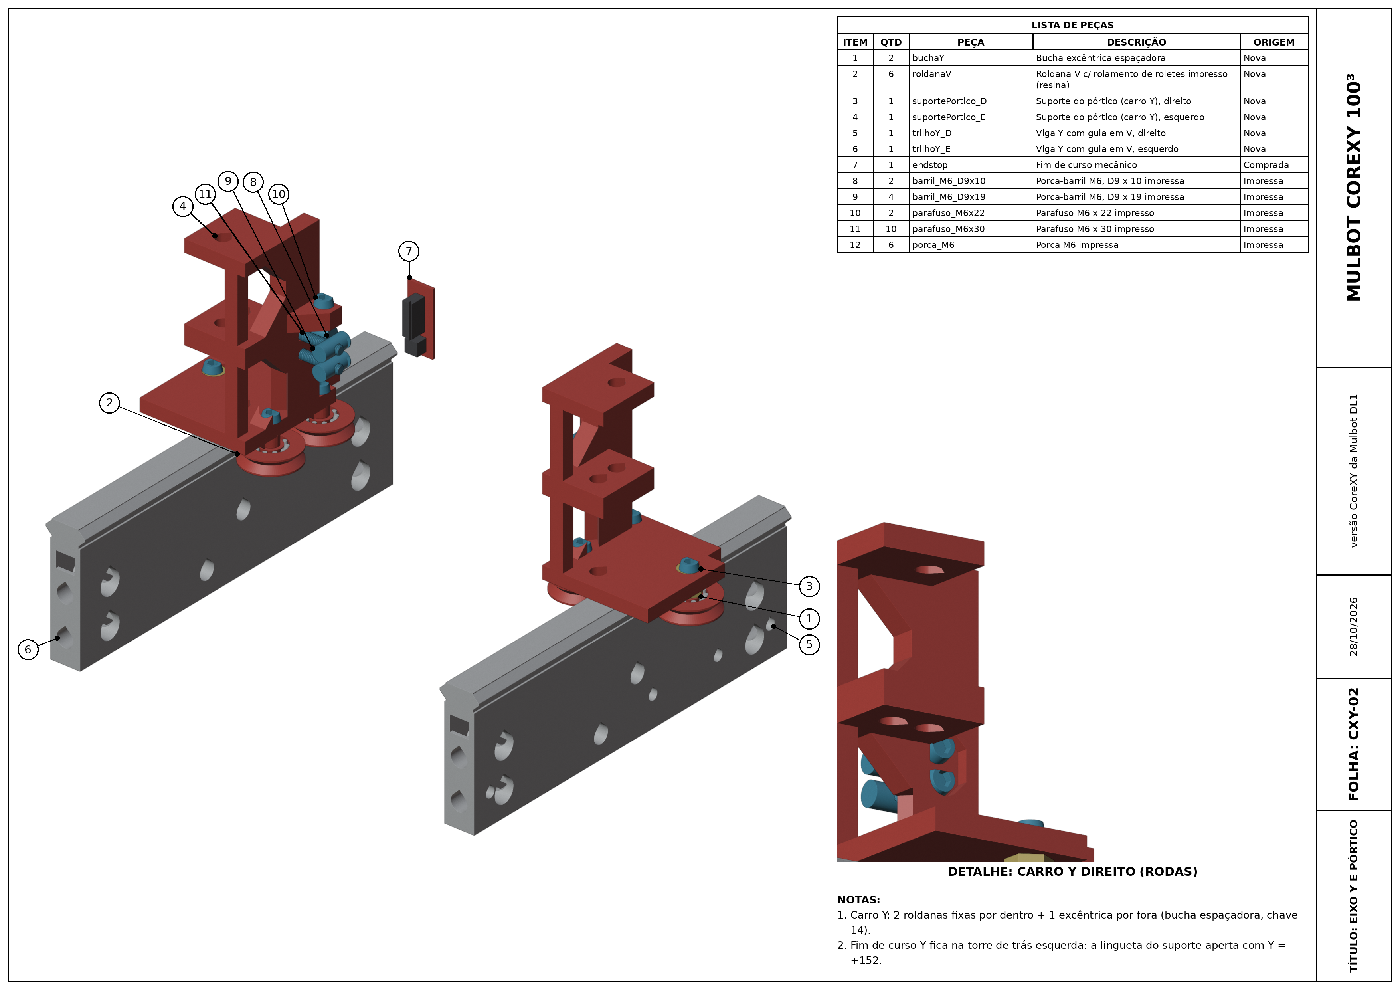
corexy100/entrega/03 Desenhos de montagem/CXY-02 - Eixo Y e portico.png
