WHdragon770/mulbot-corexy/corexy100/entrega/03 Desenhos de montagem/CXY-03 - Eixo X e cabeca.png

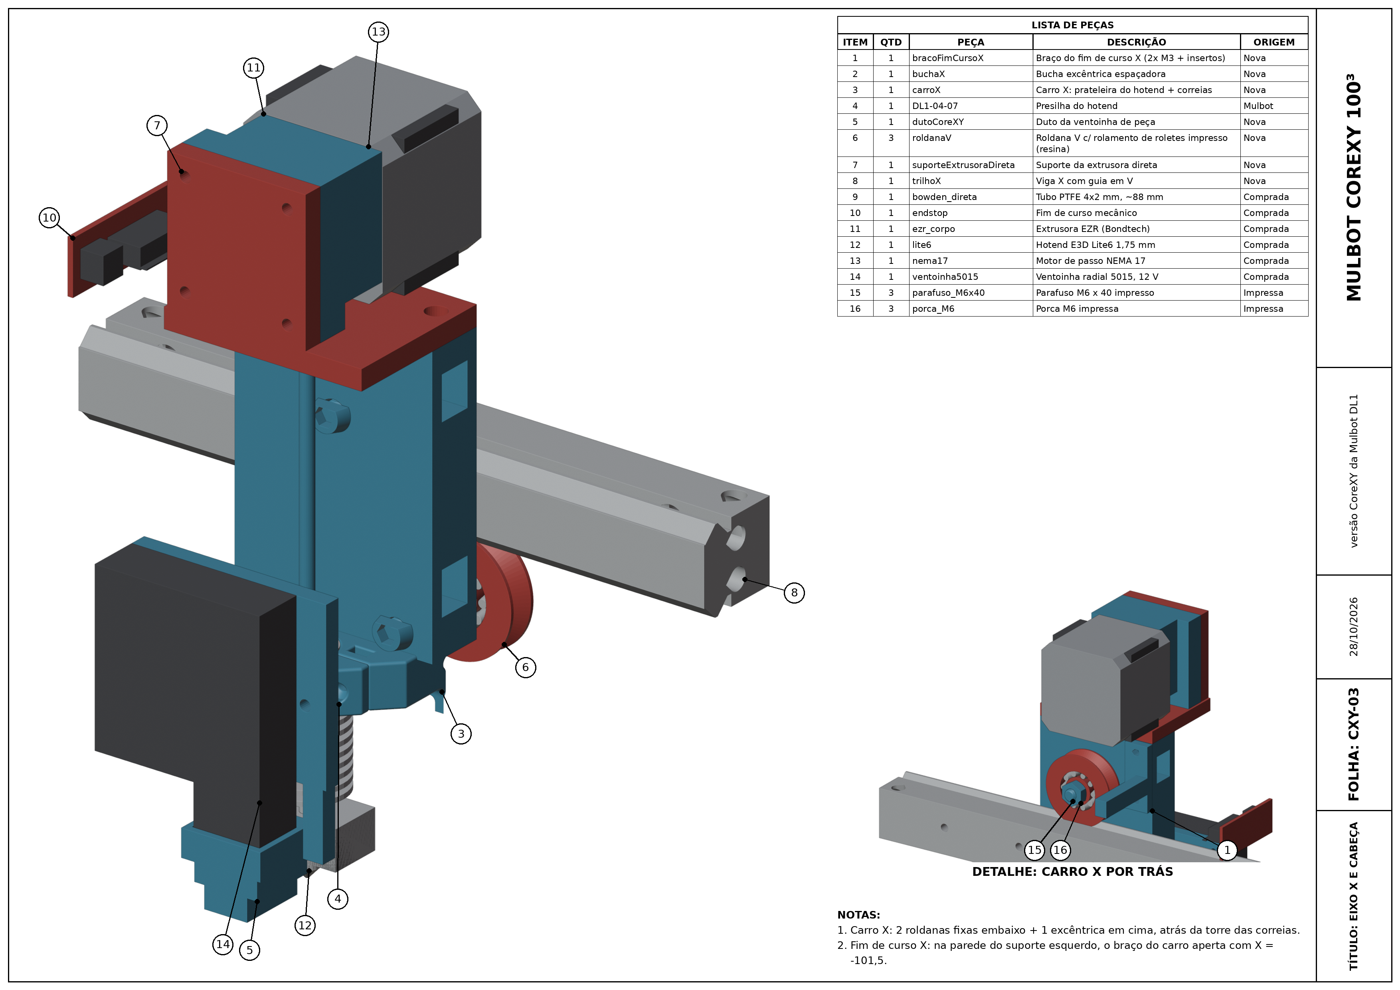
corexy100/entrega/03 Desenhos de montagem/CXY-03 - Eixo X e cabeca.png
