WHdragon770/mulbot-corexy/corexy100/entrega/03 Desenhos de montagem/CXY-04 - Eixo Z.png

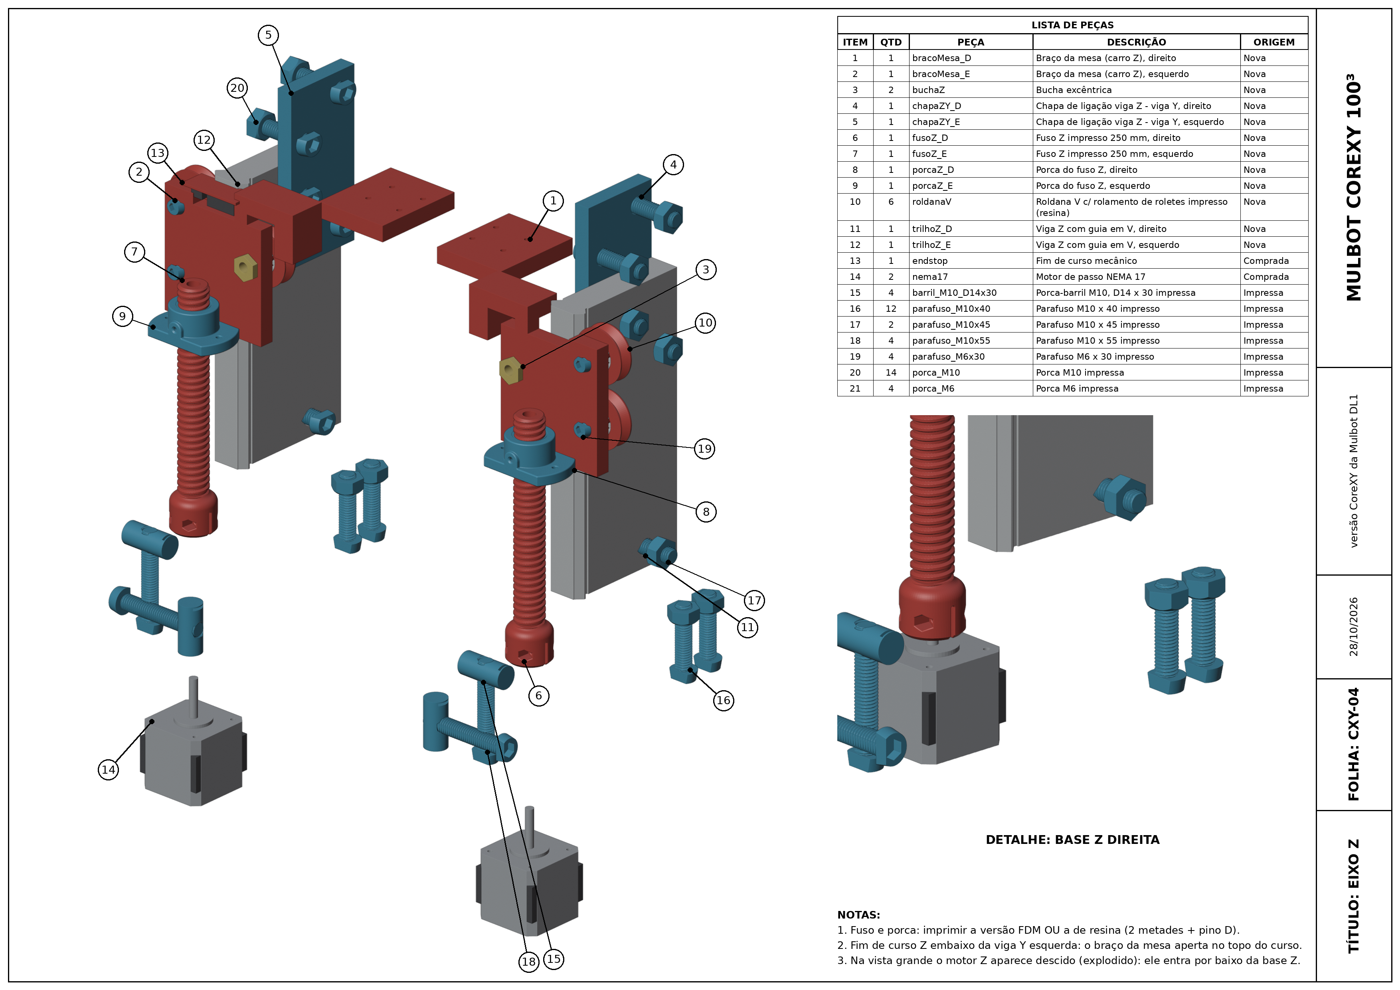
corexy100/entrega/03 Desenhos de montagem/CXY-04 - Eixo Z.png
