WHdragon770/mulbot-corexy/corexy100/entrega/03 Desenhos de montagem/CXY-05 - Mesa.png

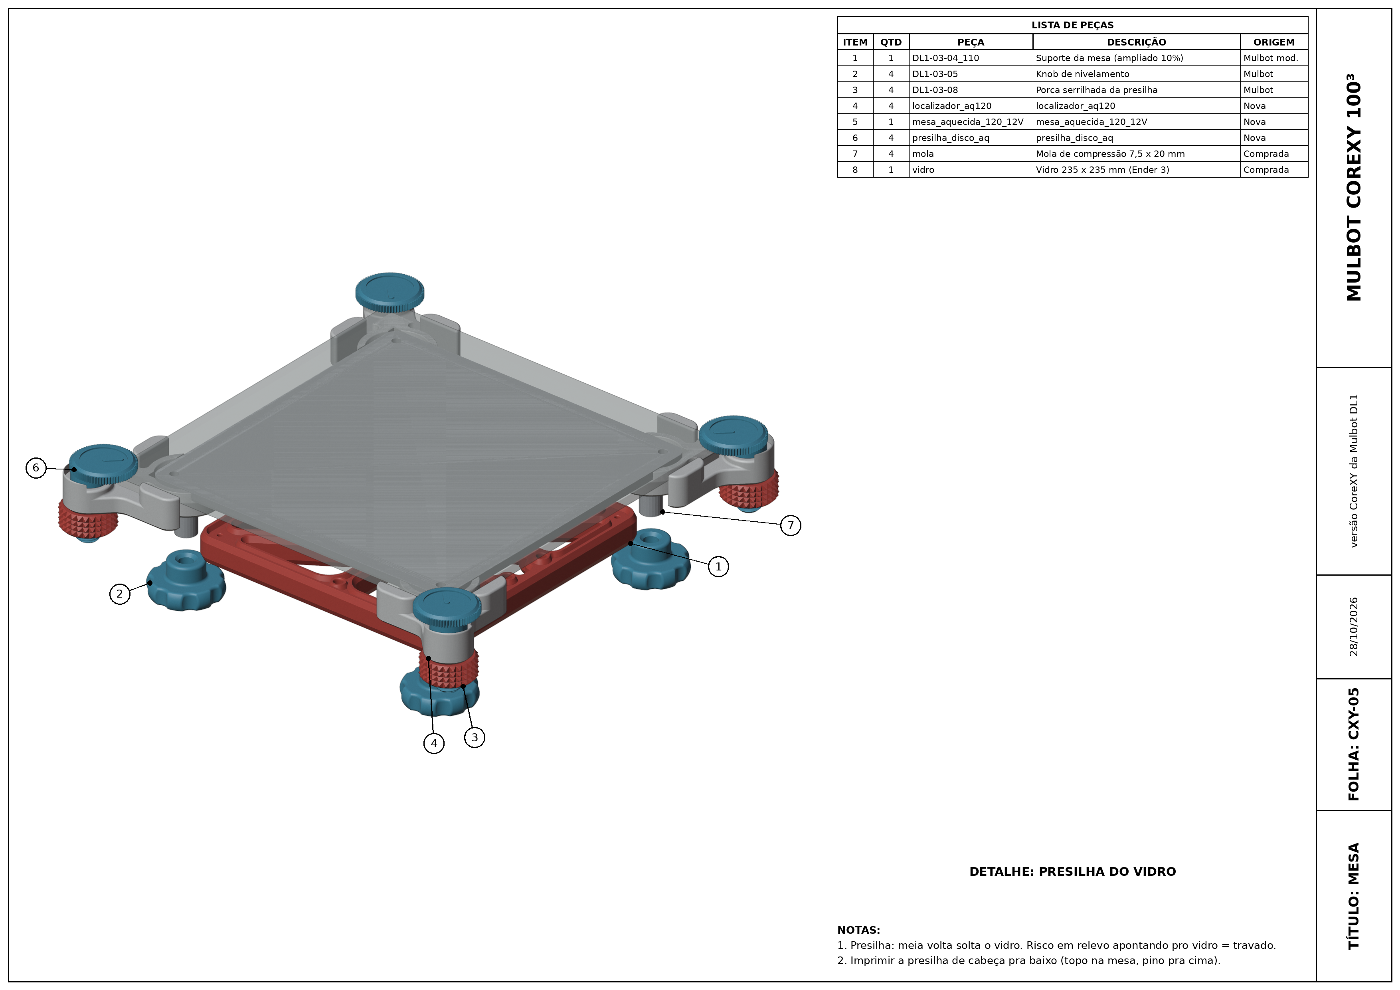
corexy100/entrega/03 Desenhos de montagem/CXY-05 - Mesa.png
