WHdragon770/mulbot-corexy/corexy100/entrega/03 Desenhos de montagem/CXY-06 - CoreXY - correias e polias.png

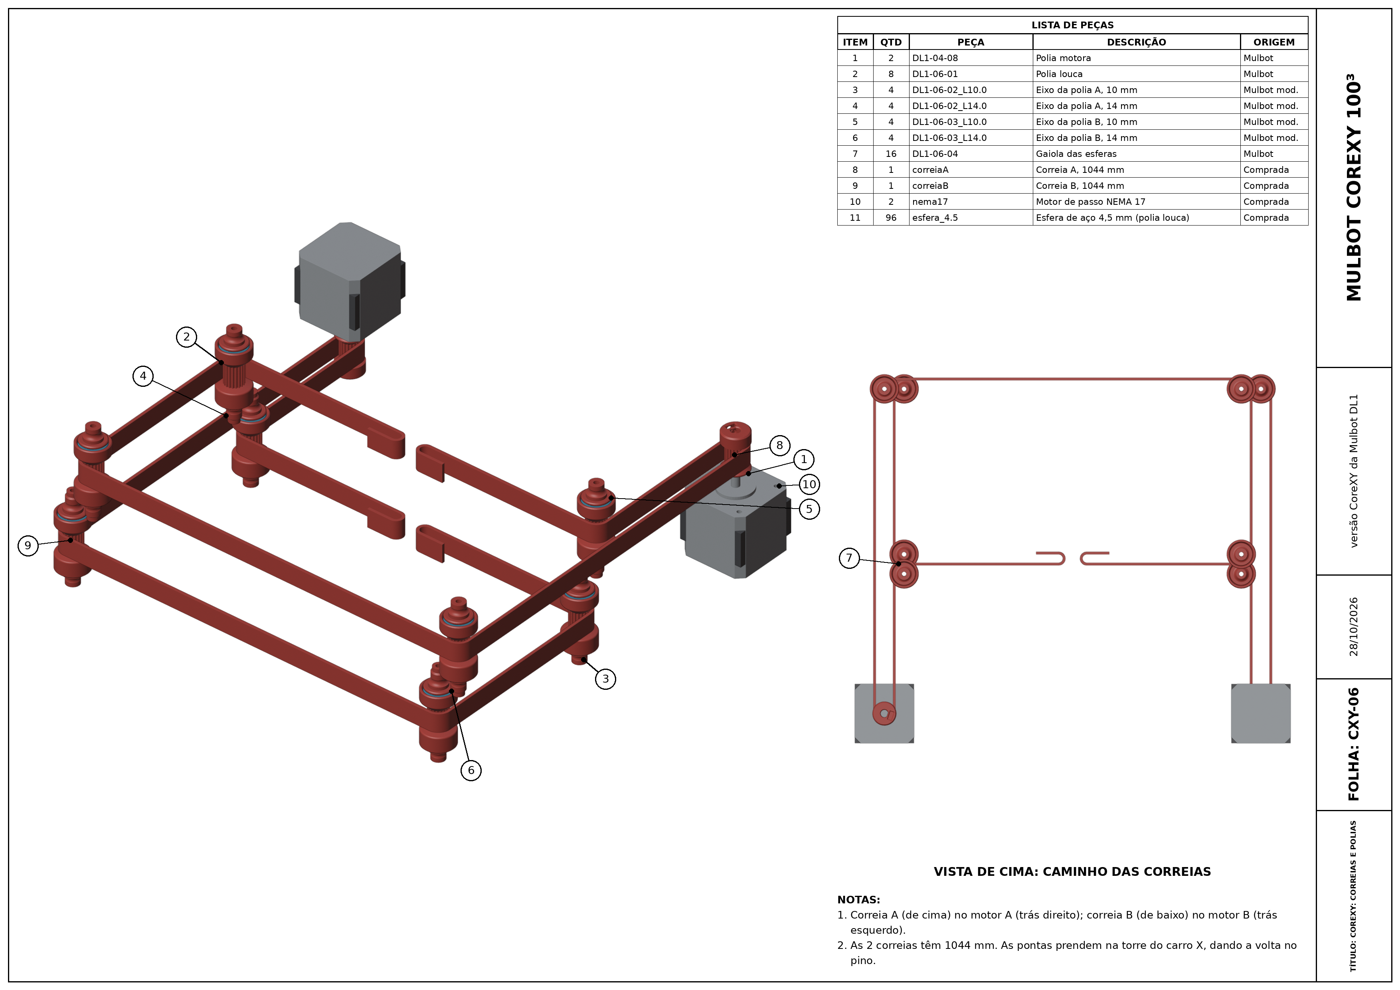
corexy100/entrega/03 Desenhos de montagem/CXY-06 - CoreXY - correias e polias.png
