WHdragon770/mulbot-corexy/corexy100/entrega/03 Desenhos de montagem/CXY-07 - Eletronica e display.png

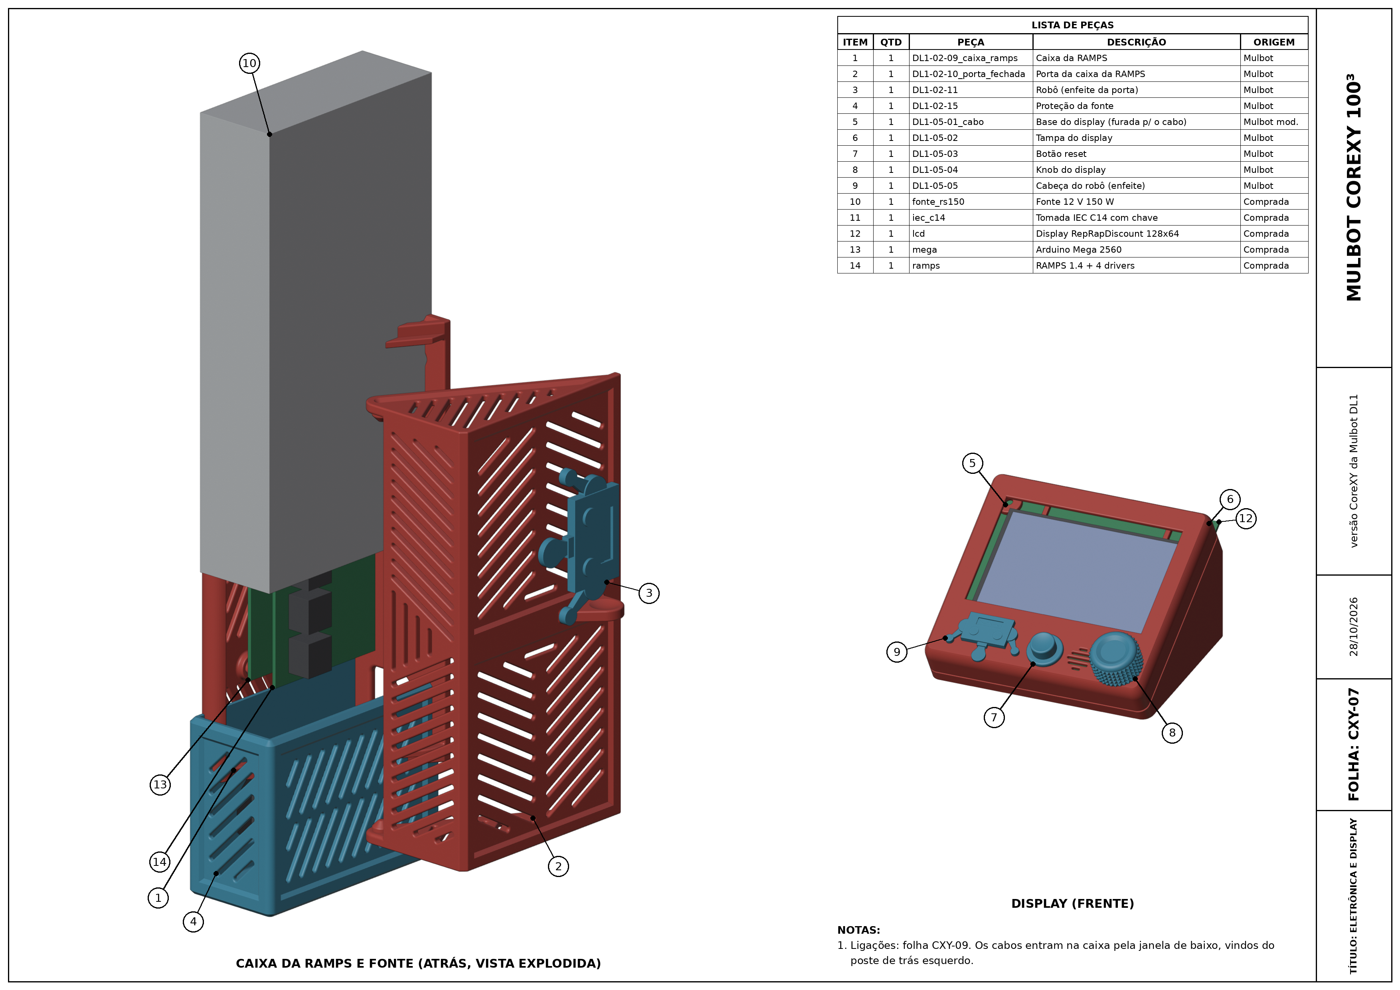
corexy100/entrega/03 Desenhos de montagem/CXY-07 - Eletronica e display.png
