WHdragon770/mulbot-corexy/corexy100/entrega/03 Desenhos de montagem/CXY-08 - Roldana V.png

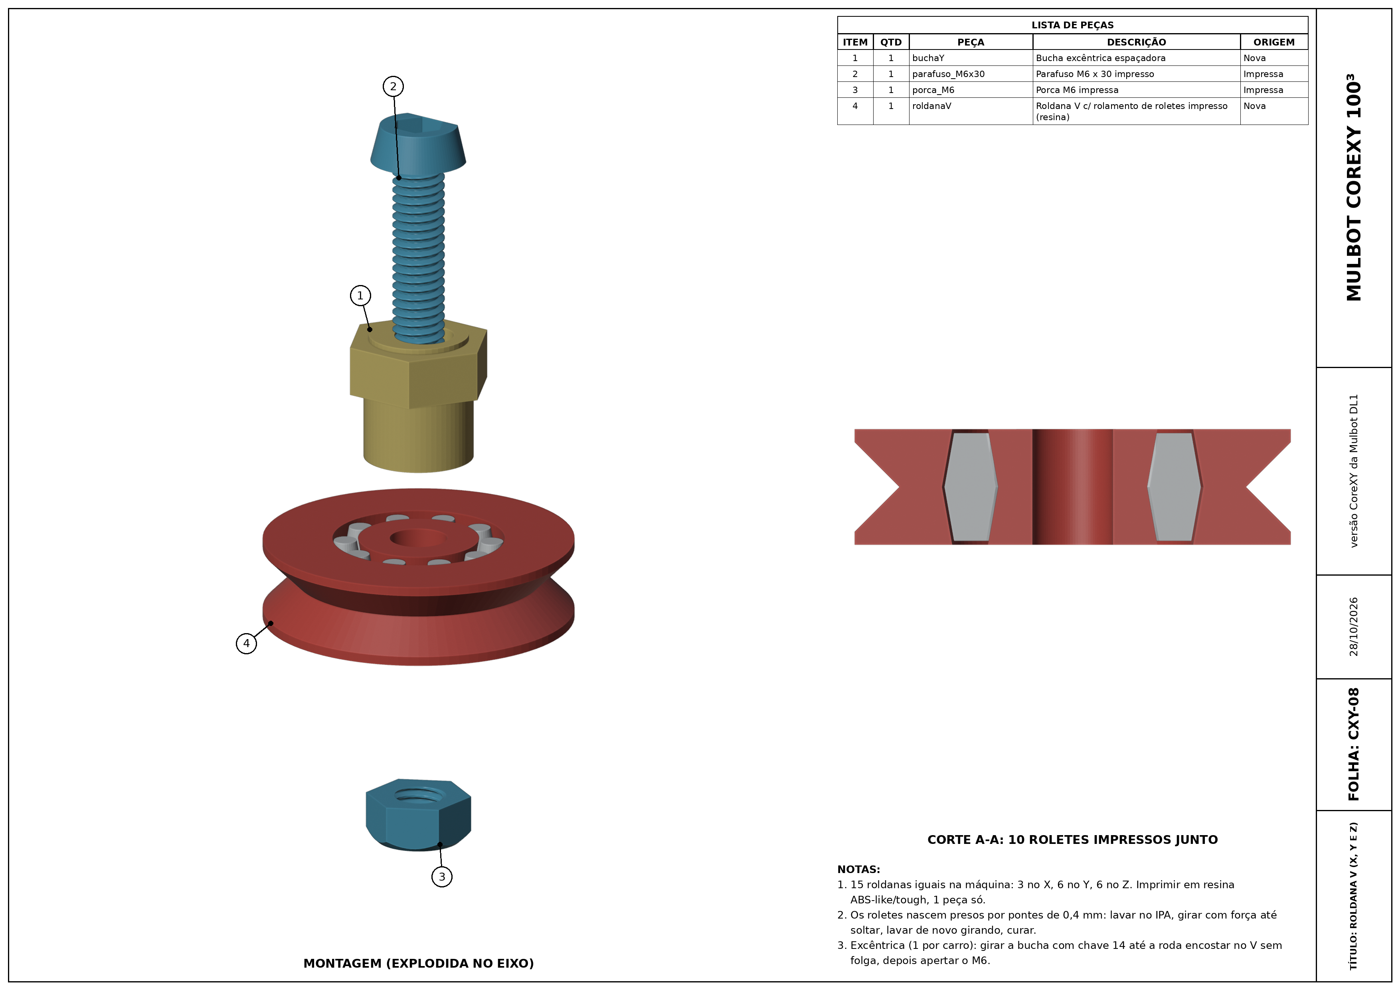
corexy100/entrega/03 Desenhos de montagem/CXY-08 - Roldana V.png
