WHdragon770/mulbot-corexy/corexy100/entrega/03 Desenhos de montagem/CXY-09 - Diagrama de ligacao.png

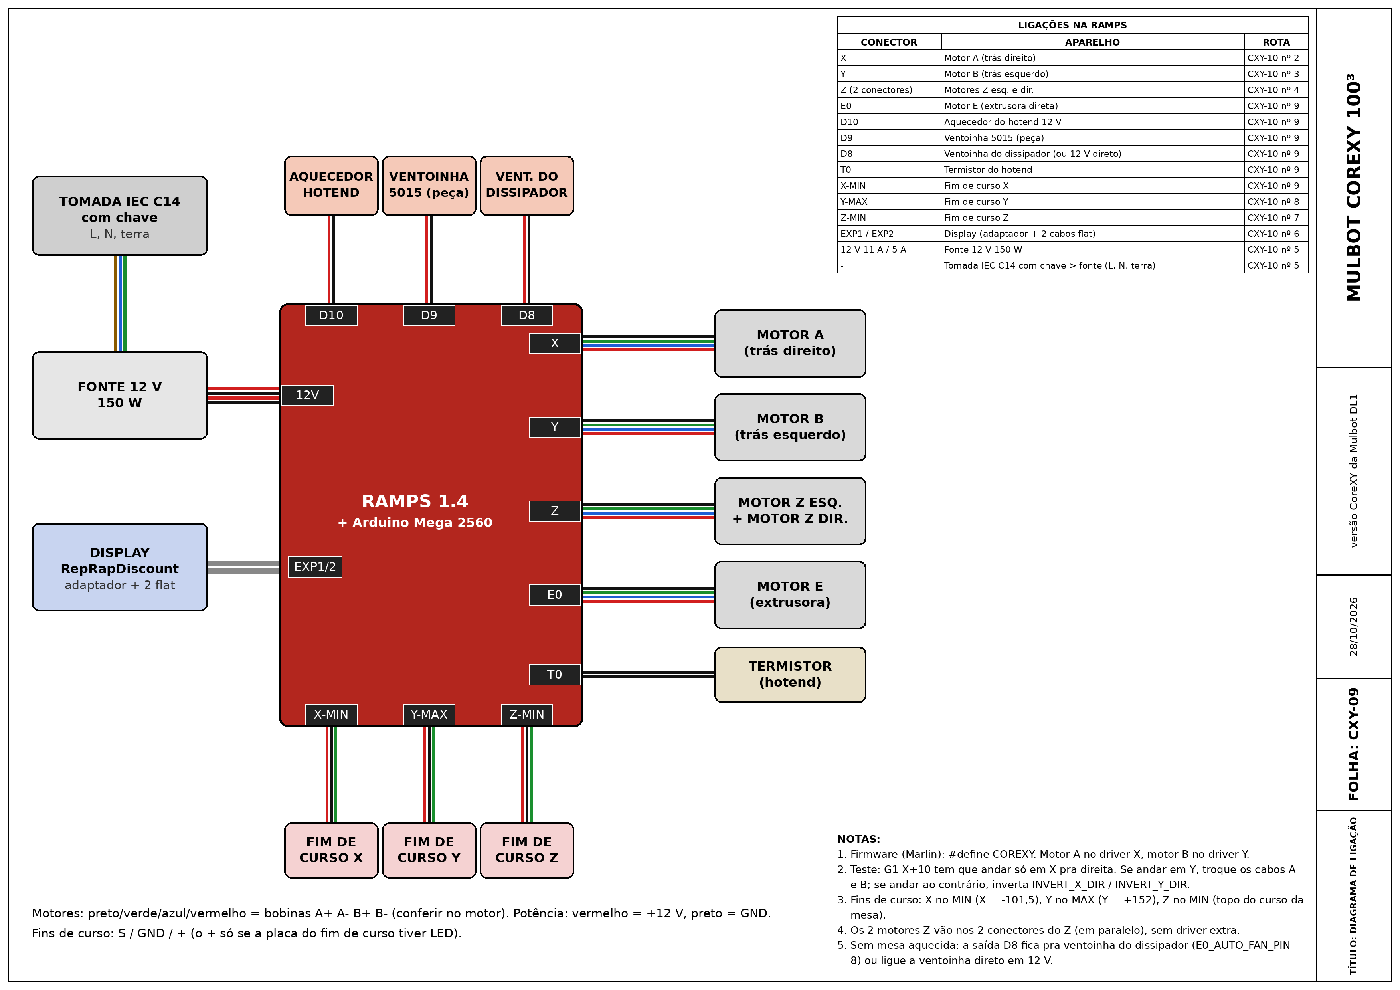
corexy100/entrega/03 Desenhos de montagem/CXY-09 - Diagrama de ligacao.png
