WHdragon770/mulbot-corexy/corexy100/entrega/03 Desenhos de montagem/CXY-10 - Passagem de cabos.png

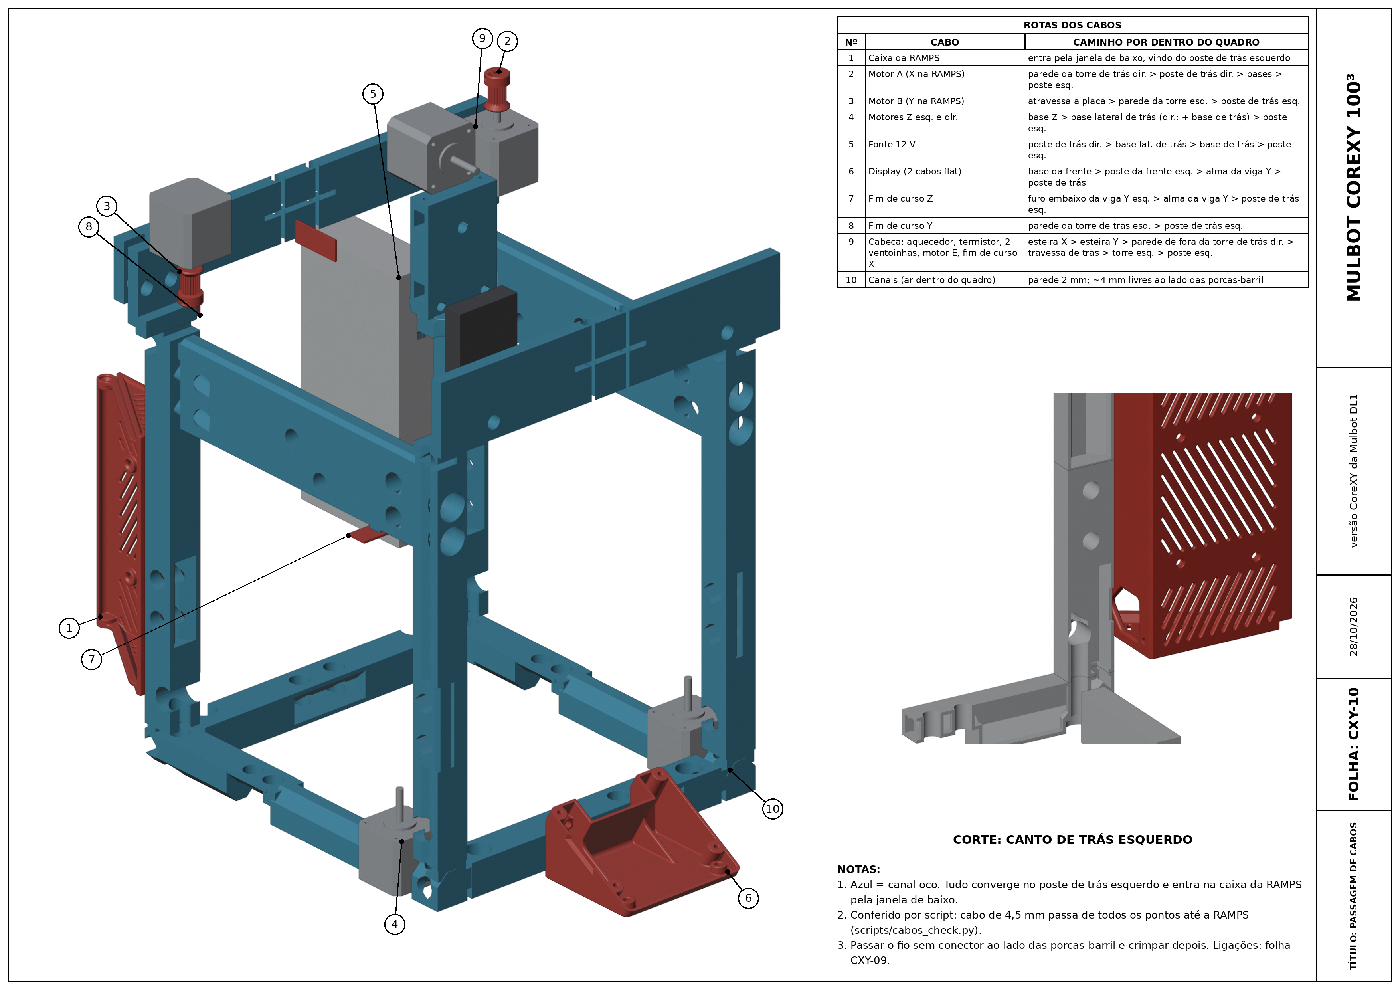
corexy100/entrega/03 Desenhos de montagem/CXY-10 - Passagem de cabos.png
