WHdragon770/mulbot-corexy/corexy100/entrega/03 Desenhos de montagem/CXY-11 - Esteira porta-cabos.png

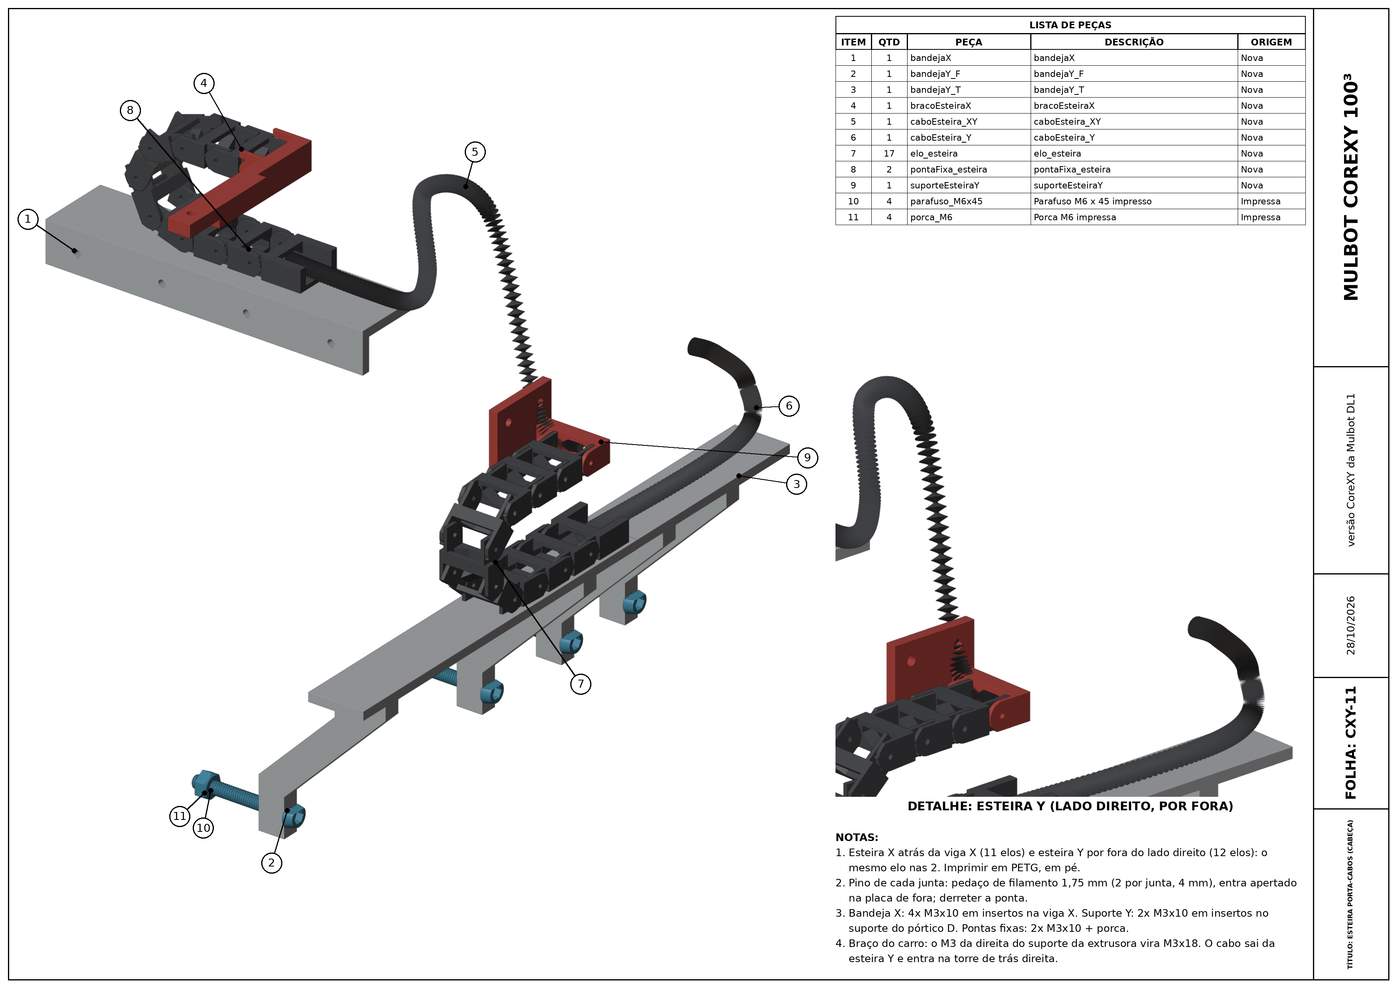
corexy100/entrega/03 Desenhos de montagem/CXY-11 - Esteira porta-cabos.png
