WHdragon770/mulbot-corexy/corexy100/trab/prog_fix5.txt

FIM fix5: 9/9 sem ilha, pares com interferencia: 0 | poses: 22 | solidos montados: 98 de 406
