WHdragon770/mulbot-corexy/(commit log)

2026-10-20 Mulbot CoreXY 200³: montagem, STL, desenhos e tudo para renderizar o vídeo
    - final/corexy_montagem_leve.blend + out/ (poses da máquina funcionando, peso por quadro)
    - scripts/video: roteiro, som, legendas, estimativa e render_noite.sh (caminhos relativos, GPU opcional)
    - RENDER_INSTRUCOES.txt: passo a passo para renderizar igual ao planejado
    - entrega/: STL por conjunto, 11 folhas de desenho, renders e prévia do vídeo
    [DL1-01-08 [6x].stl, DL1-02-09_caixa_ramps [1x].stl, DL1-02-10_porta_fechada [1x].stl, DL1-02-11 [1x].stl, DL1-02-15 [1x].stl, DL1-03-04_110 [1x].stl, DL1-03-05 [4x].stl, DL1-03-06 [4x].stl]
2026-10-20 Render bonito: fundo cinza sem chão, materiais reais, cena de passagem de cabos e explodida das roldanas/polias
    - visual.py: luz de estúdio, plástico com linhas de camada e bevel, metais, vidro, PCB e LCD
    - cena nova de 8 s com o quadro translúcido e 9 cabos puxados até a RAMPS (out/anim/cabos)
    - explodida: close no pórtico com roletes saindo da roldana V e polia louca abrindo
    - vídeo passa a 2562 quadros; custo.json e instruções atualizados com os tempos medidos
    [cabeca.stl, display.stl, fimCursoY.stl, fimCursoZ.stl, fonte.stl, motorA.stl, motorB.stl, motorZ_D.stl]
2026-10-21 Versão sem suporte + esteira porta-cabos no X e no Y; instruções do vídeo com o que refazer
    [DL1-05-01_cabo [1x].stl, bandejaX [1x].stl, bandejaY_F [1x].stl, bandejaY_T [1x].stl, barril_M6_D9x16 [8x].stl, baseFrente_D [1x].stl, baseFrente_E [1x].stl, baseLatF_D [1x].stl]
2026-10-21 Vídeo de montagem renderizado (versão de 20/10) junto dos renders
2026-10-21 Mesa aquecida opcional: 220x220 12 V e 235x235 24 V
    MESA=220 ou MESA=235 no cxy.py. Placa de aluminio entre o localizador e o vidro (vidro no mesmo lugar,
    mesa desce 3 mm), localizador com bordas mais altas (calco em L na 220), presilha com pescoco maior,
    calco no fim de curso Z, fonte de 360 W com protecao nova sem suporte e modulo MOSFET.
    Entrega em entrega/07 Mesa aquecida (opcional).
    [calcoFimCursoZ [1x].stl, localizador_aq220 [4x].stl, localizador_aq235 [4x].stl, presilha_disco_aq [4x].stl, protecaoFonte360 [1x].stl]
2026-10-27 Script que corta os STL da 200 pra imprimir numa area 100x100x100 (pinos nas faces de corte, pino em D no fuso)
2026-10-27 Cortar na 100: luva de emenda e encaixe macho nos cortes de parede fina
2026-10-27 STL da 200 cortados pra imprimir na CoreXY 100 (partes <= 95 mm, pinos, luvas, LEIA-ME)
    [DL1-01-08 [6x].stl, DL1-02-09_caixa_ramps luva 1 [1x].stl, DL1-02-09_caixa_ramps luva 2 [1x].stl, DL1-02-09_caixa_ramps luva 3 [1x].stl, DL1-02-09_caixa_ramps luva 4 [1x].stl, DL1-02-09_caixa_ramps parte 1de6 [1x].stl, DL1-02-09_caixa_ramps parte 2de6 [1x].stl, DL1-02-09_caixa_ramps parte 3de6 [1x].stl]
2026-10-27 CoreXY 100 (area 100x100x100): scripts, STL, imagens, blend leve e poses pro video
    [DL1-01-08 [6x].stl, DL1-02-09_caixa_ramps [1x].stl, DL1-02-10_porta_fechada [1x].stl, DL1-02-11 [1x].stl, DL1-02-15 [1x].stl, DL1-03-04_110 [1x].stl, DL1-03-05 [4x].stl, DL1-03-08 [4x].stl]
2026-10-27 CoreXY 100: video extra (Benchy 8x, peca da 200 na 100, 100 x 200) pronto pra renderizar em outro PC
    [3DBenchy.stl, peca200_baseFrente_D_parte1.stl]
2026-10-27 Colab: apt update + libs EGL, checagem da GPU no Blender, aviso de manter a aba aberta (testado em clone limpo)
2026-10-28 poses da esteira: poses/cabos/custo da 200 refeitos, esteira na etapa da eletronica, cameras gerais K=1.3
    [cabeca.stl, caboEsteira_XY_000.stl, caboEsteira_XY_001.stl, caboEsteira_XY_002.stl, caboEsteira_XY_003.stl, caboEsteira_XY_004.stl, caboEsteira_XY_005.stl, caboEsteira_XY_006.stl]
2026-10-28 Pranchas de conferencia da 200, desenhos de emenda (200 na 100), desenhos de montagem da 100 (correia 1044 mm)
2026-10-28 PDF completo da 200 na 100: capa com quantidades, montagem original, lista de impressao e emendas
2026-10-28 CoreXY 100: fotos de detalhe (24), script das placas e do manual completo; placas.py acha o 3MF base da Kobra X em Documentos
2026-10-28 CoreXY 100: placas de impressao (3MF Kobra X, resina, previas); orienta em lotes de 10 pecas
    [01 Quadro - DL1-01-08 - TPU.3mf, 01 Quadro - PLA.3mf, 02 Eixo Y e portico - PLA.3mf, 03 Eixo X e cabeca - PLA.3mf, 04 Eixo Z e mesa - PLA.3mf, 05 Motores e polias - DL1-04-08 - PETG.3mf, 05 Motores e polias - PLA.3mf, 06 Eletronica e display - PLA.3mf]
2026-10-28 CoreXY 100: 5 pecas sem parte no ar (janela da fonte em 5, junta da base Z +15, apoio do braco da mesa) + 02 STL e placas refeitos
    [01 Quadro - DL1-01-08 - TPU.3mf, 01 Quadro - PLA.3mf, 02 Eixo Y e portico - PLA.3mf, 03 Eixo X e cabeca - PLA.3mf, 04 Eixo Z e mesa - PLA.3mf, 05 Motores e polias - DL1-04-08 - PETG.3mf, 05 Motores e polias - PLA.3mf, 06 Eletronica e display - PLA.3mf]
2026-10-29 render_noite: so pula bloco com todos os quadros prontos (buracos de queda ficavam sem render)
2026-10-29 render_noite da 100: volta pasta/nome 100 (commit anterior copiou o da 200)
2026-10-29 CoreXY 200: video de montagem renderizado no Cycles
2026-10-29 Ficha tecnica 100 e 200: vistas ortograficas cotadas (externo + volume de impressao), comparativo na mesma escala
2026-10-30 Fontes restantes da 200 e da 100 (guia_v, ref, trab, scripts novos) antes de limpar o WSL
    [corte_bucha.stl, corte_espacador.stl, corte_parafuso.stl, corte_placa.stl, corte_porca.stl, corte_poste.stl, corte_rolamento.stl, corte_roldana.stl]
